BoujeeEnjinia1701/helpful-water/docs/03a-user-requirements.md

---
doc_id: HWP-URS-001
title: Helpful Water shared user requirements
project: Helpful Water
doc_type: User requirements
version: '0.1'
status: Draft
date: '2026-11-11'
author: Amish Chadha
license: CC-BY-4.0
revisions:
- version: '0.1'
  date: '2026-11-11'
  author: Amish Chadha
  change: First draft from the Helpful Water source pack (2026-11-11)
---

# Helpful Water shared user requirements

What the people who use or buy Helpful Water products need, written from their side and shared by all four solutions. Each solution's own user requirements (`solutions/*/docs/03a-user-requirements.md`) repeat the rows that apply to it with the same IDs, so its product requirements and traceability matrix trace to this list. Sources: the personas, persona-driven design questions and use cases in the concept validation questions (2026), the Helpful Water update (2026-02-26) and the Rev A component specification (2026-10-14). Method: STANDARDS section 22.

Table 1. Shared user requirements.

| ID | Category | Title | Need | Priority | Source | Solutions |
| --- | --- | --- | --- | --- | --- | --- |
| UR-001 | Performance | Bacteria | Reduce the bacteria in water from the source classes the solution is designed for | High | All personas; NGO buyers | A B C |
| UR-002 | Performance | Protozoa | Reduce protozoan cysts, including *Cryptosporidium* and *Giardia* | High | All personas; NGO buyers | A B C |
| UR-003 | Performance | Viruses addressed | Have a way to address viruses where viral disease is a risk, without implying the filter alone does it | High | NGO buyers; immunocompromised user | D (with A B C) |
| UR-004 | Usability | Usable flow | Get enough water at the suction, squeeze or effort a child or elderly user can give | High | Child; elderly user | A B C |
| UR-005 | Usability | Ready to use | Use it straight from the pack with no power, assembly or tools | High | Crisis recipient; field worker | A B C D |
| UR-006 | Usability | Simple instructions | Understand use, cleaning, limits and end of life from pictograms in three steps or fewer | High | Crisis recipient; low literacy users | A B C D |
| UR-007 | Maintenance | Low daily upkeep | Keep it working with under 2 minutes of upkeep a day and no tools | High | Crisis recipient; elderly user | A B C |
| UR-008 | Safety | Know when it fails | Know when the device is clogged, spent or damaged, so it never fails silently | High | All; field worker | A B C D |
| UR-009 | Safety | No bypass | Service it (clean, change a cartridge) without letting dirty water reach the clean side | High | Low dexterity user; field worker | A B C |
| UR-010 | Safety | Hygienic storage | Store it wet or dry in a hot climate without it growing germs | High | All | A B C |
| UR-011 | Safety | Safe materials | Nothing in it adds harmful substances to the water | High | All; NGO buyers | A B C D |
| UR-012 | Deployment and assembly | Portable | Carry it in a pocket or kit (under 25 cm long and 3 cm across for personal devices) | Medium | Traveller; field worker | A B |
| UR-013 | Performance | Household volume | Treat enough water for a household's drinking and cooking, including infant feeds | High | Household carer | C |
| UR-014 | Cost | Affordable | Cost per person per year, and per litre over the device life, that NGO buyers can justify against tablets and sealed filters | High | NGO buyers | A B C D |
| UR-015 | Logistics | Resupply | Get any consumable (carbon, chlorine) where the device is used, or have none | Medium | Field worker; NGO buyers | A B C D |
| UR-016 | Environment and durability | Shelf life and transit | Survive warehouse heat, transit and storage before first use | Medium | NGO buyers | A B C D |
| UR-017 | Environment and durability | Drops and freezing | Survive drops, and warn or resist where freezing can occur | Medium | Traveller; highland users | A B C |
| UR-018 | Usability | Taste | Accept the taste and smell, so people keep using it | Medium | Elderly user; tap-water users | A B C D |
| UR-019 | Maintenance | Cleanable prefilter | Rinse the coarse prefilter in the field | Medium | High-turbidity user | A B C |
| UR-020 | Safety | Shared use | Share the device in a household without passing infection mouth to mouth | Medium | Household carer | A B |
| UR-021 | Environment and durability | End of life | Dispose of spent parts without waste infrastructure | Low | NGO buyers; communities | A B C D |
| UR-022 | Deployment and assembly | Regional manufacture | Have parts made or assembled regionally | Low | NGO buyers; Helpful Engineering | A B C D |

Categories: deployment and assembly, performance, usability, safety, environment and durability, logistics, maintenance, cost, regulatory. Priorities: High, Medium, Low.

## Use cases

1. **Disaster or flood (short term).** Mesh reduces grit, the membrane reduces bacteria and protozoa, and backflush keeps it usable; viruses and dissolved chemicals from runoff are not addressed (SC6 excluded as a sole barrier).
2. **Rural household with an unimproved source.** Consistent bacteria and protozoa reduction without power; not the right product where arsenic, fluoride or salt is the main risk.
3. **Camp or displacement setting.** Water from distribution points is recontaminated in storage; point-of-use treatment reduces risk at the time of drinking.
4. **Distrusted or unpalatable treated water.** Carbon improves taste; the membrane adds a layer against recontamination.
5. **Field teams.** A portable backup when supplies are inconsistent.

Licence: this document is licensed under CC-BY-4.0 (Creative Commons Attribution 4.0 International), following the Helpful Engineering licensing guide. Design Molecule Labs with Helpful Engineering.
