BoujeeEnjinia1701/helpful-water/solutions/C-gravity/docs/03a-user-requirements.md

---
doc_id: HWC-URS-001
title: "Helpful Water C: household gravity filter user requirements"
project: "Helpful Water C: household gravity filter"
doc_type: User requirements
version: "0.1"
status: Draft
date: 2026-11-11
author: Amish Chadha
license: CC-BY-4.0
revisions:
  - version: "0.1"
    date: 2026-11-11
    author: Amish Chadha
    change: "First user requirements: the HWP-URS-001 rows that apply to solution C, same IDs, plus solution-specific UR-101 to UR-104"
---

# Helpful Water C: household gravity filter user requirements

What households need from solution C, written from their side. Rows UR-001 to UR-022 repeat the shared requirements of HWP-URS-001 that apply to C, with the same IDs and priorities; UR-012 (pocket size) and UR-020 (shared mouthpiece) do not apply to a household unit and are left out. UR-101 to UR-104 are specific to C and come from the users and stakeholders in HWC-PRB-001. These are a desk draft for review with households through a field partner (method: STANDARDS section 22).

Table 1. User requirements for solution C.

| ID | Category | Title | Need | Priority | Source |
| --- | --- | --- | --- | --- | --- |
| UR-001 | Performance | Bacteria | Reduce the bacteria in water from the source classes C is designed for (SC1, SC2, SC3 with settling, SC5) | High | All personas; NGO buyers (HWP-URS-001) |
| UR-002 | Performance | Protozoa | Reduce protozoan cysts, including *Cryptosporidium* and *Giardia* | High | All personas; NGO buyers (HWP-URS-001) |
| UR-003 | Performance | Viruses addressed | Have a way to address viruses where viral disease is a risk (chlorine from solution D in the raw bucket), without implying the filter alone does it | High | NGO buyers; immunocompromised user (HWP-URS-001) |
| UR-004 | Usability | Usable flow | Get the day's water without effort the child or elderly user cannot give: gravity does the work and drawing a cup is opening a tap | High | Child; elderly user (HWP-URS-001) |
| UR-005 | Usability | Ready to use | Use it with no power, no ripening period and no tools once the stand is set up | High | Crisis recipient; field worker (HWP-URS-001) |
| UR-006 | Usability | Simple instructions | Understand use, cleaning, limits and end of life from pictograms in three steps or fewer per task | High | Crisis recipient; low-literacy users (HWP-URS-001) |
| UR-007 | Maintenance | Low daily upkeep | Keep it working with under 2 minutes of upkeep a day and no tools | High | Crisis recipient; elderly user (HWP-URS-001) |
| UR-008 | Safety | Know when it fails | Know when the filter is clogged, spent or damaged, so it never fails silently | High | All; field worker (HWP-URS-001) |
| UR-009 | Safety | No bypass | Service it (backflush, clean the cloth, wash buckets) without letting dirty water reach the clean side | High | Low-dexterity user; field worker (HWP-URS-001) |
| UR-010 | Safety | Hygienic storage | Store the filter and the treated water in a hot climate without them growing germs | High | All (HWP-URS-001) |
| UR-011 | Safety | Safe materials | Nothing in it adds harmful substances to the water | High | All; NGO buyers (HWP-URS-001) |
| UR-013 | Performance | Household volume | Treat enough water for a household of five's drinking and cooking (45 L a day) in a few hours of filtering | High | Household carer (HWP-URS-001) |
| UR-014 | Cost | Affordable | Cost per person per year, and per litre over the device life, that NGO buyers can justify against tablets and sealed filters | High | NGO buyers (HWP-URS-001) |
| UR-015 | Logistics | Resupply | Get any consumable where the device is used, or have none | Medium | Field worker; NGO buyers (HWP-URS-001) |
| UR-016 | Environment and durability | Shelf life and transit | Survive warehouse heat, transit and storage before first use | Medium | NGO buyers (HWP-URS-001) |
| UR-017 | Environment and durability | Drops and freezing | Survive knocks, and warn or resist where freezing can occur | Medium | Highland users (HWP-URS-001) |
| UR-018 | Usability | Taste | Accept the taste and smell, so people keep using it | Medium | Elderly user; tap-water users (HWP-URS-001) |
| UR-019 | Maintenance | Cleanable prefilter | Rinse the coarse prefilter in the field | Medium | High-turbidity user (HWP-URS-001) |
| UR-021 | Environment and durability | End of life | Dispose of spent parts without waste infrastructure | Low | NGO buyers; communities (HWP-URS-001) |
| UR-022 | Deployment and assembly | Regional manufacture | Have parts made or assembled regionally | Low | NGO buyers; Helpful Engineering (HWP-URS-001) |
| UR-101 | Safety | Safe storage | Keep the treated water in a closed container with a tap, so hands and cups never go into it | High | Household carer; camp settings (HWC-PRB-001; HWP-SRC-001 SC5) |
| UR-102 | Performance | Turbid water | Use muddy river water (10 to 100 NTU) after a settling or prefilter step without the filter clogging in a day | Medium | High-turbidity user (HWC-PRB-001; HWP-SRC-001 SC3) |
| UR-103 | Usability | No lifting full containers | Fill and run the filter without lifting a full 20 L container | Medium | Household carer; elderly user (HWC-PRB-001) |
| UR-104 | Safety | Stable with children around | The filter does not tip over when full and pushed or pulled by a child | High | Household carer; child (HWC-PRB-001) |

Categories: deployment and assembly, performance, usability, safety, environment and durability, logistics, maintenance, cost, regulatory. Priorities: High, Medium, Low.

## Use cases for C

1. **Rural household, unimproved source (SC2, SC3).** Fill through the cloth, settle, filter into the clean bucket; dose with D first where viral disease is a risk.
2. **Camp or displacement (SC5).** Water from a distribution point is chlorinated again with D in the raw bucket, filtered and kept in the closed clean bucket with a residual.
3. **Clinic or school point (secondary).** One unit serves several households in batches; the closed clean bucket replaces a shared open pot.

Licence: this document is licensed under CC-BY-4.0 (Creative Commons Attribution 4.0 International), following the Helpful Engineering licensing guide. Design Molecule Labs with Helpful Engineering.
