BoujeeEnjinia1701/helpful-water/solutions/B-bottle-cartridge/docs/decisions/0001-concept-selection.md

---
doc_id: HWB-DDR-001
title: "Helpful Water B: concept selection"
project: "Helpful Water B: bottle cartridge"
doc_type: Decision record
version: "0.2"
status: Draft
date: 2026-11-11
author: Amish Chadha
license: CC-BY-4.0
revisions:
  - version: "0.1"
    date: 2026-11-11
    author: Amish Chadha
    change: "Concept selection argued; B1 and B2 within 10 %, both to Amish; Proposed, awaiting Amish"
  - version: "0.2"
    date: 2026-11-11
    author: Amish Chadha
    change: "Weak-child flow at the girls' grip boundary (160 mL/min) after the independent STEM review"
---

# Helpful Water B: concept selection

**Status: Decided by Amish on 2026-11-11 (recommendation adopted).** B1 (squeeze cartridge) scored 246 and B2 (gravity drip stand) 222 of 310 in HWB-OPT-001; B2 is 9.8 % below B1, inside the 10 % band of STANDARDS section 21, so both went to Amish. Amish chose B1 on 2026-11-11: it has the higher score and is already carried to the drawings, BOM and build plan; B2's stand is a possible later accessory. B3 (press cup, 209) is not carried.

## Context

The brief for solution B asked for at least two genuinely different working principles: squeeze through a hollow-fibre cartridge, gravity drip from an inverted bottle, and a third principle the STEM check supports. All three passed the STEM check after four detail fixes (HWB-DEC-001 F1 to F4).

## Options

1. **B1 alone.** Cheapest (USD 18.35 of prototype parts), pocketable, one-squeeze air test; squeeze effort for children and elderly users is the weak point (160 mL/min at a weak child's 5.8 kPa, clean; half that fouled).
2. **B2 alone.** No effort, fills cups for a household, longest carbon contact; slower (about 6 minutes a litre), a tall stand to knock over, more parts, not portable.
3. **B1 with B2's stand as an accessory.** The same cartridge serves both: squeezed when carried, hung in a stand at home. The stand adds cost (estimate USD 8 to 10 of parts) and, with the standard module, gives about 10 minutes per litre clean.

## Consequences

The TRL 3 drawings, BOM and build plan describe B1, since B2's cartridge is the same stack turned over. If Amish picks B2, its longer module, vent tube, stand drawings, BOM lines and build steps are the next work; its model already exists at D3.

## Decision

B1, decided by Amish on 2026-11-11 (HWB-DEC-001 D1).

Licence: this document is licensed under CC-BY-4.0 (Creative Commons Attribution 4.0 International), following the Helpful Engineering licensing guide. Design Molecule Labs with Helpful Engineering.
