BoujeeEnjinia1701/helpful-water/docs/11-plan.md

---
doc_id: HWP-PLN-001
title: Helpful Water program plan
project: Helpful Water
doc_type: Project plan
version: '0.1'
status: Draft
date: '2026-11-11'
author: Amish Chadha
license: CC-BY-4.0
revisions:
- version: '0.1'
  date: '2026-11-11'
  author: Amish Chadha
  change: First draft from the Helpful Water source pack (2026-11-11)
---

# Helpful Water program plan

Purpose: deliver clean, reliable and simple access to water for people without safe drinking water (Helpful Water update, 2026-02-26), through four open point-of-use solutions taken to a constructable design on paper (TRL 3, stage P3, the portfolio cap). The next gate, P4 (functional prototypes and accredited laboratory testing), stays closed until Amish opens it with Helpful Engineering. Amish settled the concept choice and every open decision in each solution's register on 2026-11-11.

## Workstreams

Table 1. Workstreams.

| Workstream | Owner (role) | Deliverable | Status |
| --- | --- | --- | --- |
| Program problem, sources, personas, claims | Program lead | HWP-PRB-001, HWP-SRC-001, HWP-URS-001, HWP-CLM-001 | Drafted |
| Regulatory, market, patents | Regulatory specialist; program lead | HWP-REG-001, HWP-MKT-001, HWP-FTO-001 | Drafted; legal opinion to assess |
| Solution A straw | Mechanical and membrane engineers | `solutions/A-straw` to TRL 3 | In progress |
| Solution B bottle cartridge | Mechanical and membrane engineers | `solutions/B-bottle-cartridge` to TRL 3 | In progress |
| Solution C household gravity | Mechanical and WASH engineers | `solutions/C-gravity` to TRL 3 | In progress |
| Solution D virus add-on | Water chemist | `solutions/D-virus-add-on` to TRL 3 | In progress |
| Verification planning | Microbiologist and test lab | HWP-VER-001 | Planned (TRL 4 work on paper only) |
| Partners and co-design | Amish with Helpful Engineering | Field partner, laboratory partner | Not started |

## Kill criteria

From the Helpful Water update (2026-02-26), applied to each solution: stop or pause if consistent bacteria and protozoa reduction cannot be shown under realistic conditions; if flow becomes unusable or is not recoverable by backflush; if seal or membrane integrity cannot be kept in field handling; if total cost or complexity is not viable at humanitarian scale; or if partners decline because of safety, liability or usability concerns.

## Targets and key performance indicators

Table 2. Service-level targets (proposed in the viability shortlist for the copper straw and the bottle cartridge, carried here as program targets; adopted by Amish on 2026-11-11).

| Category | Target | Basis |
| --- | --- | --- |
| Functional prototype | 6 weeks from P4 opening | Viability shortlist |
| Bacteria and protozoa reduction | At least 99.9 % (3 log) as a first gate; the Rev A prototype goal is 6 log bacteria and 3 log cysts | Viability shortlist; Rev A specification section 7 |
| Flow | 300 to 500 mL/min under average suction (shortlist); at least 200 mL/min at 10 kPa or less (Rev A) | Two sources; reconciled per solution in PRS |
| Durability | At least 90 days of daily use | Viability shortlist |
| Unit cost at mass production | USD 1 (straw, shortlist), under USD 8 (bottle cartridge, shortlist) | Value-engineering targets, not limits |
| Mass and packing | Straw 100 g or less | Viability shortlist |
| User testing | 80 % positive among pilot participants; 90 % follow the cleaning sequence unassisted | Shortlist; Rev A |
| Leaching | Copper below 1.3 mg/L where any copper is present (copper is not in the design) | Shortlist |

Table 3. Key performance indicators.

| Category | KPI | Measurement |
| --- | --- | --- |
| Efficacy | Reduction of E. coli and *Giardia* or *Cryptosporidium* surrogates | Log reduction, pre against post |
| Flow | Mean flow against target | mL/min at stated pressure |
| Durability | Volume before 50 % flow loss; backflush recovery | Litres; percent |
| Adoption | Correct use and sustained use at 3, 6, 12 months | Survey and observation percent |
| Taste | Taste complaints | Percent of users |
| Cost | Cost per litre over life; cost per person per year | USD |
| Logistics | Units per cubic metre shipped | Count |
| Sustainability | Recyclable or biodegradable share | Percent of mass |
| Health impact (for funders) | Diarrhoeal incidence attributable to the device, designed into deployment | Partner study |

## Minimum viable team

Table 4. Roles (Rev A component specification and viability shortlist; specialists may be part time).

| Role | Accountability |
| --- | --- |
| Program manager and two project managers | Roadmap, traceability, gate decisions, budget |
| Membrane and water filtration engineer | Membrane selection, flux and pressure model, fouling and backflush |
| Mechanical and design-for-manufacture engineer | CAD, potting and manifold interfaces, seal glands, tolerances, assembly |
| Water microbiologist and accredited test laboratory | Challenge protocol, log reduction, independent report |
| WASH and environmental water specialist | Source classes, risk screens, field fit and exclusions |
| Water chemist | Chlorine dosing and carbon adsorption (D and carbon stages) |
| Materials and regulatory quality specialist | Contact materials, claims, standards and evidence |
| Industrial designer and human-factors lead | Mouthpiece and grip ergonomics, pictograms, maintenance usability |
| NGO liaison and field tester | Field validation and feedback |

## Support needed from Helpful Engineering

- Design: CAD engineers to validate specifications, dimensions and feasibility (now through this repository).
- Testing and research: lab protocols and partners for microbial testing and turbidity and flow benchmarking.
- External partners to explore: university water microbiology laboratories, fabrication partners for potting, housings and sealing, and humanitarian and public health partners for field usability.

## Resources needed

Table 5. Resources (P4 onwards; on hold).

| Resource | Deliverable | Effort | Estimated cost (USD) |
| --- | --- | --- | --- |
| Prototype parts | Functional prototypes of the chosen options | From each solution's BOM | From each BOM |
| Accredited pathogen testing and certification | Third-party challenge reports, NSF scoping | Months | 50,000 to 150,000 (team estimate in the concept validation questions) |
| Freedom-to-operate opinion | Country-specific patent opinion | Weeks | To assess |
| Human-factors trials | Persona trials with known potable water | Weeks | To assess |

## Stage gates

Table 6. Stages (P4 to P6 on hold while the stage cap is P3).

| Stage | Gate criteria | Status |
| --- | --- | --- |
| P0 Idea | Problem, STEM check, concept options, regulatory, feasibility, plan | Program documents done; solutions in progress |
| P1 Concept | User and product requirements, risk, market, patent screen | In progress |
| P2 Design | Calculations, traceability | In progress |
| P3 Detailed design | Constructable model, drawings, build plan, decisions register, design FMEA | Target for every solution |
| P4 Prototype and lab test | Prototypes, accredited testing (HWP-VER-001) | On hold (stage cap) |
| P5 Field trial | Partner pilots with independent evaluation | On hold |
| P6 Release | Released documents and certification | On hold |

## 60 to 90 day plan once P4 opens (Rev A specification section 10)

Table 7. Gated plan.

| Window | Outputs and decision |
| --- | --- |
| Days 0 to 15 | Confirm target sources, requirements and claims; membrane supplier shortlist; freedom-to-operate review |
| Days 16 to 35 | Prototype A and B options with qualified membrane modules; hydraulic mapping and leak tests with non-consumable test water |
| Days 36 to 60 | Optimise mesh, fibre and carbon; backflush and integrity under abuse; begin accredited pathogen testing; human-factors trials with known potable water only |
| Days 61 to 90 | Review laboratory results and costs; updated BOM, maintenance procedure and risk register; go, pivot or stop recommendation to sponsors |

## References

- Helpful Water update, 2026-02-26 (Helpful Engineering, internal slides).
- Portable Freshwater Filter Straw: Component Specifications, Rev A, 2026-10-14 (Helpful Engineering, internal).
- Concept Validation Questions, 2026, with review by Ali Raza (Helpful Engineering, internal).
- Project Viability Shortlist Analysis (Helpful Engineering Infectious Disease Challenge, internal).
- Helpful Water open questions (internal).
- Further sources: HWP-PRB-001, HWP-REG-001, HWP-MKT-001, HWP-CLM-001 and HWP-FTO-001.

Licence: this document is licensed under CC-BY-4.0 (Creative Commons Attribution 4.0 International), following the Helpful Engineering licensing guide. Design Molecule Labs with Helpful Engineering.
