BoujeeEnjinia1701/helpful-water/docs/10-market.md

---
doc_id: HWP-MKT-001
title: Helpful Water market and viability
project: Helpful Water
doc_type: Market and viability
version: '0.1'
status: Draft
date: '2026-11-11'
author: Amish Chadha
license: CC-BY-4.0
revisions:
- version: '0.1'
  date: '2026-11-11'
  author: Amish Chadha
  change: First draft from the Helpful Water source pack (2026-11-11)
---

# Helpful Water market and viability

The first buyers are NGOs and humanitarian logistics networks, with consumer and emergency-kit sales as a possible second channel that funds humanitarian distribution, as LifeStraw did (concept validation questions, 2026). Procurement compares products on cost per litre over the device life and on independent test evidence, so both are designed in from the start. Prices were checked 2026-11-11.

Table 1. Benchmarks.

| Product | Principle | Price (as listed) | Rated life | Viruses | Source |
| --- | --- | --- | --- | --- | --- |
| LifeStraw Personal | 0.2 um hollow-fibre straw | 34.95 (MEC, Canada; currency shown as "$") | 4,000 L | Not removed | [MEC](https://www.mec.ca/en/product/6018-750/Personal-Water-Filter-Straw) |
| Sawyer Mini | 0.1 um hollow fibre, squeeze or inline | USD 29 | 100,000 US gal claimed | Not treated | [OutdoorGearLab](https://www.outdoorgearlab.com/reviews/camping-and-hiking/backpacking-water-filter/sawyer-mini) |
| NaDCC tablets | Chlorine disinfection, 30 min contact | About USD 0.02 a litre (about USD 3 a year per household) | Consumable | Treated | [Akvopedia](https://akvopedia.org/wiki/Chlorine_(NaDCC)) |

Table 2. Segments.

| Segment | Target users and region | Competitive benchmark | Estimated cost per unit | Value proposition |
| --- | --- | --- | --- | --- |
| Emergency response kits | Disaster and displacement response, WASH cluster partners | LifeStraw Personal, Sawyer Mini | From each solution's BOM (A, B) | Backflush and field-cleanable prefilter for turbid water; pictogram instructions; open design for regional manufacture |
| Household point of use | Rural households with unimproved sources | Ceramic pot filters, tablets, household gravity filters | From C's BOM | Serves drinking, cooking and infant water; pairs with D for viruses |
| Schools and clinics | Shared drinking points | Gravity dispensers | From C and B | Shared use without a shared mouthpiece |
| Travellers and outdoor users (funding channel) | Outdoor retail | LifeStraw, Sawyer, Grayl | From A and B | Cross-subsidy for humanitarian units |

## Viability metrics

- Cost per litre over the device life, including every consumable (carbon, chlorine) and its resupply.
- Cost per person per year (the shortlist target for the bottle cartridge was under USD 10 per user per year).
- Correct and sustained use at 3, 6 and 12 months, with an acceptance threshold set with the partner (the Kenya figures of 24 % non-use and 56 % correct use at 12 months are the warning).

## Open route

Open drawings under CERN-OHL-P-2.0 let regional moulders and assemblers make the housings; qualified membrane modules and carbon are bought from suppliers with data sheets and lot traceability. Helpful Engineering's volunteer network and WASH partners carry the designs to pilots once accredited tests are done.

Licence: this document is licensed under CC-BY-4.0 (Creative Commons Attribution 4.0 International), following the Helpful Engineering licensing guide. Design Molecule Labs with Helpful Engineering.
