BoujeeEnjinia1701/helpful-water/solutions/A-straw/docs/03b-traceability.md

---
doc_id: HWA-RTM-001
title: 'Helpful Water A: filter straw traceability matrix'
project: 'Helpful Water A: filter straw'
doc_type: Traceability matrix
version: '0.4'
status: Draft
date: '2026-11-11'
author: Amish Chadha
license: CC-BY-4.0
source_hash: 458b51d6e60a272a
revisions:
- version: '0.1'
  date: '2026-11-11'
  author: Amish Chadha
  change: Generated by .kit/trace.py
- version: '0.2'
  date: '2026-11-11'
  author: Amish Chadha
  change: Generated by .kit/trace.py
- version: '0.3'
  date: '2026-11-11'
  author: Amish Chadha
  change: Generated by .kit/trace.py
- version: '0.4'
  date: '2026-11-11'
  author: Amish Chadha
  change: Generated by .kit/trace.py
---

# Helpful Water A: filter straw traceability matrix

Generated by `python .kit/trace.py` from the user requirements, product requirements, calculations, build plan and BOM. Do not edit by hand. 23 user requirements, 29 product requirements, 0 gaps.

Table 1. User requirement to product requirement to evidence to verification.

| User requirement | Product requirement | Title | Evidence | Verification | Status |
| --- | --- | --- | --- | --- | --- |
| UR-001 | PR-001 | Bacteria reduction | HWA-CAL-001, HWA-STM-001 | Test, HWP-VER-001 TA and TB, TRL 4 | To verify at TRL 4 |
| UR-004 | PR-002 | Flow at 10 kPa | HWA-CAL-001, HWA-BLD-001, HWA-STM-001 | Analysis HWA-CAL-001 section 4, TRL 3; test TC, TRL 4 | Met on paper with the 0.2 um grade (179); not met with the 0.1 um grade (110), which is used only under HWA-DEC-001 D2 |
| UR-004 | PR-003 | Flow for a child | HWA-CAL-001, HWA-BLD-001 | Analysis HWA-CAL-001 section 4; test TC and TH with known potable test water, TRL 4 | Not met on paper (45 to 74) |
| UR-004 | PR-004 | Membrane permeability | HWA-CAL-001, HWA-STM-001 | Inspection of the supplier certificate, TA, TRL 4 | Met by design (specification) |
| UR-004 | PR-005 | Membrane area | HWA-CAL-001 | Analysis HWA-CAL-001 section 2 (0.056) | Met on paper |
| UR-002 | PR-006 | Cyst reduction | HWA-CAL-001, HWA-STM-001 | Test TB, TRL 4 | To verify at TRL 4 |
| UR-001, UR-002, UR-009 | PR-007 | No bypass | HWA-CAL-001, HWA-BLD-001, HWA-STM-001 | Inspection of the model; test TF, TRL 4 | Met by design |
| UR-003 | PR-008 | Virus warning | HWA-CAL-001, HWA-STM-001 | Inspection, TRL 4 | Met by design |
| UR-005 | PR-009 | Ready to use | HWA-CAL-001 | Demonstration TH, TRL 4 | To verify at TRL 4 |
| UR-006 | PR-010 | Pictograms | HWA-CAL-001 | Test TH (comprehension), TRL 4 | To verify at TRL 4 |
| UR-007 | PR-011 | Daily upkeep | HWA-CAL-001 | Analysis HWA-CAL-001 section 7 (about 1 min); test TH | Met on paper |
| UR-008 | PR-012 | Integrity check | HWA-CAL-001, HWA-BLD-001, HWA-STM-001 | Analysis HWA-CAL-001 section 7; test TA and TF, TRL 4 | At risk (supplier reverse-pressure rating to confirm) |
| UR-019 | PR-013 | Rinseable mesh | HWA-CAL-001, HWA-STM-001 | Inspection of the model; test TE | Met by design |
| UR-101, UR-009 | PR-014 | Backflush route | HWA-CAL-001, HWA-BLD-001 | Analysis HWA-STM-001 S18; test TE (no downstream contamination) | Met by design |
| UR-018, UR-015 | PR-015 | Carbon bed | HWA-CAL-001, HWA-STM-001 | Analysis HWA-CAL-001 section 5; test TG | Met on paper |
| UR-017 | PR-016 | Freezing and drops | HWA-CAL-001, HWA-STM-001 | Test TF, TRL 4 | To verify at TRL 4 |
| UR-010 | PR-017 | Drain and dry | HWA-CAL-001 | Inspection of the model; test TG | At risk (regrowth to measure) |
| UR-011 | PR-018 | Wetted materials | HWA-CAL-001 | Inspection of certificates; test TG | To verify at TRL 4 (printed prototype parts are not listed) |
| UR-012 | PR-019 | Kit compatible | HWA-CAL-001, HWA-BLD-001 | Analysis HWA-CAL-001 section 9 (205 x 29.6) | Met on paper |
| UR-014 | PR-020 | Cost per litre | HWA-CAL-001 | Analysis HWA-CAL-001 section 10 (0.011 prototype, about 0.002 at scale) | Met on paper |
| UR-014 | PR-021 | Prototype parts | HWA-CAL-001 | Analysis, BOM | Met on paper (USD 17.46) |
| UR-016 | PR-022 | Shelf life | HWA-CAL-001 | Test TF (ageing), TRL 4 | To verify at TRL 4 |
| UR-020 | PR-023 | Mouthpiece hygiene | HWA-CAL-001 | Inspection | At risk (D6 open) |
| UR-021 | PR-024 | End of life | HWA-CAL-001 | Inspection of the BOM | Met by design |
| UR-022 | PR-025 | Regional manufacture | HWA-CAL-001 | Inspection, HWA-BLD-001 | Met by design |
| UR-101 | PR-026 | Backflush recovery | HWA-CAL-001 | Test TE, TRL 4 | To verify at TRL 4 |
| UR-102 | PR-027 | Mass | HWA-CAL-001, HWA-BLD-001, HWA-STM-001 | Analysis HWA-CAL-001 section 9 (66 g dry) | Met on paper |
| UR-008, UR-009 | PR-028 | Dip line | HWA-CAL-001, HWA-BLD-001, HWA-STM-001 | Inspection of the model | Met by design |
| UR-018 | PR-029 | Chlorine taste | HWA-CAL-001 | Test TG, TRL 4 | To verify at TRL 4 |

## Gaps

None.

Licence: this document is licensed under CC-BY-4.0 (Creative Commons Attribution 4.0 International), following the Helpful Engineering licensing guide. Design Molecule Labs with Helpful Engineering.
