BoujeeEnjinia1701/helpful-water/solutions/A-straw/docs/11-plan.md

---
doc_id: HWA-PLN-001
title: "Helpful Water A: filter straw project plan"
project: "Helpful Water A: filter straw"
doc_type: Project plan
version: "0.3"
status: Draft
date: 2026-11-11
author: Amish Chadha
license: CC-BY-4.0
revisions:
  - version: "0.1"
    date: 2026-11-11
    author: Amish Chadha
    change: Solution plan at P3 citing HWP-PLN-001, with the kill criteria and the parts of the program plan that apply
  - version: "0.2"
    date: 2026-11-11
    author: Amish Chadha
    change: Independent STEM review marked done; D10 to D12 added
  - version: "0.3"
    date: 2026-11-11
    author: Amish Chadha
    change: Decisions recorded as Amish's (all pending decisions settled on their recommendations, 2026-11-11)

---

# Helpful Water A: filter straw project plan

Solution A is at stage P3 and TRL 3 on paper: a constructable design with a build plan. The next gate, P4 (prototype and accredited laboratory testing), stays closed until Amish opens it with Helpful Engineering (HWP-PLN-001). Amish decided the concept (D1), the membrane grade rule (D2), the flow target (D3) and D4 to D12 on 2026-11-11 (HWA-DEC-001); no decision is open. Method: STANDARDS sections 19, 23 and 25.7.

## Purpose

Reduce exposure to waterborne bacteria and protozoa for one person drinking from clear freshwater, stored water or distrusted tap water, without power, at a humanitarian cost per litre (HWP-PLN-001 purpose, applied to a straw).

## Kill criteria

From the Helpful Water update (2026-02-26), carried from HWP-PLN-001 and applied to the straw. Pause or stop solution A if:

1. it cannot show consistent bacteria and protozoa reduction under realistic conditions (PR-001, PR-006);
2. flow becomes unusable or is not recovered by backflush (PR-002, PR-003, PR-026), including if no membrane grade gives both the log reductions and at least the PR-003 child flow;
3. seal or membrane integrity cannot be kept in field handling (PR-007, PR-012, PR-016);
4. total cost or complexity is not viable at humanitarian scale (PR-020);
5. partners decline because of safety, liability or usability concerns.

## Targets and key performance indicators

The program targets of HWP-PLN-001 Table 2 apply. For the straw: flow 200 mL/min at 10 kPa (Rev A, PR-002) with 300 to 500 mL/min under average suction from the shortlist recorded as not reachable (HWA-CAL-001 section 4); 3 log bacteria and protozoa as the first gate and the Rev A goal of 6 log bacteria and 3 log cysts (PR-001, PR-006); at least 90 days of daily use; unit cost USD 1 at mass production from the shortlist against USD 1 to 5 in this design's value engineering; 100 g or less (66 g); 90 % of testers follow the cleaning sequence unassisted. KPIs as HWP-PLN-001 Table 3.

## Workstreams

Table 1. Workstreams.

| Workstream | Owner (role) | Deliverable | Status |
| --- | --- | --- | --- |
| Design to TRL 3 | Mechanical and design-for-manufacture engineer | This folder | Done on paper |
| Module sourcing | Membrane and water filtration engineer | RFQ to straw-core makers for the BOM 5 drawing (C1 to C3) | Not started (P4) |
| Freedom to operate | Program lead with a pro bono attorney | Opinion on US 8,852,439 B2 (C4) | Not started |
| Verification planning | Microbiologist and test laboratory | TA to TI for solution A (HWP-VER-001) | Planned on paper |
| Human factors | Industrial designer and human-factors lead | Pictograms; persona flow trials with known potable test water | Planned (P4) |
| Field fit | WASH specialist and NGO liaison | Source classes and carbon resupply answer (D7) | Not started |

## Minimum viable team

As HWP-PLN-001 Table 4; for the straw the membrane engineer, the mechanical engineer, the microbiologist with an accredited laboratory, the materials and regulatory specialist and the human-factors lead are the core; the water chemist is part time for the carbon stage.

## Resources needed

Table 2. Resources (P4 onwards; on hold).

| Resource | Deliverable | Effort | Estimated cost (USD) |
| --- | --- | --- | --- |
| Prototype parts | Ten straws, five of each membrane grade (D2) | 2 weeks of printing and fitting | About 175 (10 x 17.46) plus syringes and spares |
| Hand vacuum pump with gauge, scale, calipers | First checks (HWA-BLD-001 section 5) | | To assess |
| Accredited pathogen and materials testing | TA, TB, TG reports | Months | Share of the program's 50,000 to 150,000 |
| Freedom-to-operate opinion | C4 | Weeks | To assess |

## Stage gates

Table 3. Stages (P4 to P6 on hold while the stage cap is P3).

| Stage | Gate criteria | Status |
| --- | --- | --- |
| P0 Proposal | PRB, STM, OPT, REG, FEA, PLN | Done |
| P1 Definition | URS, PRS, RSK, MKT | Done |
| P2 Design inputs | CAL, RTM, concept selection DDR | Done; concept chosen by Amish on 2026-11-11 |
| P3 Design outputs | Model at D3, STEP, drawings, priced BOM, BLD, DEC, design FMEA | Done on paper (renders in Blender pending) |
| P4 Verification | Prototypes, TA to TI | On hold (stage cap) |
| P5 Validation | Partner pilots with independent evaluation | On hold |
| P6 Commercialization | Released documents, certification, named partner | On hold |

## 60 to 90 day plan once P4 opens

As HWP-PLN-001 Table 7. For the straw: days 0 to 15, Amish's decisions D1 to D3, RFQ and attorney; days 16 to 35, ten prototypes and the first checks with known potable test water; days 36 to 60, fouling and backflush (TE), integrity after drops and freezing (TF), air-hold check validation, accredited pathogen tests begin (TB); days 61 to 90, results, BOM and go, pivot or stop against the kill criteria.

## Support needed from Helpful Engineering

A membrane engineer to review HWA-CAL-001 and the module drawing; introductions to straw-core makers and to a water microbiology laboratory; a field partner to answer the carbon resupply question.

## Next steps and decisions

1. Decided by Amish on 2026-11-11: D1 A1, D2 both grades prototyped and selected on laboratory results, D3 PR-002 at 150 mL/min (HWA-DEC-001).
2. Blender renders: done (options picture and product renders in `media/`).
3. Independent STEM review by a second agent: done 2026-11-11 (HWA-STM-001); D10 to D12 decided by Amish on 2026-11-11 (HWA-DEC-001).
4. P4 stays closed until Amish opens it.

## References

- Helpful Engineering. Portable Freshwater Filter Straw: Component Specifications, Rev A, 2026-10-14 (internal).
- Helpful Engineering. Concept Validation Questions, 2026, with review by Ali Raza (internal).
- Helpful Engineering. Helpful Water update, 2026-02-26 (internal slides).
- Helpful Engineering Infectious Disease Challenge. Project Viability Shortlist Analysis (internal).
- Program documents: HWP-PRB-001, HWP-SRC-001, HWP-URS-001, HWP-CLM-001, HWP-REG-001, HWP-MKT-001, HWP-PLN-001, HWP-VER-001, HWP-FTO-001.
- Meissner. "SepraPor hollow fiber membranes." https://www.meissner.com/wp-content/uploads/Seprapor_green_doc_2026.pdf (checked 2026-11-11).
- Prepol. "O-ring sizes AS 568." https://www.prepol.com/documents/o-ring-sizes-as-568 (checked 2026-11-11).
- Envirosupply. "12 x 40 coconut shell activated carbon specification sheet." https://cdn.shopify.com/s/files/1/0018/8193/1811/files/12x40CoconutShell_SpecSheet.pdf (checked 2026-11-11).
- Wertsén, M., and M. Stenberg. "Measuring Lip Force by Oral Screens. Part 2." *Clinical and Experimental Dental Research* 3, no. 5 (2017): 191 to 197. https://research.chalmers.se/publication/253532/file/253532_Fulltext.pdf (checked 2026-11-11).
- Akvopedia. "Ceramic pot filter." https://akvopedia.org/wiki/Ceramic_filter (checked 2026-11-11).
- Akvopedia. "Chlorine (NaDCC)." https://akvopedia.org/wiki/Chlorine_(NaDCC) (checked 2026-11-11).
- Sudha, V. B. P., et al. "Storing Drinking-Water in Copper Pots Kills Contaminating Diarrhoeagenic Bacteria." *Journal of Health, Population and Nutrition* 30, no. 1 (2012). https://pubmed.ncbi.nlm.nih.gov/22524115/ (checked 2026-11-11).
- Grass, G., C. Rensing, and M. Solioz. "Metallic Copper as an Antimicrobial Surface." *Applied and Environmental Microbiology* 77, no. 5 (2011). https://pmc.ncbi.nlm.nih.gov/articles/PMC3067274 (checked 2026-11-11).
- Google Patents. "US8852439B2." https://patents.google.com/patent/US8852439B2/en (checked 2026-11-11).
- SimPure. "WS02 water filter straw replacement filter." https://www.simpurelife.com/products/ws02-water-filter-straw-replacement-filter (checked 2026-11-11).
- MEC. "LifeStraw Personal Water Filter Straw." https://www.mec.ca/en/product/6018-750/Personal-Water-Filter-Straw (checked 2026-11-11, via HWP-MKT-001).
- OutdoorGearLab. "Sawyer Mini review." https://www.outdoorgearlab.com/reviews/camping-and-hiking/backpacking-water-filter/sawyer-mini (checked 2026-11-11, via HWP-MKT-001).
- Membrane Solutions S2 straw listing. https://www.desertcart.uy/products/246879908-membrane-solutions-water-filter-straw-s2-nsf-ansi-42-372.md (checked 2026-11-11).

Licence: this document is licensed under CC-BY-4.0 (Creative Commons Attribution 4.0 International), following the Helpful Engineering licensing guide. Design Molecule Labs with Helpful Engineering.
