BoujeeEnjinia1701/helpful-water/solutions/B-bottle-cartridge/docs/03b-traceability.md

---
doc_id: HWB-RTM-001
title: 'Helpful Water B: bottle cartridge traceability matrix'
project: 'Helpful Water B: bottle cartridge'
doc_type: Traceability matrix
version: '0.4'
status: Draft
date: '2026-11-11'
author: Amish Chadha
license: CC-BY-4.0
source_hash: 55baca31b1cae191
revisions:
- version: '0.1'
  date: '2026-11-11'
  author: Amish Chadha
  change: Generated by .kit/trace.py
- version: '0.2'
  date: '2026-11-11'
  author: Amish Chadha
  change: Generated by .kit/trace.py
- version: '0.3'
  date: '2026-11-11'
  author: Amish Chadha
  change: Generated by .kit/trace.py
- version: '0.4'
  date: '2026-11-11'
  author: Amish Chadha
  change: Generated by .kit/trace.py
---

# Helpful Water B: bottle cartridge traceability matrix

Generated by `python .kit/trace.py` from the user requirements, product requirements, calculations, build plan and BOM. Do not edit by hand. 24 user requirements, 29 product requirements, 0 gaps.

Table 1. User requirement to product requirement to evidence to verification.

| User requirement | Product requirement | Title | Evidence | Verification | Status |
| --- | --- | --- | --- | --- | --- |
| UR-001 | PR-001 | Bacteria reduction | HWB-CAL-001, HWB-BLD-001 | Supplier certificate (TA) and accredited challenge at beginning and end of life (TB), TRL 4 | To verify at TRL 4 |
| UR-002 | PR-002 | Protozoa reduction | HWB-CAL-001, HWB-BLD-001 | Accredited challenge (TB), TRL 4 | To verify at TRL 4 |
| UR-003 | PR-003 | No-virus warning | HWB-CAL-001, HWB-BLD-001, HWB-STM-001 | Inspection of the artwork, TRL 3; comprehension trial (TH), TRL 4 | Met by design |
| UR-004 | PR-004 | Adult flow | HWB-CAL-001, HWB-BLD-001, HWB-STM-001 | Analysis (HWB-CAL-001 section 3), TRL 3; pressure-flow map (TC), TRL 4 | Met on paper (465 at 20 C, assumed permeability; 360 at 10 C, D9) |
| UR-004 | PR-005 | Child and elderly flow | HWB-CAL-001, HWB-BLD-001, HWB-STM-001 | Analysis (HWB-CAL-001 section 3), TRL 3; persona trials (TH) and TC, TRL 4 | At risk (160 and 198 clean; 82 and 102 fouled) |
| UR-004 | PR-006 | Flow at 10 kPa | HWB-CAL-001, HWB-BLD-001 | Analysis (HWB-CAL-001), TRL 3; TC, TRL 4 | At risk (274 clean, 141 fouled) |
| UR-005 | PR-007 | Ready to use | HWB-CAL-001, HWB-BLD-001 | Demonstration (TH), TRL 4 | To verify at TRL 4 |
| UR-006 | PR-008 | Pictogram instructions | HWB-CAL-001, HWB-BLD-001 | Inspection, TRL 3; comprehension trial (TH), TRL 4 | To verify at TRL 4 |
| UR-007 | PR-009 | Daily upkeep | HWB-CAL-001, HWB-BLD-001 | Analysis of the procedure (HWB-BLD-001 section 5), TRL 3; TH, TRL 4 | Met on paper |
| UR-008 | PR-010 | Field integrity check | HWB-CAL-001, HWB-BLD-001 | Analysis (HWB-CAL-001 section 5), TRL 3; defect-seeded test (TF, TI), TRL 4 | Met on paper (17 um at 17 kPa); not a proof of performance |
| UR-009 | PR-011 | One dirty-to-clean seal | HWB-CAL-001, HWB-BLD-001 | Inspection of the model (HWB-DWG-002), TRL 3; bypass tests (TF), TRL 4 | Met by design |
| UR-010 | PR-012 | Small clean-side hold-up | HWB-CAL-001, HWB-BLD-001, HWB-STM-001 | Analysis (HWB-CAL-001), TRL 3; storage regrowth (TE, TG), TRL 4 | Met on paper (5.7 mL downstream of the potting; the 15.2 mL in the lumens stays wet, so a 50 mL first flush follows storage, HWB-DEC-001 F6); regrowth and grow-through to verify |
| UR-011 | PR-013 | Wetted materials | HWB-CAL-001, HWB-BLD-001 | Supplier certificates, TRL 4; extractables (TG), TRL 4 | To verify at TRL 4 |
| UR-012 | PR-014 | Size | HWB-CAL-001, HWB-BLD-001 | Inspection of the model, TRL 3 | Met (217 mm long, 46 mm across) |
| UR-014 | PR-015 | Cost | HWB-CAL-001, HWB-BLD-001 | Analysis (HWB-CAL-001 section 7, BOM), TRL 3 | Over target (USD 10.8 at 9 months; prototype USD 18.35, scale USD 7.05) |
| UR-015 | PR-016 | Refillable carbon | HWB-CAL-001, HWB-BLD-001, HWB-STM-001 | Inspection, TRL 3; refill trial (TH), TRL 4 | Met by design |
| UR-016 | PR-017 | Shelf life | HWB-CAL-001, HWB-BLD-001 | Ageing test (TF), TRL 4; module maker's shelf-life data | To verify at TRL 4 |
| UR-017 | PR-018 | Drops and freezing | HWB-CAL-001, HWB-BLD-001 | Drop test and air check (TF), TRL 4; warning by inspection | To verify at TRL 4 |
| UR-018 | PR-019 | Taste contact time | HWB-CAL-001, HWB-BLD-001 | Analysis (HWB-CAL-001 section 4), TRL 3; NSF/ANSI 42 style test (TG), TRL 4 | Met on paper (1.8 s); taste to verify |
| UR-019 | PR-020 | Rinseable mesh | HWB-CAL-001, HWB-BLD-001 | Inspection, TRL 3 | Met by design |
| UR-020 | PR-021 | Cup filling | HWB-BLD-001 | Inspection, TRL 3; TH, TRL 4 | Met by design |
| UR-021 | PR-022 | End of life | HWB-BLD-001 | Inspection of the BOM, TRL 3 | Met by design |
| UR-022 | PR-023 | Regional make | HWB-CAL-001, HWB-BLD-001 | Inspection (HWB-BLD-001), TRL 3 | Met by design |
| UR-101 | PR-024 | Neck fit | HWB-CAL-001, HWB-BLD-001 | Analysis (HWB-CAL-001 section 2), TRL 3; fit test (TF), TRL 4 | Met on paper (1881 and 1810); 38 mm adapter to draw |
| UR-102 | PR-025 | No-squeeze mode | HWB-CAL-001, HWB-BLD-001 | Analysis (HWB-CAL-001 section 3), TRL 3; TH, TRL 4 | Met on paper (198 clean); gravity mode depends on D1 |
| UR-103 | PR-026 | Membrane life | HWB-CAL-001, HWB-BLD-001 | Fouling and backflush (TE), TRL 4 | To verify at TRL 4 |
| UR-004 | PR-027 | Air return | HWB-CAL-001, HWB-BLD-001 | Analysis (HWB-STM-001 S19), TRL 3; TH and TF, TRL 4 | To verify at TRL 4 |
| UR-011 | PR-028 | Housing strength | HWB-CAL-001, HWB-BLD-001, HWB-STM-001 | Analysis (HWB-CAL-001 section 6), TRL 3; burst test (TF), TRL 4 | At risk (hoop factor 6; flat end wall factor 2.1 if the collar end were blocked; the procedure keeps it open, HWB-DEC-001 D8) |
| UR-008 | PR-029 | Backflush pressure | HWB-CAL-001, HWB-BLD-001 | Supplier data (HWB-DEC-001 C2), TRL 4 | At risk (limit not yet known; a gentle push gives 54 kPa) |

## Gaps

None.

Licence: this document is licensed under CC-BY-4.0 (Creative Commons Attribution 4.0 International), following the Helpful Engineering licensing guide. Design Molecule Labs with Helpful Engineering.
