BoujeeEnjinia1701/helpful-water/solutions/B-bottle-cartridge/docs/11-plan.md

---
doc_id: HWB-PLN-001
title: "Helpful Water B: bottle cartridge project plan"
project: "Helpful Water B: bottle cartridge"
doc_type: Project plan
version: "0.2"
status: Draft
date: 2026-11-11
author: Amish Chadha
license: CC-BY-4.0
revisions:
  - version: "0.1"
    date: 2026-11-11
    author: Amish Chadha
    change: "Solution B plan at P3 with the program kill criteria, targets and 60 to 90 day plan of HWP-PLN-001 that apply"
  - version: "0.2"
    date: 2026-11-11
    author: Amish Chadha
    change: "Independent STEM review run (D6 closed); D8 and D9 added to the decisions requested"
---

# Helpful Water B: bottle cartridge project plan

Solution B is at stage P3 and TRL 3 on paper: a constructable B1 design with drawings, a priced BOM and a build plan. The next gate, P4 (prototypes and accredited laboratory testing), stays closed until Amish opens it with Helpful Engineering. Amish chose B1 and settled D2 to D9 on 2026-11-11 (HWB-DEC-001); no decision is open. Method: STANDARDS sections 19, 23 and 25.7.

## Purpose

Deliver a low-cost, open, unpowered bottle cartridge designed to reduce bacteria and protozoa for families, schools and camps, used with chlorine where viruses are a risk (HWP-PLN-001 purpose, applied to B).

## Kill criteria

From HWP-PLN-001, applied to B: stop or pause if the cartridge cannot show consistent bacteria and protozoa reduction under realistic conditions; if flow at the persona efforts is unusable or is not recovered by backflush; if the header seal or membrane integrity cannot be kept through drops, carbon changes and storage; if the cost per user per year cannot approach USD 10 or the complexity is not viable at humanitarian scale; or if partners decline because of safety, liability or usability concerns.

## Targets and key performance indicators

Table 1. Targets that apply to B (HWP-PLN-001 Table 2: set by Amish on 2026-11-11).

| Category | Target | B status on paper |
| --- | --- | --- |
| Bacteria and protozoa | At least 3 log as a first gate; 6 log bacteria and 3 log cysts as the goal | To test (PR-001, PR-002) |
| Flow | At least 200 mL/min at 10 kPa (Rev A); 300 to 500 mL/min at an average squeeze (shortlist) | 274 at 10 kPa and 465 at 17 kPa, clean, estimates |
| Durability | At least 90 days of daily use; B aims at 6 to 12 months | To test (PR-026) |
| Unit cost at scale | Under USD 8 (shortlist) | USD 7.05 (estimate) |
| Cost per user per year | Under USD 10 (shortlist) | USD 10.8 at 9 months; 8.5 at 12 months |
| Mass | About 100 g (shortlist) | About 118 g dry |
| User testing | 80 % positive; 90 % follow the cleaning sequence unassisted | To test (TH) |

KPIs are those of HWP-PLN-001 Table 3 (efficacy, flow, durability, adoption, taste, cost, logistics, sustainability).

## Workstreams

Table 2. Workstreams.

| Workstream | Owner (role) | Deliverable | Status |
| --- | --- | --- | --- |
| Concept choice | Amish | D1 decision | Done: B1 (2026-11-11) |
| Module sourcing | Membrane engineer | Requests for quotation with flux, backwash limit and header drawing (C1 to C3) | Not started (P4) |
| Neck survey | Field partner | Local bottle finishes (C4, C7) | Not started |
| Prototype build | Mechanical engineer | Build to HWB-BLD-001 | On hold (P4) |
| Laboratory testing | Microbiologist and accredited laboratory | HWP-VER-001 TA to TI for B | On hold (P4) |
| Human factors | Human-factors lead | Persona trials with known potable test water only | On hold (P4) |
| Freedom to operate | Legal adviser | Squeeze-filter patent search and opinion (D5) | Not started |

## Minimum viable team

As HWP-PLN-001 Table 4; for B the membrane and water filtration engineer, the mechanical and design-for-manufacture engineer and the human-factors lead carry most of P4.

## Resources needed

Table 3. Resources (P4 onwards; on hold).

| Resource | Deliverable | Effort | Estimated cost (USD) |
| --- | --- | --- | --- |
| Prototype parts | Five B1 prototypes | From the BOM | About 92 (5 x 18.35) |
| Module samples | Two or three suppliers' samples | Weeks | To assess |
| Accredited testing | Share of the program's 50,000 to 150,000 | Months | Share to assess |
| Pressure gauge rig | Flow checks of BLD section 5 | Days | About 50 (estimate) |

## Stage gates

Table 4. Stages (P4 to P6 on hold while the stage cap is P3).

| Stage | Gate criteria | Status |
| --- | --- | --- |
| P0 | Problem, STEM check, options, REG, FEA, PLN | Done on paper |
| P1 | URS, PRS, RSK, MKT | Done on paper |
| P2 | CAL, RTM, concept selection record | Done; B1 chosen by Amish on 2026-11-11 |
| P3 | Model, STEP, drawings, priced BOM, build plan, DEC, design FMEA | Done on paper, 2026-11-11 |
| P4 | Prototypes, accredited tests (HWP-VER-001) | On hold (stage cap) |
| P5 | Field trials with a partner | On hold |
| P6 | Release and certification | On hold |

## 60 to 90 day plan once P4 opens (HWP-PLN-001 Table 7, for B)

| Window | Outputs and decision |
| --- | --- |
| Days 0 to 15 | D1 decided; module quotations; neck survey; freedom-to-operate search |
| Days 16 to 35 | Build five B1 prototypes with qualified modules; flow, leak and air checks with known potable test water |
| Days 36 to 60 | Fouling and backflush cycles; drops; persona trials; begin accredited pathogen testing |
| Days 61 to 90 | Review laboratory results and costs; update BOM, maintenance steps and risk register; go, pivot or stop |

## Support needed from Helpful Engineering

A field partner for the neck survey and persona trials; introductions to membrane module makers; an accredited laboratory for HWP-VER-001; a volunteer patent attorney.

## Next steps and decisions

Amish decided D1 (B1), D2 to D5 and D7 to D9 on 2026-11-11 (the independent STEM review, D6, was run the same day). Next, send the module requests for quotation when P4 opens.

## References

- Helpful Engineering source pack: Helpful Water update, 2026-02-26; Portable Freshwater Filter Straw component specifications, Rev A, 2026-10-14; Concept Validation Questions, 2026; Project Viability Shortlist Analysis, item 9; Helpful Water open questions (all internal).
- Program documents: HWP-PRB-001, HWP-SRC-001, HWP-URS-001, HWP-CLM-001, HWP-REG-001, HWP-MKT-001, HWP-PLN-001, HWP-VER-001, HWP-FTO-001.
- Bericap. "DS 38/15 2T SFB HF 1,5 mm e-wall (3600)." https://bericap.com/product/ds-38-15-2t-sfb-hf-15mm-ewall-3600/ (checked 2026-11-11).
- Centers for Disease Control and Prevention. "A Guide to Drinking Water Treatment Technologies for Household Use" (archived 2012). https://webarchive.library.unt.edu/web/20120927131907/http://www.cdc.gov/healthywater/drinking/travel/household_water_treatment.html (checked 2026-11-11).
- European Union. Regulation (EU) No 10/2011. https://eur-lex.europa.eu/eli/reg/2011/10/oj (checked 2026-11-11).
- FreshWaterSystems. "SilCarbon Activated Carbon Coconut Shell 12 x 40 Mesh, 1 Cubic Foot." https://www.freshwatersystems.com/products/silcarbon-activated-carbon-coconut-shell-12-x-40-mesh-1-cubic-foot (checked 2026-11-11).
- Google Patents. US 8,852,439 B2, "Drinking straw with hollow fibre liquid filter." https://patents.google.com/patent/US8852439 (checked 2026-11-11).
- Google Patents. US 8,708,161 B2, Toyobo PVDF hollow fibre membrane. https://patents.google.com/patent/US8708161B2/en (checked 2026-11-11).
- Jordan, Ryan. "How Effective Are Backflushing and Storage Practices for Backcountry Squeeze Filters Using Hollow-Fiber Membrane Technology?" Backpacking Light, November 17, 2021. https://backpackinglight.com/backflushing-squeeze-water-filter-platypus-sawyer-befree/ (checked 2026-11-11).
- Kapy CAD. "PET Bottle Threads: PCO-1881 and PCO-1810." https://kapycad.com/en/academy/standards/pet-bottle-thread (checked 2026-11-11).
- Membrane Solutions (Simpure). "Personal Water Filter Straw." https://www.simpurelife.com/products/personal-water-filter-straw (checked 2026-11-11).
- Newterra. "5DCAW 1240 Coconut Shell GAC Product Data Sheet." https://www.newterra.com/wp-content/uploads/2025/01/Newterra_5DCAW-1240-2-Coconut-Shell-GAC_Product-Data-Sheet.pdf (checked 2026-11-11).
- Petainer. "Bottle Preform: 38 mm 2-Start." https://www.petainer.com/pet-plastic-preforms/bottle-preforms/bottle-preform-38mm-2-start (checked 2026-11-11).
- Sawyer Products. "Water Filtration." https://sawyer.com/category/water-filtration (checked 2026-11-11).
- Topend Sports. "Handgrip Strength Norms." https://www.topendsports.com/testing/norms/handgrip.htm (checked 2026-11-11).
- World Health Organization. *Guidelines for Drinking-Water Quality*, 4th ed. with addenda. https://iris.who.int/bitstream/handle/10665/375822/9789240088740-eng.pdf (through HWP-REG-001).

Licence: this document is licensed under CC-BY-4.0 (Creative Commons Attribution 4.0 International), following the Helpful Engineering licensing guide. Design Molecule Labs with Helpful Engineering.
