BoujeeEnjinia1701/helpful-water/solutions/C-gravity/docs/01b-stem-check.md

---
doc_id: HWC-STM-001
title: "Helpful Water C: household gravity filter STEM check"
project: "Helpful Water C: household gravity filter"
doc_type: STEM check
version: "0.2"
status: Draft
date: 2026-11-11
author: Amish Chadha
license: CC-BY-4.0
revisions:
  - version: "0.1"
    date: 2026-11-11
    author: Amish Chadha
    change: "First STEM check, run before design (kit 1.9.1-he, STANDARDS sections 20 and 25.6); four detail failures fixed under the standing instruction of 2026-10-23 (HWC-DEC-001 F1 to F4); independent review recorded; rerun on the TRL 3 model"
  - version: "0.2"
    date: 2026-11-11
    author: Amish Chadha
    change: Decisions recorded as Amish's (all pending decisions settled on their recommendations, 2026-11-11)

---

# Helpful Water C: household gravity filter STEM check

Verdict: no claim fails. Of 36 claims, 25 sit within known science and 11 are plausible and stay open until supplier data or TRL 4 tests close them, so `stem_check` is **open**. The check was run before any design and found four details of the briefed options that do not work as described, and the independent review found a fifth in the first design; each fix keeps the working principle and was made under Amish's standing instruction of 2026-10-23 (HWC-DEC-001 F1 to F5, HWC-DDR-003): the stand gets 560 mm feet because the briefed 420 mm frame tips at 14 deg when loaded (S18); the module stands upright with its raw inlet on top and a bleed screw so shell air can escape (S19); a fill line and a 2.5 L refill line keep even a brim-full batch from overflowing the clean bucket (S20); the lid gets a dosing port and the valve a 30 minute hold tag, so chlorine from solution D gets its contact time before filtering (S21); and a luer check valve lets the syringe reach the air-test pressure in several strokes (S22). No option's working principle fails, so C2 and C3 stay in the concept options; C2 misses the "few hours" target by physics (S31) and C3 reduces bacteria less (S35), which the scoring reflects. The largest open item is the membrane's permeability: every C1 flow figure rests on an assumed 1,000 L/(m2 h bar) (HWC-DEC-001 C1). Method: STANDARDS sections 20 and 25.6. Calculations: `docs/04-calcs/stem_check.py`, which reads the results of `docs/04-calcs/sizing.py` (HWC-CAL-001).

> **Release limitation.** No prototype is used to treat water for drinking until its pathogen performance, materials safety, integrity, source suitability and claims are validated by qualified laboratories (HWP-CLM-001). Every number here is a paper estimate.

## Claims checked

Table 1. Claims, governing science and verdicts (generated from `docs/04-calcs/stem_results.csv` by `docs/04-calcs/stm_table.py`).

<!-- STM_TABLE -->
| # | Claim | Field | Branch | Governing law or source | First-order check | Verdict | Closed by |
| --- | --- | --- | --- | --- | --- | --- | --- |
| S1 | A household of five needs about 45 L a day for drinking and cooking | Biology | Human physiology and biomechanics | Sphere Handbook basic survival needs: drinking and food 2.5 to 3 L, basic cooking 3 to 6 L per person per day | 5 x 9 L = 45 L (upper end of 27.5 to 45 L); the 7.5 L per person emergency minimum for consumption gives 37.5 L | Within known science | HWC-CAL-001 |
| S2 | C1 runs on a gravity head of 4.1 to 6.4 kPa (0.42 to 0.66 m), inside the gravity range of STANDARDS 25.6 | Physics | Fluid mechanics | p = rho g h from the raw outlet and fill line (0.95 and 1.19 m) to the clean discharge (0.54 m) | 6.44 kPa <= 10 kPa | Within known science | HWC-CAL-001 |
| S3 | C1 treats the 45 L day in under 3 hours of filtering even when the module is due for a backflush (2.8 h fouled, 1.5 h clean) | Physics | Fluid mechanics | Falling-head drain of 3.2 batches of 14.1 L through 0.663 m2 of outside fibre area; assumed clean-water permeability 1,000 L/(m2 h bar), the value used by solutions A and B; fouled at half permeability | 2.77 h <= 3 h | Plausible, to confirm at TRL 3 | Open |
| S4 | Strainer, valve, hoses, fittings and lumens take under a fifth of the mean head, so the membrane sets the flow (18 % at the lowest head; a fouled strainer adds to it) | Physics | Fluid mechanics | Hagen-Poiseuille for the 9.5 mm hoses and the 0.5 mm lumens (half the leg loss, conservative against a third); K-factor sum 7.7 at the 7 mm barb bore; viscous losses and membrane flux both scale with viscosity, so the share holds in cold water | 0.72 kPa <= 1.05 kPa | Within known science | HWC-CAL-001 |
| S5 | Flow arithmetic: 1,000 L/(m2 h bar) x 0.66 m2 x 0.05 bar is about 33 L/h gross, 30 L/h net of the other stages | Mathematics | Units and dimensional analysis | L/(m2 h bar) x m2 x bar = L/h | claimed 33 L/h, estimate 30.2 L/h (ratio 1.09) | Within known science | HWC-CAL-001 |
| S6 | C1 flow of 30 L/h is of the same order as, and conservative against, a new commercial bucket hollow-fibre kit | Engineering and technology | Standards practice | Sawyer PointONE bucket kit: 46.5 to 54 L/h with a 0.3 m hose under a 19 L bucket (CAWST fact sheet) | claimed 30.2 L/h, estimate 50 L/h (ratio 0.60) | Within known science | HWC-CAL-001 |
| S7 | Flow does not depend on the user: a child or an elderly user gets the same flow, and draws water from the tap in about 9 s per 250 mL cup | Biology | Ergonomics | Gravity drives the filter; tap orifice flow Q = Cd A sqrt(2 g h), Cd 0.6, 8 mm bore, 0.05 to 0.26 m head (1.8 to 4.1 L/min) | The persona efforts are pouring a 5 L jug into a rim at 1.27 m (a carer task, not a child's), opening the tap and a gentle syringe push; tap force and pour height to measure in persona trials (HWP-VER-001 TH) | Plausible, to confirm at TRL 3 | Open |
| S8 | A gentle 30 N push on the 60 mL syringe backflushes the module, inside an elderly user's strength | Biology | Ergonomics | p = F / A on a 26.7 mm bore: 30 N puts at most 54 kPa in the barrel; the luer tip, check valve and barb take much of it, so the stroke is slow and the membrane sees less; 30 N as a light push is assumed | Stroke time and membrane pressure to measure; push strength of older users to take from persona trials (TH); a catheter-tip syringe is the alternative if the luer loss is too high | Plausible, to confirm at TRL 3 | Open |
| S9 | An intact 0.1 um hollow-fibre membrane is a size barrier for bacteria (about 0.3 to 5 um) and protozoan cysts (about 3 to 15 um); no removal is claimed from the pore label | Biology | Microbiology | Size exclusion: Cryptosporidium oocysts 4 to 6 um and Giardia cysts 8 to 12 um are 40 to 120 times the pore; a commercial 0.1 um bucket module tested above 7 log Klebsiella and 5 log Cryptosporidium and Giardia (CAWST fact sheet) | A log reduction exists for this module only once an accredited laboratory measures it (HWP-VER-001 TA, TB) | Within known science | HWC-CAL-001 |
| S10 | The membrane is not a virus barrier, so C carries the no-virus warning and pairs with chlorine in the raw bucket (solution D) where viruses are a risk | Biology | Microbiology | Enteric viruses about 0.02 to 0.1 um pass a 0.1 um pore; the cited 0.1 um bucket module lists viruses as not removed (CAWST) | No virus claim (Amish, 2026-11-11: no virus claim, co-treat); HWP-CLM-001 warning on the raw bucket label | Within known science | HWC-CAL-001 |
| S11 | Paired with D, 30 minutes at a measured free chlorine residual of 0.5 mg/L at the end of contact gives a CT of 15 mg min/L, above the 4 log virus CT even at 0.5 degC (12); mixing and the residual are D's to confirm | Chemistry | Physical chemistry | CT = C x t with C the residual at the end of contact; EPA free chlorine CT for 4 log virus inactivation, pH 6 to 9: 12 at 0.5 degC, 8 at 5 degC, 3 at 20 degC mg min/L | 15 mg min/L >= 12 mg min/L | Within known science | HWC-CAL-001 |
| S12 | Chlorine does not inactivate Cryptosporidium at household doses (136 h at 1.875 mg/L for a CT of 15,300, longer in cold water), nor reach a useful Giardia CT in 30 minutes, so the membrane after chlorination is what removes cysts | Biology | Microbiology | CT for Cryptosporidium with free chlorine about 15,300 mg min/L at about 25 degC (CDC hyperchlorination guidance); HWP-CLM-001: no Cryptosporidium claim from chlorine alone | Chlorinate first, then filter: the order of the C plus D system; each barrier covers the other's gap | Within known science | HWC-CAL-001 |
| S13 | The PVDF fibres tolerate a lifetime of household chlorine in the raw water (98,550 ppm h over 3 years at 3.75 mg/L, continuously wetted) | Chemistry | Materials and polymer chemistry | Lifetime chlorine tolerance of a PVDF UF membrane 3,000,000 ppm h (LG Water Solutions data, another maker's product); hydrophilising additives, potting and gaskets may tolerate less | 3.3 % of limit <= 100 % of limit | Plausible, to confirm at TRL 3 | Open |
| S14 | Free chlorine passes the membrane, so a residual reaches the clean bucket and protects stored water; C has no carbon stage, because carbon downstream of the dose would remove that residual | Chemistry | Physical chemistry | Hypochlorous acid and hypochlorite are small dissolved species that a 0.1 um membrane does not retain; activated carbon reduces free chlorine fast (the basis of NSF/ANSI 42 chlorine claims); CDC SWS target above 0.2 mg/L after 24 h | Residual in the clean bucket to measure at 1 and 24 h with D (HWP-VER-001 TJ); chlorine taste is the trade-off (HWC-DEC-001 D3) | Plausible, to confirm at TRL 3 | Open |
| S15 | Settling for 1 h (1.5 h below 10 degC) drops silt of 10 um and larger below the outlet: 0.74 h needed at 20 degC and 1.13 h at 5 degC for the 241 mm column | Physics | Fluid mechanics | Stokes settling v = g d2 (rho_p - rho) / 18 mu, quartz 2,650 kg/m3, mu 1.0 (20 degC) and 1.52 mPa s (5 degC); clay (2 um, 13 mm/h) and colloids do not settle; pouring and draw-off can resuspend fines | 1.13 h at 5 degC <= 1.5 h at 5 degC | Within known science | HWC-CAL-001 |
| S16 | Cotton cloth folded to eight layers in the fill ring removes coarse particles and plankton-attached organisms before the bucket | Biology | Microbiology | Colwell et al. 2003 (PNAS): worn, laundered sari cloth folded four to eight times has an effective pore of about 20 um; 48 % fewer cholera cases in 65 villages | A prefilter only; no pathogen claim rests on it; the cloth is specified as worn, soft and tightly woven, and its retention is measured at TRL 4 (TD) | Within known science | HWC-CAL-001 |
| S17 | Turbid source water (SC3, 10 to 100 NTU) needs more backflushes, not a different design | Engineering and technology | Standards practice | Commercial 0.1 um bucket kit: backflush about every 3,800 L of clear water and every 40 L or less of very turbid water (CAWST) | Volume between backflushes at 1, 10, 50 and 100 NTU to measure (HWP-VER-001 TE); settle overnight above 50 NTU | Plausible, to confirm at TRL 3 | Open |
| S18 | The loaded stand needs 18.7 deg of tilt and 78 N at 1 m to tip (the briefed 420 mm frame gave 14.2 deg and failed); a child's pull can exceed 78 N, so a wall strap is fitted (HWC-DEC-001 D4) | Physics | Mechanics and statics | Tip angle atan(half base / centre of gravity height), raw bucket full, clean bucket empty; criterion 15 deg (assumed, as solution B) | 18.7 deg >= 15 deg | Within known science | HWC-DEC-001 F1 |
| S19 | The module runs full: shell air would block fibre area, so the module stands upright with its raw inlet on top and a bleed screw at the top of the shell, opened at first fill until water shows | Physics | Fluid mechanics | A wetted membrane holds air below its bubble point (hundreds of kPa for real 0.1 um fibres), so trapped shell air cannot pass the fibres; downflow in the hose (about 0.12 m/s) roughly cancels bubble rise, so venting through the inlet alone is not reliable | Failed as briefed (orientation free; air pockets over the U-bends), fixed by the upright mounting and a bleed screw on the top cap (supplier request); repeat the bleed after a dry spell | Within known science | HWC-DEC-001 F2 |
| S20 | Even a raw bucket filled to the brim (19.4 L above the settling zone) fits in the clean bucket when the user starts below the 2.5 L refill line | Mathematics | Orders of magnitude | Volume balance; as briefed, two 20 L containers overflow when the clean one is not empty, and a 5 L line still overflowed if the user overfilled past the 17 L mark; fixed with a 2.5 L refill line just above the tap | in 19.56 L, out 19.4 L | Within known science | HWC-DEC-001 F3 |
| S21 | Chlorine is added after settling, through the lid port, and the raw valve stays shut for 30 minutes | Chemistry | Physical chemistry | Turbidity shields organisms and adds chlorine demand (WHO, CDC: double dose for turbid water); an open valve during contact sends water to the filter before its 30 minutes | Failed as briefed (no hold point), fixed: a dosing port in the raw lid for D and a valve tag 'shut for 30 minutes after dosing'; mixing and dose belong to D | Within known science | HWC-DEC-001 F4 |
| S22 | An air hold test shows a broken fibre as bubbles in the clear raw hose: the user pumps air strokes through a luer check valve until a firm 56 N push (100 kPa) holds | Physics | Fluid mechanics | Young-Laplace dP = 4 gamma / d: at 100 kPa any opening above about 3 um passes air, while real 0.1 um fibres hold air to hundreds of kPa; the lumens hold 52 mL of water, which the first strokes push out through the walls; Boyle's law then needs several strokes, which the check valve allows; the push force is the user's gauge | Failed as first written (one 60 mL stroke cannot reach 100 kPa against a water-filled clean side), fixed with the check valve and a several-stroke procedure | Within known science | HWC-DEC-001 F5 |
| S23 | The air test finds gross damage, not small defects, so it is a monthly check and never proof of performance | Engineering and technology | Sensing resolution | Openings under about 3 um hold at 100 kPa; bacteria are 0.5 to 5 um; a broken fibre (0.5 mm lumen) passes air at 0.6 kPa | Instructions say 'retire if bubbles stream', never 'safe if no bubbles'; the module maker's production integrity test (HWP-VER-001 TI) is the real proof | Within known science | HWC-CAL-001 |
| S24 | The clean side is above atmospheric pressure (1.7 kPa at the module outlet) while filtering, so a leaking clean fitting drips out and cannot draw dirty water in | Physics | Fluid mechanics | Hydrostatic pressure from the clean discharge (0.54 m) down to the module outlet (0.36 m); every clean-side joint outside the module sits below the discharge except the inlet barb at it | 1.72 kPa >= 0 kPa | Within known science | HWC-CAL-001 |
| S25 | Wet fibres can be damaged by freezing without any change in flow, so C carries a do-not-freeze warning and a retire-after-freezing rule | Physics | Thermodynamics | Water expands about 9 % on freezing; a silent failure mode that hollow-fibre makers warn of (concept validation questions, item 17) | No freeze claim; pictogram; after a suspected freeze the module is retired, not tested and reused; drain and store indoors (HWP-VER-001 TF) | Within known science | HWC-CAL-001 |
| S26 | The module shell, end caps and potting hold the highest raw pressure (8.2 kPa) and a hard backflush (179 kPa) | Physics | Strength of materials | Thin-wall hoop stress p r / t on a 50 x 2 mm shell is 2.1 MPa at 179 kPa, far below 10 MPa (assumed for PP or ABS); the end load (about 300 N) on caps and potting is not checked; a palm push of 200 N doubles the pressure | Supplier's burst and backwash rating to obtain (HWC-DEC-001 C2); the instruction is a gentle push | Plausible, to confirm at TRL 3 | Open |
| S27 | A gentle backflush (54 kPa) stays inside the module maker's backwash limit | Engineering and technology | Standards practice | p = F / syringe bore area; the maximum backwash pressure of the bought module is not yet known | To confirm from the supplier (HWC-DEC-001 C2); the instruction is a gentle push with water drawn from the clean tap | Plausible, to confirm at TRL 3 | Open |
| S28 | Without chlorine, water standing on the clean side (83 mL: 52 mL in the lumens, the rest in the tee and clean hose) and in the clean bucket can regrow bacteria between batches | Biology | Microbiology | Biofilm grows on wetted surfaces downstream of membranes (Rev A specification section 05); stored water is recontaminated in handling (HWP-SRC-001 SC5) | Mitigations: closed bucket with tap and screened vent, no dipping, weekly chlorine rinse of the clean bucket, discard the first cup after a pause of more than a day, D residual where used; regrowth to measure (HWP-VER-001 TE, TG) | Plausible, to confirm at TRL 3 | Open |
| S29 | Every wetted material is from a family available in NSF/ANSI/CAN 61 grades: HDPE buckets, PP valve, tap and fittings, silicone hose, EPDM gaskets, 316 stainless strainer, PVDF fibres, polyurethane or epoxy potting | Chemistry | Materials and polymer chemistry | NSF/ANSI/CAN 61 and 372; buckets must be new food-grade, never reused chemical pails; plasticised PVC hose is avoided because plasticisers can leach | Extractables of the actual grades and the potting (HWP-VER-001 TG); prototypes are used with known potable test water only | Plausible, to confirm at TRL 3 | Open |
| S30 | Full, the C1 system weighs about 50 kg (raw 17 L and clean 20 L of water, buckets, stand, module) | Mathematics | Orders of magnitude | Two buckets of water (17 + 20 kg), buckets 2.4 kg, stand 9 kg (timber 500 kg/m3), module and hoses 1 kg | claimed 50 kg, estimate 49.4 kg (ratio 1.01) | Within known science | HWC-CAL-001 |
| S31 | C2: four ceramic candles under about 0.3 m of water give about 4 L/h full, so the 45 L day takes about 19 h of filtering | Physics | Fluid mechanics | British Berkefeld gravity data: two candles 2 L/h in the 12 L system (about 1 L/h per candle); flow falls as the upper chamber drains (mean 60 %, assumed) | Physics holds; 19 h is a best case for new candles; the option filters most of the day and night and misses the 'few hours' target (scored in HWC-OPT-001) | Within known science | HWC-CAL-001 |
| S32 | C2: silver-impregnated ceramic candles reduce bacteria (4 log listed) and protozoa by size exclusion; any silver claim needs biocide registration and silver leaching data | Chemistry | Toxicology | Engineering for Change listing (4 log bacteria; virus and cyst data unknown); WHO gives no health-based silver value and notes up to 0.1 mg/L is tolerated; HWP-REG-001 W9 | No silver or antimicrobial claim; plain ceramic is an option; silver in water to measure (TG) | Plausible, to confirm at TRL 3 | Open |
| S33 | C2: ceramic is brittle and cracks from a drop or from freezing without any visible change in flow | Physics | Strength of materials | Fired ceramic has low fracture toughness; a hairline crack opens a path far larger than the pores | Inspect candles at each cleaning; retire after a drop; no freeze claim | Within known science | HWC-CAL-001 |
| S34 | C3: a plastic biosand filter treats 18 L batches at up to 0.4 L/min and needs a pause of at least 1 h between batches, so the 45 L day takes 2.5 batches | Physics | Fluid mechanics | CAWST 2009 fact sheet: maximum 0.4 L/min, loading rate below 600 L/(h m2) (199 here), 12 to 18 L per batch, pause 1 to 48 h | Physics holds; the day's water is filtered in three sessions spread through the day | Within known science | HWC-CAL-001 |
| S35 | C3: biosand reduces bacteria less than a membrane (up to 96.5 % in the lab, 87.9 to 98.5 % in the field, about 1 to 1.8 log) and protozoa more than 99.9 % in the lab, after a biolayer ripens for up to 30 days | Biology | Microbiology | CAWST 2009 fact sheet; removal is low and silent while the biolayer ripens and after disturbance | Holds as a principle; below the WHO two-star 2 log bacteria target in all cited data; chlorine must go after the filter, never before it, or it harms the biolayer | Within known science | HWC-CAL-001 |
| S36 | C3: the filter holds about 124 kg of dry sand and gravel (about 170 kg in operation with pore and standing water), so it is filled in place and never moved | Mathematics | Orders of magnitude | Bed volume (392 mm bore, 0.64 m of media) x 1,600 kg/m3 bulk density (assumed) | claimed 124 kg, estimate 124 kg (ratio 1.00) | Within known science | HWC-CAL-001 |
<!-- /STM_TABLE -->

## Water checks of STANDARDS 25.6

Table 2. Where each water check is answered.

| Check | Rows | Result |
| --- | --- | --- |
| Membrane flux against the pressure available | S2, S3, S5, S6 | 4.1 to 6.4 kPa of gravity head; 45 L in 1.6 h clean, 2.8 h fouled (assumed permeability) |
| Pressure drop per stage | S4 | Membrane 4.55 kPa; lumens 0.50; hoses 0.03; fittings 0.18 kPa at the mean head (14 % of the head; 18 % at the lowest head) |
| Flow at the persona efforts | S7, S8 | Gravity sets the flow for every user; the child or elderly user only opens a tap (a cup in about 9 s) or gives a 30 N syringe push |
| Pore against organism size | S9, S10 | 0.1 um against bacteria and cysts; no virus claim |
| Carbon contact time and bed mass | Not applicable | C has no carbon stage: carbon after the chlorine dose would remove the residual that protects stored water (S14) |
| Disinfection dose and CT | S11, S12, S13, S21 | CT 15 mg min/L in 30 min with D against 8 for 4 log viruses at 5 degC; *Cryptosporidium* left to the membrane; PVDF tolerates the chlorine |
| Integrity and silent failure | S22 to S27 | Air hold test at 100 kPa through a check valve; clean side above atmospheric; freezing warning; supplier pressure ratings open |
| Biofilm downstream of the membrane | S28 | 83 mL hold-up (52 mL in the lumens); closed clean bucket; D residual where used; regrowth to measure |
| Materials leaching | S29 | NSF/ANSI/CAN 61 families; no PVC hose, no brass |
| Freezing | S25, S33 | No freeze claim; retire after freezing wet |
| Settling stage for SC3 | S15, S16, S17 | Stokes: 10 um silt settles in 0.7 h at 20 degC and 1.1 h at 5 degC (settle 1 h, 1.5 h below 10 degC); clay does not; cloth prefilter; more backflushes |

Fields not relevant: electromagnetism and circuits, optics and radiation, nuclear and ionising radiation (no power, no light-based treatment, no radioactive material); acoustics and vibration (no moving machinery); ecology and agronomy (no field use of the product beyond the household; the spent sludge is the household's raw water sediment).

## Verdict by option

- **C1 two-bucket hollow-fibre filter:** within known science; five details fixed (F1 to F5); open on the assumed permeability (S3), persona efforts (S7, S8), the module's chlorine tolerance (S13), residual in storage (S14), turbid-water backflush interval (S17), the module's pressure ratings (S26, S27), clean-side regrowth (S28) and materials (S29).
- **C2 ceramic candle filter:** within known science; four candles need about 19 h of filtering for the 45 L day (S31); silver claims need registration (S32); brittle and silent when cracked (S33).
- **C3 plastic biosand filter:** within known science; about 1 to 2 log bacteria reduction in field data and up to 30 days of ripening (S35); 124 kg of media (S36); chlorine only after the filter.

## Independent review

A second agent (Claude, run as a separate process with no access to this document's reasoning) was given only the claims table and the source list on 2026-11-11 and asked to refute every "Within known science" verdict. It reviewed the 28 rows then marked "Within": 14 hold, 12 are weakened and 2 are refuted. Table 3 lists what it found and what changed; of the rows that hold, S1, S9, S10, S16 and S31 were reworded as it suggested and S2, S21, S23, S24, S33 and S34 are unchanged.

Table 3. Independent review findings and changes.

| Row | Finding | Change made |
| --- | --- | --- |
| S22 | Refuted: one 60 mL stroke cannot pressurise a water-filled clean side (52 mL of lumens) to 100 kPa, and the user has no gauge | Fix F5: a luer check valve on the backflush port and a several-stroke procedure; the firm 56 N push is the user's gauge; the row is closed by the fix |
| S30 | Refuted: the listed masses sum to about 49 kg, not 65 kg | Mass formula corrected (49 kg full) |
| S19 | Weakened: hose downflow cancels bubble rise; air over the U-bends may not vent; real bubble points are lower than the nominal Young-Laplace value | Fix F2 extended: bleed screw on the module top cap (supplier request), opened at first fill |
| S20 | Weakened: pouring four 5 L jugs overshoots the 17 L line and overflows a clean bucket at 5 L | Fix F3 revised: refill line at 2.5 L, so even a brim-full raw batch (19.4 L) fits the 19.6 L free |
| S8 | Weakened: the luer tip and barb take much of the barrel pressure; push strength is assumed | Row made Plausible; stroke time and membrane pressure to measure; catheter-tip syringe as the alternative |
| S26 | Weakened: end caps and potting carry about 300 N and are not checked | Row made Plausible; supplier burst and backwash rating requested (HWC-DEC-001 C2) |
| S13 | Weakened: the PVDF tolerance is another maker's; additives and potting may tolerate less | Row made Plausible; supplier's ppm h limit for the actual module requested |
| S15 | Weakened: at 5 degC 10 um silt needs 1.1 h, so one hour fails in cold water | Instruction: settle 1 h, 1.5 h below 10 degC; the row now checks the 5 degC case |
| S4 | Weakened: the margin is 18 % at the lowest head; cold water raises losses | Stated in the row; losses and flux scale together with viscosity, so the share holds |
| S5, S6 | Weakened: spurious precision; 30 L/h is 40 % below the commercial kit | Reworded: 33 L/h gross, 30 L/h net; "same order and conservative" |
| S11, S12 | Holds, with C defined as the residual at the end of contact, the 0.5 degC CT of 12, and the 1.875 mg/L dose | Rows reworded; mixing and the residual belong to D |
| S18 | Weakened: a child's pull can exceed 78 N; criterion assumed | Wall strap fitted (HWC-DEC-001 D4, Amish 2026-11-11); safety section tells users to strap the stand where children play |
| S25 | Weakened: "main cause" rests on one internal source; the air test should not clear a frozen module | Reworded; a frozen module is retired, not tested and reused |
| S35 | Weakened: every cited bacteria figure is below 2 log | Reworded: "below the WHO two-star target in all cited data" |
| S36 | Claim and check disagreed; operating mass is about 170 kg | Made consistent; wet mass stated |
| S28 | The clean-side volume looked too low (lumens alone 52 mL) | Hold-up recomputed: 83 mL |

The reviewer also asked for one source of truth for the batch volume: every document now takes 14.4 L (14.35 L above the outlet at the fill line; 14.1 L drained to 5 mm above the outlet in the flow model) from `sizing_results.json`.

## Sources

- Sphere Project. "Water Supply Standard 1: Access and Water Quantity." *Humanitarian Charter and Minimum Standards in Humanitarian Response* (2011 edition, online prototype). https://sphereprototype.conted.ox.ac.uk/standards/watersupply/accessAndWaterQuantity.html (checked 2026-11-11).
- CAWST. "Sawyer PointONE Biological Filter" fact sheet. https://washplusblog.fhi360.org/drinkingwaterupdates/wp-content/uploads/2014/03/cawst-sawyer.pdf (checked 2026-11-11).
- CAWST. "Biosand Filter" fact sheet, academic version, 2009. https://sswm.info/sites/default/files/reference_attachments/CAWST%202009%20Biosand%20Filter%20Fact%20Sheet%20academic_1.pdf (checked 2026-11-11).
- British Berkefeld. "SS Gravity Data Sheet." https://cdn.shopify.com/s/files/1/2522/0950/files/British_Berkefeld_SS_Gravity_-_Data_Sheet.pdf (checked 2026-11-11); Engineering for Change. "British Berkefeld Household Filter Kit." https://www.engineeringforchange.org/solutions/product/british-berkefeld-household-filter-kit/ (checked 2026-11-11).
- California State Water Resources Control Board. "4-Log Virus Inactivation through Chlorine Disinfection" (EPA CT values). https://www.waterboards.ca.gov/drinking_water/programs/districts/docs/sonoma/120_4_log_virus_inactivation_through_cl2_disinfection.pdf (checked 2026-11-11).
- New Jersey Department of Health. "Hyperchlorination to Kill Crypto When Chlorine Stabilizer Is Not in the Water" (CDC guidance). https://nj.gov/health/ceohs/documents/phss/hyperchlorination-to-kill-crypto-when-chlorine-stabilizer-is-not-in-the-water.pdf (checked 2026-11-11).
- Lantagne, Daniele, et al. "Engineering Inputs to the CDC Safe Water System Program." In *Frontiers of Engineering 2005*. National Academies Press, 2006. https://www.nationalacademies.org/read/11577/chapter/8 (checked 2026-11-11).
- LG Water Solutions. "QuantumFlux Pressurized UF Membrane: Design and Operating Parameters." https://www.lgwatersolutions.com/wp-content/uploads/2024/12/QuantumFlux_Pressurized-UF-Membrane_Design-and-Operating-Parameters_F-1.pdf (checked 2026-11-11).
- Colwell, Rita R., et al. "Reduction of Cholera in Bangladeshi Villages by Simple Filtration." *Proceedings of the National Academy of Sciences* 100, no. 3 (2003): 1051 to 1055. https://pmc.ncbi.nlm.nih.gov/articles/PMC298724 (checked 2026-11-11).
- World Health Organization. *Guidelines for Drinking-Water Quality*, 4th ed. with addenda (pathogen sizes; chlorine). https://iris.who.int/bitstream/handle/10665/375822/9789240088740-eng.pdf (cited through HWP-REG-001).
- Helpful Engineering. *Portable Freshwater Filter Straw: Component Specifications*, Rev A, 2026-10-14; *Concept Validation Questions*, 2026 (internal).
- Program documents: HWP-PRB-001, HWP-SRC-001, HWP-CLM-001, HWP-VER-001.

Licence: this document is licensed under CC-BY-4.0 (Creative Commons Attribution 4.0 International), following the Helpful Engineering licensing guide. Design Molecule Labs with Helpful Engineering.
