BoujeeEnjinia1701/helpful-water/solutions/C-gravity/docs/03b-traceability.md

---
doc_id: HWC-RTM-001
title: 'Helpful Water C: household gravity filter traceability matrix'
project: 'Helpful Water C: household gravity filter'
doc_type: Traceability matrix
version: '0.3'
status: Draft
date: '2026-11-11'
author: Amish Chadha
license: CC-BY-4.0
source_hash: 315e7a0fbbf9c635
revisions:
- version: '0.1'
  date: '2026-11-11'
  author: Amish Chadha
  change: Generated by .kit/trace.py
- version: '0.2'
  date: '2026-11-11'
  author: Amish Chadha
  change: Generated by .kit/trace.py
- version: '0.3'
  date: '2026-11-11'
  author: Amish Chadha
  change: Generated by .kit/trace.py
---

# Helpful Water C: household gravity filter traceability matrix

Generated by `python .kit/trace.py` from the user requirements, product requirements, calculations, build plan and BOM. Do not edit by hand. 24 user requirements, 30 product requirements, 0 gaps.

Table 1. User requirement to product requirement to evidence to verification.

| User requirement | Product requirement | Title | Evidence | Verification | Status |
| --- | --- | --- | --- | --- | --- |
| UR-001 | PR-001 | Bacteria reduction | HWC-BLD-001 | Supplier certificate (TA) and accredited challenge at beginning and end of life (TB), TRL 4 | To verify at TRL 4 |
| UR-002 | PR-002 | Protozoa reduction | HWC-BLD-001 | Accredited challenge (TB), TRL 4 | To verify at TRL 4 |
| UR-003, UR-006 | PR-003 | Chlorine interface and no-virus warning | HWC-BLD-001 | Inspection of the model (HWC-DWG-001), TRL 3; comprehension (TH) and dosing with D (TJ), TRL 4 | Met by design |
| UR-003, UR-101 | PR-004 | Residual reaches storage | HWC-CAL-001, HWC-BLD-001 | Residual at 1 and 24 h with D (TJ), TRL 4 | Met by design; residual to verify |
| UR-013 | PR-005 | Daily volume | HWC-CAL-001, HWC-BLD-001 | Analysis (HWC-CAL-001 section 4), TRL 3; pressure-flow map (TC), TRL 4 | Met on paper (1.6 h clean, 2.8 h fouled; assumed permeability) |
| UR-004 | PR-006 | Tap draw | HWC-CAL-001, HWC-BLD-001 | Analysis (HWC-CAL-001 section 6), TRL 3; persona trials (TH), TRL 4 | Met on paper (8.6 s) |
| UR-004, UR-007 | PR-007 | Backflush effort | HWC-CAL-001, HWC-BLD-001 | Analysis (HWC-CAL-001 section 6), TRL 3; TH, TRL 4 | Met on paper (30 N gives 54 kPa) |
| UR-005 | PR-008 | Ready on day one | HWC-BLD-001 | Inspection of the procedure (HWC-BLD-001), TRL 3; TH, TRL 4 | Met by design |
| UR-006 | PR-009 | Pictogram instructions | HWC-BLD-001 | Inspection of the label artwork, TRL 3; comprehension trial (TH), TRL 4 | To verify at TRL 4 |
| UR-007 | PR-010 | Daily upkeep | HWC-BLD-001 | Analysis of the procedure (HWC-BLD-001 section 5), TRL 3; TH, TRL 4 | Met on paper |
| UR-008 | PR-011 | Air hold test | HWC-CAL-001, HWC-BLD-001 | Analysis (HWC-CAL-001 section 5), TRL 3; defect-seeded test (TF, TI), TRL 4 | Met on paper (2.9 um); not a proof of performance |
| UR-008 | PR-012 | Retirement signal | HWC-BLD-001 | Inspection, TRL 3; fouling and life test (TE), TRL 4 | To verify at TRL 4 |
| UR-009 | PR-013 | One dirty-to-clean boundary | HWC-CAL-001, HWC-BLD-001 | Inspection of the model (HWC-DWG-002), TRL 3; bypass tests (TF), TRL 4 | Met by design (1.7 kPa clean-side pressure) |
| UR-010, UR-101 | PR-014 | Closed clean bucket | HWC-BLD-001 | Inspection, TRL 3; storage recontamination test (TE), TRL 4 | Met by design |
| UR-010 | PR-015 | Clean-side hold-up | HWC-CAL-001, HWC-BLD-001 | Analysis (HWC-CAL-001 section 5), TRL 3; regrowth (TE, TG), TRL 4 | Met on paper (83 mL, 52 mL of it in the lumens); regrowth to verify |
| UR-011 | PR-016 | Wetted materials | HWC-BLD-001 | Supplier certificates and extractables (TG), TRL 4 | To verify at TRL 4 |
| UR-014 | PR-017 | Cost | HWC-CAL-001, HWC-BLD-001 | Analysis (BOM, HWC-CAL-001 section 7), TRL 3 | Over target (USD 86.40; USD 0.003 a litre; USD 9.44 per person per year) |
| UR-015 | PR-018 | No routine consumable | HWC-BLD-001 | Inspection of the BOM, TRL 3; life test (TE), TRL 4 | Met by design (module life assumed) |
| UR-016 | PR-019 | Shelf life | HWC-BLD-001 | Supplier data (TA), shelf-life ageing (TF), TRL 4 | To verify at TRL 4 |
| UR-017 | PR-020 | Freezing and knocks | HWC-BLD-001 | Inspection, TRL 3; freeze and drop tests (TF), TRL 4 | Met by design |
| UR-018 | PR-021 | Taste with chlorine | HWC-CAL-001, HWC-BLD-001 | Taste panel and residual (TG, TJ), TRL 4 | At risk (no carbon stage; HWC-DEC-001 D3) |
| UR-019 | PR-022 | Cleanable prefilter | HWC-BLD-001 | Inspection of the model, TRL 3; TH, TRL 4 | Met by design |
| UR-021 | PR-023 | End of life | HWC-BLD-001 | Inspection of the BOM, TRL 3 | Met by design |
| UR-022 | PR-024 | Regional manufacture | HWC-BLD-001 | Inspection of the BOM, TRL 3 | Met by design (module, tee) |
| UR-101, UR-013 | PR-025 | No overflow | HWC-CAL-001, HWC-BLD-001 | Analysis (HWC-CAL-001 section 3), TRL 3; TH, TRL 4 | Met on paper (19.4 L worst batch, 19.6 L free) |
| UR-102 | PR-026 | Settling and turbid water | HWC-CAL-001, HWC-BLD-001 | Analysis (HWC-CAL-001 section 5), TRL 3; fouling test at 1, 10, 50 and 100 NTU (TE, TD), TRL 4 | To verify at TRL 4 |
| UR-103 | PR-027 | Fill in place | HWC-CAL-001, HWC-BLD-001 | Inspection of the model (HWC-DWG-001), TRL 3; persona trials (TH), TRL 4 | At risk (1.27 m: chest height of a 1.75 m adult; a carer task, not a child's) |
| UR-104 | PR-028 | Stability | HWC-CAL-001, HWC-BLD-001 | Analysis (HWC-CAL-001 section 6), TRL 3; tip test with water (TF), TRL 4 | Met on paper (18.7 deg, 78 N) |
| UR-005, UR-013 | PR-029 | Priming | HWC-BLD-001 | Inspection of the model, TRL 3; first-fill observation (TC), TRL 4 | Met by design |
| UR-013 | PR-030 | Gravity head | HWC-CAL-001, HWC-BLD-001 | Analysis (HWC-CAL-001 section 3), TRL 3 | Met on paper (0.42 to 0.66 m) |

## Gaps

None.

Licence: this document is licensed under CC-BY-4.0 (Creative Commons Attribution 4.0 International), following the Helpful Engineering licensing guide. Design Molecule Labs with Helpful Engineering.
