BoujeeEnjinia1701/helpful-water/solutions/D-virus-add-on/docs/01b-stem-check.md

---
doc_id: HWD-STM-001
title: "Helpful Water D: chlorine co-treatment add-on STEM check"
project: "Helpful Water D: chlorine co-treatment add-on"
doc_type: STEM check
version: "0.3"
status: Draft
date: 2026-11-11
author: Amish Chadha
license: CC-BY-4.0
revisions:
  - version: "0.1"
    date: 2026-11-11
    author: Amish Chadha
    change: First STEM check with the water checks of STANDARDS 25.6; five detail failures fixed under the standing instruction (HWD-DEC-001 F1 to F5); one system finding sent to Amish (S16); option D3 dropped
  - version: "0.2"
    date: 2026-11-11
    author: Amish Chadha
    change: Independent review recorded (20 holds, 18 weak, 5 refuted of 43 rows); fixes F7 to F12 (HWD-DDR-004); CT by the EPA definition; rows S40 to S43 added; S43 sent to Amish (D7)
  - version: "0.3"
    date: 2026-11-11
    author: Amish Chadha
    change: Decisions recorded as Amish's (all pending decisions settled on their recommendations, 2026-11-11)

---

# Helpful Water D: chlorine co-treatment add-on STEM check

Verdict: household chlorination with a matched NaDCC tablet (option D1) and with metered 1.25 % hypochlorite (option D2) sit within known science for viruses and bacteria in clear, near-neutral water. At about 2 mg/L in clear water the free chlorine left after 30 minutes is estimated at 1.7 mg/L, giving a CT (residual at the end of the wait x time, the US EPA definition) of about 51 mg min/L, six times the 8 mg min/L that the US EPA table sets for 4-log virus inactivation at 5 C (pH 6 to 9). No virus credit is taken above 5 NTU. Neither option touches *Cryptosporidium* (its CT is about 15,300 mg min/L), so the filter stays essential, as HWP-CLM-001 says. Five details failed as briefed and were fixed under Amish's standing instruction of 2026-10-23 (F1 to F6). An independent review on 2026-11-11 refuted five rows and weakened eighteen; six more fixes followed under the same instruction (F7 to F12: a pour-and-stir method for the 20 L bucket, a bottle range on the label, a wider D2 dropper orifice, an O-ring groove with stated tolerances, a 45 minute timer that still reads 30 minutes at 40 C, and no polycarbonate in the well). Two findings were settled by Amish on 2026-11-11: C stays carbon-free so its stored water keeps a residual, while A and B claim none (S16, HWD-DEC-001 D3), and each household kit carries free chlorine test strips (S43, D7). The erosion feeder (D3) fails on its working principle and is dropped. `stem_check: open` only because nineteen Plausible rows need laboratory tests, supplier data or measured tablets; no decision is open. Method: STANDARDS sections 20 and 25.6; numbers from HWD-CAL-001 (`docs/04-calcs/sizing.py`), checks in `docs/04-calcs/stem_check.py`.

> **Release limitation.** Nothing here is a validated water treatment product. No prototype is used to treat water for drinking until its pathogen performance, materials safety, integrity, source suitability and claims are validated by qualified laboratories (HWP-CLM-001).

## Claims checked: options D1 and D2

Table 1. Claims, governing science and verdicts (generated from `docs/04-calcs/stem_results.csv` by `stm_table.py`). "Plausible, to confirm at TRL 3" is the kit's label; here each names the HWP-VER-001 family or supplier datum that closes it at TRL 4.

<!-- STM_TABLE -->
| # | Claim | Field | Branch | Governing law or source | First-order check | Verdict | Closed by |
| --- | --- | --- | --- | --- | --- | --- | --- |
| S1 | A 3.5 mg NaDCC tablet carries 2.0 mg of available chlorine (57% of its mass, anhydrous basis) | Chemistry | Inorganic | Stoichiometry: two N-Cl per NaDCC, each counted as one Cl2; IFRC catalogue WASDCHLA01 (2 mg per 3.5 mg tablet) | Theory 55.4% (dihydrate) to 64.5% (anhydrous); catalogue tablets 57% to 61%, so the tablets are anhydrous NaDCC with binder | Within known science | HWD-CAL-001 |
| S2 | D1: one matched tablet gives about 2 mg/L free chlorine (1 L tablet in 1 L, or 20 L tablet in 20 L; 1.6 mg/L in 25 L) | Mathematics | Units and dimensional analysis | Dose = available chlorine / volume; household tablet doses (IFRC tablet-choice note: 67 mg per 20 to 25 L) | 1.6 mg/L >= 1 mg/L | Within known science | HWD-CAL-001 |
| S3 | The double dose for settled turbid water (two tablets, 4.0 mg/L) stays at or below the WHO chlorine guideline value of 5 mg/L in the containers on the label (1 to 1.5 L, 20 L) | Chemistry | Environmental and atmospheric chemistry | WHO guideline value 5 mg/L (WHO chlorine fact sheet 2022); IFRC: double dose if visibly turbid; bottle range from S42 | 4 mg/L <= 5 mg/L | Within known science | HWD-CAL-001 |
| S4 | Free chlorine after 30 minutes stays at or above the WHO 0.5 mg/L for clear water (under 5 NTU) at the single dose (1.7 mg/L) | Chemistry | Physical chemistry | WHO GDWQ: at least 0.5 mg/L after 30 min at pH under 8 (via WEDC Mobile Note 7); residual model with assumed demand 0.3 mg/L | Passes while the 30 minute demand is under 1.5 mg/L; demand is assumed, and Wu and Dorea (2020) measured up to 4 mg/L over 24 h in jerrycans, so real demand is measured (HWP-VER-001 TJ) | Plausible, to confirm at TRL 3 | Open |
| S5 | A residual remains for a day of storage before filtering: 0.75 mg/L (clear) and 0.58 mg/L (turbid, double dose) at 24 h | Chemistry | Physical chemistry | CDC Safe Water System: above 0.2 mg/L at 24 h (Lantagne 2006); first-order decay after the 30 min demand, k assumed 0.035 and 0.07 per hour | 24 h consumption 1.3 and 3.4 mg/L, inside the 0.5 to 4 mg/L measured in 20 L jerrycans (Wu and Dorea 2020); at the top of that range the single dose leaves none; the residual matters only until the water is filtered (S16); real demand to measure (HWP-VER-001 TJ, TD) | Plausible, to confirm at TRL 3 | Open |
| S6 | A single dose in turbid water keeps a residual for 24 h (it falls to 0.19 mg/L) | Chemistry | Physical chemistry | Same model with turbid demand 1.0 mg/L in 30 min; CDC 0.2 mg/L at 24 h; IFRC: under 5 NTU for proper disinfection, above 50 NTU do not chlorinate | Failed as briefed (one tablet for all water). Fixed (F1): settle first and use two tablets for 5 to 50 NTU, do not use above 50 NTU; the double dose leaves 0.58 mg/L at 24 h on an assumed 1.0 mg/L demand; demand at 10, 25 and 50 NTU to measure (TJ) | Plausible, to confirm at TRL 3 | HWD-DEC-001 F1 |
| S7 | Water dosed for 30 minutes stays under the CDC 2.0 mg/L acceptability limit at 1 h when clear (1.67 mg/L), but not at the turbid double dose (2.90 mg/L) | Biology | Human physiology and biomechanics | CDC SWS 2.0 mg/L at 1 h; median taste detection 0.73 and acceptability 1.26 mg/L for NaDCC (Crider et al. 2018) | Most users will taste chlorine before filtering; the carbon stages of A to C are intended to remove it, so water is drunk only after the filter; taste after the filter is measured (TG, TH) | Plausible, to confirm at TRL 3 | Open |
| S8 | In 30 minutes clear water at the single dose reaches the CT for 4-log virus inactivation at 5 C (CT 51 against 8 mg min/L) | Biology | Microbiology | US EPA CT table for 4-log virus inactivation by free chlorine, pH 6 to 9 (Hepatitis A data with a safety factor of 3); CT = residual at the end of contact x time (EPA definition; the integral gives 53) | 51 mg min/L >= 8 mg min/L | Within known science | HWD-CAL-001 |
| S9 | No 4-log virus credit is taken above 5 NTU: the misuse case (turbid water, single dose) reaches CT 30 in 30 minutes, but the EPA table assumes low-turbidity water | Biology | Microbiology | As S8, demand 1.0 mg/L in 30 min; particle-associated viruses are shielded from chlorine, so the CT table is not applied to 5 to 50 NTU water (IFRC: under 5 NTU for proper disinfection) | The misuse case is not credited; settled turbid water at the double dose is credited only after the TB challenge at 10 and 50 NTU (HWP-VER-001 TB) | Within known science | HWD-CAL-001 |
| S10 | No quantified norovirus claim is made; free chlorine at the household dose is expected to act on human norovirus, but the data are not drinking-water infectivity data | Biology | Microbiology | Dunkin et al. 2017: 2-log molecular (RT-qPCR) reduction of norovirus GII at CT 7.5 to 13 in produce wash water; no 4-log infectivity data for human norovirus in drinking water | CT 51 is 3.9 times the 2-log molecular figure, which is a different measure from infectivity; virus reduction for the combined system is measured, never assumed (HWP-VER-001 TB) | Plausible, to confirm at TRL 3 | Open |
| S11 | Cold water gets a longer wait: 30 min above 18 C, 60 min at 10 to 18 C, 120 min below 10 C | Biology | Microbiology | US EPA CT rises from 3 (20 C) to 12 mg min/L (0.5 C); WHO and WEDC TN 11: 30 minutes at 18 C and above; the 60 and 120 minute tiers are practice guidance (Akvopedia NaDCC page, revision of the page) | Already at 30 min the CT is 4.2 times the 0.5 C requirement, so the longer cold waits are a conservative margin, not the basis of the virus check; at 120 min the CT is 194, 16 times | Within known science | HWD-CAL-001 |
| S12 | Disinfection weakens as pH rises (HOCl share 55% at pH 7.5, 28% at 8.0 at 20 C; 15% at pH 8.5 and 5 C); pH above 8 takes 60 minutes and pH above 9 is excluded | Chemistry | Physical chemistry | HOCl pKa by temperature (Morris 1966): 7.54 at 25 C, 7.58 at 20 C, 7.75 at 5 C; EPA CT table applies to pH 6 to 9 and jumps from 8 to 60 at pH 10; Akvopedia: unreliable above pH 9 | The check uses the EPA table directly (CT 51 against 8 at pH 6 to 9); HOCl weighting is not applied on top because the table already covers pH; the 60 minute rule above pH 8 is extra margin; field pH to record (TD), source suitability by class (HWP-SRC-001) | Within known science | HWD-CAL-001 |
| S13 | Chlorine does not inactivate Cryptosporidium at household doses, so the filter (A to C) is still needed | Biology | Microbiology | CDC chlorine timetable: about 15,300 min at 1 mg/L, pH 7.5, 25 C; Akvopedia; HWP-CLM-001 | At 1.7 mg/L the CT would take about 6 days; D makes no claim against Cryptosporidium | Within known science | HWD-CAL-001 |
| S14 | Giardia is not claimed from chlorine at 30 minutes; the filter is the barrier for cysts | Biology | Microbiology | CDC timetable: Giardia about 45 min at 1 mg/L, pH 7.5, 25 C | CT 51 against 45: margin 1.13 at 25 C, and the cold-water Giardia CT is several times higher, so no claim is made | Within known science | HWD-CAL-001 |
| S15 | Chlorination is only for water under 50 NTU, and settled water does best (under 5 NTU) | Chemistry | Environmental and atmospheric chemistry | IFRC tablet-choice note: 0 to 5 NTU low, 5 to 50 NTU high, above 50 NTU do not chlorinate; particles shield microbes and add demand | Pictogram: cloudy water, let it settle and pour off, use two tablets; muddy water, do not use D alone (HWP-SRC-001 SC3, SC6); users cannot measure NTU, so the pictogram's see-through test is checked by persona (TH) | Within known science | HWD-CAL-001 |
| S16 | Where the household stores filtered water (solution C), a chlorine residual remains to protect it, because C has no carbon stage; A and B are drunk at once | Chemistry | Physical chemistry | CDC SWS: residual above 0.2 mg/L at 24 h is for protection in storage; granular carbon removes free chlorine fast (HWP-CLM-001 sequence: chlorinate, wait, filter, carbon removes taste) | Fixed: C is carbon-free (HWC-DEC-001 D3), so the residual reaches C's closed clean bucket; A and B keep their carbon and no residual is claimed for them (on-product wording, HWP-CLM-001). The residual at 24 h in C is confirmed in test TJ at TRL 4 | Within known science | Fix: HWD-DEC-001 D3 and HWC-DEC-001 D3 (Amish, 2026-11-11) |
| S17 | A few mg/L of free chlorine ahead of the filter does not harm the hollow-fibre modules of A to C | Chemistry | Materials and polymer chemistry | PVDF and PES hollow fibres are commonly cleaned with hypochlorite; tolerance is given by makers as a chlorine exposure in mg h/L, commonly 1e5 to 1e6 | Even with the fibres soaked in dosed water all year the exposure is about 14,900 mg h/L; the bought module's limit and flux on chlorinated feed are confirmed with the supplier and over 100 L (HWD-DEC-001 C3) | Plausible, to confirm at TRL 3 | Open |
| S18 | The carbon stages of A to C remove the dosed chlorine taste over their life (B: about 7 g of carbon against about 1.7 mg/L x 150 L = 0.26 g of chlorine) | Chemistry | Physical chemistry | Carbon reduces free chlorine by surface reaction; NSF/ANSI 42 chlorine reduction is the reference test | Total capacity is not the limit: 7 g is about 15 mL of bed, a contact time of a few seconds at B's flow, so breakthrough at the real flow and over the module's life in litres is measured (HWP-VER-001 TG) | Plausible, to confirm at TRL 3 | Open |
| S19 | By-products stay low: cyanuric acid from NaDCC at the double dose is about 4.1 mg/L against the WHO 40 mg/L; THMs from household chlorination have been found below WHO guideline values | Chemistry | Environmental and atmospheric chemistry | WHO NaDCC fact sheet (NaDCC 50 mg/L, cyanuric acid 40 mg/L); Lantagne et al. 2008 as summarised by Akvopedia; WHO GDWQ THM guideline values | Cyanuric acid holds by arithmetic; THMs at the double dose in organic-rich settled water are the case the field data do not cover, so THMs are measured (TG) | Plausible, to confirm at TRL 3 | Open |
| S20 | A 20 L tablet cannot enter the blue 1 L well (13 mm tablet against a 9.5 mm bore); it would give 40 mg/L chlorine and 67 mg/L NaDCC in a bottle | Engineering and technology | Manufacturing tolerances | WHO guideline values 5 mg/L chlorine and 50 mg/L NaDCC; keyed well bores 9.5 mm (1 L) and 14.5 mm (20 L) against assumed tablet sizes 8 and 13 mm | Fixed as briefed (F2, colour-keyed inserts); the key blocks the well only, so a 20 L tablet dropped straight into an open bottle neck is a misuse the cap cannot stop: the 20 L tablets ship only in the household kit, strips are matched to the insert colours where the supplier allows, and the label warns (HWD-RSK-001); tablet sizes are measured before the bores are frozen (C1) | Plausible, to confirm at TRL 3 | HWD-DEC-001 F2, C1 |
| S21 | No more than two tablets fit in the well, so the dose cannot pass the 5 mg/L guideline value (three 1 L tablets would give 6 mg/L) | Engineering and technology | Manufacturing tolerances | Free height under the plug stop 8.0 mm (1 L) and 11.0 mm (20 L) against tablets 3.5 and 5.0 mm thick (assumed) | Two fit (7.0 under 8.0 mm); three are stopped only while each tablet is thicker than 2.67 mm (1 L) or 3.67 mm (20 L); the minimum thickness is measured (C1) and the plug stop set from it; broken tablets are a misuse on the label | Plausible, to confirm at TRL 3 | HWD-DEC-001 F3, C1 |
| S22 | The ball timer works in the Stokes regime: a 2 mm steel ball in about 548,000 cSt silicone falls 13 mm in about 45 min at 25 C | Physics | Fluid mechanics | Stokes drag with the Haberman-Sayre wall factor 0.1704 at d/D = 0.5 (Faxen, 0.1796, is not valid there); fluid 534 Pa s; PMX-200 type grades exist to 600,000 cSt | 1.75835e-08 Reynolds number <= 0.1 Reynolds number | Within known science | HWD-CAL-001 |
| S23 | The timer never reads less than 30 minutes up to 40 C air temperature (nominal 45 min at 25 C; 30.3 min at 40 C and -10 % viscosity) | Engineering and technology | Manufacturing tolerances | Fall time scales with viscosity; viscosity tolerance assumed 10 %; activation energy 15 kJ/mol; the briefed 34 min nominal read 23 min at 40 C | 30.3 min >= 30 min | Within known science | HWD-DEC-001 F11 |
| S24 | In cold water the user runs the timer twice (10 to 18 C) or three times (under 10 C); the timer itself slows about 1.38 times at 10 C | Physics | Thermodynamics | Silicone viscosity-temperature coefficient 0.61 (Dow PMX-200), which back-calculates to the assumed 15 kJ/mol; contact times as S11 | Low-tolerance totals at the warm end of each band: 94 min (two runs at 18 C, need 60) and 167 min (three runs at 10 C, need 120). Failed as briefed (one run for all water); fixed by the run count on the label (F4, revised to one, two, three by F11). The user judges water temperature by feel; that is checked by persona (TH) | Within known science | HWD-DEC-001 F4, F11 |
| S25 | The 1 L tablet dissolves fully in the well when the bottle is turned over and shaken, and the clear plug shows it has gone | Chemistry | Physical chemistry | NaDCC household tablets are effervescent; floor slots let raw water flood the well when inverted; the CO2 vents through the slots | Dissolution time in the well at 5 and 30 C to measure (TJ); the pictogram says shake until the tablet has gone, then start the timer; the 20 L route cannot be inverted and is S41 | Plausible, to confirm at TRL 3 | Open |
| S26 | The well insert O-ring is squeezed within the static-seal range in the 20.4 mm bore over the stated tolerances (15.1 to 28.0 %, nominal 21.9 %) | Engineering and technology | Manufacturing tolerances | Static radial gland: squeeze 15 to 30 %; groove root 17.9 mm; bore +/-0.05 mm, groove +/-0.03 mm, section 1.6 +/-0.08 mm (ISO 3601 class); stretch 4.1 % | Failed as briefed twice: root 17.2 gave 0 %, and root 17.8 at print tolerance (+/-0.1 mm) gave 7.9 % at the low end. Fixed (F5, F10): root 17.9 mm, the bore and groove held to the stated tolerances (moulded at scale; the prototype insert is measured and reprinted to the gauge) | Within known science | HWD-DEC-001 F5, F10 |
| S27 | The cap screws onto the same 28 mm PCO 1881 neck as the B cartridge and onto the 28 mm port in C's raw-bucket lid (HWD-DEC-001 D4) | Engineering and technology | Standards practice | PCO 1881 neck data (Kapy CAD), as used in HWB-CAL-001; C's lid port is a proposal to solution C | The bottle neck interface follows HWB; the C port is not yet agreed, so the row stays open until the interface is agreed (HWD-DEC-001 D4) | Plausible, to confirm at TRL 3 | Open |
| S28 | Every wetted material resists dilute chlorine and the tablet concentrate in the well, and is available in a drinking-water listed grade (PP, silicone, EPDM, PETG) | Chemistry | Materials and polymer chemistry | NSF/ANSI/CAN 61 (HWP-REG-001 W7); polyolefins and EPDM resist dilute hypochlorite; PC is prone to stress cracking in alkaline hypochlorite | While a tablet dissolves the well briefly holds about 0.0 g/L (1 L) to 0.0 g/L (20 L) of chlorine; the clear plug is PETG or clarified PP, not PC (F12); printed prototype grades are not listed, so prototypes see known potable test water only; concentrate soak and leachables to test (TG) | Plausible, to confirm at TRL 3 | Open |
| S29 | Tablets keep 3 to 5 years in their strips; the cap stores no tablets loose | Chemistry | Inorganic | Akvopedia: strips 5 years, tubs 3 years; humidity degrades NaDCC once the foil is open | One tablet is taken from the strip per use; spare strips ride in the kit, not in the cap | Within known science | HWD-CAL-001 |
| S30 | Freezing and heat do not damage the tablets or the timer, and a frozen bottle is thawed before dosing | Physics | Thermodynamics | Water expands about 9 % on freezing; PDMS stays liquid far below 0 C and expands 9.6e-04 per K (Dow PMX-200) | Water left in the well could crack the clear plug if frozen: empty the cap in freezing weather. The sealed timer holds 0.188 mL; from a 25 C fill its fluid changes by -6.3 to +6.3 uL over -10 to 60 C (3.4%), enough to load the end caps or open a bubble; an expansion allowance is to be detailed and a freeze-thaw and 60 C fall-time test run (C5, TI) | Plausible, to confirm at TRL 3 | Open |
| S31 | A child or an older user can open a foil strip, drop a tablet in, turn the plug (3.5 turns) and flip the timer the counted number of times | Biology | Ergonomics | Low-dexterity users struggle with small parts and caps (HWP-PRB-001 personas) | To observe by persona (HWP-VER-001 TH) with pass criteria: dose done in under 2 minutes, no tablet dropped, the right run count chosen; a strip with a tear notch and a 27 mm knurled plug are specified | Plausible, to confirm at TRL 3 | Open |
| S32 | D1 weighs under 60 g without the bottle (45 g, model volumes) | Mathematics | Units and dimensional analysis | Model volumes x densities (cad_parts.MATERIALS), per part in cad/fidelity.json | 44.8 g <= 60 g | Within known science | HWD-CAL-001 |
| S33 | CDC SWS arithmetic: 3 mL of 1.25 % hypochlorite in 20 L is about 1.9 mg/L | Mathematics | Units and dimensional analysis | 1.25 % = 12.5 g/L = 12.5 mg/mL; 3 mL x 12.5 mg/mL / 20 L | claimed 1.875 mg/L, estimate 1.88 mg/L (ratio 1.00) | Within known science | HWD-CAL-001 |
| S34 | D1 prototype parts and test tablets cost under the USD 10 value-engineering target (USD 9.15) | Engineering and technology | Standards practice | BOM sum (bom/bom.csv); estimates, not quotes | 9.15 USD <= 10 USD | Within known science | HWD-CAL-001 |
| S35 | D2: the metering chamber holds 3.01 mL below the standpipe top, within 5 % of the CDC 3.0 mL dose for 20 L | Mathematics | Units and dimensional analysis | Annulus area (18 mm chamber, 5 mm standpipe) x 12.8 mm standpipe height; tilt and wall film are not modelled and the dose is weighed at TRL 4 | 0.006 mL from 3.0 <= 0.15 mL from 3.0 | Within known science | HWD-CAL-001 |
| S36 | D2: 5 drops from a 2.0 mm orifice treat 1 L at 1.7 to 2.1 mg/L | Physics | Fluid mechanics | Tate's law with the Harkins-Brown factor 0.60 to 0.72; LDPE does not wet, so the drop pins at the orifice: 0.0277 to 0.0332 mL per drop | Failed as briefed: three drops from a 1.2 mm orifice give 0.62 to 0.75 mg/L, under 1. Fixed (F9): 2.0 mm orifice and five drops; drops weighed gravimetrically at TRL 4; a squeezed stream is the misuse on the label | Plausible, to confirm at TRL 3 | HWD-DEC-001 F9 |
| S37 | D2: the liquid loses strength over its shelf life (a warm-storage bound gives 56% after 3 months, so one cap gives 1.0 mg/L, and 0.58 mg/L at 6 months) | Chemistry | Physical chemistry | WEDC: half strength in a year when cool and dark; E4C WaterGuard: 13 % to 8 % in 75 days at 27 C (a bound for 1.25 %); Akvopedia: use within 3 months | Under-dosing as the liquid ages is a silent failure the user cannot see; D2 would need a date stamp, a 3 month use-by and a two-cap rule after 2 months (scored in HWD-OPT-001) | Plausible, to confirm at TRL 3 | Open |
| S38 | D2: a gentle squeeze lifts the liquid into the chamber (about 1.8 kPa) well within a weak child's grip | Biology | Human physiology and biomechanics | Hydrostatic lift of 134 mm plus 0.5 kPa entry loss; grip 124 N weak child (Camry norms, as HWB-CAL-001); squeeze force assumed 10 N | 10 N <= 49.6 N | Within known science | HWD-CAL-001 |
| S39 | D2: 1.25 % hypochlorite is an irritant, not a corrosive at that strength, and is kept behind a child-resistant flip cap | Biology | Toxicology | CDC SWS uses 1.25 % for household distribution; under CLP generic limits 1 to 5 % of a Skin Corr. 1B substance classes as Skin Irrit. 2 and Eye Irrit. 2 | Hazard handled in HWD-RSK-001 (eye splash at pH about 12, child access); D1 tablets carry a do-not-swallow warning on the strip (IFRC) | Within known science | HWD-CAL-001 |
| S40 | A 1 L tablet put in the orange 20 L well by mistake is noticed (it would give 0.1 mg/L, two give 0.2 mg/L) | Engineering and technology | Manufacturing tolerances | An 8 mm tablet passes a 14.5 mm bore; the key works one way only; WHO 0.5 mg/L after 30 min | A silent under-dose: mitigated by actual-size tablet circles on the label next to each insert, the clear plug, and 20 L tablets packed only with the household kit; a free chlorine check after the wait would catch it (D7); misuse trial (TH) | Plausible, to confirm at TRL 3 | Open |
| S41 | On C's bucket port the 20 L tablet dissolves and mixes through the 20 L without turning the bucket over | Physics | Fluid mechanics | A 20 kg bucket cannot be inverted and shaken; a dissolved dose entering at the surface mixes slowly without stirring | Failed as briefed (the inversion method was written for bottles). Fixed (F7): on the bucket the plug is taken off and raw water is poured through the well from a cup until the tablet has gone, then the bucket is stirred for 30 s with a clean stick before the timer starts; free chlorine at top and bottom after 1 and 5 minutes within 20 % of the mean (TJ); the simpler drop-in-before-filling method is put to Amish under D4 | Plausible, to confirm at TRL 3 | HWD-DEC-001 F7, D4 |
| S42 | The 1 L tablet is used only in bottles of 1 to 1.5 L, so a clear single dose gives at least 1.33 mg/L and a double dose at most 4.0 mg/L | Mathematics | Units and dimensional analysis | Dose = 2 mg / volume: 0.5 L gives 4.0 and 8.0 mg/L (double over 5); 2 L gives 1.0 mg/L; range printed on the blue insert label (F8) | 4 mg/L <= 5 mg/L | Within known science | HWD-DEC-001 F8 |
| S43 | A wrong, missing, weak or undissolved dose is made visible by a free chlorine check after the wait (test strips in the household kit, a comparator for partners) | Engineering and technology | Sensing resolution | Free chlorine is invisible; the clear plug shows only that the tablet has gone; DPD test strips or a comparator read 0.2 mg/L and above | Fixed: DPD free chlorine strips in each household kit, used after the wait on every new source and every tenth batch (target at least 0.5 mg/L); a comparator for programme staff. The strip cost is to assess | Within known science | Fix: HWD-DEC-001 D7 (Amish, 2026-11-11) |
<!-- /STM_TABLE -->

Verdicts: **Within known science**, **Plausible, to confirm at TRL 3**, **Fails, fix proposed**, **Fails**.

## Water checks of STANDARDS 25.6

Table 2. Where each required water check is answered.

| Check | Rows | Result in one line |
| --- | --- | --- |
| Membrane flux against the pressure available | Not applicable | D has no membrane; it adds no pressure drop to A to C because the tablet is dissolved before the water reaches them |
| Pressure drop per stage | Not applicable | As above; the D2 squeeze needs about 1.8 kPa to lift liquid into the chamber (S38) |
| Flow at the persona efforts | S31, S38, S41 | D has no flow; the persona efforts are opening a foil strip, turning a plug 3.5 turns, flipping the timer up to three times, pouring and stirring on the bucket and squeezing a dropper bottle (10 N against a weak child's 124 N grip) |
| Pore or MWCO against organism size | S13, S14 | Not a size barrier; chlorine addresses viruses and bacteria by CT, while cysts depend on the A to C membranes |
| Carbon contact time and bed mass | S18 | D adds about 0.26 g of chlorine to B's 7 g carbon over an assumed 150 L; the limit is the few seconds of contact at B's flow, so breakthrough is measured (TG) |
| Disinfection dose and CT | S1 to S12, S33, S35 to S37, S41, S42 | 2.0 mg/L (4.0 turbid, settled); 1.7 mg/L at 30 min; CT 51 (EPA definition) against 8 (4-log virus, 5 C); no credit above 5 NTU; bottles 1 to 1.5 L; the bucket stirred; cold and high-pH rules |
| Residual against WHO values and by-products | S3 to S7, S19 | Never above 5 mg/L; 0.75 mg/L at 24 h (clear, assumed decay); cyanuric acid 4.1 against 40 mg/L |
| Integrity and silent failure | S6, S16, S20, S21, S23 to S25, S37, S40, S41, S43 | Wrong tablet either way, too many tablets, undissolved or unmixed tablet, a hot or cold timer, aged liquid, no residual after carbon, and no field check (D7) |
| Biofilm downstream of the membrane | S16, S17 | Chlorine reaches A to C's dirty side only; after carbon the water has no residual and the carbon bed itself has no chlorine to hold back growth (D3) |
| Materials leaching | S28 | PP, silicone, EPDM and PETG in listed grades; the well briefly holds 3.5 to 22 g/L while a tablet dissolves, so no PC (F12); printed prototypes not listed |
| Freezing | S30 | Tablets unaffected; empty the well in freezing weather; the sealed timer fluid changes volume 3.4 % over -10 to 60 C, so its expansion allowance is open (C5) |

## Fields not relevant

- Electromagnetism, optics and nuclear radiation: no power, light source or radiation (UV is excluded from the program, HWP-PRB-001).
- Electrochemistry: no electrodes; on-site electrochlorination is out of scope.
- Ecology and agronomy: no living material is used; disposal of foil strips and spent parts is covered in HWD-RSK-001 and HWD-MKT-001.

## Concept options

- **D1 tablet dose cap:** no Fails row. S6, S20, S21, S24 and S26 failed as briefed and were fixed (F1 to F5), with a timer margin (F6); the independent review led to F7 to F12. Open: Plausible rows S4 to S7, S10, S17 to S21, S25, S27, S28, S30, S31, S40 and S41 (laboratory, supplier, tablet-size and persona checks); S16 and S43 sent to Amish (D3, D7).
- **D2 metered liquid doser:** no Fails row. Its own open rows are S36 (drop size, fixed by a 2.0 mm orifice and five drops, F9) and S37 (liquid strength falls with age and heat, an under-dose the user cannot see), which is why it scores below D1 (HWD-OPT-001).
- **D3 erosion feeder:** **Fails** on its working principle (X1, X2): a release set by contact time gives a dose that grows with standing time, so a feeder sized for 2 mg/L in 30 minutes reaches about 96 mg/L overnight, and one sized not to exceed 5 mg/L overnight gives 0.1 mg/L at 30 minutes. TCCA pool tablets add a nitrogen trichloride hazard (X3). Dropped.

Table 3. Claims of the dropped option D3 (from `docs/04-calcs/stem_results_dropped.csv`).

<!-- STM_DROPPED -->
| # | Claim | Field | Branch | Governing law or source | First-order check | Verdict | Closed by |
| --- | --- | --- | --- | --- | --- | --- | --- |
| X1 | D3: an erosion feeder in the raw bucket holds the dose between 1 and 5 mg/L for standing times of 30 minutes to a day | Chemistry | Physical chemistry | A release set by contact time gives dose proportional to standing time (TAMU tablet chlorination guide: dissolution depends on contact amount and time) | 48 ratio of longest to shortest standing time <= 5 ratio of longest to shortest standing time | Fails (option dropped) | Option dropped |
| X2 | D3: left overnight at a rate that gives 2 mg/L in 30 min the bucket reaches about 96 mg/L | Chemistry | Environmental and atmospheric chemistry | Dose = rate x time / volume; WHO guideline value 5 mg/L | Set instead for 5 mg/L at 24 h, the 30 minute dose is 0.10 mg/L, far below 0.5 | Fails (option dropped) | Option dropped |
| X3 | D3: TCCA pool tablets release chlorine slowly and safely in a wetted feeder | Chemistry | Inorganic | TAMU: TCCA not approved for tablet chlorinators, too slow, and repeated wetting can form explosive nitrogen trichloride; never mix with calcium hypochlorite | Hazard as well as range; calcium hypochlorite erosion feeders work only in flowing water | Fails (option dropped) | Option dropped |
| X4 | D3: the household can see when the feeder is spent or over-dosing | Engineering and technology | Sensing resolution | No dose indication without a chlorine test | Fails: no dose indication without a chlorine test, so under- or over-dose is silent; the option is dropped on X1 | Fails (option dropped) | Option dropped |
<!-- /STM_DROPPED -->

## Independent review

**Method.** On 2026-11-11 a second agent (Claude, run with the `claude -p` command line as a separate process) was given only the claims tables (`stem_results.csv`, `stem_results_dropped.csv`), `stem_check.py`, `sizing.py` with `sizing_results.json`, the PARAMS block of `cad/src/model.py` and the source list, in a folder of its own, with no access to this document's reasoning, the BOM or the CAD. It was asked to try to refute every "Within known science" and "Plausible" verdict, to default to refuted or weak when unsure, to recompute every number and unit, to check the cited sources, and to look for claims the check missed under the water checks of STANDARDS 25.6. It recomputed the numbers in Python and confirmed the EPA CT table and Dunkin et al. against their sources; the Akvopedia page refused it (HTTP 403). Every finding was then recomputed here before anything changed.

**Counts.** Of the 43 rows (S1 to S39, X1 to X4): **20 hold, 18 weak, 5 refuted**. Refuted: S20, S23, S25, S36, X4. Weak: S4, S5, S6, S9, S10, S11, S12, S18, S19, S21, S26, S27, S28, S30, S31, S32, S34, S37. S32 and S34 were weak only because the CAD and BOM were outside the reviewer's folder; both were rechecked here from `cad/fidelity.json` and `bom/bom.csv` and hold (44.8 g, USD 9.15). The reviewer's suggested groove root for S26 (17.6 mm) would lower the squeeze; the fix goes the other way (17.9 mm).

Table 4. Independent review findings and changes.

| Row | Finding | Change made |
| --- | --- | --- |
| S20 | Refuted: the key blocks the well only; a 20 L tablet dropped straight into an open neck still gives 40 mg/L | Claim restated ("cannot enter the 1 L well"); Plausible until tablets are measured (C1); 20 L tablets only in the household kit; label and RSK |
| S23 | Refuted: the timer runs at air temperature; 34 minutes nominal read 23 minutes at 40 C at the low tolerance | Fix F11: 45 minute nominal, 30.3 minutes at 40 C; row now a numeric check |
| S25 | Refuted for 20 L: a bucket cannot be inverted, so the well never floods and the dose does not mix | Fix F7 (pour through the well, stir 30 s); new row S41; the bucket method also put to Amish under D4 |
| S36 | Refuted: Tate's law for a non-wetting 1.2 mm orifice gives 0.017 to 0.020 mL drops, 0.6 to 0.7 mg/L for three drops | Fix F9: 2.0 mm orifice, five drops, 1.7 to 2.1 mg/L |
| X4 | Refuted: the check itself says there is no indication | Verdict Fails (option already dropped) |
| S26 | Weak: 19 % nominal but 8 % at print tolerance | Fix F10: groove root 17.9 mm with stated tolerances, 15.1 to 28.0 % |
| S28 | Weak: the dissolving tablet makes a concentrate in the well; PC cracks in hypochlorite | Fix F12: no PC; concentrate soak in TG |
| S3 | Holds, but a 0.5 L bottle with two tablets reaches 8 mg/L | Fix F8: bottle range on the label; new row S42 |
| S8 | Holds; CT should be C at the end x T (51), not the integral (53) | Method changed in `sizing.py`; all CT figures restated |
| S9 | Weak: the CT table assumes low-turbidity water | Claim restated: no virus credit above 5 NTU |
| S10 | Weak: the norovirus figure is molecular and for wash water | Claim restated: no quantified norovirus claim |
| S11 | Weak: the cold tiers rest on an older Akvopedia revision | Row rests on the EPA CT (4.3 times the 0.5 C value at 30 minutes); tiers kept as a conservative margin |
| S12 | Weak: pKa is the 25 C value; HOCl weighting double counts pH | Morris pKa by temperature; EPA table used directly |
| S4, S6, S19, S21, S27 | Weak: rest on assumed demand, tablet thickness, high-organic THMs or an unagreed interface | Made Plausible with the test or decision that closes each |
| S24 | Holds; four flips below 10 C is a burden | Run count now one, two, three (F11) |
| S5, S17, S18, S30, S31, S35, S37, S39 | Weak or holds with notes: residual matters only before filtering; membranes soak continuously (14,900 mg h/L a year); carbon contact time, not capacity, limits; timer fluid expansion 3.4 %; persona criteria; a lower bound on the chamber; D2 strength at 6 months; CLP class | Reworded with the numbers; C5 added for the timer expansion |

Missed claims raised by the reviewer and added: a 1 L tablet in the 20 L well gives 0.1 mg/L (S40); mixing in 20 L (S41); the bottle range (S42); no field check of the residual, so every dose error is silent (S43, fixed: test strips in the kit, HWD-DEC-001 D7, decided by Amish on 2026-11-11); bacterial growth in the carbon bed with no residual (added to S16 and D3); timer fluid expansion and filling (S30, C5); the water temperature is judged by feel (S24, TH). Flux, pressure drop and pore size belong to A to C; D's only effect on them, flux on chlorinated feed, is added to S17.

## Sources

- Akvopedia. "Chlorine (NaDCC)." https://akvopedia.org/wiki/Chlorine_(NaDCC) (checked 2026-11-11). Contact times by temperature and pH, inlet pH 5.5 to 7.5, unreliable above pH 9, shelf life of strips (5 years), tubs (3 years) and liquid (3 months), cost, Lantagne et al. 2008 on THMs.
- International Federation of Red Cross and Red Crescent Societies. *Chlorine Tablet Choice in Emergencies.* 2025. https://wash.ifrc.org/wp-content/uploads/2025/06/Chlorine-Tablet-Choice-in-Emergencies.pdf (checked 2026-11-11). Tablet sizes by volume, turbidity bands, point-of-use residual 0.2 to 1.0 mg/L.
- IFRC Items Catalogue. "Chlorine, NaDCC, household use (WASDCHLA01)." https://itemscatalogue.redcross.int/wash--5/water--29/water-treatment-products--124/chlorine-nadcc-household-use--WASDCHLA01.aspx (checked 2026-11-11). Chlorine per tablet: 2 mg (3.5 mg NaDCC), 20 mg (33 mg), 40 mg (67 mg), 100 mg (167 mg).
- Lantagne, Daniele. "Engineering Inputs to the CDC Safe Water System Program." In *Frontiers of Engineering: Reports on Leading-Edge Engineering from the 2005 Symposium*. National Academies Press, 2006. https://www.nationalacademies.org/read/11577/chapter/8 (checked 2026-11-11). 1.25 % hypochlorite, 3 mL cap per 20 L, two caps for turbid water, below 2.0 mg/L at 1 h and above 0.2 mg/L at 24 h.
- WEDC. "Chlorination of Drinking Water," Mobile Note 7, quoting WHO GDWQ (2004, p. 194). https://wedc-knowledge.lboro.ac.uk/resources/e/mn/007-Chlorination.pdf (checked 2026-11-11). At least 0.5 mg/L free chlorine after 30 minutes at pH under 8; hypochlorite can lose half its strength in a year.
- WHO and WEDC. "Measuring Chlorine Levels in Water Supplies," Technical Note 11, 2013. https://wedc-knowledge.lboro.ac.uk/resources/who_notes/WHO_TNE_11_Measuring_chlorine_levels_in_water_supplies.pdf (checked 2026-11-11). 0.2 to 0.5 mg/L at the point of delivery; 30 minutes at 18 C and above; pH 6.8 to 7.2; turbidity under 5 NTU.
- World Health Organization. "Chlorine: Chemical Fact Sheet," 2022. https://cdn.who.int/media/docs/default-source/wash-documents/water-safety-and-quality/chemical-fact-sheets-2022/chlorine-fact-sheet-2022.pdf (checked 2026-11-11). Guideline value 5 mg/L.
- World Health Organization. "Sodium Dichloroisocyanurate: Chemical Fact Sheet." https://www.who.int/docs/default-source/wash-documents/wash-chemicals/sodium-dichloroisocyanurate-chemical-fact-sheet.pdf (checked 2026-11-11). NaDCC 50 mg/L, cyanuric acid 40 mg/L.
- California State Water Resources Control Board. "4-Log Virus Inactivation Through Chlorine Disinfection" (US EPA CT table). https://www.waterboards.ca.gov/drinking_water/programs/districts/docs/sonoma/120_4_log_virus_inactivation_through_cl2_disinfection.pdf (checked 2026-11-11). CT 12, 8, 6, 4, 3, 2 mg min/L at 0.5, 5, 10, 15, 20, 25 C, pH 6 to 9; 90 to 15 at pH 10.
- Centers for Disease Control and Prevention. "Chlorine Disinfection Timetable" (archived 2012). https://webarchive.library.unt.edu/web/20121007150718/http://www.cdc.gov/healthywater/swimming/pools/chlorine-disinfection-timetable.html (checked 2026-11-11). At 1 mg/L, pH 7.5, 25 C: E. coli O157:H7 under 1 min, hepatitis A about 16 min, Giardia about 45 min, Cryptosporidium about 15,300 min.
- Dunkin, Nathan, ShihChi Weng, Joseph G. Jacangelo and Kellogg J. Schwab. "Inactivation of Human Norovirus Genogroups I and II and Surrogates by Free Chlorine in Postharvest Leafy Green Wash Water." *Applied and Environmental Microbiology*, 2017. https://read.qxmd.com/read/28887415/inactivation-of-human-norovirus-genogroups-i-and-ii-and-surrogates-by-free-chlorine-in-postharvest-leafy-green-wash-water (checked 2026-11-11).
- Crider, Yoshika, Sonia Sultana, Leanne Unicomb, Jennifer Davis, Stephen P. Luby and Amy J. Pickering. "Can You Taste It? Taste Detection and Acceptability Thresholds for Chlorine Residual in Drinking Water in Dhaka, Bangladesh." *Science of the Total Environment* 613 to 614 (2018): 840 to 846. https://pesquisa.bvsalud.org/sms/resource/pt/mdl-28942317 (checked 2026-11-11).
- Wu, H., and C. C. Dorea. "Towards a Predictive Model for Initial Chlorine Dose in Humanitarian Emergencies." *Water* 12, no. 5 (2020): 1506. https://mdpi.com/2073-4441/12/5/1506 (checked 2026-11-11). 24 h chlorine consumption of 0.5 to 4 mg/L in 20 L jerrycans.
- Open Exam Prep. "Disinfection Chemistry, Chlorination Dynamics and CT Calculations." https://open-exam-prep.com/study-guides/or-water-operator/drinking-water-disinfection/disinfection-chemistry (checked 2026-11-11). HOCl pKa about 7.54; HOCl share by pH; HOCl 80 to 100 times more effective than OCl-.
- Texas A&M AgriLife. "Tablet Chlorination" (L-5344). https://ossf.tamu.edu/files/2023/01/L-5344-9.08-Tablet-chlorination.pdf (checked 2026-11-11). Erosion release depends on contact amount and time; TCCA hazards.
- Engineering for Change. "WaterGuard." https://www.engineeringforchange.org/solutions/product/waterguard/ (checked 2026-11-11). 150 mL of 1.25 %, USD 0.33 suggested retail, decay of a 13 % product at 27 C.
- Dow. "XIAMETER PMX-200 Silicone Fluids" data sheet. https://www.galindberg.se/storage/AC2B4499EE08763D9A209A5DE85530A61D7ECB8C1A3CFACD20215DDEB3938B48/d05ea6456215409586fe061ab5ae3127/pdf/media/ab7fe11104db4410b829991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 (checked 2026-11-11), and Knowde listing of the 600,000 cSt grade, https://www.knowde.com/stores/dow-north-america/products/xiameter-tm-pmx-200-silicone-fluid-600-000-cst (checked 2026-11-11).
- Kapy CAD. "PET Bottle Threads: PCO-1881 and PCO-1810." https://kapycad.com/en/academy/standards/pet-bottle-thread (checked 2026-11-11), as used in HWB-CAL-001.
- Morris, J. Carrell. "The Acid Ionization Constant of HOCl from 5 to 35 C." *Journal of Physical Chemistry* 70, no. 12 (1966): 3798 to 3805. https://doi.org/10.1021/j100884a007 (cited from the standard relation; not opened 2026-11-11).
- Haberman, W. L., and R. M. Sayre. *Motion of Rigid and Fluid Spheres in Stationary and Moving Liquids Inside Cylindrical Tubes.* David Taylor Model Basin Report 1143, 1958 (wall factor; not opened 2026-11-11).
- Harkins, William D., and F. E. Brown. "The Determination of Surface Tension and the Weight of Falling Drops." *Journal of the American Chemical Society* 41, no. 4 (1919): 499 to 524. https://doi.org/10.1021/ja01461a003 (not opened 2026-11-11).
- European Union. Regulation (EC) No 1272/2008 (CLP), generic concentration limits for skin and eye classification, Annex I, section 3.2. https://eur-lex.europa.eu/eli/reg/2008/1272/oj (not opened 2026-11-11).
- Program documents: HWP-PRB-001, HWP-SRC-001, HWP-CLM-001, HWP-VER-001, HWP-REG-001.

Licence: this document is licensed under CC-BY-4.0 (Creative Commons Attribution 4.0 International), following the Helpful Engineering licensing guide. Design Molecule Labs with Helpful Engineering.
