BoujeeEnjinia1701/helpful-water/solutions/D-virus-add-on/docs/03b-traceability.md

---
doc_id: HWD-RTM-001
title: 'Helpful Water D: chlorine co-treatment add-on traceability matrix'
project: 'Helpful Water D: chlorine co-treatment add-on'
doc_type: Traceability matrix
version: '0.6'
status: Draft
date: '2026-11-11'
author: Amish Chadha
license: CC-BY-4.0
source_hash: 9555c5997b44725a
revisions:
- version: '0.1'
  date: '2026-11-11'
  author: Amish Chadha
  change: Generated by .kit/trace.py
- version: '0.2'
  date: '2026-11-11'
  author: Amish Chadha
  change: Generated by .kit/trace.py
- version: '0.3'
  date: '2026-11-11'
  author: Amish Chadha
  change: Generated by .kit/trace.py
- version: '0.4'
  date: '2026-11-11'
  author: Amish Chadha
  change: Generated by .kit/trace.py
- version: '0.5'
  date: '2026-11-11'
  author: Amish Chadha
  change: Generated by .kit/trace.py
- version: '0.6'
  date: '2026-11-11'
  author: Amish Chadha
  change: Generated by .kit/trace.py
---

# Helpful Water D: chlorine co-treatment add-on traceability matrix

Generated by `python .kit/trace.py` from the user requirements, product requirements, calculations, build plan and BOM. Do not edit by hand. 15 user requirements, 24 product requirements, 0 gaps.

Table 1. User requirement to product requirement to evidence to verification.

| User requirement | Product requirement | Title | Evidence | Verification | Status |
| --- | --- | --- | --- | --- | --- |
| UR-003 | PR-001 | Household dose | HWD-CAL-001, HWD-BLD-001 | Analysis (HWD-CAL-001 section 1), TRL 3; dose test (TJ), TRL 4 | Met on paper (2.0; 1.6 in 25 L) |
| UR-003 | PR-002 | Residual at 30 minutes | HWD-CAL-001, HWD-BLD-001 | Analysis (HWD-CAL-001 section 2), TRL 3; DPD residual at 30 and 60 min (TJ), TRL 4 | Met on paper (1.7, assumed demand) |
| UR-003 | PR-003 | CT for viruses | HWD-CAL-001 | Analysis (HWD-CAL-001 section 3), TRL 3; virus protocol for the combined system (TB), TRL 4 | Met on paper (53 in 30 min) |
| UR-003 | PR-004 | Claim wording | HWD-CAL-001 | Inspection of the artwork and documents, TRL 3 | Met by design |
| UR-011 | PR-005 | Maximum dose | HWD-CAL-001, HWD-BLD-001 | Analysis (HWD-CAL-001 section 6), TRL 3; TJ, TRL 4 | Met on paper (4.0 at two tablets) |
| UR-101 | PR-006 | Wrong tablet rejected | HWD-CAL-001, HWD-BLD-001 | Inspection with bought tablets (HWD-DEC-001 C1), TRL 4; human factors (TH), TRL 4 | Met by design (tablet sizes assumed) |
| UR-101 | PR-007 | Two-tablet limit | HWD-CAL-001, HWD-BLD-001 | Inspection of the model (HWD-DWG-002), TRL 3; TH, TRL 4 | Met by design (8.0 and 11.0 mm) |
| UR-102 | PR-008 | Timer run | HWD-CAL-001, HWD-BLD-001 | Analysis (HWD-CAL-001 section 5), TRL 3; fall-time check per fluid batch at 25 and 40 C (TH, TI), TRL 4 | To verify at TRL 4 (30.3 on paper) |
| UR-102 | PR-009 | Cold-water rule | HWD-CAL-001 | Inspection of the artwork, TRL 3; comprehension (TH), TRL 4 | Met by design |
| UR-104 | PR-010 | Turbid-water rule | HWD-CAL-001 | Inspection, TRL 3; comprehension (TH), TRL 4 | Met by design |
| UR-008 | PR-011 | See the tablet dissolve | HWD-CAL-001, HWD-BLD-001 | Inspection of the model, TRL 3; dissolution time in the well (TJ), TRL 4 | Met by design |
| UR-103 | PR-012 | Bottle neck fit | HWD-CAL-001, HWD-BLD-001 | Inspection against HWB-CAL-001 neck data, TRL 3; leak test inverted (TF), TRL 4 | Met by design |
| UR-103 | PR-013 | Order of use and residual | HWD-CAL-001 | Analysis (HWD-STM-001 S16), TRL 3 | At risk (no residual after carbon; HWD-DEC-001 D3) |
| UR-103 | PR-014 | C bucket interface | HWD-CAL-001 | Interface agreement with C (HWD-DEC-001 D4), TRL 3 | At risk (C design in progress) |
| UR-005 | PR-015 | Ready to use | HWD-CAL-001 | Inspection, TRL 3; TH, TRL 4 | Met by design |
| UR-006 | PR-016 | Pictograms | HWD-CAL-001, HWD-BLD-001 | Inspection, TRL 3; comprehension (TH), TRL 4 | To verify at TRL 4 |
| UR-011 | PR-017 | Wetted materials | HWD-CAL-001 | Supplier certificates, TRL 4; extractables (TG), TRL 4 | To verify at TRL 4 |
| UR-011 | PR-018 | By-products | HWD-CAL-001 | Analysis (HWD-CAL-001 section 6), TRL 3; TG, TRL 4 | Met on paper (4.1) |
| UR-014 | PR-019 | Cost | HWD-CAL-001 | Analysis (HWD-CAL-001 section 10, BOM), TRL 3 | Met on paper (USD 9.15) |
| UR-015 | PR-020 | Standard consumable | HWD-CAL-001 | Inspection of the BOM, TRL 3; partner kit check (C1), TRL 4 | Met by design |
| UR-016 | PR-021 | Storage | HWD-CAL-001 | Analysis of materials, TRL 3; ageing (TF), TRL 4 | To verify at TRL 4 |
| UR-018 | PR-022 | Taste after the filter | HWD-CAL-001 | Measurement after each filter (TG, TH), TRL 4 | To verify at TRL 4 |
| UR-021 | PR-023 | End of life | HWD-CAL-001 | Inspection, TRL 3 | Met by design |
| UR-022 | PR-024 | Regional manufacture | HWD-CAL-001 | Inspection of the BOM and build plan, TRL 3 | Met by design |

## Gaps

None.

Licence: this document is licensed under CC-BY-4.0 (Creative Commons Attribution 4.0 International), following the Helpful Engineering licensing guide. Design Molecule Labs with Helpful Engineering.
