BoujeeEnjinia1701/helpful-water/solutions/D-virus-add-on/docs/10-market.md

---
doc_id: HWD-MKT-001
title: "Helpful Water D: chlorine co-treatment add-on market and viability"
project: "Helpful Water D: chlorine co-treatment add-on"
doc_type: Market and viability
version: "0.1"
status: Draft
date: 2026-11-11
author: Amish Chadha
license: CC-BY-4.0
revisions:
  - version: "0.1"
    date: 2026-11-11
    author: Amish Chadha
    change: First market and viability note for D, citing HWP-MKT-001, with the D1 BOM cost and cost per litre over life
---

# Helpful Water D: chlorine co-treatment add-on market and viability

D does not compete with chlorine tablets; it makes the tablets NGOs already buy easier to use correctly with the A to C filters. Its value is in fewer dose and timing errors, not in cheaper chlorine, so it must stay cheap beside the tablets: an estimated USD 1.40 per cap at scale, against USD 0.0006 per litre of chlorine for a household dosing 20 L buckets. The market context, buyers and benchmarks of the program are in HWP-MKT-001 and are not repeated here. Prices checked 2026-11-11.

Table 1. Benchmarks for chlorine co-treatment.

| Product | Principle | Price (as listed) | Dose and wait | Source |
| --- | --- | --- | --- | --- |
| NaDCC household tablets (humanitarian) | Tablet per container | CHF 0.01 per tablet, pre-budget figure | 2 to 5 mg/L by tablet; 30 min | [IFRC catalogue](https://itemscatalogue.redcross.int/wash--5/water--29/water-treatment-products--124/chlorine-nadcc-household-use--WASDCHLA01.aspx) |
| NaDCC tablets, programme cost | Tablet per container | About USD 3 a year per household; USD 15 over 5 years | 30 min or more | [Akvopedia](https://akvopedia.org/wiki/Chlorine_(NaDCC)) |
| Aquatabs 8.5 mg, retail | Tablet per container (retail benchmark) | USD 10.99 for 50 | Up to 2 quarts per tablet; 30 min | [CampSaver](https://www.campsaver.com/aquatabs-water-purification-tablets.html) |
| WaterGuard (CDC SWS type) 1.25 % liquid | Cap per 20 L | USD 0.33 suggested retail per 150 mL | 3 mL per 20 L; 30 min | [Engineering for Change](https://www.engineeringforchange.org/solutions/product/waterguard/) |

Table 2. Segments (from HWP-MKT-001 Table 2, for D).

| Segment | Target users and region | Competitive benchmark | Estimated cost per unit | Value proposition |
| --- | --- | --- | --- | --- |
| Household point of use with C | Rural households, camps (where viral risk is known) | Tablets dropped in a bucket by eye | Prototype USD 5.95 (cap), scale about USD 1.40 | Right tablet for 20 L, a visible wait, then C filters cysts |
| Emergency kits with A or B | Disaster and displacement response | Tablets carried loose with the filter | As above | One cap that fits the bottle B screws onto; no watch needed |
| Programmes already using SWS liquid | Countries with local hypochlorite | Cap-measure of liquid | D2 head (not carried) | Ball timer as a clip (runner-up idea, HWD-OPT-001) |

## Viability (HWD-CAL-001 section 10)

- Value-engineering target: USD 10 of prototype parts. Estimated cost of the constructable design: USD 9.15 (USD 0.85 under the target), including USD 3.20 of test tablets at retail.
- Cost per litre over a two-year life: about USD 0.0006 for a household of five dosing 20 L buckets (456 tablets a year, USD 5.72 a household a year including the cap at its scale cost); about USD 0.012 for one person dosing 1 L bottles (USD 12.74 a year). At retail tablet prices the personal route costs about USD 0.22 a litre and is not viable as the main route (HWD-DEC-001 D5).
- Consumable: standard household NaDCC tablets; no proprietary refill, so resupply follows the existing humanitarian chain (PR-020). Strip shelf life 5 years.
- Adoption: the program's warning on household filter use (HWP-MKT-001) applies; correct and sustained use is the KPI that matters for D.

## Open route

The cap's drawings are open under CERN-OHL-P-2.0, so regional moulders can make it; the tablets are bought registered products. Helpful Engineering's volunteer network and WASH partners carry the design to pilots after accredited testing of the combined systems (HWP-VER-001 TB, TJ).

## Sources

HWP-MKT-001 and the links in Table 1 (all checked 2026-11-11).

Licence: this document is licensed under CC-BY-4.0 (Creative Commons Attribution 4.0 International), following the Helpful Engineering licensing guide. Design Molecule Labs with Helpful Engineering.
