BoujeeEnjinia1701/helpful-water/solutions/D-virus-add-on/docs/11-plan.md

---
doc_id: HWD-PLN-001
title: "Helpful Water D: chlorine co-treatment add-on project plan"
project: "Helpful Water D: chlorine co-treatment add-on"
doc_type: Project plan
version: "0.1"
status: Draft
date: 2026-11-11
author: Amish Chadha
license: CC-BY-4.0
revisions:
  - version: "0.1"
    date: 2026-11-11
    author: Amish Chadha
    change: First plan for D, carrying the kill criteria and the parts of HWP-PLN-001 that apply
---

# Helpful Water D: chlorine co-treatment add-on project plan

D is at TRL 3 on paper (stage P3, the portfolio cap): a constructable dose cap with calculations, drawings, a priced BOM and a build plan. The next gate, P4 (a functional prototype checked with known potable test water and the TJ chlorine-dosing family), stays closed until Amish opens it with Helpful Engineering. Amish decided HWD-DEC-001 D1 to D7 on 2026-11-11, including D3 (C stays carbon-free) and D4 (the 28 mm port in C's lid); no decision is open.

## Purpose

Give households and field users of the A to C filters a simple, tool-free way to dose chlorine at the household rate and wait the full contact time before filtering, so that viruses are addressed where viral disease is a risk (HWP-PLN-001 purpose; Amish, 2026-11-11: "No virus claim, co-treat").

## Kill criteria

From HWP-PLN-001, applied to D, with D's own: stop or pause if the dose cannot be held between the household rate and the 5 mg/L guideline value in realistic use; if users cannot tell when the contact time is complete (TH); if the combined system cannot show virus reduction under realistic conditions (TB); if the consumable cannot be resupplied where the device is used; if total cost or complexity is not viable beside tablets alone; or if partners decline because of chemical safety, registration or liability concerns.

## Targets and key performance indicators

Table 1. Targets for D (Decided by Amish on 2026-11-11).

| Category | Target | Basis |
| --- | --- | --- |
| Dose | 2.0 mg/L (1.5 to 2.5), 4.0 for settled turbid water; never above 5 | WHO GV; IFRC; PR-001, PR-005 |
| Residual | At least 0.5 mg/L at 30 min (clear water) | WHO GDWQ; PR-002 |
| Virus reduction, combined system | Toward the WHO household scheme targets (3 log two-star, 5 log three-star), as targets only | HWP-CLM-001 Table 2 |
| Timer | At least 30 min at 25 C | PR-008 |
| Correct use | 90 % follow dose, wait, filter unaided | HWP-PLN-001 Table 2 (cleaning sequence target, applied to D) |
| Cost | Under USD 10 prototype; about USD 1.40 at scale | PR-019 |

Table 2. Key performance indicators (HWP-PLN-001 Table 3, for D).

| Category | KPI | Measurement |
| --- | --- | --- |
| Efficacy | Free chlorine at 30 and 60 min; virus log reduction of the combined system | mg/L (DPD); log10 (TB) |
| Usability | Share who wait the full time and filter after | Observation percent |
| Taste | Taste complaints after the filter | Percent of users |
| Cost | Cost per litre and per household a year | USD |
| Logistics | Tablet stock-outs at the point of use | Days per year |

## Workstreams

Table 3. Workstreams.

| Workstream | Owner (role) | Deliverable | Status |
| --- | --- | --- | --- |
| Chemistry and dosing | Water chemist | HWD-CAL-001, HWD-STM-001; TJ protocol | Drafted on paper |
| Mechanical design | Mechanical and design-for-manufacture engineer | Model, drawings, build plan | Drafted on paper |
| Interfaces with A, B, C | Program lead with each team | 28 mm neck (B), cup use (A), bucket port and closed outlet (C) | B agreed by geometry; C open (D4) |
| Human factors | Industrial designer and human-factors lead | Pictograms; TH protocol | Planned |
| Regulatory | Regulatory specialist | HWD-REG-001 items to assess | Planned |

## Minimum viable team

From HWP-PLN-001 Table 4: the water chemist (lead for D), a mechanical and design-for-manufacture engineer, the water microbiologist and accredited laboratory (TB virus protocol for the combined system), the materials and regulatory quality specialist, and the industrial designer and human-factors lead.

## Resources needed

Table 4. Resources (P4 onwards; on hold).

| Resource | Deliverable | Effort | Estimated cost (USD) |
| --- | --- | --- | --- |
| Prototype parts and test tablets | Five D1 caps | Days | About 46 (5 x 9.15, BOM) |
| DPD free chlorine kit and pH and turbidity meters | TJ bench checks with known potable test water | Days | To assess |
| Accredited virus testing of combined systems | TB with D and each of A, B, C | Months | Within HWP-PLN-001 Table 5 (50,000 to 150,000 for the program) |
| Regulatory advice | Registration route for the claim (W9) | Weeks | To assess |

## Stage gates

Table 5. Stages (P4 to P6 on hold while the stage cap is P3).

| Stage | Gate criteria | Status |
| --- | --- | --- |
| P0 to P2 | Problem, STEM check, options, requirements, calculations, traceability | Done on paper |
| P3 Detailed design | Constructable model, drawings, BOM, build plan, decisions register, design FMEA | Done on paper (this set) |
| P4 Prototype and lab test | Prototypes; TJ dosing, TF seals, TH use, TB combined-system virus protocol | On hold (stage cap) |
| P5 Field trial | Partner pilots with independent evaluation | On hold |
| P6 Release | Released documents, registration where needed | On hold |

## 60 to 90 day plan once P4 opens (HWP-PLN-001 Table 7, for D)

Table 6. Gated plan.

| Window | Outputs and decision |
| --- | --- |
| Days 0 to 15 | Partner's tablet sizes and strengths (C1); C interface agreed (D4); residual decision (D3) |
| Days 16 to 35 | Print five caps; seal, key and timer checks; fluid grade tuned (C2) |
| Days 36 to 60 | TJ bench dosing with known potable test water at pH 6 to 8.5, 5 to 30 C, spiked turbidity; pictogram comprehension (TH) |
| Days 61 to 90 | Combined-system virus protocol scoped with the laboratory (TB); go, pivot or stop recommendation |

## Support needed from Helpful Engineering

A water chemist to own the dosing tests; introductions to a WASH partner that distributes NaDCC (tablet sizes, resupply, ministry approvals); a laboratory able to run a virus protocol on the combined systems.

## Next steps and decisions

D1 to D7 were decided by Amish on 2026-11-11 (HWD-DEC-001). The design looks ready for a TRL 4 build once the tablets are measured; that is a recommendation, not a start.

## References

- Program documents: HWP-PRB-001, HWP-SRC-001, HWP-URS-001, HWP-CLM-001, HWP-REG-001, HWP-MKT-001, HWP-PLN-001, HWP-VER-001, HWP-FTO-001.
- Helpful Engineering source pack: Helpful Water update (2026-02-26); Component Specifications Rev A (2026-10-14); Concept Validation Questions (2026), section on tablet options for viruses and item 45; Project Viability Shortlist Analysis; Helpful Water open questions (all internal).
- Akvopedia. "Chlorine (NaDCC)." https://akvopedia.org/wiki/Chlorine_(NaDCC) (checked 2026-11-11).
- IFRC. *Chlorine Tablet Choice in Emergencies*, 2025. https://wash.ifrc.org/wp-content/uploads/2025/06/Chlorine-Tablet-Choice-in-Emergencies.pdf (checked 2026-11-11).
- IFRC Items Catalogue, WASDCHLA01. https://itemscatalogue.redcross.int/wash--5/water--29/water-treatment-products--124/chlorine-nadcc-household-use--WASDCHLA01.aspx (checked 2026-11-11).
- Lantagne, Daniele. "Engineering Inputs to the CDC Safe Water System Program." National Academies Press, 2006. https://www.nationalacademies.org/read/11577/chapter/8 (checked 2026-11-11).
- WEDC Mobile Note 7. https://wedc-knowledge.lboro.ac.uk/resources/e/mn/007-Chlorination.pdf; WHO and WEDC Technical Note 11. https://wedc-knowledge.lboro.ac.uk/resources/who_notes/WHO_TNE_11_Measuring_chlorine_levels_in_water_supplies.pdf (both checked 2026-11-11).
- WHO chlorine fact sheet (2022) and NaDCC fact sheet; US EPA 4-log virus CT table (California Water Boards copy); CDC chlorine timetable (archived); Dunkin et al. (2017); Crider et al. (2018); Wu and Dorea (2020); Texas A&M AgriLife L-5344; Engineering for Change, WaterGuard; Dow PMX-200; CampSaver Aquatabs listing; Kapy CAD PCO 1881; BSI listings for NaDCC and sodium hypochlorite. Links in HWD-STM-001 and HWD-REG-001 (all checked 2026-11-11).

Licence: this document is licensed under CC-BY-4.0 (Creative Commons Attribution 4.0 International), following the Helpful Engineering licensing guide. Design Molecule Labs with Helpful Engineering.
