BoujeeEnjinia1701/helpful-water/solutions/A-straw/docs/07-regulatory.md

---
doc_id: HWA-REG-001
title: "Helpful Water A: filter straw regulatory and standards register"
project: "Helpful Water A: filter straw"
doc_type: Regulatory and standards register
version: "0.1"
status: Draft
date: 2026-11-11
author: Amish Chadha
license: CC-BY-4.0
revisions:
  - version: "0.1"
    date: 2026-11-11
    author: Amish Chadha
    change: Solution register citing HWP-REG-001 with the items specific to the straw
---

# Helpful Water A: filter straw regulatory and standards register

The program register HWP-REG-001 (items W1 to W12) applies to the straw as written there and is not repeated; this register states how each applies to solution A and adds what is specific to a straw. Not legal advice; anything marked "to assess" needs a qualified regulatory adviser before any product claim. Checked 2026-11-11. Method: STANDARDS section 23.

Table 1. Regulatory and standards register for solution A.

| # | Standard or regulation | Jurisdiction | What it covers | Applicability to this design | Owner (role) | Status |
| --- | --- | --- | --- | --- | --- | --- |
| A1 | HWP-REG-001 W1, WHO International Scheme to Evaluate Household Water Treatment Technologies | International | Star ratings by log reduction | A straw alone cannot reach any star without a virus stage; cited only with solution D | Program lead | Target only, with D |
| A2 | HWP-REG-001 W2, WHO Guidelines for drinking-water quality | International | E. coli not detectable in 100 mL | Verification point for TB, not proof of safety | Microbiology lead | Applies |
| A3 | HWP-REG-001 W3, EPA Guide Standard and Protocol (as summarised by the CDC Yellow Book) | United States (reference) | 6 log bacteria, 4 log viruses, 3 log cysts for a purifier claim | Not claimed: a membrane-only straw does not meet the virus figure; PR-001 and PR-006 use the bacteria and cyst figures as test targets | Microbiology lead | Not claimed at TRL 3 |
| A4 | HWP-REG-001 W4, NSF Protocol P231 | United States (voluntary) | Microbiological purifier testing | Only for a combined system with D | Regulatory specialist | To assess |
| A5 | HWP-REG-001 W5, NSF/ANSI 42 | United States (voluntary) | Aesthetic effects (chlorine taste) | Carbon stage; PR-029; commercial straws with a few grams of carbon list it | Regulatory specialist | Target |
| A6 | HWP-REG-001 W6, NSF/ANSI 53 and 401 | United States (voluntary) | Health contaminants | No such claim | Regulatory specialist | Does not apply |
| A7 | HWP-REG-001 W7, NSF/ANSI/CAN 61 and 372 | United States and Canada (voluntary) | Health effects and lead content of wetted materials | Every wetted part: PP, EPDM, silicone, 316L, potting, fibres, GAC; PR-018 | Materials specialist | Design rule |
| A8 | HWP-REG-001 W9, biocide or pesticide registration | United States (FIFRA), European Union (BPR), others | Products that claim to kill microbes | No biocide or silver in A1; copper option A3 dropped. Any future antimicrobial fibre or carbon triggers it | Regulatory specialist | Does not apply (A1) |
| A9 | HWP-REG-001 W10, EU Drinking Water Directive (EU) 2020/2184 contact materials | European Union | Hygiene of contact materials | If sold in the EU | Materials specialist | To assess |
| A10 | HWP-REG-001 W11, national registration | Partner countries | Product approval, import, labelling | Before any distribution | Partner organisation | To assess per country |
| A11 | HWP-REG-001 W12, ISO 7010 and ISO 3864 | International | Pictograms and safety colours | On-straw pictograms, virus warning (PR-008, PR-010) | Industrial designer | Applies as guidance |
| A12 | Patent US 8,852,439 B2 and family (HWP-FTO-001) | United States and family countries | Hollow-fibre straw with closed ends toward the outlet | A1 is the reverse arrangement on a desk reading (HWA-OPT-001) | Patent attorney | To assess (HWA-DEC-001 C4) |
| A13 | Food-contact rules for printed prototype polymers | All | Filaments and additives | Printed prototypes are not listed materials; prototypes see known potable test water only and nobody drinks from them | Design lead | Met by design (release limitation) |

## Sources

- HWP-REG-001 and its sources (WHO, CDC Yellow Book, NSF, US EPA), checked 2026-11-11.
- Google Patents. "US8852439B2." https://patents.google.com/patent/US8852439B2/en (checked 2026-11-11).
- Membrane Solutions S2 straw listing (NSF/ANSI 42 and 372). https://www.desertcart.uy/products/246879908-membrane-solutions-water-filter-straw-s2-nsf-ansi-42-372.md (checked 2026-11-11).

Licence: this document is licensed under CC-BY-4.0 (Creative Commons Attribution 4.0 International), following the Helpful Engineering licensing guide. Design Molecule Labs with Helpful Engineering.
