BoujeeEnjinia1701/helpful-water/solutions/A-straw/docs/10-market.md

---
doc_id: HWA-MKT-001
title: "Helpful Water A: filter straw market and viability"
project: "Helpful Water A: filter straw"
doc_type: Market and viability
version: "0.1"
status: Draft
date: 2026-11-11
author: Amish Chadha
license: CC-BY-4.0
revisions:
  - version: "0.1"
    date: 2026-11-11
    author: Amish Chadha
    change: Straw-specific market note citing HWP-MKT-001, with this BOM's cost and cost per litre over life
---

# Helpful Water A: filter straw market and viability

The straw competes with LifeStraw Personal and the Sawyer Mini for emergency kits and individual use, where it offers a rinseable mesh, a backflush that never passes the carbon, a field integrity check and an open design for regional moulding; against chlorine tablets it costs less per litre at scale but protects only the person drinking and does not cover viruses. The program market, buyers and metrics are in HWP-MKT-001. Prices checked 2026-11-11. Method: STANDARDS section 23.

Table 1. Market segments for solution A.

| Segment | Target users and region | Competitive benchmark (cited price) | Estimated cost per unit (USD) | Value proposition |
| --- | --- | --- | --- | --- |
| Emergency response kits | Disaster and displacement response, WASH cluster partners | LifeStraw Personal, 34.95 as listed at MEC with currency shown as "$" ([MEC](https://www.mec.ca/en/product/6018-750/Personal-Water-Filter-Straw)); Sawyer Mini about USD 29 ([OutdoorGearLab](https://www.outdoorgearlab.com/reviews/camping-and-hiking/backpacking-water-filter/sawyer-mini)) | 17.46 prototype parts; target 1 to 5 at mass production (HWP-PLN-001) | Rinseable mesh for turbid water, backflush that avoids the carbon, air-hold check, pictogram instructions |
| Field teams and travellers (funding channel) | Outdoor retail, field staff | Membrane Solutions WS02 replacement set USD 15.99 for two ([SimPure](https://www.simpurelife.com/products/ws02-water-filter-straw-replacement-filter)) | As above | Replaceable carbon; open design; cross-subsidy for humanitarian units |
| Distrusted tap water (SC1) | Urban households, schools | NaDCC tablets about USD 0.02 a litre ([Akvopedia](https://akvopedia.org/wiki/Chlorine_(NaDCC))) | As above | Chlorine taste reduced (after NSF/ANSI 42 testing) and a second barrier against recontamination |

Table 2. Cost per litre over the device life (HWA-CAL-001 section 10; membrane life 2,000 L and carbon 500 L are assumptions).

| Case | Unit cost (USD) | Refills over life (USD) | Cost per litre (USD) |
| --- | --- | --- | --- |
| Prototype parts | 17.46 | 3 x 1.21 | 0.011 |
| Mass production (mid of target) | 3.00 | 3 x 0.15 (assumed) | 0.002 |
| NaDCC tablets (household water, covers viruses, not *Cryptosporidium*) | Consumable | | About 0.02 |
| LifeStraw Personal at its rated 4,000 L | 34.95 as listed | None | About 0.009 |

At about 2 L of drinking water a day one straw lasts about 2.7 years at 2,000 L, so the cost per person per year at scale is about USD 1.3 with the carbon refills (USD 0.0017 a litre x 730 L); that is within the under USD 10 per user per year the shortlist set for the bottle cartridge (HWP-MKT-001).

## Open route

The housing, caps, cartridge and mouthpiece are open drawings under CERN-OHL-P-2.0 that a regional moulder can make in polypropylene from two or three simple tools; makerspaces can print them for pilots. The membrane module is bought from qualified makers with certificates and lot traceability, and the carbon from water-treatment media suppliers. Helpful Engineering's volunteer network and WASH partners carry the design to pilots once accredited tests are done; no pilot uses an untested straw.

## Sources

- HWP-MKT-001 and the listings above, checked 2026-11-11.

Licence: this document is licensed under CC-BY-4.0 (Creative Commons Attribution 4.0 International), following the Helpful Engineering licensing guide. Design Molecule Labs with Helpful Engineering.
