BoujeeEnjinia1701/helpful-water/solutions/B-bottle-cartridge/docs/01b-stem-check.md

---
doc_id: HWB-STM-001
title: "Helpful Water B: bottle cartridge STEM check"
project: "Helpful Water B: bottle cartridge"
doc_type: STEM check
version: "0.2"
status: Draft
date: 2026-11-11
author: Amish Chadha
license: CC-BY-4.0
revisions:
  - version: "0.1"
    date: 2026-11-11
    author: Amish Chadha
    change: "First STEM check, run before design (kit 1.9.1-he, STANDARDS sections 20 and 25.6); four detail failures fixed under the standing instruction of 2026-10-23 (HWB-DEC-001 F1 to F4); rerun on the TRL 3 model"
  - version: "0.2"
    date: 2026-11-11
    author: Amish Chadha
    change: "Independent review recorded (10 hold, 16 weak, 1 refuted of 27; 11 missed checks raised); rows reworded, S28 to S33 added, F5 to F9 fixed under the standing instruction, D8 and D9 proposed; 14 within, 19 plausible, none fails"
---

# Helpful Water B: bottle cartridge STEM check

Verdict: no claim fails. Of 33 claims, 14 sit within known science and 19 are plausible and stay open until supplier data or TRL 4 tests close them, so `stem_check` is **open**. The check was run before any design and found four details of the briefed options that do not work as described; each fix keeps the working principle and was made under Amish's standing instruction of 2026-10-23 (HWB-DEC-001 F1 to F4, HWB-DDR-003): the carbon moves upstream of the membrane (S18), a duckbill valve lets air back into a squeezed bottle (S19), the gravity stand gets a wider base (S20) and the inverted bottle gets a vent tube (S21). An independent review on 2026-11-11 (section below) refuted one row (S22, the clean-side hold-up), weakened 16 and raised 11 missed checks; it led to six new rows (S28 to S33), five more fixes under the same instruction (F5 to F9) and two proposals for Amish (D8 housing end wall, D9 rating temperature). The largest open item is still the membrane's clean-water permeability: every flow figure rests on an assumed 1,000 L/(m2 h bar) in 20 C water, which the module maker must confirm (HWB-DEC-001 C1); in 10 C water every flow is about 23 % lower (S31). Method: STANDARDS sections 20 and 25.6. Calculations: `docs/04-calcs/stem_check.py`, which reads the results of `docs/04-calcs/sizing.py` (HWB-CAL-001).

> **Release limitation.** No prototype is used to treat water for drinking until its pathogen performance, materials safety, integrity, source suitability and claims are validated by qualified laboratories (HWP-CLM-001). Every number here is a paper estimate.

## Claims checked

Table 1. Claims, governing science and verdicts (generated from `docs/04-calcs/stem_results.csv` by `docs/04-calcs/stm_table.py`).

<!-- STM_TABLE -->
| # | Claim | Field | Branch | Governing law or source | First-order check | Verdict | Closed by |
| --- | --- | --- | --- | --- | --- | --- | --- |
| S1 | B1 gives at least 400 mL/min at a comfortable adult squeeze (17 kPa) with a clean module in 20 C water | Physics | Fluid mechanics | Darcy flux J = Lp x TMP over 0.174 m2 of outside fibre area, assumed clean-water permeability 1,000 L/(m2 h bar), a quarter of the 0.1 um PVDF example in US 8,708,161 B2; Ergun bed, Hagen-Poiseuille lumens and outlet in series (CAL section 3); fouled 242, at 10 C 360 mL/min (S31) | 465 mL/min >= 400 mL/min | Plausible, to confirm at TRL 3 | Open |
| S2 | B1 gives at least 150 mL/min at a weak child's squeeze (5.8 kPa, girls' boundary 11.8 kg) and an elderly woman's (7.2 kPa) with a clean module in 20 C water | Physics | Fluid mechanics | As S1 at the persona pressures; assumed clean-water permeability 1,000 L/(m2 h bar), a quarter of the 0.1 um PVDF example in US 8,708,161 B2; fouled 82, at 10 C 123 mL/min (S31) | 160 mL/min >= 150 mL/min | Plausible, to confirm at TRL 3 | Open |
| S3 | A hand squeeze on a 1 L PET bottle gives about 6 to 17 kPa held and about 43 kPa at full grip | Biology | Human physiology and biomechanics | Grip norms (Camry dynamometer, 10 to 11 years and 70 to 99 years) x 40 % held x 0.8 wall loss over an 80 x 80 mm contact; STANDARDS 25.6 range 10 to 30 kPa | Model only: the dynamometer grip is not the grip on an 80 mm cylinder (a diameter factor of about 0.6 would give 10 kPa for the adult) and a child's hand does not wrap 80 mm; two-handed squeezing is the design case; bottle pressure to measure with a gauge (HWP-VER-001 TH) | Plausible, to confirm at TRL 3 | Open |
| S4 | Mesh, carbon bed, lumens and outlet together take under a fifth of the squeeze pressure, so the membrane sets the flow | Physics | Fluid mechanics | Pressure drop per stage at the adult squeeze: Ergun bed (12 x 40 GAC, void 0.40), lumens, nipple, nozzle and valve ports; clean bed only, silt loading is S32 | 1.13 kPa <= 3.43 kPa | Within known science | HWB-CAL-001 |
| S5 | Flux arithmetic: 1,000 L/(m2 h bar) x 0.174 m2 at 10 kPa is about 290 mL/min before the other stages | Mathematics | Units and dimensional analysis | L/(m2 h bar) x m2 x bar = L/h; / 60 x 1000 = mL/min | claimed 289.864 mL/min, estimate 274 mL/min (ratio 1.06) | Within known science | HWB-CAL-001 |
| S6 | B2 gravity drip treats 1 L in under 15 minutes with a clean module in 20 C water (heads 2.5 to 5.2 kPa) | Physics | Fluid mechanics | Falling-head drain of an inverted 1 L bottle through 0.295 m2; assumed clean-water permeability 1,000 L/(m2 h bar), a quarter of the 0.1 um PVDF example in US 8,708,161 B2 | 6.2 min per litre clean, 11.9 min fouled, against 15 min; at 10 C 8.1 and 15.6 min; rests on the assumed permeability (supplier flux data, HWB-DEC-001 C1) | Plausible, to confirm at TRL 3 | Open |
| S7 | B3 press reaches 18 kPa with 80 N of arm or body weight and gives at least 300 mL/min with a clean module | Physics | Mechanics and statics | p = (F - lip seal friction 10 N, assumed; 30 N would give 13 kPa) / cup bore area (70 mm); flow as S1 | 500 mL/min clean, 257 fouled, against 300; rests on the assumed permeability | Plausible, to confirm at TRL 3 | Open |
| S8 | B3 press tube holds the 350 mL fill line of treated water above and around the cartridge | Mathematics | Orders of magnitude | Press tube volume less the cartridge housing volume | 559 mL >= 350 mL | Within known science | HWB-CAL-001 |
| S9 | A 0.1 um hollow-fibre membrane is a size barrier for protozoan cysts (about 3 to 15 um) and is designed to reduce most bacteria; no removal is claimed from the pore label | Biology | Microbiology | Size exclusion: Cryptosporidium oocysts 4 to 6 um, Giardia cysts 8 to 12 um (40 to 120 x the 0.1 um pore); most bacteria are 0.3 um or more across, but thin forms such as Leptospira (about 0.1 um) reach the nominal pore; CDC: microfiltration very high effectiveness for protozoa, moderate for bacteria | Sieving ratio about 1 for the thinnest bacteria and 3 for Brevundimonas diminuta (0.3 um), so the pore label is not a bacteria barrier; the supplier's absolute rating (C1) and an accredited log reduction (HWP-VER-001 TA, TB) decide | Plausible, to confirm at TRL 3 | Open |
| S10 | The membrane is not a virus barrier, so the product carries the no-virus warning and pairs with chlorine (solution D) where viruses are a risk | Biology | Microbiology | Viruses about 0.02 to 0.3 um overlap and pass a 0.1 um pore (sieving ratio 0.2 to 3); CDC: microfiltration not effective for viruses | No virus claim (Amish, 2026-11-11: no virus claim, co-treat); HWP-CLM-001 warning on the product | Within known science | HWB-CAL-001 |
| S11 | The carbon capsule holds about 7 g of 12 x 40 coconut GAC | Chemistry | Physical chemistry | Bed 29.8 mm x 20 mm = 13.9 mL x bulk density 0.48 to 0.50 g/cm3 (Newterra 5DCAW 1240 data sheet) | claimed 7 g, estimate 6.84 g (ratio 1.02) | Within known science | HWB-CAL-001 |
| S12 | Carbon intended to reduce chlorine taste at an empty-bed contact time of 1.8 to 5.2 s (B1) and about 5 s (B2) | Chemistry | Physical chemistry | EBCT = bed volume / flow; the true residence time is about 0.4 x EBCT (void 0.40); seconds of contact are short for granular carbon (concept validation questions, item 19); free chlorine reacts fast at carbon surfaces, organics and odours much more slowly | Chlorine taste reduction is a target only, no odour or organics claim, to measure with an NSF/ANSI 42 style test and a breakthrough curve that sets the capsule life (HWP-VER-001 TG); 150 L capsule life is assumed | Plausible, to confirm at TRL 3 | Open |
| S13 | Squeezing air through the wetted cartridge (empty bottle) shows a broken fibre as a stream of bubbles, while an intact 0.1 um membrane holds air | Physics | Fluid mechanics | Young-Laplace bubble point dP = 4 gamma / d: 0.1 um pore about 2,900 kPa ideal (real membranes lower, still far above 17 kPa); open 0.5 mm lumen 0.6 kPa; adult squeeze 17 kPa with the outlet in a cup of water reveals any opening above about 17 um | 0.58 kPa <= 17.2 kPa | Within known science | HWB-CAL-001 |
| S14 | The air test, done with an adult squeeze, does not find round defects under about 17 um (slits under about 9 um), so it is a check for gross damage, not proof of pathogen performance | Engineering and technology | Sensing resolution | Bubble point at the available squeeze: d = 4 gamma / dP = 17 um at 17 kPa (slit width 2 gamma / dP = 8.5 um); a weak user's 6 kPa finds only openings above about 50 um; cysts are 4 to 15 um, bacteria 0.1 to 5 um | User guidance says 'stop using if bubbles stream'; never 'safe if no bubbles'. Production integrity test by the module maker (TI) | Within known science | HWB-CAL-001 |
| S15 | Wet fibres can be damaged by freezing without any change in flow, so the product carries a do-not-freeze-wet warning and a retire-after-freezing rule | Physics | Thermodynamics | Water expands about 9 % on freezing; competitors report freezing as the main silent-failure cause (concept validation questions, item 17) | No freeze claim; warning and pictogram; air test after suspected freezing; retire if frozen wet (HWP-VER-001 TF) | Within known science | HWB-CAL-001 |
| S16 | The housing stays far below the strength of printed polypropylene at the highest squeeze and a hard backflush | Physics | Strength of materials | Hoop p r / t and the flat 4 mm end wall as a circular plate (1.24 p a2 / t2, simply supported); printed PP taken at 10 MPa (assumed, a third of moulded PP yield; layer strength lower) | Full squeeze: end wall 1.14 MPa, factor 9. Backflush as instructed (collar end open): shell near 0 kPa. If the collar end were blocked at 179 kPa: hoop 1.65 MPa but end wall 4.7 MPa, factor 2.1 against PR-028's 5 (6.2 mm wall needed; HWB-DEC-001 D8); burst test at TRL 4 | Plausible, to confirm at TRL 3 | Open |
| S17 | A 60 mL syringe backflush (54 kPa gentle to 179 kPa hard) stays inside the module's backwash limit | Engineering and technology | Standards practice | p = F / syringe bore area (26.7 mm); the module maker's maximum backwash pressure is not yet known | To confirm from the supplier (HWB-DEC-001 C2), with the potting bond rated for 135 N at 179 kPa; the instruction is a gentle push; backflush runs with the carbon capsule removed so no fines or carbon are flushed into the fibres | Plausible, to confirm at TRL 3 | Open |
| S18 | Wet carbon downstream of the membrane (the briefed B1 layout) would grow bacteria on the clean side in warm storage and need a backflush bypass | Biology | Microbiology | Carbon after the membrane can harbour microorganisms (Rev A specification section 05); wet carbon supports regrowth (concept validation questions, item 21) | Failed as briefed, fixed: carbon moved to a dirty-side capsule upstream of the membrane, so the membrane is the last barrier and backflush never passes carbon | Within known science | HWB-DEC-001 F1 |
| S19 | On release the squeezed bottle refills with air without unscrewing | Physics | Fluid mechanics | A wetted 0.1 um membrane blocks air up to its bubble point (about 2,900 kPa, S13), so air cannot return through the outlet; a dirty-side duckbill valve opens inward at about 0.5 kPa (assumed) and closes under squeeze; tipped, it sits under the bottle's water and needs about 2.9 kPa of vacuum | Failed as briefed (no air path), fixed with a duckbill valve in the collar (F2); the bottle is turned upright on release so the valve is in air and opens at about 0.5 kPa (F5); springback of a thin still-water bottle to confirm by test (TH) | Plausible, to confirm at TRL 3 | HWB-DEC-001 F2, F5 |
| S20 | The B2 stand does not tip over when the full bottle hangs in it | Physics | Mechanics and statics | Tip angle atan(base radius / centre of gravity height) for the continuous base ring (not leg feet) with a full 1 L bottle; criterion 15 deg (assumed); base radius 65 mm gave 9.9 deg (failed), widened to 115 mm; a 4.4 N side push at the centre of gravity still tips it, so the stand goes on a table away from children's reach | 17.2 deg >= 15 deg | Within known science | HWB-DEC-001 F3 |
| S21 | The inverted bottle of B2 drains without collapsing or locking | Physics | Fluid mechanics | Air must replace the water leaving the bottle; the wetted membrane blocks air (S13). The 4 x 0.8 vent tube has a 2.4 mm bore (Bond number 0.77, below 3.37), so water it takes in on filling stays as a plug that the bottle must purge | Failed as briefed, fixed with the vent tube (F4); the first purge needs about 2.9 kPa of bottle vacuum against a 5.2 kPa full head, so it works on paper with a slow first minute; to confirm by test (TH) | Plausible, to confirm at TRL 3 | HWB-DEC-001 F4 |
| S22 | With carbon on the dirty side, the clean side holds about 21 mL: 5.7 mL in the header, nipple and spout, which drains, and 15.2 mL in the lumens, which stays wet; a first flush after storage clears it | Biology | Microbiology | Biofilm grows where water stands on wetted surfaces; capillary rise in a 0.5 mm lumen is about 60 mm, so the lumens never drain; bacteria can grow through 0.1 to 0.2 um membranes over days of wet storage; the outlet can be recontaminated by the mouth or hands | Refuted as first stated ('drains and dries', 5.7 mL), fixed: discard the first 50 mL after any storage (F6); grow-through and regrowth to measure in storage cycles (HWP-VER-001 TE, TG); dust cover, pour into a cup for shared use | Plausible, to confirm at TRL 3 | HWB-DEC-001 F6 |
| S23 | Every wetted material is from a family available in NSF/ANSI/CAN 61 grades: PP, EPDM or silicone, 316L, PVDF or PES fibres, polyurethane or epoxy potting, coconut GAC | Chemistry | Materials and polymer chemistry | NSF/ANSI/CAN 61 and 372 set the contact-material references; printed prototype parts are not certified | Extractables and leachables of the actual grades, potting (residual isocyanate or amine) and carbon fines and ash (TG); the first flush (F6) also clears fines; prototypes are used with known potable test water only | Plausible, to confirm at TRL 3 | Open |
| S24 | One collar fits both 28 mm PCO 1881 and PCO 1810 necks: the skirt clears the support ring of the shorter 1881 neck | Engineering and technology | Manufacturing tolerances | Same thread diameter and pitch (about 27.4 mm, 2.7 mm); neck height about 17 mm (1881) and 21 mm (1810); skirt 15.5 mm below the lip with the compressed 1.5 mm gasket included (Kapy CAD, approximate); thread starts and tolerances from the ISBT drawings (C7) | 1.5 mm >= 1 mm | Within known science | HWB-CAL-001 |
| S25 | A printed adapter fits the collar to 38 mm two-start necks used on wide-mouth juice and dairy bottles | Engineering and technology | Manufacturing tolerances | 38 mm two-start finishes exist in several variants (Bericap 38 mm HF two-start; Petainer 38 mm two-start) | Dimensions of the exact 38 mm finish to obtain from its drawing before the adapter is drawn (HWB-DEC-001 C4) | Plausible, to confirm at TRL 3 | Open |
| S26 | The B1 cartridge weighs about 120 g dry and about 182 g wet | Mathematics | Orders of magnitude | Model volumes x densities (PP 905, EPDM 1,150, 316L 7,950 kg/m3, fibres 30 % solid PVDF, GAC 490 kg/m3) | claimed 120 g, estimate 118 g (ratio 1.02) | Within known science | HWB-CAL-001 |
| S27 | A weak child can fill a 250 mL cup in about 94 s of squeezing with a clean module, in short squeezes | Biology | Ergonomics | Held grip of 40 % of maximum is assumed for 10 to 20 s at a time; the fouled module halves the flow (183 s); a litre takes a weak child 6 min clean; household volumes are B2's job | Persona trials with known potable water only (HWP-VER-001 TH); if children cannot sustain it, B2 gravity is the household mode | Plausible, to confirm at TRL 3 | Open |
| S28 | Chlorine co-treatment works with the cartridge only if the water is dosed and left for solution D's full contact time before it is filtered; the filtered water then carries no residual | Chemistry | Physical chemistry | Granular carbon removes free chlorine within seconds (S12), so the CT stops at the carbon; WHO and solution D set the dose and contact time (about 30 min) in the bottle; nothing downstream protects stored water | Fixed: dose, wait, then filter; drink or use the filtered water the same day and do not store it (F7); the pictogram shows the order (PR-003) | Within known science | HWB-DEC-001 F7 |
| S29 | The only dirty-to-clean routes, the header O-rings and the potting, are free of bypass at 53 % fibre packing | Engineering and technology | Manufacturing tolerances | Packing 53 % of the header bore (800 fibre ends of 0.8 mm in 31 mm); above about 50 % potting may not penetrate fully and leave voids; a gap under 17 um (slit 8.5 um) passes cysts and bacteria and is not seen by the air test (S14) | Supplier to confirm packing, potting penetration and a production integrity test of every module (C1, F9); assembled-cartridge challenge (HWP-VER-001 TA, TB); about 300 U fibres (0.13 m2, flows about 25 % lower) if the maker asks for less | Plausible, to confirm at TRL 3 | Open |
| S30 | The bought fibres pass water at a few kPa | Chemistry | Materials and polymer chemistry | Plain PVDF is hydrophobic: water enters a 0.1 um pore only far above 17 kPa; hydrophilised PVDF or PES passes water but can dewet if it dries out | Fixed in the module request: hydrophilic PVDF or PES, shipped wet or with a wetting agent (F9); first-use priming and a backflush if first flow is low (F8) | Plausible, to confirm at TRL 3 | HWB-DEC-001 F8, F9 |
| S31 | Every flow figure is for 20 C water; cold water gives about a quarter less | Physics | Fluid mechanics | Flux and laminar losses scale with 1 / viscosity: 1.00 mPa s at 20 C, 1.31 at 10 C (0.77 x) | At 10 C: adult 360 mL/min clean (under PR-004's 400), weak child 123 and elderly woman 152 (PR-005's 150); B2 15.6 min per litre fouled. Rating temperature is HWB-DEC-001 D9 | Within known science | HWB-CAL-001 |
| S32 | The upstream carbon bed keeps its flow in turbid water | Physics | Fluid mechanics | The 150 um mesh passes silt, so the carbon bed works as a depth filter and cannot be backflushed (capsule out); Ergun viscous loss rises about 3.4 x as bed voids fall from 0.40 to 0.30 | Settle or cloth-filter turbid water first (HWP-SRC-001); replace the capsule when a backflush does not restore the flow (instructions, PR-016); clog rate to measure (HWP-VER-001 TE) | Plausible, to confirm at TRL 3 | Open |
| S33 | Air left on the dirty side does not blind the fibres | Physics | Fluid mechanics | Air in the shell cannot cross the wetted membrane (S13) and rises against the flow through a wet 12 x 40 bed only above a capillary entry of about 1 to 2 kPa; at B2's 2.5 to 5 kPa head it may stay and cover fibres | Fixed: prime at first use and after drying by a syringe backflush with the capsule out, which fills the shell from the fibres outward and pushes the air out of the open collar end (F8); to confirm by test (TC) | Plausible, to confirm at TRL 3 | HWB-DEC-001 F8 |
<!-- /STM_TABLE -->

Verdicts: **Within known science**, **Plausible, to confirm at TRL 3** (the kit's wording; here each names the supplier datum or the HWP-VER-001 test family that closes it at TRL 4), **Fails, fix proposed**, **Fails**.

## Water checks of STANDARDS 25.6

Table 2. Where each required water check is answered.

| Check | Rows | Result in one line |
| --- | --- | --- |
| Membrane flux against the pressure available | S1, S2, S5, S6, S7, S31 | 465 mL/min at an adult's held squeeze (17 kPa), 160 at a weak child's (5.8 kPa), clean module, 20 C, assumed permeability; half that just before a backflush is due; 360 and 123 at 10 C |
| Pressure drop per stage | S4, S32 | Mesh 0.004, carbon 0.47, lumens 0.25, outlet and valve 0.41 kPa against 16 kPa across the fibre walls at the adult squeeze; silt in the bed raises its loss about 3.4 times |
| Flow at the persona efforts | S2, S3, S27 | Grip norms give 5.8 kPa (weak child, girls' boundary), 7.2 kPa (weak elderly woman), 17 kPa (adult, held), before any allowance for the 80 mm bottle; 250 mL takes a weak child 94 s clean; see HWB-CAL-001 Table 3 |
| Pore or MWCO against organism size | S9, S10 | 0.1 um against cysts (40 to 120 times larger); most bacteria 3 times or more, the thinnest (Leptospira) about 1, so bacteria reduction rests on measurement; viruses overlap, so no virus claim |
| Carbon contact time and bed mass | S11, S12 | 13.9 mL bed, about 6.8 g at 0.49 g/cm3; 1.8 to 5.2 s contact in B1, about 5 s in B2; chlorine taste is a target only |
| Disinfection dose and CT | S28 | Not used in B itself; chlorine co-treatment (solution D, HWD documents) is dosed in the bottle and left for its full contact time before filtering, because the carbon removes the residual within seconds (F7) |
| Integrity and silent failure | S13, S14, S15, S17, S29, S30, S33 | Air test at an adult squeeze shows openings above about 17 um (slits 8.5 um); does not prove pathogen performance; freezing, over-pressure backflush (135 N on the potting) and potting voids at 53 % packing are the silent-failure routes |
| Biofilm downstream of the membrane | S18, S22 | Carbon moved to the dirty side (F1); 5.7 mL downstream of the potting drains, 15.2 mL in the lumens stays wet, so a 50 mL first flush follows storage (F6) |
| Materials leaching | S23 | All wetted materials from NSF/ANSI/CAN 61-listable families; actual grades, potting residues and carbon fines to test (TG); first flush (F6) |
| Freezing | S15 | Water expands about 9 %; do-not-freeze-wet warning and retire-after-freezing rule |

## Fields not relevant

- Electromagnetism, optics and nuclear radiation: the device has no power, light source or radiation.
- Electrochemistry: no electrodes or metals in contact with water beyond the 316L mesh, which is passive (copper was removed from the program design, HWP-PRB-001).
- Ecology and agronomy: no living material is used; disposal is covered in HWB-RSK-001 and HWB-MKT-001.

## Concept options

- **B1 squeeze cartridge:** no Fails row. S18 (carbon downstream) and S19 (no air return) failed as briefed and were fixed (F1, F2). S22 was refuted by the independent review and fixed (F6); S19 was extended (F5). Open: S1, S2 (permeability), S3 (squeeze model), S9 (bacteria rating), S12 (taste), S16 (end wall, D8), S17 (backwash limit), S19 (springback), S22, S23, S25, S27, S29, S30, S32, S33.
- **B2 gravity drip stand:** no Fails row. S20 (tipping) and S21 (vacuum lock) failed as briefed and were fixed (F3, F4). Open: S6 (permeability), S12, S21 (vent purge), S22, S23, S29, S30, S32, S33 (shell air at a gravity head).
- **B3 press cup:** no Fails row. Open: S7 (permeability). Its own risk is the press foot joint as a bypass route (HWB-OPT-001, HWB-RSK-001).

## Independent review

**Method.** On 2026-11-11 a second agent (Claude Opus 5.5 through the `claude` command line, run as a separate process with read, shell and web tools and no access to this document, the decision records or the design reasoning) was given only `docs/04-calcs/stem_results.csv`, `stem_check.py`, `sizing.py` with the model's input values, `sizing_results.json` and the cited sources. It was asked to refute every "Within known science" and "Plausible" verdict, to default to weak or refuted when unsure, to recompute every number and unit and to look for missed STANDARDS 25.6 water checks. Its findings were then checked by hand before anything was changed.

**Counts.** Of the 27 rows then in the table: **10 hold, 16 weak, 1 refuted** (S22). It also raised 11 missed checks (N1 refuted, N2 to N10 weak, N11 holds). Two findings did not survive checking: the B2 stand tips about the edge of a continuous 230 mm ring, not between leg feet, so S20 holds at 17.2 deg; and the 15.5 mm skirt depth already includes the compressed 1.5 mm gasket (the deck sits 1.5 mm above the lip), so S24 holds. The review also showed that the summary of version 0.1 miscounted: the script gave 16 within and 11 plausible, not 18 and 9.

Table 3. Independent review findings and what changed.

| Row | Finding | Change made |
| --- | --- | --- |
| S22 | Refuted: the 5.7 mL "drains and dries" left out 15.2 mL in the lumens, held by about 60 mm of capillary rise; bacteria grow through 0.1 um membranes in wet storage | Fix F6: 50 mL first flush after storage; row restated (21 mL wet clean side), grow-through test; PR-012 status and H5 updated |
| N1 (S28) | Refuted as a gap: the upstream carbon strips free chlorine in seconds, so chlorine dosed just before filtering gets no contact time | Fix F7: dose, wait solution D's full contact time, then filter; no residual, no storage of filtered water; new row S28 and the 25.6 disinfection check now answered |
| S2, S27 | Weak: the weak-child grip should be the girls' 11.8 kg boundary, not the boys' 12.6 kg | Input corrected: 5.8 kPa, 160 mL/min clean, 82 fouled, 94 s per 250 mL; PR-005 restated at 5.8 kPa |
| S1, S2, S6, N6 (S31) | Weak: every flow is at 20 C; at 10 C flux falls to 0.77 times | Claims say 20 C; new row S31 (360 adult, 123 weak child at 10 C, B2 fouled 15.6 min); D9 proposed |
| S3 | Weak: circular check; dynamometer grip is higher than grip on an 80 mm bottle | Row made Plausible; diameter factor and two-handed design case noted; gauge measurement (TH) |
| S9 | Weak: Leptospira (about 0.1 um wide) and B. diminuta (0.3 um) put the sieving ratio near 1 to 3 | Row made Plausible and reworded: barrier for cysts, designed to reduce most bacteria, rating from the supplier and laboratory |
| S12 | Weak: true residence about 0.4 x EBCT; taste and odour unsupported | Reworded to chlorine taste only |
| S14 | Weak point within a hold: slits are found from 8.5 um; a weak user's 6 kPa finds only about 50 um | Test specified at an adult squeeze |
| S16 | Weak: the flat 4 mm end wall governs, not the hoop | End wall added: factor 9 at a full squeeze, 2.1 if the collar end were blocked at 179 kPa; row made Plausible; PR-028 at risk; D8 proposed |
| S17 | Weak: 179 kPa puts 135 N on the potting face | Potting rating added to the module request (F9, C2) |
| S19 | Weak: tipped, the duckbill needs about 2.9 kPa of vacuum | Fix F5: turn the bottle upright on release |
| S21 | Weak: the vent tube's 2.4 mm bore holds a water plug (Bond number 0.77) | Row made Plausible with the purge pressure (2.9 kPa against a 5.2 kPa head); to test (TH); no geometry change |
| S26 | Weak: 118 g against "about 100 g" | Claim now about 120 g dry, about 182 g wet |
| S7 | Weak: 257 mL/min fouled is under 300 | Claim limited to a clean module; friction sensitivity stated |
| S6, S24, S25, S4 | Weak: rest on assumed inputs or approximate sources | Reworded where needed (S24 now names the thread starts and tolerances, C7); verdicts unchanged |
| N3, N4 (S29) | Missed: header O-rings and potting voids at 53 % packing are silent bypasses below the air test's reach | New row S29; supplier packing, penetration and production integrity test (F9, C1) |
| N5 (S30) | Missed: plain PVDF passes no water at a few kPa | Fix F9: hydrophilic fibres shipped wet; new row S30 |
| N8 (S32) | Missed: silt clogs the upstream bed, which a backflush cannot reach | New row S32; settle or cloth-filter, replace the capsule when a backflush fails to restore flow |
| N10 (S33) | Missed: shell air cannot leave through the wet membrane or the wet bed at a gravity head | Fix F8: priming by syringe backflush when first flow is low; new row S33 |
| N2, N7, N9, N11 | Grow-through, household duration, potting and carbon leachables, cost arithmetic (holds) | Folded into S22, S27, S23; cost unchanged |

**What changed in numbers.** Weak-child flow 170 to 160 mL/min (fouled 87 to 82), weak-child contact time 4.9 to 5.2 s, wet clean side 5.7 to 21 mL, claimed dry mass 100 to 120 g. The BOM total (USD 18.35) and every geometry are unchanged; only the module request text in `bom/bom.csv` item 8 changed.

## Sources

- Kapy CAD. "PET Bottle Threads: PCO-1881 and PCO-1810." https://kapycad.com/en/academy/standards/pet-bottle-thread (checked 2026-11-11).
- Bericap. "DS 38/15 2T SFB HF 1,5 mm e-wall (3600)," 38 mm HF two-start closure. https://bericap.com/product/ds-38-15-2t-sfb-hf-15mm-ewall-3600/ (checked 2026-11-11).
- Petainer. "Bottle Preform: 38 mm 2-Start." https://www.petainer.com/pet-plastic-preforms/bottle-preforms/bottle-preform-38mm-2-start (checked 2026-11-11).
- Topend Sports. "Handgrip Strength Norms" (from the Camry electronic hand dynamometer manual). https://www.topendsports.com/testing/norms/handgrip.htm (checked 2026-11-11).
- Jordan, Ryan. "How Effective Are Backflushing and Storage Practices for Backcountry Squeeze Filters Using Hollow-Fiber Membrane Technology?" Backpacking Light, November 17, 2021. https://backpackinglight.com/backflushing-squeeze-water-filter-platypus-sawyer-befree/ (checked 2026-11-11). Sawyer Squeeze 0.58 L/min by gravity and 2.41 L/min at maximum squeeze, new.
- Toyobo Co. "Polyvinylidene Fluoride Hollow Fiber Microporous Membrane and Process for Production of the Same." US Patent 8,708,161 B2. https://patents.google.com/patent/US8708161B2/en (checked 2026-11-11). Example pure-water permeabilities, used only as an upper reference.
- Newterra. "5DCAW 1240 Coconut Shell GAC Product Data Sheet." https://www.newterra.com/wp-content/uploads/2025/01/Newterra_5DCAW-1240-2-Coconut-Shell-GAC_Product-Data-Sheet.pdf (checked 2026-11-11). Apparent density 0.48 to 0.50 g/cm3.
- Centers for Disease Control and Prevention. "A Guide to Drinking Water Treatment Technologies for Household Use" (archived 2012). https://webarchive.library.unt.edu/web/20120927131907/http://www.cdc.gov/healthywater/drinking/travel/household_water_treatment.html (checked 2026-11-11). Microfiltration about 0.1 um; ultrafiltration about 0.01 um; effectiveness by organism class.
- World Health Organization. *Guidelines for Drinking-Water Quality*, 4th ed. with addenda, chapter 11 pathogen fact sheets (oocyst and cyst sizes). https://iris.who.int/bitstream/handle/10665/375822/9789240088740-eng.pdf (cited through HWP-REG-001).
- Helpful Engineering. *Portable Freshwater Filter Straw: Component Specifications*, Rev A, 2026-10-14 (internal); *Concept Validation Questions*, 2026 (internal); *Project Viability Shortlist Analysis*, item 9 (internal).
- ASTM International. ASTM F838, standard test method for bacterial retention of membrane filters (Brevundimonas diminuta challenge, about 0.3 um across), cited for the organism size only.
- Program documents: HWP-PRB-001, HWP-SRC-001, HWP-CLM-001, HWP-VER-001.

Licence: this document is licensed under CC-BY-4.0 (Creative Commons Attribution 4.0 International), following the Helpful Engineering licensing guide. Design Molecule Labs with Helpful Engineering.
