BoujeeEnjinia1701/helpful-water/solutions/B-bottle-cartridge/docs/07-regulatory.md

---
doc_id: HWB-REG-001
title: "Helpful Water B: bottle cartridge regulatory and standards register"
project: "Helpful Water B: bottle cartridge"
doc_type: Regulatory register
version: "0.1"
status: Draft
date: 2026-11-11
author: Amish Chadha
license: CC-BY-4.0
revisions:
  - version: "0.1"
    date: 2026-11-11
    author: Amish Chadha
    change: "Solution B register citing HWP-REG-001 W1 to W12, with items specific to a bottle cartridge"
---

# Helpful Water B: bottle cartridge regulatory and standards register

The program register HWP-REG-001 (W1 to W12) applies to solution B in full and is cited, not copied; this register adds what is specific to a cartridge that screws onto other makers' bottles. Not legal advice; anything marked "to assess" needs a qualified reviewer before any product claim. Sources checked 2026-11-11.

Table 1. Regulatory and standards register.

| # | Standard or regulation | Jurisdiction | What it covers | Applicability to this design | Owner (role) | Status |
| --- | --- | --- | --- | --- | --- | --- |
| B1 | HWP-REG-001 W1 WHO household treatment scheme | International | Star ratings by log reduction | Target only with solution D co-treatment; the cartridge alone cannot meet the virus column | Program lead | Applies as a target (HWP-CLM-001) |
| B2 | HWP-REG-001 W2 WHO drinking-water guidelines | International | E. coli not detectable in 100 mL | Verification point at TRL 4 | Microbiology lead | Applies |
| B3 | HWP-REG-001 W3, W4 EPA guide standard; NSF P231 | United States (reference) | Purifier benchmarks | Not claimed; only for a combined system with D | Microbiology lead | Not claimed at TRL 3 |
| B4 | HWP-REG-001 W5 NSF/ANSI 42 | United States (voluntary) | Taste, odour, chlorine | The carbon capsule (PR-019) | Regulatory specialist | Target |
| B5 | HWP-REG-001 W6 NSF/ANSI 53 and 401 | United States (voluntary) | Health and emerging contaminants | Not claimed | Regulatory specialist | Does not apply |
| B6 | HWP-REG-001 W7 NSF/ANSI/CAN 61 and 372 | United States and Canada (voluntary) | Drinking-water contact materials; lead | Every wetted part: PP, EPDM or silicone, 316L mesh, fibres, potting, carbon, duckbill (PR-013) | Materials specialist | Design rule |
| B7 | HWP-REG-001 W9 biocide registration | United States, European Union | Antimicrobial claims | Applies only if silver carbon is ever added; not in the design (HWB-DDR-003 F1) | Regulatory specialist | Does not apply (no biocide) |
| B8 | HWP-REG-001 W10 EU Drinking Water Directive (EU) 2020/2184 | European Union | Hygiene of contact materials | If sold in the EU | Materials specialist | To assess |
| B9 | Regulation (EU) No 10/2011 on plastic materials in contact with food | European Union | Migration limits for food-contact plastics | The PP parts, if sold in the EU ([EUR-Lex](https://eur-lex.europa.eu/eli/reg/2011/10/oj), checked 2026-11-11) | Materials specialist | To assess |
| B10 | ISBT and bottler neck-finish drawings (PCO 1881, PCO 1810, 38 mm two-start) | Industry practice | Thread and lip dimensions of the bottles the collar must fit | The collar and the 38 mm adapter (PR-024) | Mechanical engineer | Applies; drawings to obtain (HWB-DEC-001 C4, C7) |
| B11 | Reuse of single-use PET bottles | Partner countries | Bottles are made for single use; cleaning, cracking and any migration over months of reuse are not covered by the bottle maker | The cartridge depends on a reused bottle | Materials specialist; partner | To assess (HWB-PRB-001 open question) |
| B12 | HWP-REG-001 W11 national registration | Partner countries | Product approval, import, labelling | Before any distribution | Partner organisation | To assess per country |
| B13 | HWP-REG-001 W12 ISO 7010 and ISO 3864 | International | Pictograms and safety colours | On-product pictograms, including the no-virus warning (PR-003, PR-008) | Industrial designer | Applies as guidance |
| B14 | Patent screen HWP-FTO-001 (US 8,852,439 B2 and others) | Per country | Freedom to operate | Compared in HWB-OPT-001; squeeze-filter patents to search (D5) | Legal adviser | To assess |

Status: to assess, applies, does not apply, met by design, certification needed later.

## Sources

- HWP-REG-001 and the sources it lists (WHO, CDC, NSF, US EPA), checked 2026-11-11.
- European Union. Commission Regulation (EU) No 10/2011 on plastic materials and articles intended to come into contact with food. https://eur-lex.europa.eu/eli/reg/2011/10/oj (checked 2026-11-11).
- Kapy CAD, Bericap and Petainer neck finish pages, as cited in HWB-STM-001.

Licence: this document is licensed under CC-BY-4.0 (Creative Commons Attribution 4.0 International), following the Helpful Engineering licensing guide. Design Molecule Labs with Helpful Engineering.
