BoujeeEnjinia1701/helpful-water/solutions/B-bottle-cartridge/docs/10-market.md

---
doc_id: HWB-MKT-001
title: "Helpful Water B: bottle cartridge market and viability"
project: "Helpful Water B: bottle cartridge"
doc_type: Market and viability
version: "0.1"
status: Draft
date: 2026-11-11
author: Amish Chadha
license: CC-BY-4.0
revisions:
  - version: "0.1"
    date: 2026-11-11
    author: Amish Chadha
    change: "Solution B market note citing HWP-MKT-001, with the B1 BOM cost and cost per litre over life"
---

# Helpful Water B: bottle cartridge market and viability
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
