BoujeeEnjinia1701/helpful-water/solutions/C-gravity/docs/07-regulatory.md

---
doc_id: HWC-REG-001
title: "Helpful Water C: household gravity filter regulatory and standards register"
project: "Helpful Water C: household gravity filter"
doc_type: Regulatory register
version: "0.1"
status: Draft
date: 2026-11-11
author: Amish Chadha
license: CC-BY-4.0
revisions:
  - version: "0.1"
    date: 2026-11-11
    author: Amish Chadha
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
