BoujeeEnjinia1701/helpful-water/solutions/A-straw/cad/drawings/HWA-DWG-001.png

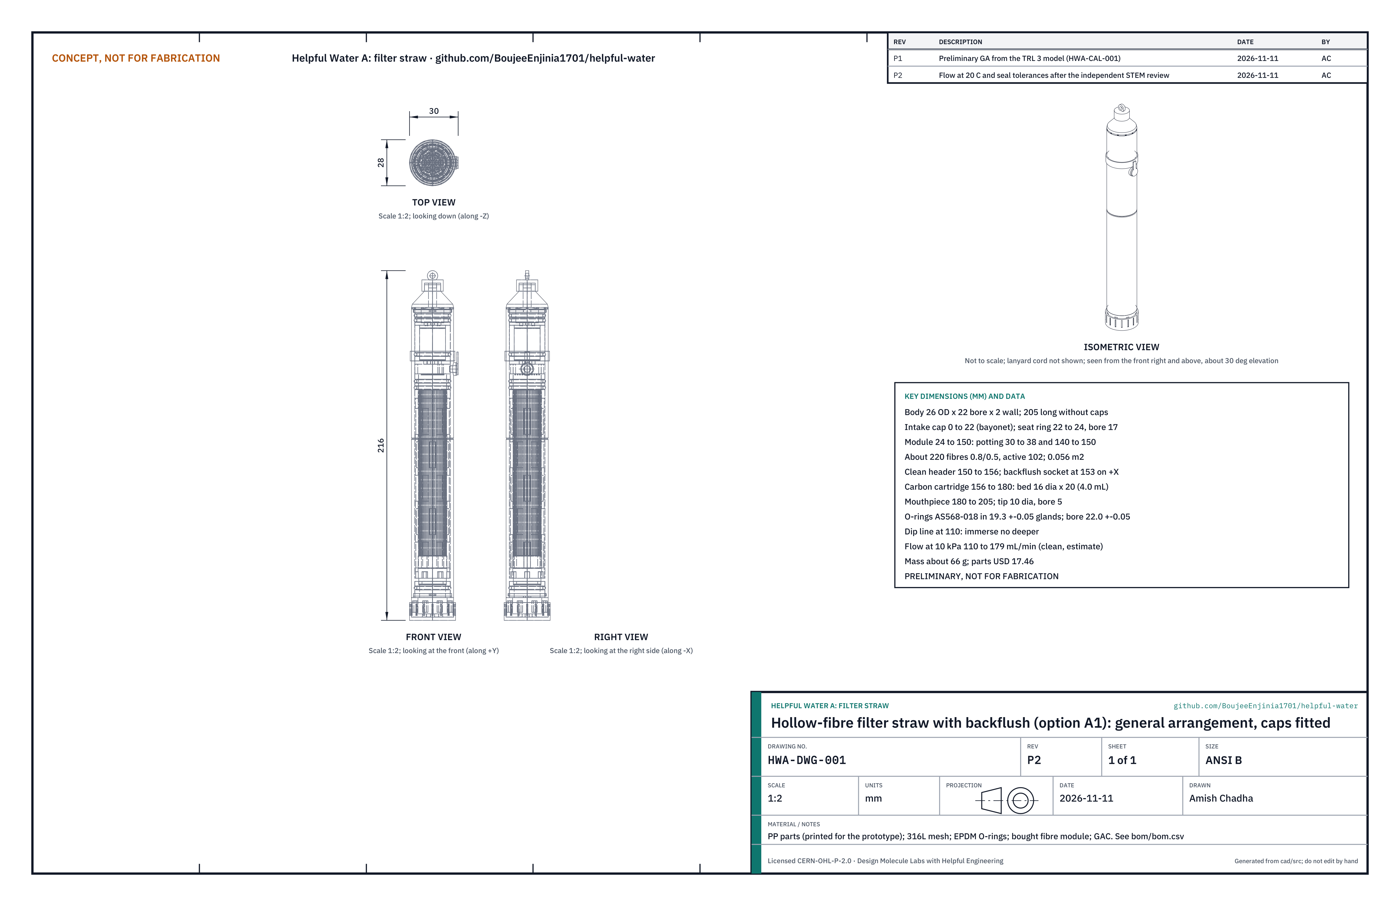
solutions/A-straw/cad/drawings/HWA-DWG-001.png
