BoujeeEnjinia1701/helpful-water/solutions/A-straw/cad/drawings/HWA-DWG-002.png

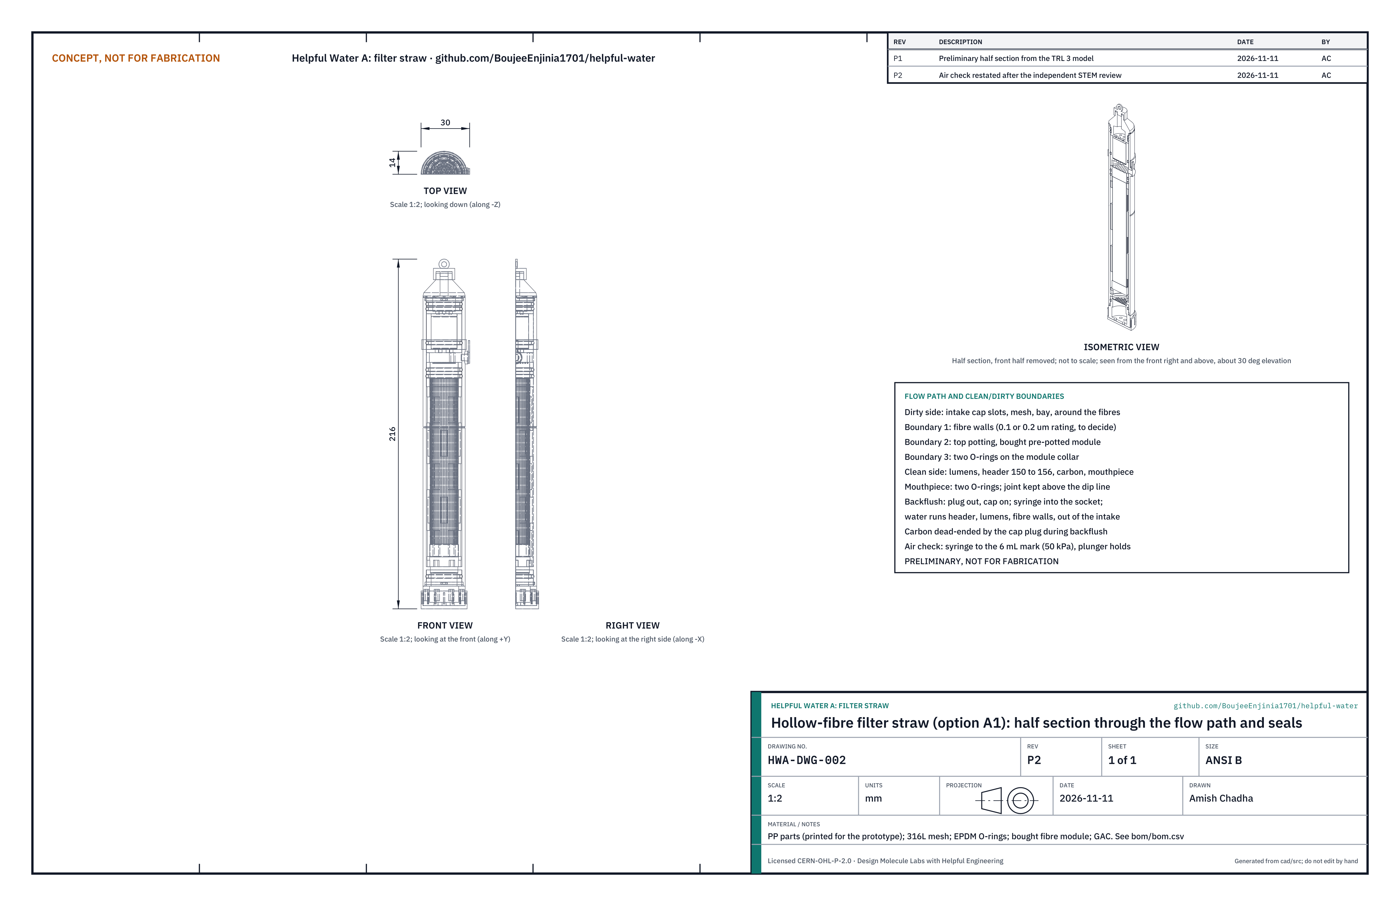
solutions/A-straw/cad/drawings/HWA-DWG-002.png
