BoujeeEnjinia1701/helpful-water/solutions/A-straw/media/card.png

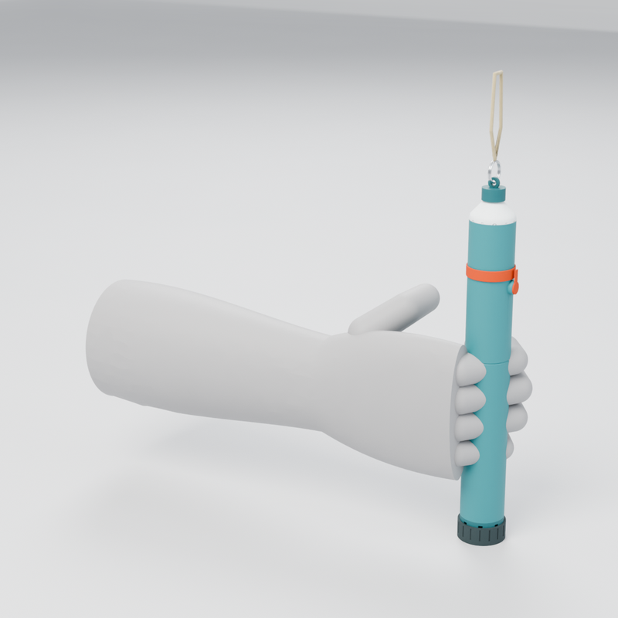
solutions/A-straw/media/card.png
