BoujeeEnjinia1701/helpful-water/solutions/A-straw/media/concept-blueprint.png

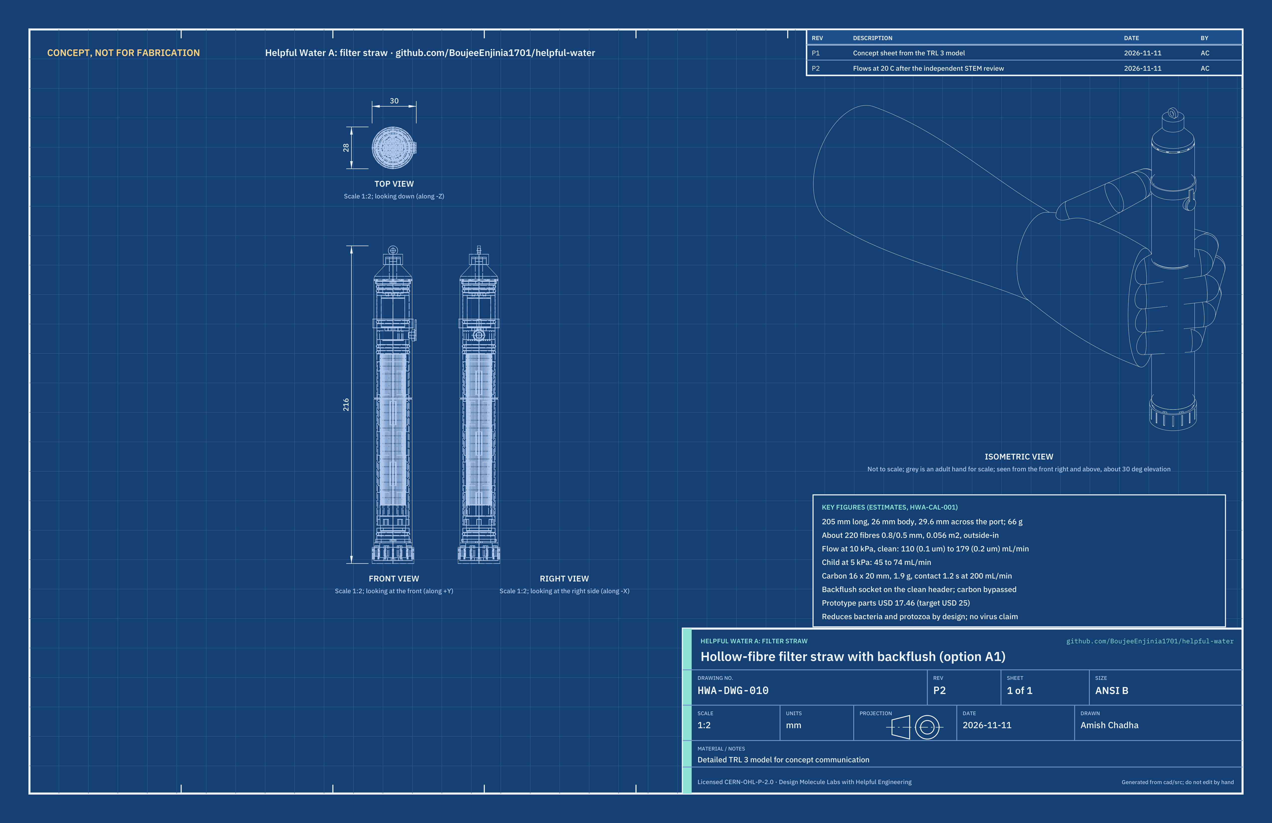
solutions/A-straw/media/concept-blueprint.png
