BoujeeEnjinia1701/helpful-water/solutions/A-straw/media/exploded.png

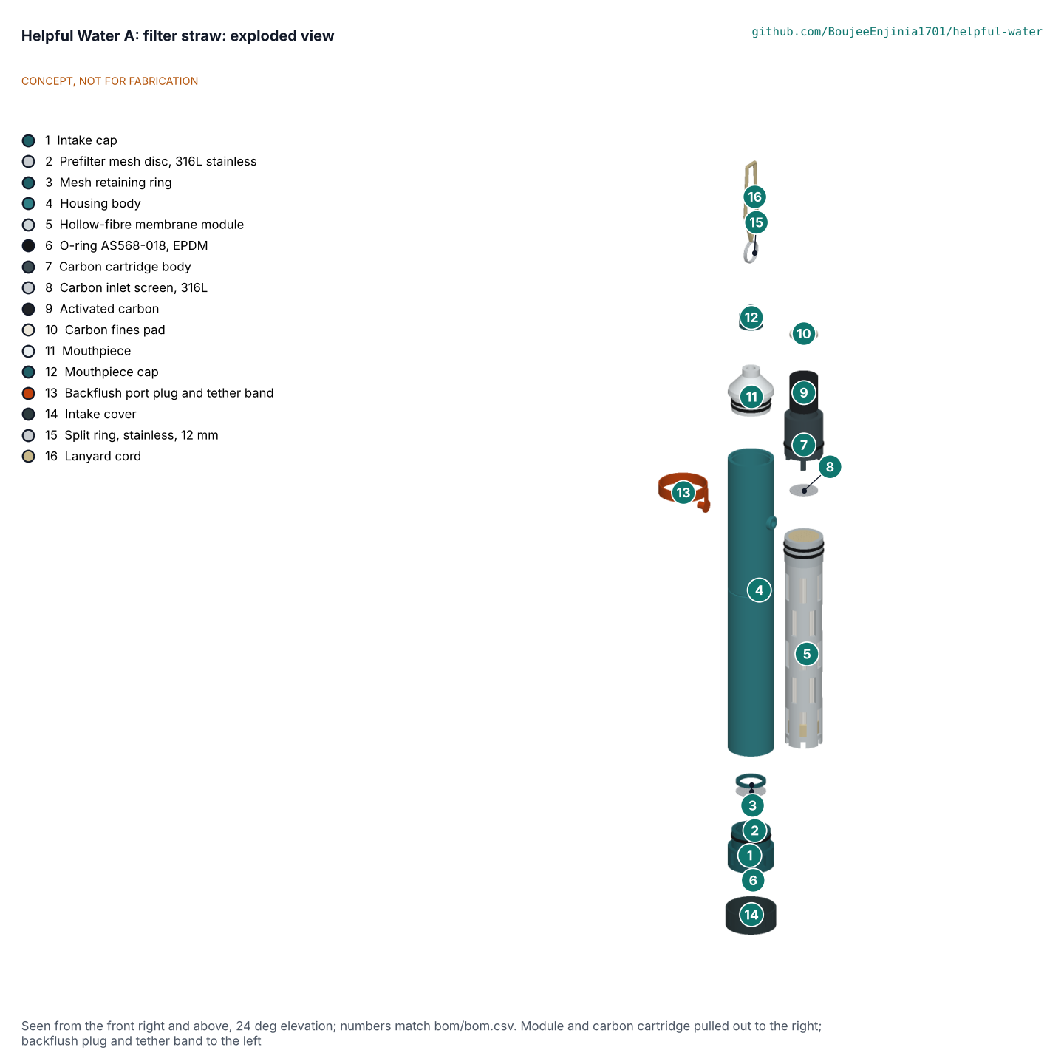
solutions/A-straw/media/exploded.png
