BoujeeEnjinia1701/helpful-water/solutions/A-straw/media/hero.png

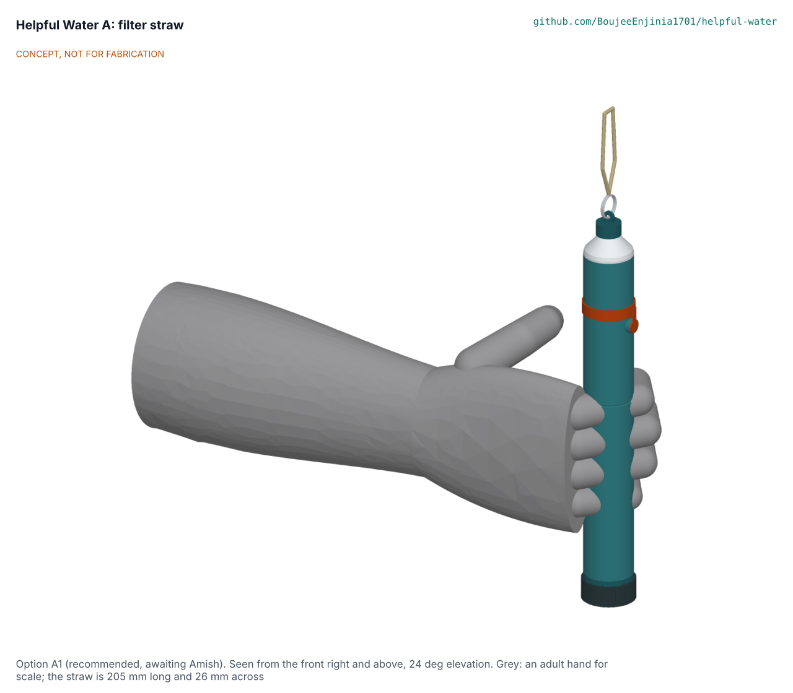
solutions/A-straw/media/hero.png
