BoujeeEnjinia1701/helpful-water/solutions/A-straw/media/render-cutaway.png

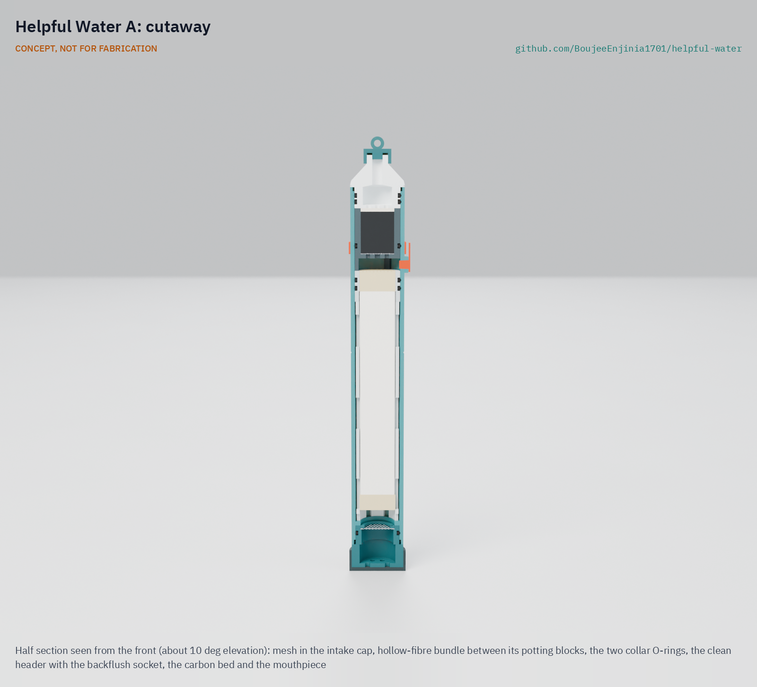
solutions/A-straw/media/render-cutaway.png
