BoujeeEnjinia1701/helpful-water/solutions/A-straw/media/render-exploded.png

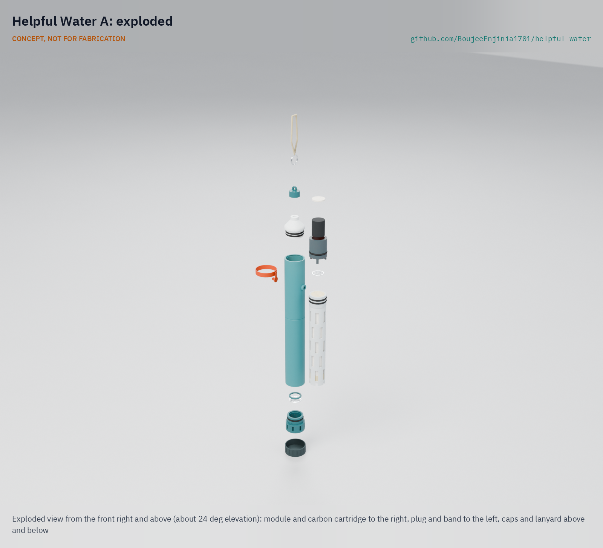
solutions/A-straw/media/render-exploded.png
