BoujeeEnjinia1701/helpful-water/solutions/A-straw/media/render-studio.png

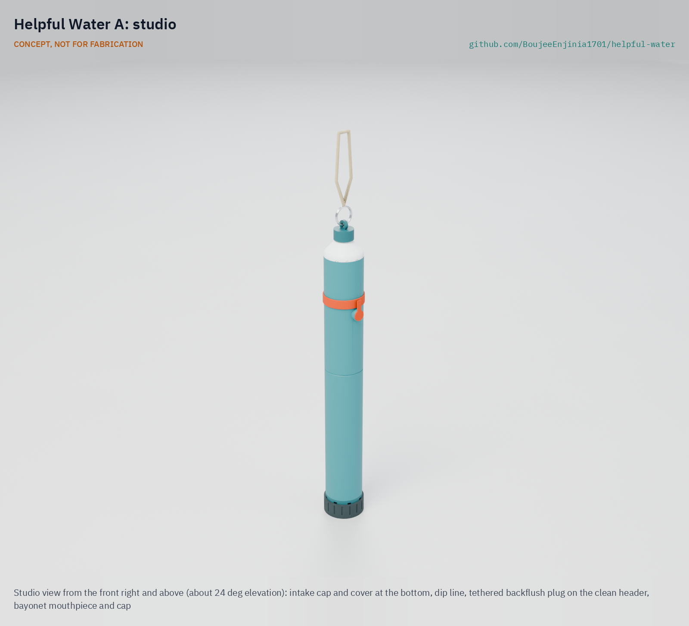
solutions/A-straw/media/render-studio.png
