BoujeeEnjinia1701/helpful-water/solutions/A-straw/media/social-preview.png

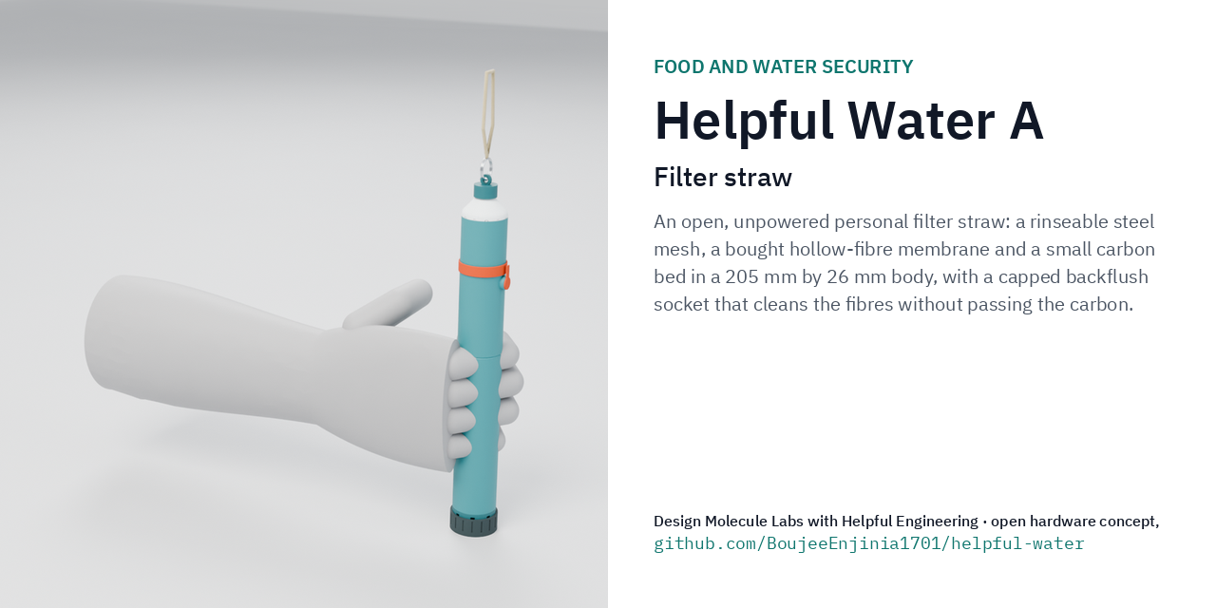
solutions/A-straw/media/social-preview.png
