BoujeeEnjinia1701/helpful-water/solutions/B-bottle-cartridge/media/card.png

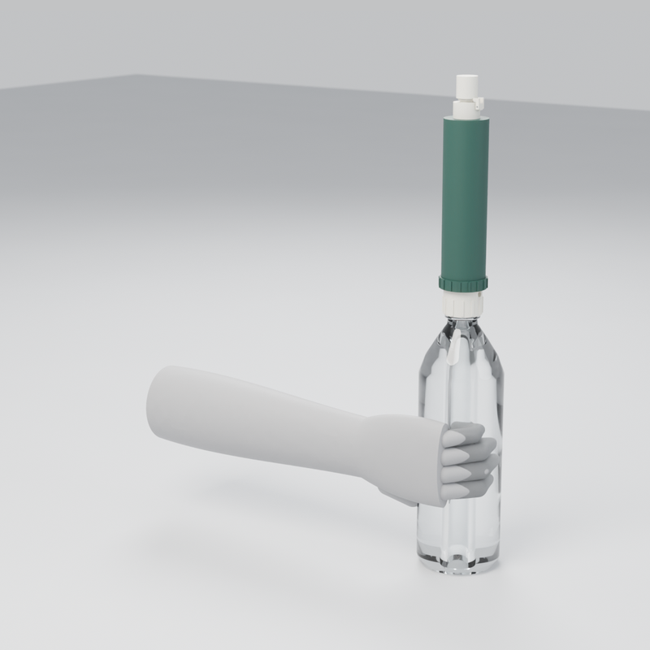
solutions/B-bottle-cartridge/media/card.png
