BoujeeEnjinia1701/helpful-water/solutions/B-bottle-cartridge/media/concept-blueprint.png

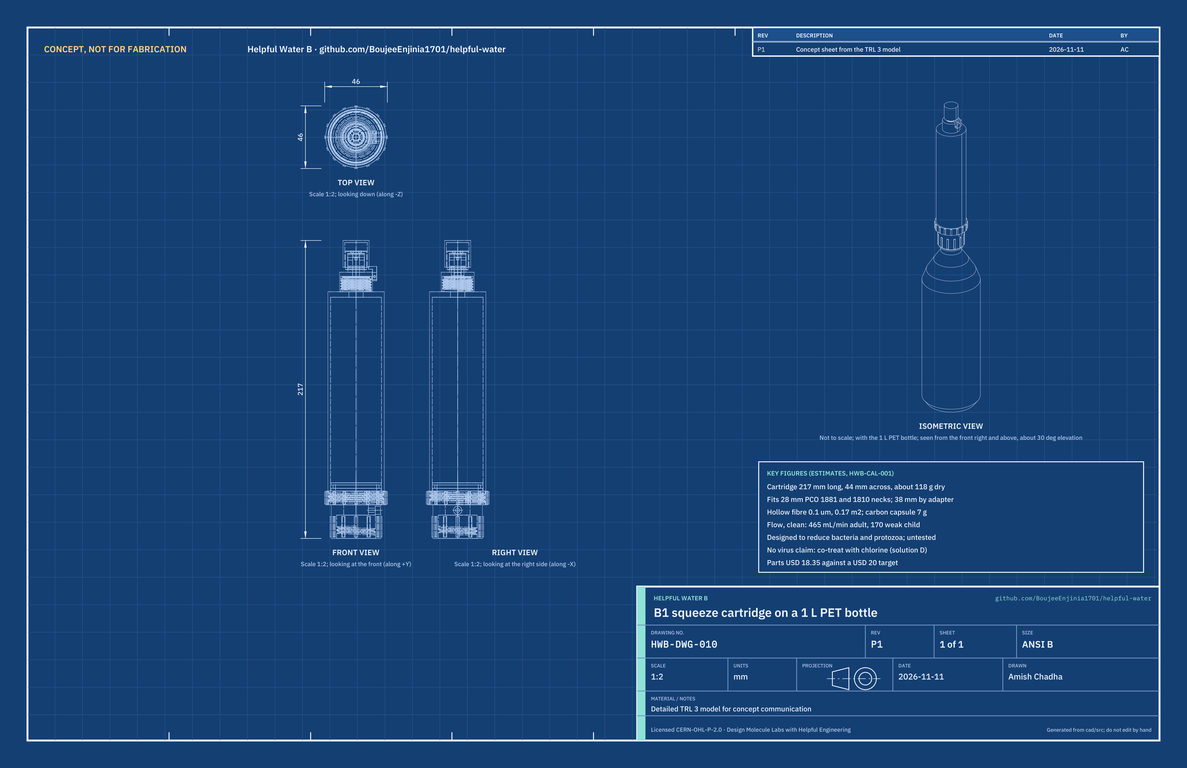
solutions/B-bottle-cartridge/media/concept-blueprint.png
