BoujeeEnjinia1701/helpful-water/solutions/B-bottle-cartridge/media/exploded.png

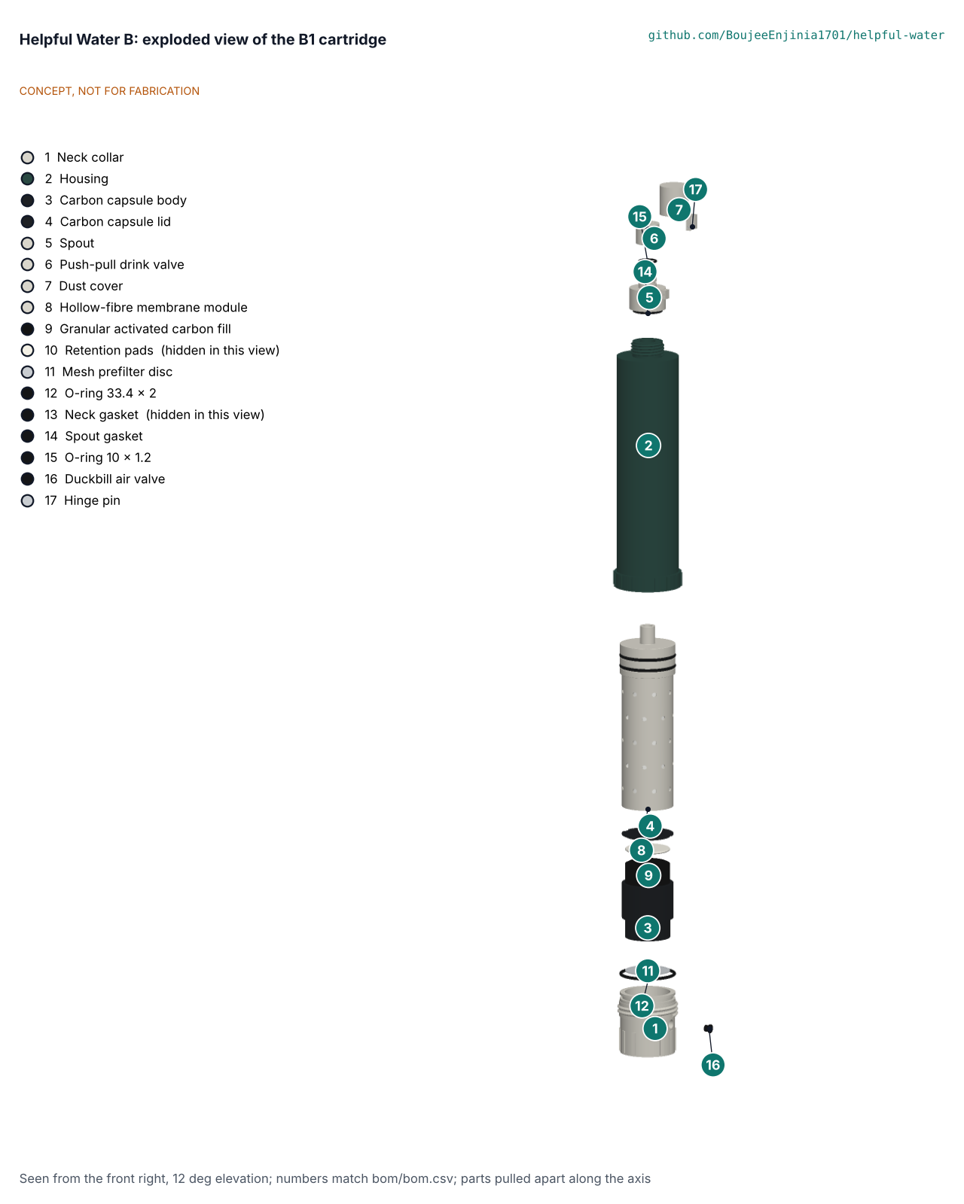
solutions/B-bottle-cartridge/media/exploded.png
