BoujeeEnjinia1701/helpful-water/solutions/B-bottle-cartridge/media/render-exploded.png

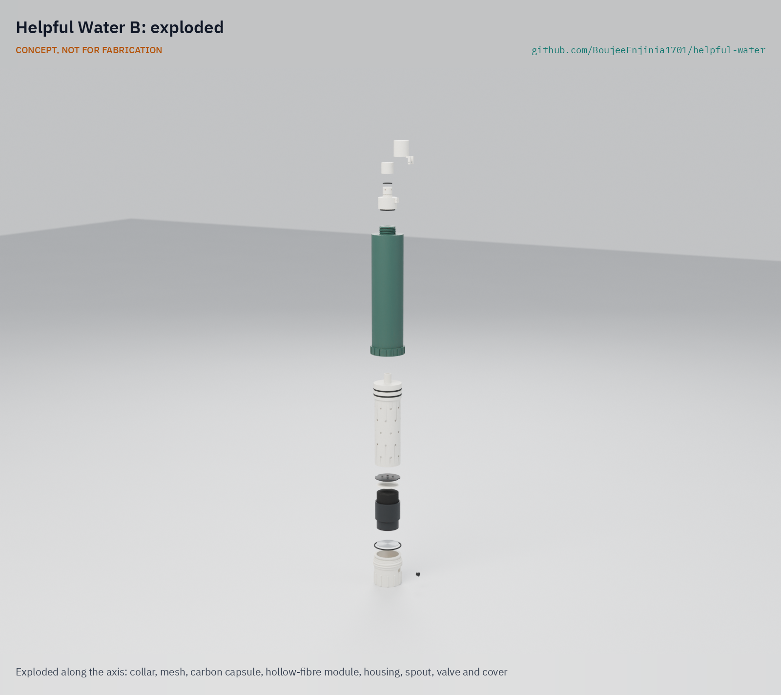
solutions/B-bottle-cartridge/media/render-exploded.png
