BoujeeEnjinia1701/helpful-water/solutions/B-bottle-cartridge/media/render-studio.png

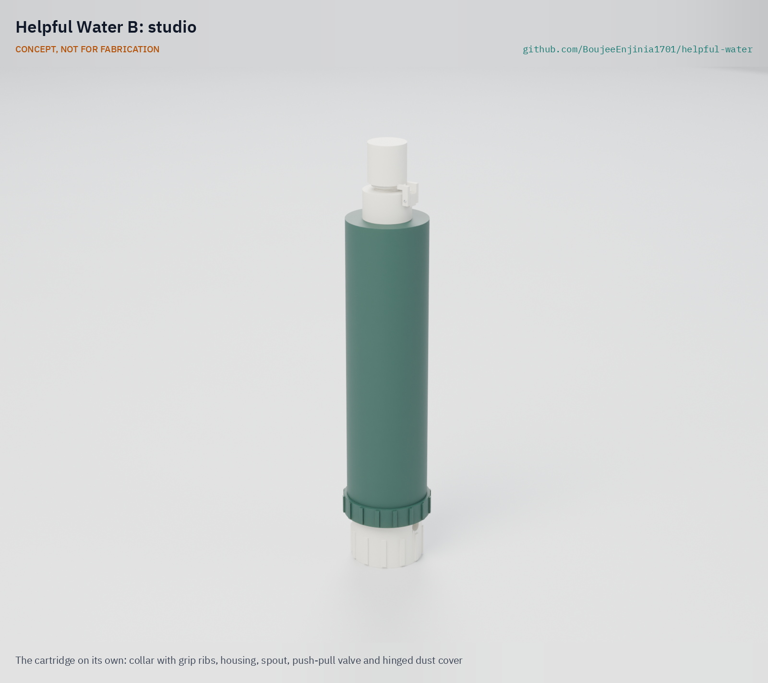
solutions/B-bottle-cartridge/media/render-studio.png
