BoujeeEnjinia1701/helpful-water/solutions/B-bottle-cartridge/media/social-preview.png

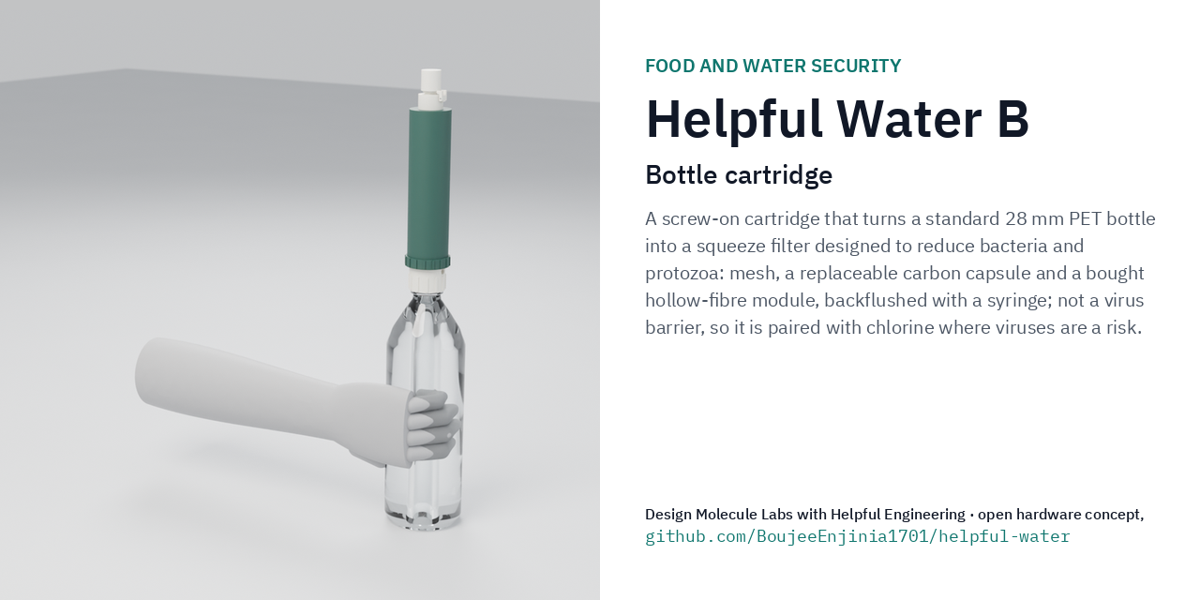
solutions/B-bottle-cartridge/media/social-preview.png
