BoujeeEnjinia1701/helpful-water/solutions/C-gravity/cad/drawings/HWC-DWG-001.png

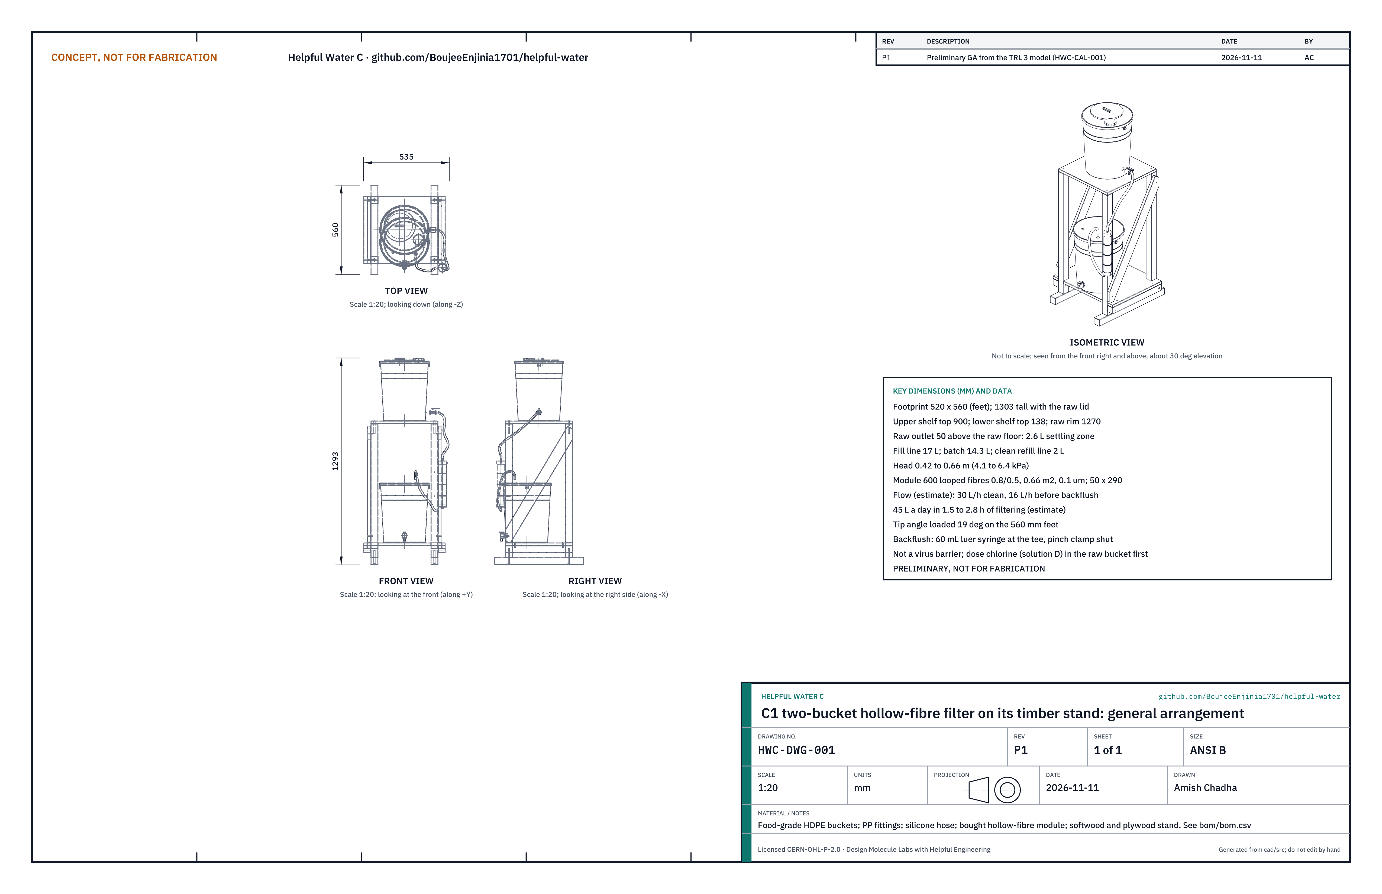
solutions/C-gravity/cad/drawings/HWC-DWG-001.png
