BoujeeEnjinia1701/helpful-water/solutions/C-gravity/media/card.png

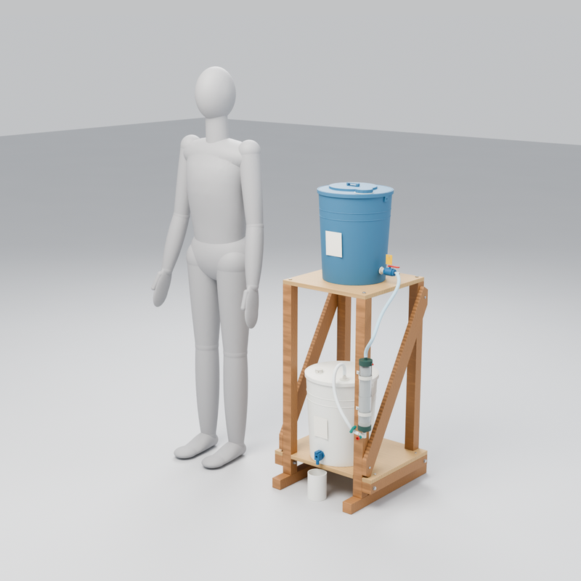
solutions/C-gravity/media/card.png
