BoujeeEnjinia1701/helpful-water/solutions/C-gravity/media/concept-blueprint.png

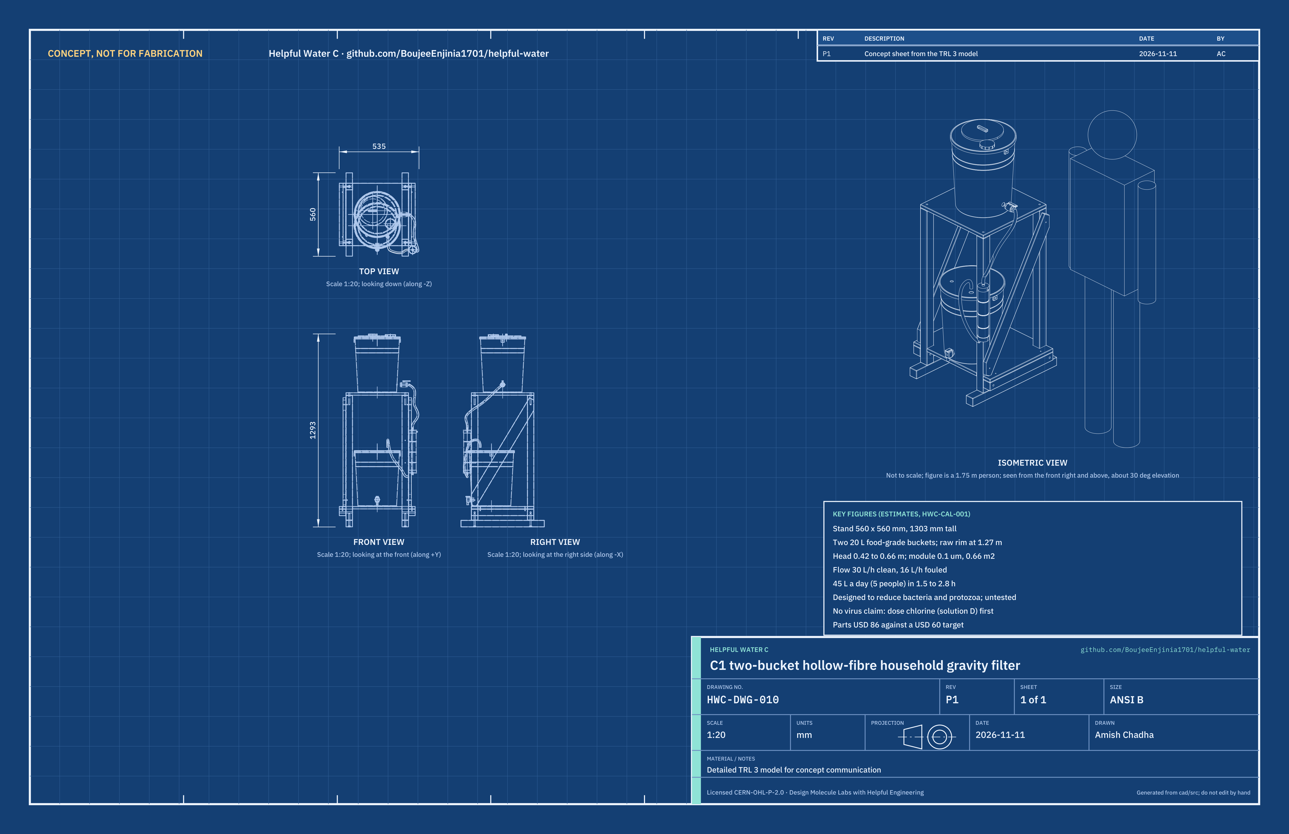
solutions/C-gravity/media/concept-blueprint.png
