BoujeeEnjinia1701/helpful-water/solutions/C-gravity/media/cutaway.png

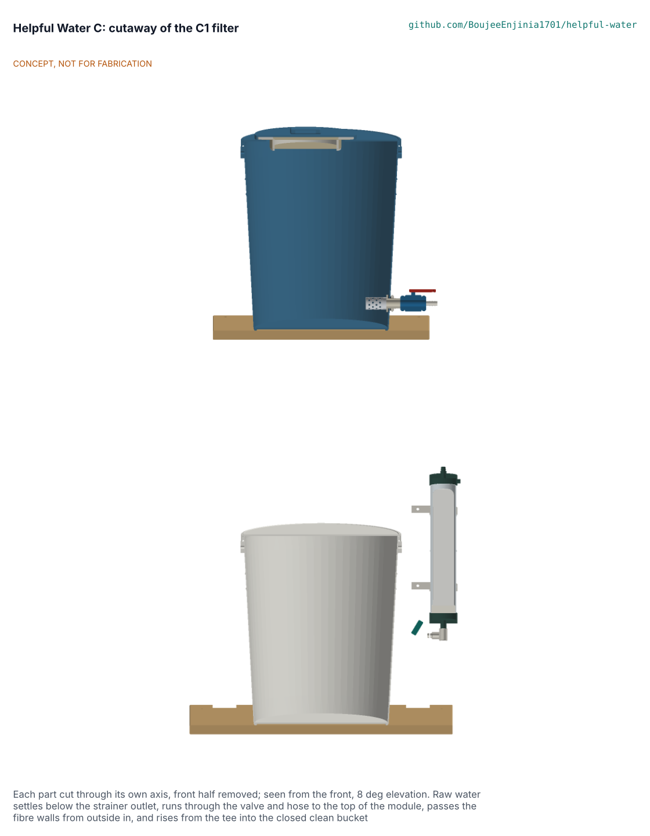
solutions/C-gravity/media/cutaway.png
