BoujeeEnjinia1701/helpful-water/solutions/C-gravity/media/exploded.png

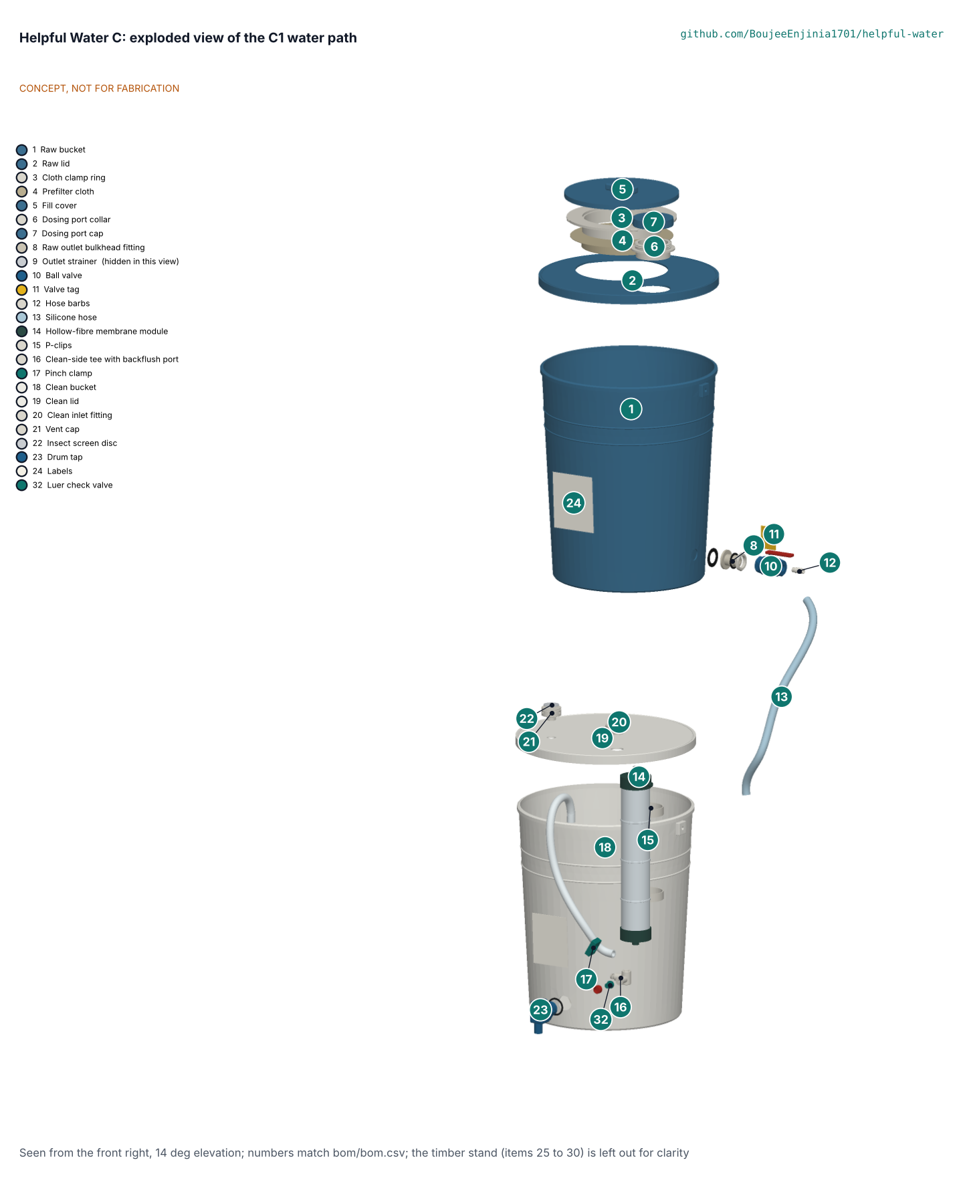
solutions/C-gravity/media/exploded.png
