BoujeeEnjinia1701/helpful-water/solutions/C-gravity/media/flow.png

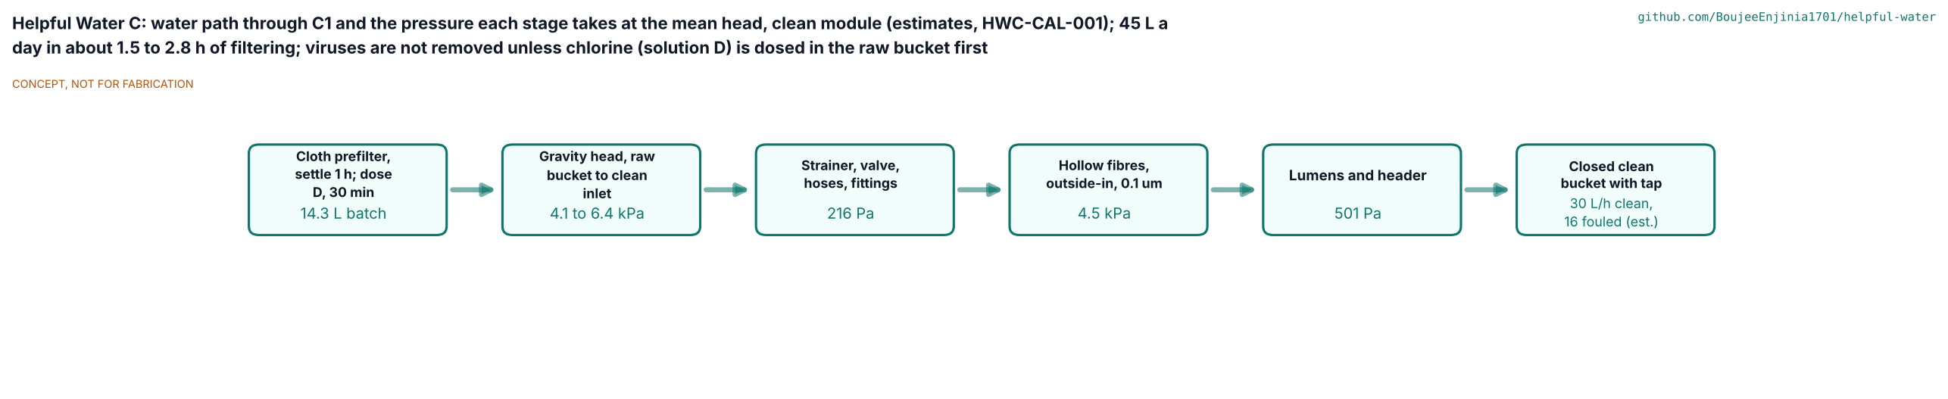
solutions/C-gravity/media/flow.png
