BoujeeEnjinia1701/helpful-water/solutions/C-gravity/media/render-exploded.png

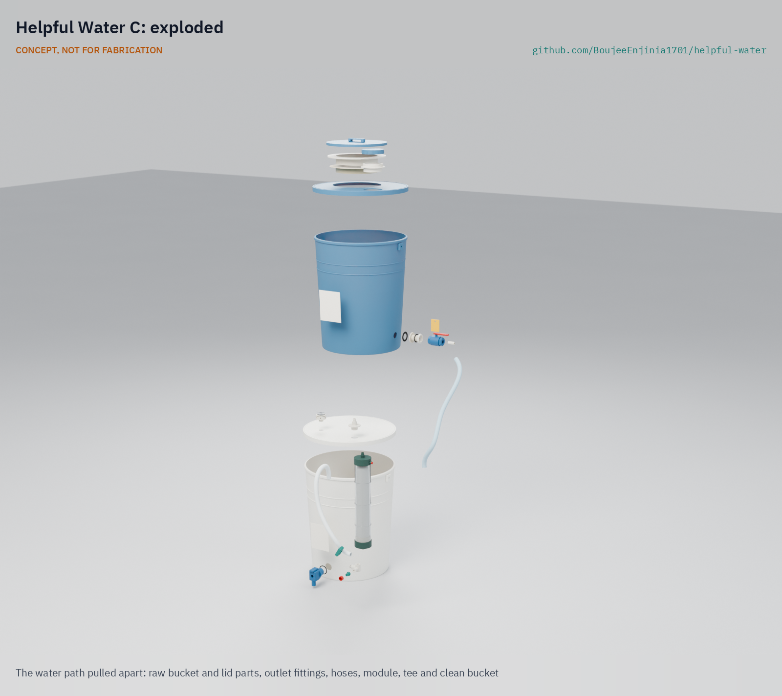
solutions/C-gravity/media/render-exploded.png
