BoujeeEnjinia1701/helpful-water/solutions/C-gravity/media/render-studio.png

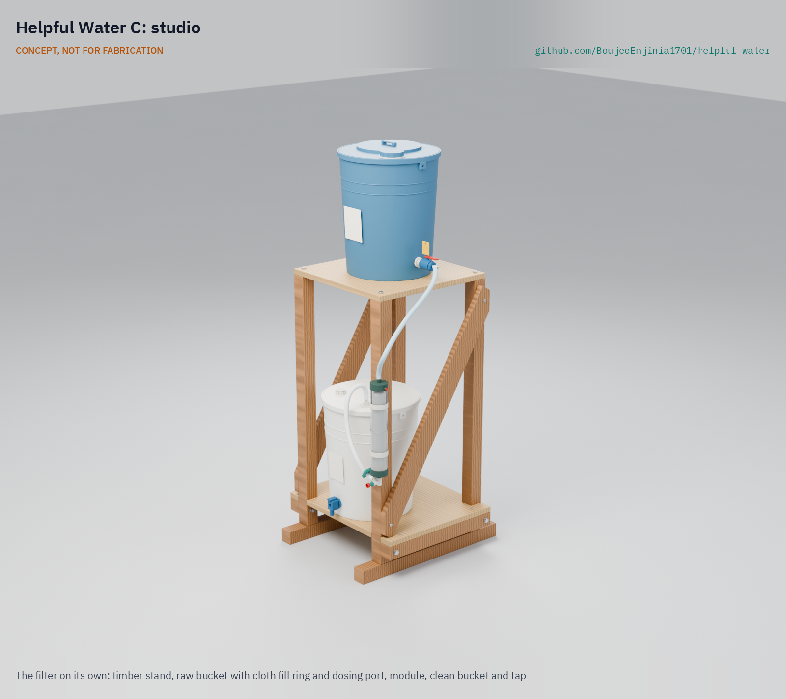
solutions/C-gravity/media/render-studio.png
