BoujeeEnjinia1701/helpful-water/solutions/C-gravity/media/social-preview.png

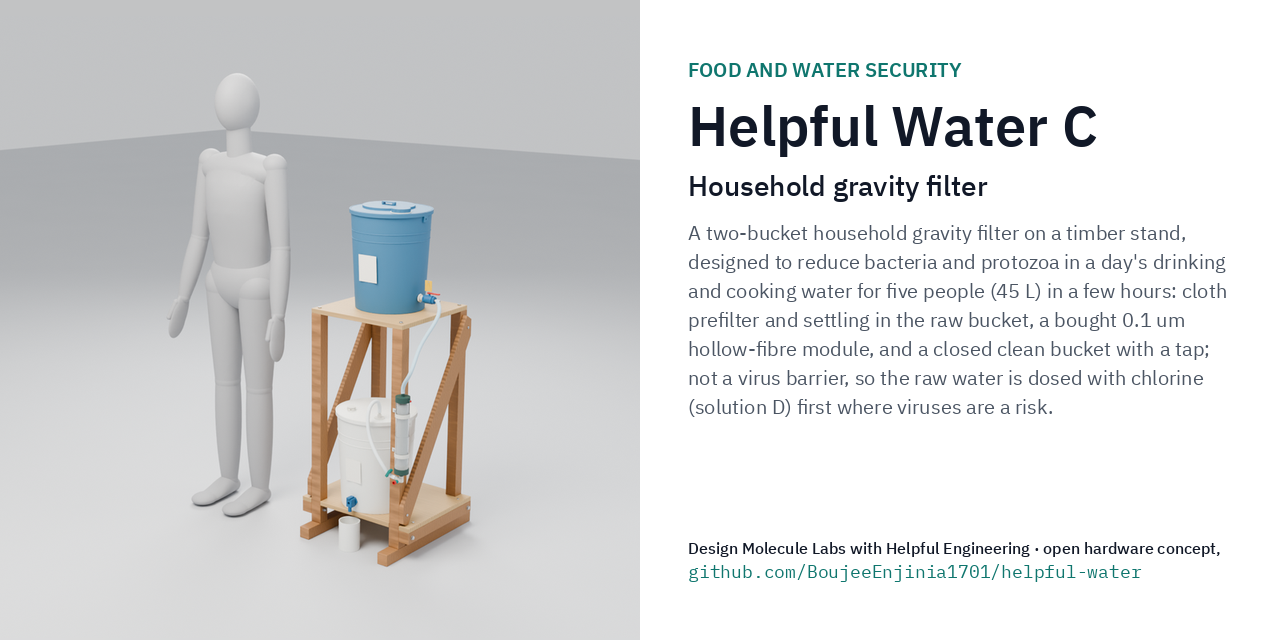
solutions/C-gravity/media/social-preview.png
