BoujeeEnjinia1701/helpful-water/solutions/D-virus-add-on/cad/drawings/HWD-DWG-002.png

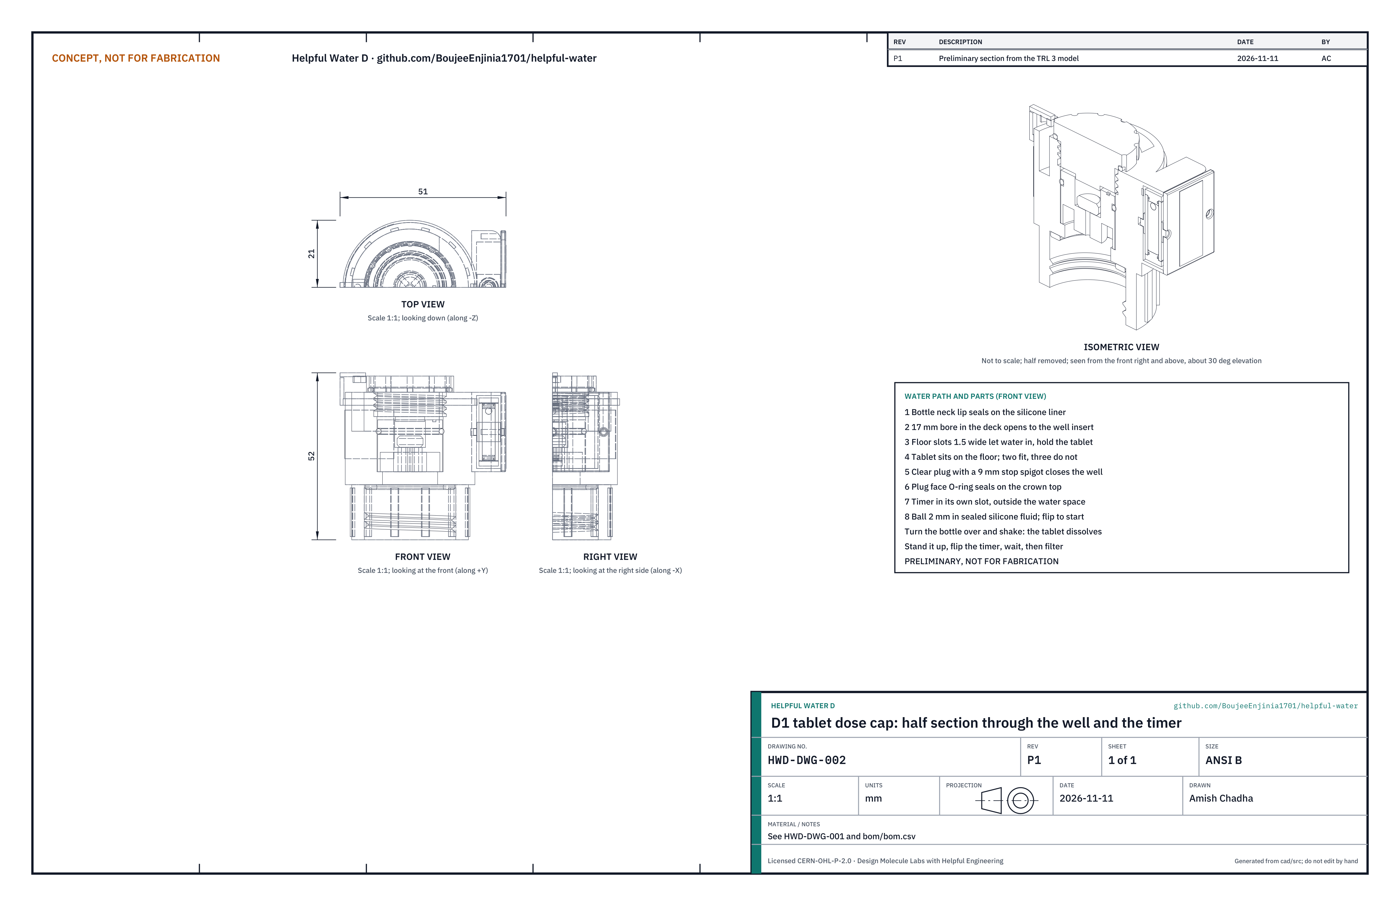
solutions/D-virus-add-on/cad/drawings/HWD-DWG-002.png
