BoujeeEnjinia1701/helpful-water/solutions/D-virus-add-on/media/card.png

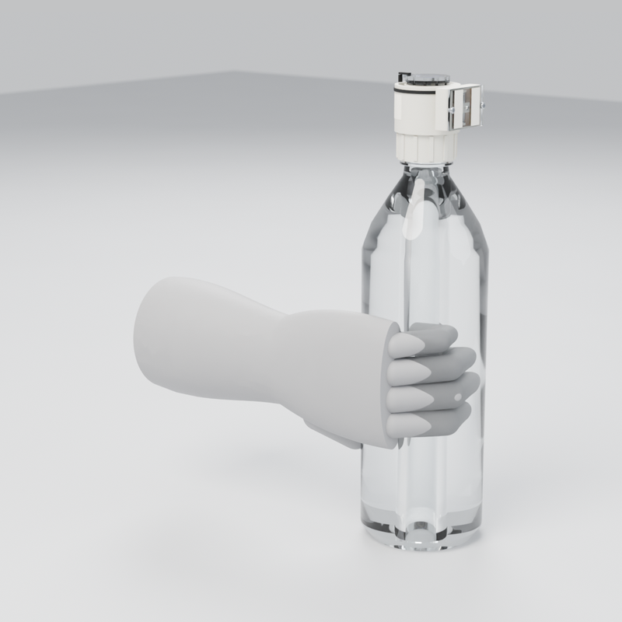
solutions/D-virus-add-on/media/card.png
