BoujeeEnjinia1701/helpful-water/solutions/D-virus-add-on/media/hero.png

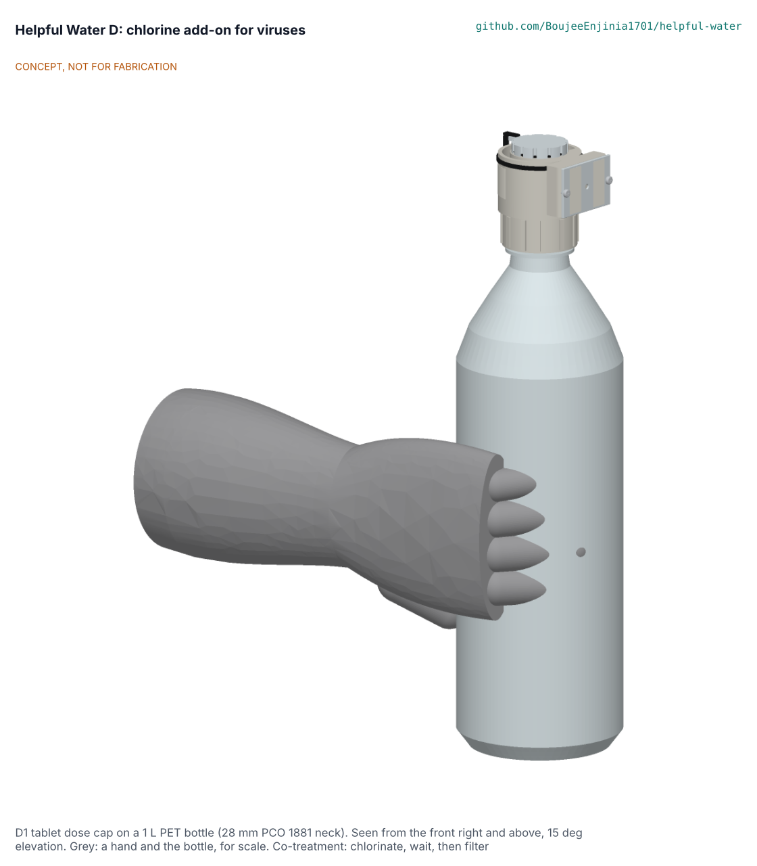
solutions/D-virus-add-on/media/hero.png
