BoujeeEnjinia1701/helpful-water/solutions/D-virus-add-on/media/render-exploded.png

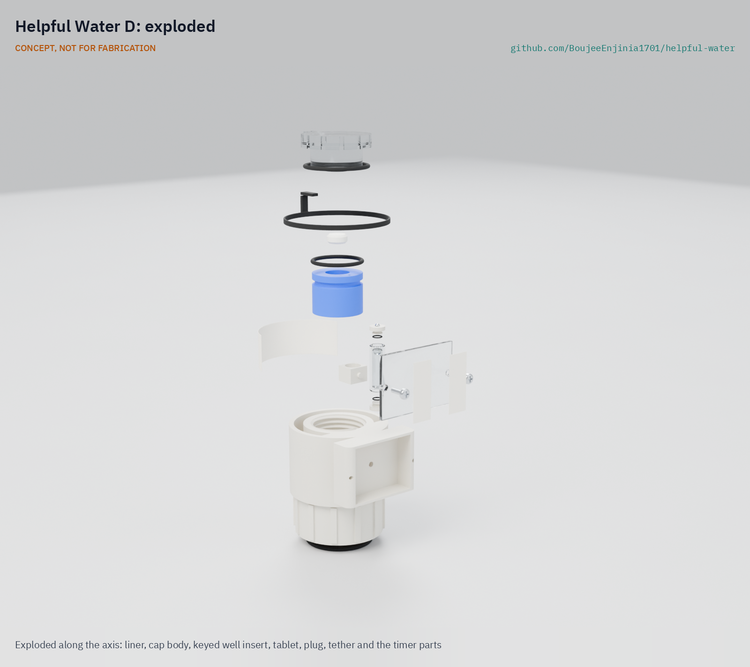
solutions/D-virus-add-on/media/render-exploded.png
