BoujeeEnjinia1701/helpful-water/solutions/D-virus-add-on/media/render-studio.png

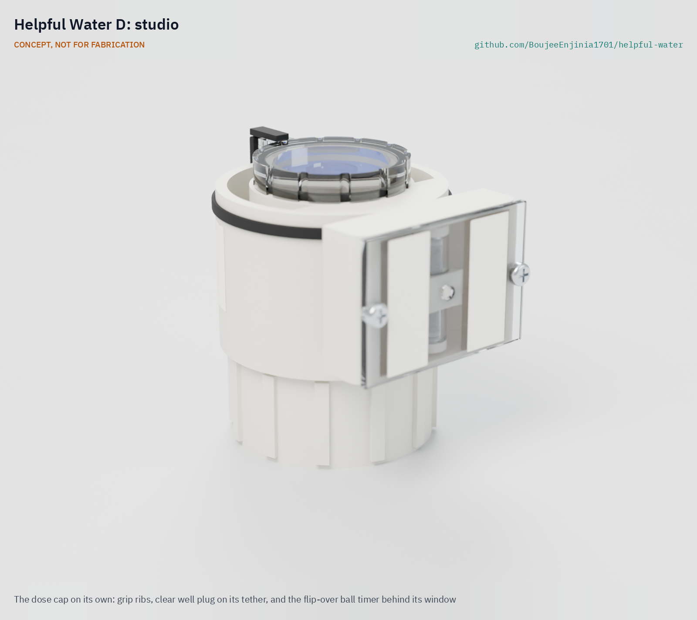
solutions/D-virus-add-on/media/render-studio.png
