BoujeeEnjinia1701/helpful-water/solutions/D-virus-add-on/media/social-preview.png

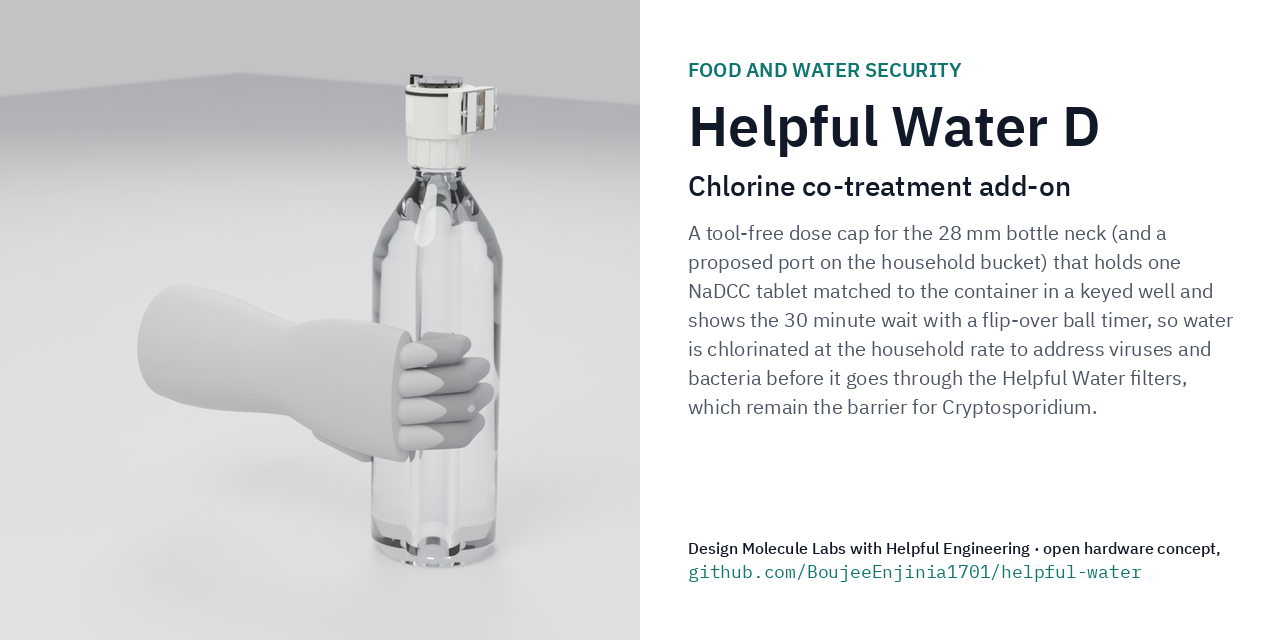
solutions/D-virus-add-on/media/social-preview.png
