BoujeeEnjinia1701/helpful-water/solutions/A-straw/bom/bom.csv

item | qty | spec | supplier | unit_cost_usd | make_buy | notes
1 Intake cap | 1 | Polypropylene; head 26 mm OD x 12 mm with eight 2.5 x 7 mm side slots and six 2.5 mm bottom holes; spigot 21.8 mm OD x 10 mm with two bayonet lugs, one O-ring gland (floor 19.3 +- 0.05 mm turned or sanded, 2.4 mm wide) and a 17 mm counterbore for the mesh disc; about 3 g | 3D printing service or makerspace (PP or PETG filament for the prototype; injection-moulded PP at scale) | 1.00 | make | Estimate: about 3 g of filament at USD 0.03/g plus printer time; not a quote
2 Prefilter mesh disc, 316L stainless | 1 | Woven 316L wire mesh, 250 um aperture (about 60 mesh), cut to a 17 mm disc; 150 and 350 um discs for the Rev A design of experiments | Wire-cloth stockist (pre-cut mesh discs) | 0.40 | buy | Estimate for small packs of pre-cut discs; material certificate required (HWP-REG-001 W7)
3 Mesh retaining ring | 1 | Polypropylene ring 17 mm OD x 13 mm ID x 1.6 mm, press fit over the mesh disc in the intake cap counterbore | 3D printing service or makerspace | 0.10 | make | Estimate
4 Housing body | 1 | Polypropylene tube 26 mm OD x 22 mm bore (22.0 +- 0.05 mm reamed where O-rings run) x 178 mm with internal seat ring (17 mm bore) at 22 to 24 mm, bayonet grooves and entry slots at both ends, dip-line groove at 110 mm, backflush socket boss on the header at 153 mm (luer-slip taper 4.3 to 3.9 mm, 2 mm passage); about 27 g | 3D printing service or makerspace (PP or PETG for dry fit; injection-moulded PP at scale) | 2.50 | make | Estimate: filament and printer time; 3D-printed parts are for fit and known potable test water only (HWA-BLD-001)
5 Hollow-fibre membrane module (pre-potted) | 1 | Outside-in hollow-fibre microfiltration or ultrafiltration module: about 220 hydrophilic fibres 0.8 mm OD x 0.5 mm ID, 102 mm active length (about 0.055 m2 outer area), far ends closed in an 8 mm bottom potting, lumens open in a 10 mm top potting inside a header collar 21.8 mm OD with two O-ring glands; perforated cage 21 mm OD; supplier states absolute or nominal rating, clean-water permeability at 20 C, integrity test method and maximum backflush pressure | Hollow-fibre membrane module maker (straw or inline filter cores) | 8.00 | buy | Estimate: Membrane Solutions WS02 straw replacement set (UF element plus carbon) lists at USD 15.99 for two sets (simpurelife.com, checked 2026-11-11), so about USD 6 to 8 per element; a module to this drawing needs a supplier quote (HWA-DEC-001 C1)
6 O-ring AS568-018, EPDM | 6 | 18.77 mm ID x 1.78 mm cross-section (AS568-018), peroxide-cured EPDM 70 Shore A to a drinking-water material listing; one on the intake cap, two on the module collar, one on the carbon cartridge, two on the mouthpiece | O-ring distributor | 0.25 | buy | Estimate for small quantities; size from the AS568 table (Prepol, checked 2026-11-11); compound certificate required (NSF/ANSI/CAN 61, HWP-REG-001 W7)
7 Carbon cartridge body | 1 | Polypropylene cup 21.8 mm OD x 24 mm with a 16 mm bore, inlet grid (six 2 mm and one 2.5 mm hole), one O-ring gland at 6 mm from the bottom (floor 19.3 +- 0.05 mm) and three 6 mm legs that stand on the module collar | 3D printing service or makerspace | 0.50 | make | Estimate
8 Carbon inlet screen, 316L | 1 | Woven 316L mesh, 150 um aperture, 16 mm disc, under the carbon bed | Wire-cloth stockist (pre-cut mesh discs) | 0.30 | buy | Estimate
9 Activated carbon (granular) | 2 | Coconut-shell granular activated carbon 12 x 40 mesh (0.42 to 1.68 mm), apparent density 0.48 to 0.50 g/mL, drinking-water grade, pre-rinsed; 2.0 g fills the 16 x 20 mm bed (4.0 mL); quantity in grams | Water-treatment media supplier | 0.03 | buy | Estimate USD 30/kg for a small bag of certified media (USD 0.06 a cartridge); density from the 12 x 40 coconut shell specification sheet (Envirosupply, checked 2026-11-11)
10 Carbon fines pad | 1 | Non-woven polypropylene pad, permanently hydrophilic-treated (no leachable surfactant), about 20 um nominal, 16 mm disc x 1.6 mm, on top of the carbon bed | Filter media supplier | 0.10 | buy | Estimate; permeability and wetting to be measured (HWA-CAL-001 assumption A6; HWA-DEC-001 F6, C6)
11 Mouthpiece | 1 | Polypropylene; spigot 21.8 mm OD x 10 mm with outlet grid, two O-ring glands (floors 19.3 +- 0.05 mm) and two bayonet lugs; collar 26 mm with grip ribs; taper to a 10 mm tip with a 5 mm bore; about 5 g | 3D printing service or makerspace (moulded PP or food-grade silicone overmould at scale) | 1.00 | make | Estimate
12 Mouthpiece cap | 1 | Polypropylene snap cap over the 10 mm tip with a 4.9 mm plug that seals the bore (dead-ends the carbon during backflush) and a lanyard eye | 3D printing service or makerspace | 0.40 | make | Estimate
13 Backflush port plug and tether band | 1 | Cast silicone, Shore 50 A: tapered plug for the 4.3 mm socket on a strap, joined to a band 26 mm ID x 6 mm round the housing | Makerspace (cast in a printed mould) or silicone moulder | 0.60 | make | Estimate: about 1.5 g of platinum-cure silicone
14 Intake cover | 1 | Silicone cup 28.4 mm OD over the intake cap for carrying and storage | Makerspace (cast in a printed mould) or silicone moulder | 0.40 | make | Estimate
15 Split ring, stainless, 12 mm | 1 | Stainless steel split key ring, 12 mm, 1 mm wire | Hardware or craft supplier | 0.10 | buy | Estimate
16 Lanyard cord | 1 | Polyester cord 2 mm x 450 mm, knotted loop | Hardware or craft supplier | 0.20 | buy | Estimate
17 Backflush syringe | 1 | 20 mL luer-slip syringe (polypropylene), with a 6 mL mark for the air check (HWA-DEC-001 F7); filled only with treated water for backflush (F11) | Medical or laboratory consumables supplier | 0.30 | buy | Estimate; not modelled; accessory needed for cleaning (HWA-DEC-001 D5)
