BoujeeEnjinia1701/helpful-water/solutions/B-bottle-cartridge/bom/bom.csv

item | qty | spec | supplier | unit_cost_usd | make_buy | notes
1 Neck collar | 1 | Polypropylene (food-contact grade), 36 mm across x 40.5 mm; female 28 mm PCO 1881 thread inside a 17 mm skirt, deck with 18 mm inlet bore and 3 mm radial air bore with a 6 mm counterbore, male 40 mm x 3 mm spigot thread, seal land with O-ring groove; about 16 g | Local 3D print service or makerspace (FDM in PP or PETG for the prototype; injection moulded at scale) | 1.60 | make | Estimate: 16 g x USD 0.035/g filament plus USD 1.00 machine time (not a quote)
2 Housing | 1 | Polypropylene, 41 mm across (44 mm grip band, 46 mm over its ribs) x 165 mm; female 40 mm x 3 mm thread, 37 mm bore, 4 mm end wall with 10.4 mm bore, male 20 mm x 2 mm spout spigot; 16 grip ribs; about 64 g | Local 3D print service | 4.70 | make | Estimate: 64 g x USD 0.035/g plus USD 2.50 machine time; the largest printed part (not a quote)
3 Carbon capsule body | 1 | Polypropylene cup 34 mm across x 37 mm, 29.8 mm plug spigot, floor with seven 3 mm holes; about 7 g | Local 3D print service | 0.75 | make | Estimate: 7 g x USD 0.035/g plus USD 0.50 machine time
4 Carbon capsule lid | 1 | Polypropylene plug lid 34 mm flange, seven holes, two finger notches; about 1.5 g | Local 3D print service | 0.55 | make | Estimate: printed with item 3
5 Spout | 1 | Polypropylene, 24 mm across x 27 mm; female 20 mm x 2 mm thread, 12 mm nozzle with 5 mm bore, O-ring groove and four 2 mm side ports, hinge lug with 1.6 mm pin hole; about 3 g | Local 3D print service | 0.60 | make | Estimate
6 Push-pull drink valve | 1 | Polypropylene sleeve 15.4 mm across x 13.6 mm with 4.9 mm sealing plug and four 2 mm outlet holes; about 1 g | Local 3D print service | 0.50 | make | Estimate; a bought sports-cap valve of the same bore is an alternative
7 Dust cover | 1 | Polypropylene cap 19 mm across x 20 mm with two hinge cheeks; about 1.6 g | Local 3D print service | 0.55 | make | Estimate
8 Hollow-fibre membrane module (bought pre-potted) | 1 | Pre-potted, integrity-tested outside-in module: 400 looped fibres, 0.8 mm outside and 0.5 mm inside diameter, 0.1 um nominal (absolute rating to state), hydrophilic PVDF or PES shipped wet or with a wetting agent; 86.5 mm legs (about 0.17 m2); potted 10 mm deep in a 36.6 mm header with two O-ring grooves and a 10 mm outlet nipple; perforated guard sleeve 34 mm; supplier states clean-water flux at 10 kPa and 20 C, maximum backwash pressure, potting rating for 135 N at 179 kPa, packing limit (design 53 %) and potting penetration, production integrity test, LRV data and NSF/ANSI/CAN 61 status | Membrane module maker supplying point-of-use hollow-fibre modules (request for quotation; no part number chosen) | 6.00 | buy | Estimate for a sample quantity, to confirm by quotation; benchmark: complete retail hollow-fibre straw filters sell at USD 16.99 to 19.99 (Sawyer, Membrane Solutions, checked 2026-11-11)
9 Granular activated carbon fill | 1 | Coconut-shell GAC 12 x 40 US sieve, about 0.49 g/cm3, NSF/ANSI/CAN 61 certified, acid washed; 13.9 mL (about 6.8 g) per capsule | Water treatment media distributor | 0.05 | buy | USD 108.93 per 1 ft3 bag (FreshWaterSystems, SilCarbon 12 x 40 coconut, checked 2026-11-11) at about 13.9 kg per ft3 is USD 7.8/kg; a small pack costs more per gram
10 Retention pads | 2 | Nonwoven polyester (food contact) discs 29.6 mm across x 1.5 mm | Filter media supplier or craft supplier | 0.05 | buy | Estimate: cut from sheet
11 Mesh prefilter disc | 1 | 316L stainless woven mesh, about 150 um aperture, 29.6 mm disc with a pressed rim | Wire cloth supplier | 0.40 | buy | Estimate: cut from a 300 x 300 mm sheet; aperture DOE 100, 150, 250 um
12 O-ring 33.4 x 2 | 3 | EPDM or silicone, drinking-water grade (NSF/ANSI/CAN 61), 33.4 mm inside x 2 mm section; one on the collar, two on the module header | Seal distributor | 0.25 | buy | Estimate from O-ring assortment prices; size to confirm against the module header
13 Neck gasket | 1 | EPDM or silicone sheet 1.5 mm, cut ring 27.6 mm outside x 20.5 mm inside | Seal distributor | 0.10 | buy | Estimate
14 Spout gasket | 1 | EPDM or silicone sheet 1.2 mm, cut ring 19.8 x 11 mm | Seal distributor | 0.10 | buy | Estimate
15 O-ring 10 x 1.2 | 1 | EPDM or silicone, drinking-water grade, 10 mm inside x 1.2 mm section, on the nozzle | Seal distributor | 0.15 | buy | Estimate
16 Duckbill air valve | 1 | Silicone duckbill check valve, 6 mm flange, about 0.5 kPa cracking pressure (to confirm) | Medical or dispensing valve supplier | 0.40 | buy | Estimate; cracking pressure from the supplier data sheet
17 Hinge pin | 1 | Stainless steel pin 1.5 mm x 9 mm (ISO 2338 style) | Fastener supplier | 0.05 | buy | Estimate
18 Backflush syringe | 1 | 60 mL slip-tip syringe, about 26.7 mm bore, tip fits the 5 mm nozzle bore | Pharmacy or medical supplier | 1.00 | buy | Estimate; supplied with the cartridge
