BoujeeEnjinia1701/helpful-water/solutions/C-gravity/bom/bom.csv

item | qty | spec | supplier | unit_cost_usd | make_buy | notes
1 Raw bucket (blue) | 1 | New food-grade HDPE pail, 5 US gal (about 20 L; 300 mm top, 262 mm base, 370 mm tall, assumed typical), FDA food-contact statement; never a reused chemical pail; 32 mm outlet hole drilled 50 mm above the floor; 17 L fill line marked | Packaging distributor or local market | 5.06 | buy | USD 5.06 for a 90 mil food-grade 5 gal HDPE bucket without lid (ePackageSupply, checked 2026-11-11); a blue pail where available, otherwise a blue band painted on
2 Raw lid | 1 | Snap-on HDPE lid for item 1; 160 mm fill hole and 60 mm dosing port hole cut | Packaging distributor | 2.50 | buy | Estimate (lids are sold separately from item 1, not a quote)
3 Cloth clamp ring | 1 | Polypropylene ring 190 mm across, 136 mm bore, 4 mm flange and 22 mm spigot into the fill hole, four grip lugs; about 85 g | Local 3D print service or makerspace (FDM in PP or PETG) | 3.00 | make | Estimate: 85 g x USD 0.025/g filament plus USD 0.90 machine time (not a quote)
4 Prefilter cloth | 2 | Plain-weave cotton cloth (old sari or muslin), 250 x 250 mm, folded to 8 layers; one in use, one drying | Local market | 0.25 | buy | Estimate
5 Fill cover | 1 | Polypropylene cover 198 mm across with a 5 mm skirt and a handle; about 105 g | Local 3D print service | 3.50 | make | Estimate: 105 g x USD 0.025/g plus USD 0.90 (not a quote)
6 Dosing port collar | 1 | Polypropylene collar for the 60 mm lid hole: 76 mm flange, 16 mm spigot, external thread for the cap; the interface for a solution D doser, size to agree with D | Local 3D print service | 1.20 | make | Estimate
7 Dosing port cap | 1 | Polypropylene screw cap 70 mm across with a knurled skirt | Local 3D print service | 1.00 | make | Estimate
8 Raw outlet bulkhead fitting | 1 | 1/2 in polypropylene bulkhead (tank) fitting, 12 mm bore, with nut and two EPDM gaskets, drinking-water grade | Irrigation or aquarium supplier | 3.50 | buy | Estimate from retail polypropylene bulkhead prices (not a quote); EPDM gaskets to NSF/ANSI/CAN 61 where available
9 Outlet strainer | 1 | 316 stainless mesh strainer, about 250 um, push-fit over the inner end of item 8 | Irrigation or brewing supplier | 2.50 | buy | Estimate
10 Ball valve | 1 | 1/2 in polypropylene ball valve with lever, full bore | Irrigation supplier | 4.00 | buy | Estimate; brass is avoided for lead (NSF/ANSI 372)
11 Valve tag | 1 | Polypropylene tag 30 x 40 x 2 mm: SHUT 30 MIN AFTER DOSING pictogram | Local 3D print service | 0.20 | make | Estimate
12 Hose barbs | 2 | 3/8 in hose barb to 1/2 in thread, polypropylene | Irrigation supplier | 0.50 | buy | Estimate
13 Silicone hose | 1.2 | Platinum-cured silicone tube 9.5 mm bore x 14 mm outside (3/8 in), food grade; raw 0.45 m and clean 0.40 m with spare; clear so bubbles show in the air test (unit: metre) | Laboratory or brewing supplier | 2.50 | buy | Estimate per metre (not a quote); plasticised PVC is avoided (leaching)
14 Hollow-fibre membrane module (bought pre-potted) | 1 | Pre-potted, integrity-tested outside-in gravity module: 600 looped fibres, 0.8 mm outside and 0.5 mm inside diameter, 0.1 um nominal (absolute rating to state), PVDF preferred for chlorine tolerance; 220 mm legs (about 0.66 m2); 50 mm shell, 290 mm long; 3/8 in raw inlet barb and a bleed screw on the top cap, clean outlet nipple on the header; supplier states clean-water flux at 5 kPa, maximum backwash pressure, LRV data, chlorine tolerance and NSF/ANSI/CAN 61 status | Membrane module maker supplying point-of-use hollow-fibre modules (request for quotation; no part number chosen) | 15.00 | buy | Estimate for a sample quantity, to confirm by quotation; benchmark: a complete 0.1 um bucket filter kit retails at about USD 60 (Sawyer PointONE, CAWST fact sheet, checked 2026-11-11)
15 P-clips | 2 | Nylon P-clip for a 50 mm tube, 5 mm screw hole | Hardware store | 0.30 | buy | Estimate
16 Clean-side tee with backflush port | 1 | Polypropylene tee: 12 mm run onto the module outlet, 3/8 in barb outlet, female luer-lock branch with cap | Laboratory or medical fittings supplier | 2.50 | buy | Estimate
17 Pinch clamp | 1 | Polypropylene hose pinch clamp for 14 mm tube | Laboratory supplier | 0.80 | buy | Estimate
18 Clean bucket (white) | 1 | New food-grade HDPE pail as item 1, translucent white so the level shows; 25.4 mm tap hole 45 mm above the floor; 2.5 L refill line marked | Packaging distributor or local market | 5.06 | buy | USD 5.06 (ePackageSupply, checked 2026-11-11)
19 Clean lid | 1 | Snap-on HDPE lid for item 18; 22 mm inlet hole and 16 mm vent hole cut | Packaging distributor | 2.50 | buy | Estimate
20 Clean inlet fitting | 1 | Polypropylene: 40 mm flange, 21 mm spigot through the lid, 3/8 in barb on top; about 8 g | Local 3D print service | 0.60 | make | Estimate
21 Vent cap | 1 | Polypropylene vent cap 34 mm across with six side ports and a spigot through the lid; about 7 g | Local 3D print service | 0.60 | make | Estimate
22 Insect screen disc | 1 | Stainless mesh about 0.5 mm aperture, 27.5 mm disc | Hardware store | 0.20 | buy | Estimate
23 Drum tap | 1 | 3/4 in polyethylene drum tap (spigot) with nut and EPDM gasket, push lever | Packaging or hardware supplier | 5.91 | buy | USD 5.91 for a 3/4 in plastic drum spigot (Arco, checked 2026-11-11); food-contact status to confirm with the supplier
24 Labels | 2 | Waterproof printed labels with pictograms: raw (settle, dose with D, wait 30 min, open valve; crossed-out virus with tablet) and clean (treated water, refill line, weekly rinse) | Local print shop | 0.75 | buy | Estimate
25 Timber 45 x 45 | 5.5 | Planed softwood 45 x 45 mm, dry, untreated or treated with a food-safe oil only: two feet 560 mm, four legs 837 mm, two rails 420 mm (unit: metre) | Timber merchant | 1.10 | make | Estimate per metre (not a quote); bamboo or local hardwood of the same section is an alternative
26 Plywood 18 mm | 0.4 | Exterior plywood 18 mm: upper shelf 420 x 420, lower shelf 510 x 420 notched at the legs (unit: square metre) | Timber merchant | 12.00 | make | Estimate per square metre
27 Brace boards 70 x 20 | 1.9 | Planed softwood 70 x 20 mm, two diagonal braces about 0.9 m (unit: metre) | Timber merchant | 0.80 | make | Estimate per metre
28 Coach screws M8 | 8 | Zinc-plated coach screws M8: eight x 80 mm (shelf to legs, feet to legs) | Hardware store | 0.35 | buy | Estimate
29 Bolt sets M8 | 4 | M8 x 105 hex bolt (ISO 4017), two washers (ISO 7089), nut (ISO 4032), zinc plated: rails to legs | Hardware store | 0.60 | buy | Estimate per set
30 Wood screws 5 x 30 | 10 | Zinc-plated pan-head wood screws 5 x 30: lower shelf (4), braces (4), P-clips (2) | Hardware store | 0.08 | buy | Estimate
31 Backflush syringe | 1 | 60 mL luer-lock syringe, about 26.7 mm bore | Pharmacy or medical supplier | 1.00 | buy | Estimate; kept in a clean bag on the stand
32 Luer check valve | 1 | Luer-lock one-way (check) valve, polypropylene with silicone disc, between the backflush port and the syringe; lets the syringe pump several strokes of water or air | Medical or laboratory supplier | 0.80 | buy | Estimate
