BoujeeEnjinia1701/helpful-water/solutions/D-virus-add-on/bom/bom.csv

item | qty | spec | supplier | unit_cost_usd | make_buy | notes
1 Dose cap body | 1 | Polypropylene (food-contact grade), 36 mm across the skirt (39 mm over 12 grip ribs), 40 mm crown, 46 mm deep; female 28 mm PCO 1881 thread inside a 17 mm skirt, 4 mm deck with a 17 mm water bore, 20.4 mm tablet well bore, 22.4 mm plug thread (2 mm pitch) at the top, coring groove, side timer boss with a 7.5 x 28 x 22.5 mm slot, 2.2 mm trunnion bearing and two 1.6 mm pilot holes; about 32 g | Local 3D print service or makerspace (FDM in PP for the prototype; injection moulded at scale) | 2.11 | make | Estimate: 32 g x USD 0.035/g filament plus USD 1.00 machine time (not a quote; same basis as HWB BOM)
2 Neck liner | 1 | Food-grade silicone flat gasket 27.6 mm OD x 20.5 mm ID x 1.5 mm, cut from sheet | Seal or gasket supplier (silicone sheet listed for drinking-water contact) | 0.10 | buy | Estimate; die or knife cut from 1.5 mm sheet
3 Tablet well insert 1 L (blue) | 1 | Polypropylene, blue, 20.0 mm OD x 16 mm, 9.5 mm tablet bore 12 mm deep (rejects a tablet over about 9 mm), floor with four 1.5 mm slots and a 1.6 mm centre hole, O-ring groove, one key notch; about 4 g | Local 3D print service | 0.64 | make | Estimate: 4 g x USD 0.035/g plus USD 0.50 machine time
4 Tablet well insert 20 L (orange) | 1 | As item 3 in orange with a 14.5 mm bore and two key notches, for the 28 mm port proposed for the solution C raw-water bucket lid; not fitted in the 1 L assembly | Local 3D print service | 0.62 | make | Estimate: printed with item 3; supplied in the kit
5 Well insert O-ring | 2 | O-ring 17.2 mm ID x 1.6 mm, EPDM or silicone, drinking-water grade, chlorine resistant | O-ring supplier | 0.10 | buy | Estimate (assortment price); one per insert
6 Well plug | 1 | Clear PETG (clarified PP at scale; not PC), 27 mm knurled head x 5 mm, 20 mm threaded core (2 mm pitch) with a 14 mm sight bore, O-ring groove under the head, tether lug; about 5 g | Local 3D print service (clear PETG for the prototype; clarified PP at scale; not PC, F12) | 0.68 | make | Estimate: 5 g x USD 0.035/g plus USD 0.50 machine time
7 Plug O-ring | 1 | O-ring 22.6 mm ID x 1.6 mm, EPDM or silicone, drinking-water grade | O-ring supplier | 0.10 | buy | Estimate
8 Tether | 1 | TPE band 41.4 x 40 x 2 mm with strap to the plug lug; printed in TPU 95A | Local 3D print service | 0.30 | make | Estimate: under 1 g plus USD 0.25 machine time
9 Timer tube | 1 | Clear polycarbonate tube 6 mm OD x 4 mm ID, cut to 18 mm, ends chamfered | Plastic tube stockist (1 m length) | 0.10 | make | Estimate: cut from about USD 5 per metre stock
10 Timer end cap | 2 | Polypropylene plug 6 mm x 1.5 mm with a 3.95 mm x 1.5 mm spigot and O-ring groove | Local 3D print service or turned | 0.05 | make | Estimate; printed with item 1
11 Timer end O-ring | 2 | O-ring 3.0 mm ID x 0.5 mm, silicone or FKM (silicone fluid compatible: FKM preferred, to confirm) | O-ring supplier | 0.10 | buy | Estimate; ends also sealed with a drop of UV-cure adhesive
12 Timer ball | 1 | Stainless steel ball 2.0 mm (AISI 316 or 440C), grade 100 | Bearing ball supplier (packs of 100) | 0.05 | buy | Estimate: about USD 5 per 100
13 Timer fluid | 1 | Polydimethylsiloxane silicone fluid, about 550,000 cSt at 25 C for a 45 minute fall (HWD-CAL-001 section 5), 0.2 mL per timer | Silicone fluid distributor (for example a PMX-200 type 600,000 cSt grade, blended down to the fall-time check) | 0.10 | buy | Estimate: 0.2 mL from a 100 mL sample; grade tuned by the fall-time check
14 Timer hub | 1 | Polypropylene block 7.2 x 8 x 6 mm with a 6 mm bore and two 2 mm trunnions | Local 3D print service | 0.05 | make | Estimate; printed with item 1
15 Timer window | 1 | Clear polycarbonate plate 1.5 mm, 9 x 35 x 24.5 mm with a 2.2 mm trunnion bearing and two 2.2 mm screw holes | Local laser cutting or printed in clear PETG | 0.20 | make | Estimate
16 Window screw | 2 | Stainless steel pan-head self-tapping screw for plastic, 2.2 mm x 6.5 mm (ISO 7049 style) | Fastener supplier | 0.05 | buy | Estimate
17 Timer scale label | 1 | Printed polyester film 0.1 mm with clear strip, START band and 30 minute mark, cold-water run count (one above 18 C, two at 10 to 18 C, three below 10 C) | Label printer | 0.10 | buy | Estimate
18 Pictogram label | 1 | Printed polyester wrap label on the crown: shake, wait, filter; no virus claim wording per HWP-CLM-001; tablet size key with actual-size tablet circles (blue 1 L for 1 to 1.5 L bottles, orange 20 L); 20 L bucket steps: pour water through the well until the tablet has gone, stir 30 s, then flip the timer | Label printer | 0.20 | buy | Estimate
19 NaDCC tablets for 1 L | 10 | Sodium dichloroisocyanurate effervescent tablet, 3.5 mg NaDCC (2 mg available chlorine) per 1 L, in foil strips; household grade | Humanitarian supply catalogue or pharmacy (for example IFRC item WASDCHLA0002T; retail packs of Aquatabs type) | 0.22 | buy | Retail basis: Aquatabs 50-pack at USD 10.99 (CampSaver, checked 2026-11-11); humanitarian pre-budget CHF 0.01 per tablet (IFRC catalogue, checked 2026-11-11); used only for first checks with known potable test water
20 NaDCC tablets for 20 L | 10 | Sodium dichloroisocyanurate effervescent tablet, 67 mg NaDCC (40 mg available chlorine) per 20 to 25 L, in foil strips; household grade | Humanitarian supply catalogue (for example IFRC item for 67 mg household tablets) | 0.10 | buy | Estimate: between the CHF 0.01 humanitarian pre-budget and retail; not a quote; for the solution C port only
