BoujeeEnjinia1701/helpful-water/solutions/A-straw/cad/step/A3-assembly.step

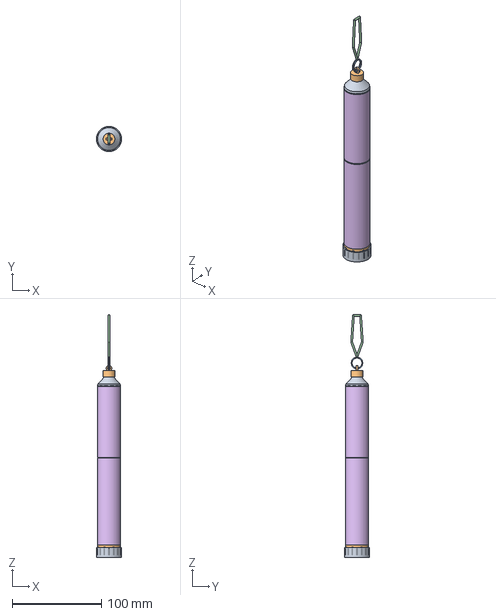
[picture p52: CAD file, 2026-11-12]
solutions/A-straw/cad/step/A3-assembly.step
28.4 x 28.4 x 273.0 mm
