BoujeeEnjinia1701/helpful-water/solutions/B-bottle-cartridge/cad/step/B2-assembly.step

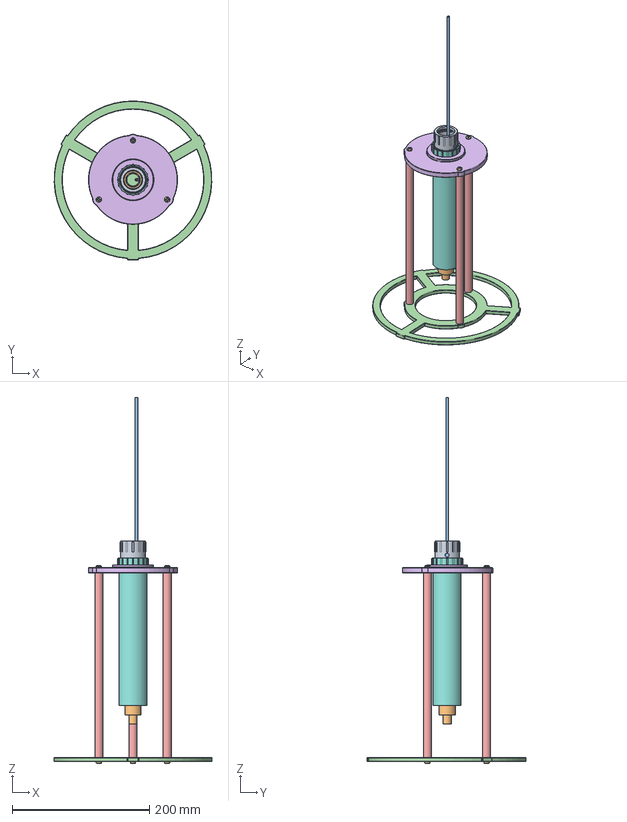
[picture p53: CAD file, 2026-11-12]
solutions/B-bottle-cartridge/cad/step/B2-assembly.step
229.8 x 232.0 x 533.8 mm
