BoujeeEnjinia1701/helpful-water/solutions/C-gravity/cad/step/C3-assembly.step

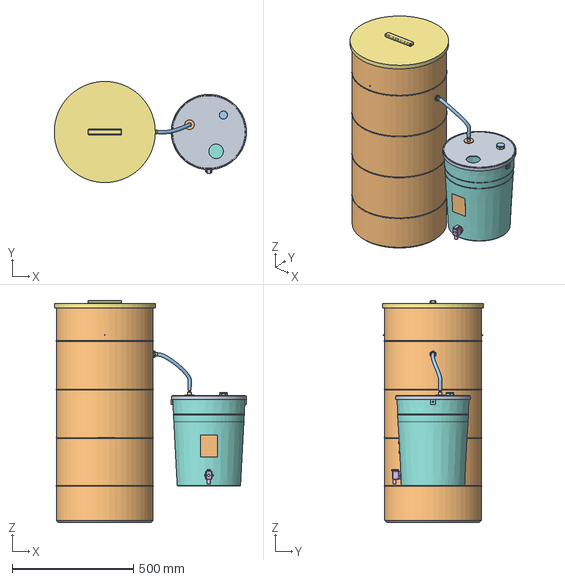
[picture p54: CAD file, 2026-11-12]
solutions/C-gravity/cad/step/C3-assembly.step
795.1 x 417.8 x 917.0 mm
