BoujeeEnjinia1701/helpful-water/solutions/D-virus-add-on/cad/step/D3-assembly.step

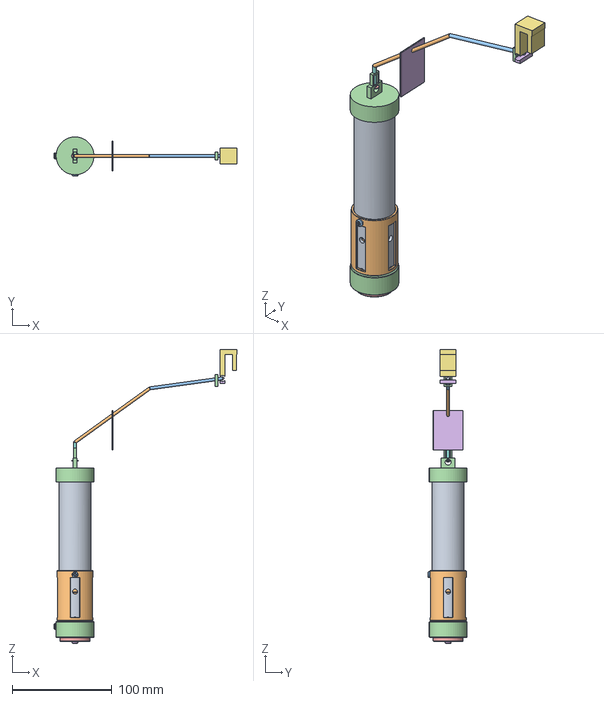
[picture p55: CAD file, 2026-11-12]
solutions/D-virus-add-on/cad/step/D3-assembly.step
183.6 x 39.3 x 295.1 mm
