BoujeeEnjinia1701/helpful-water/solutions/A-straw/cad/step/A2-assembly.step

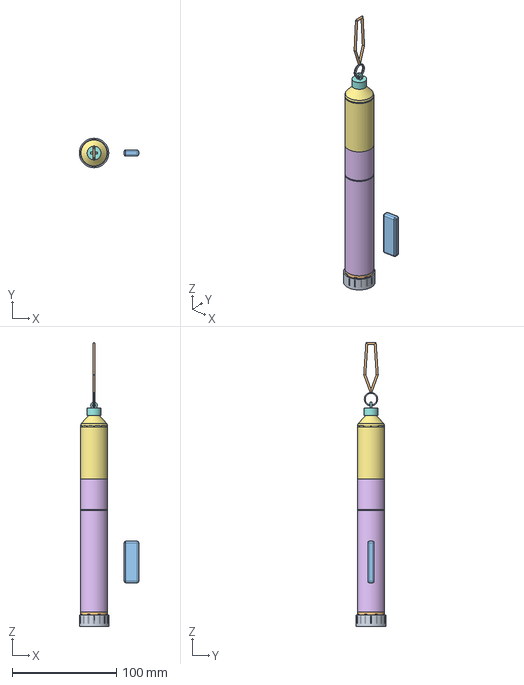
[picture p56: CAD file, 2026-11-12]
solutions/A-straw/cad/step/A2-assembly.step
57.2 x 28.4 x 273.0 mm
