BoujeeEnjinia1701/helpful-water/solutions/B-bottle-cartridge/cad/step/B1-assembly.step

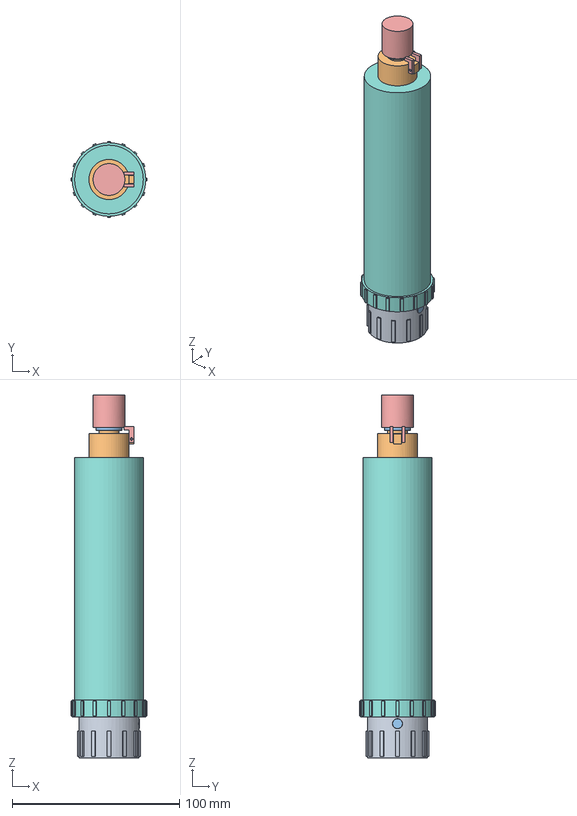
[picture p57: CAD file, 2026-11-12]
solutions/B-bottle-cartridge/cad/step/B1-assembly.step
45.6 x 45.6 x 216.8 mm
