BoujeeEnjinia1701/helpful-water/solutions/C-gravity/cad/step/C1-assembly.step

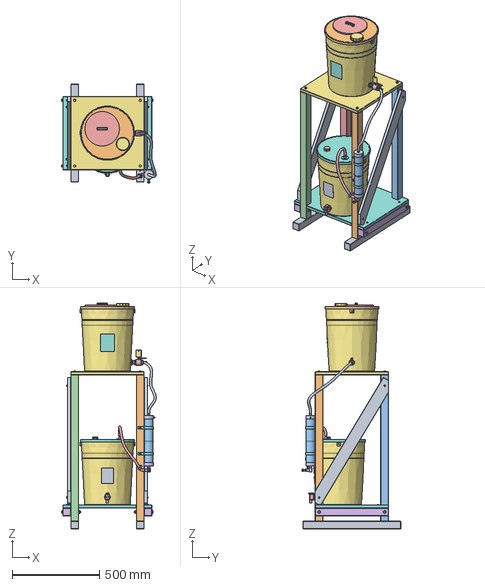
[picture p58: CAD file, 2026-11-12]
solutions/C-gravity/cad/step/C1-assembly.step
541.6 x 564.1 x 1293.4 mm
