BoujeeEnjinia1701/helpful-water/solutions/D-virus-add-on/cad/step/D2-assembly.step

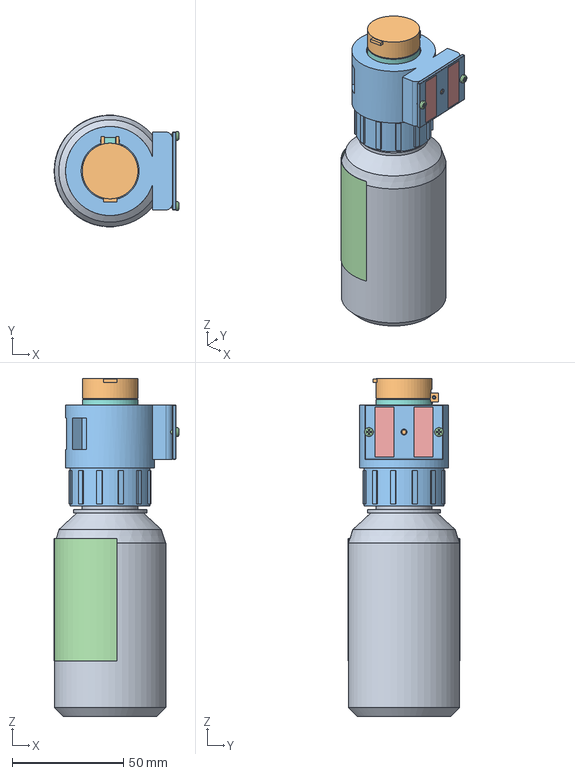
[picture p59: CAD file, 2026-11-12]
solutions/D-virus-add-on/cad/step/D2-assembly.step
56.0 x 50.3 x 151.8 mm
