BoujeeEnjinia1701/helpful-water/solutions/D-virus-add-on/cad/stl/hwd-d1-dose-cap-assembly.stl

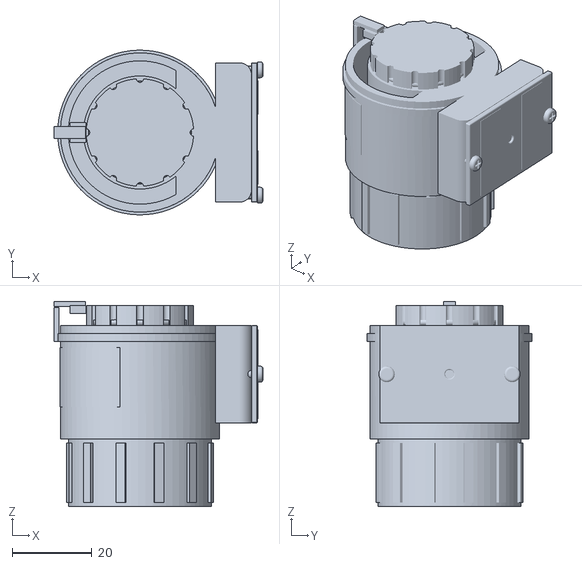
[picture p60: CAD file, 2026-11-12]
solutions/D-virus-add-on/cad/stl/hwd-d1-dose-cap-assembly.stl
52.5 x 41.4 x 51.5
