BoujeeEnjinia1701/helpful-water/solutions/A-straw/cad/step/A1-assembly.step

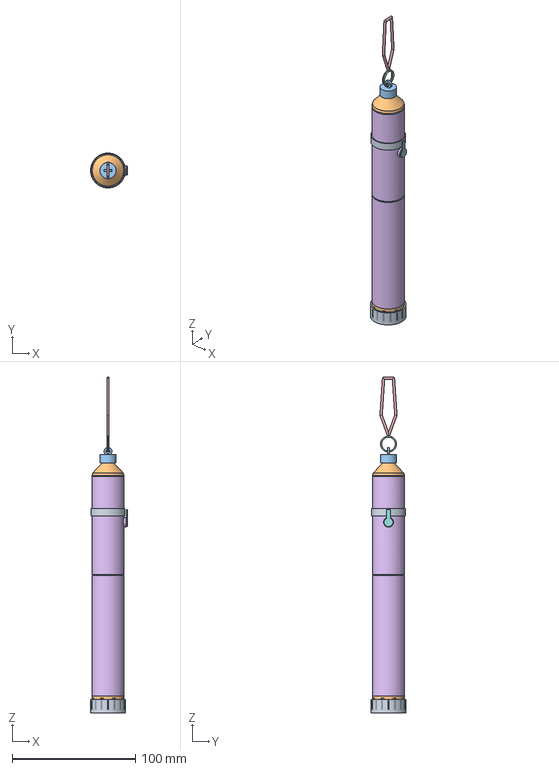
[picture p61: CAD file, 2026-11-12]
solutions/A-straw/cad/step/A1-assembly.step
30.0 x 28.4 x 273.0 mm
