BoujeeEnjinia1701/helpful-water/solutions/B-bottle-cartridge/cad/step/B3-assembly.step

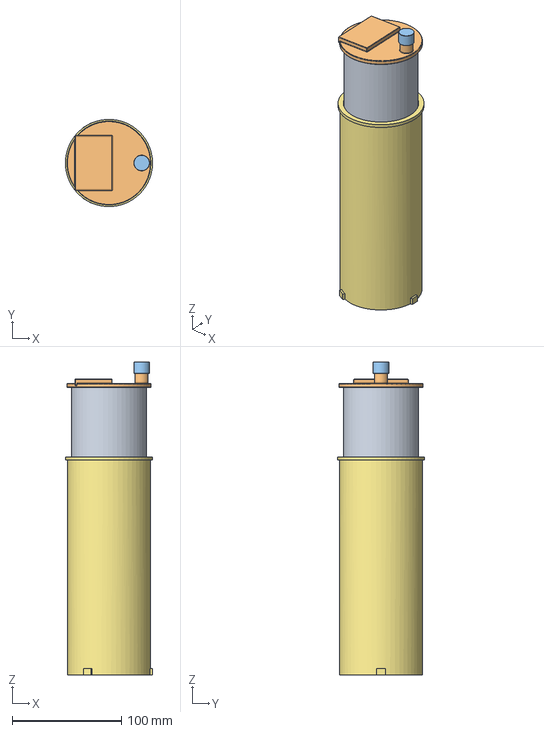
[picture p62: CAD file, 2026-11-12]
solutions/B-bottle-cartridge/cad/step/B3-assembly.step
79.9 x 80.0 x 287.0 mm
