BoujeeEnjinia1701/helpful-water/solutions/C-gravity/cad/step/C2-assembly.step

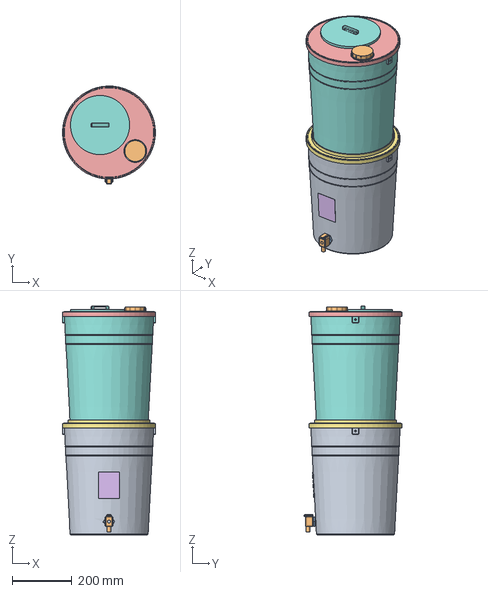
[picture p63: CAD file, 2026-11-12]
solutions/C-gravity/cad/step/C2-assembly.step
313.0 x 327.7 x 766.6 mm
