BoujeeEnjinia1701/helpful-water/solutions/A-straw/cad/stl/hwa-straw-assembly.stl

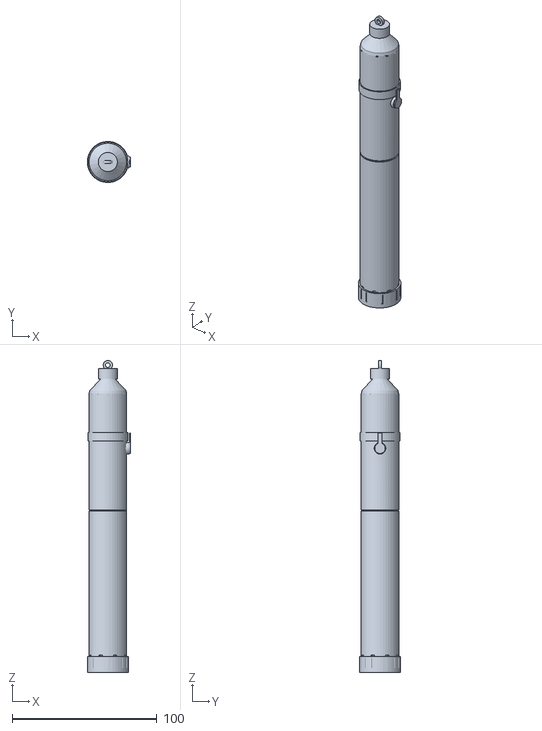
[picture p64: CAD file, 2026-11-12]
solutions/A-straw/cad/stl/hwa-straw-assembly.stl
30.0 x 28.4 x 215.7
