BoujeeEnjinia1701/helpful-water/solutions/A-straw/cad/step/A1/001-intake-cover.step

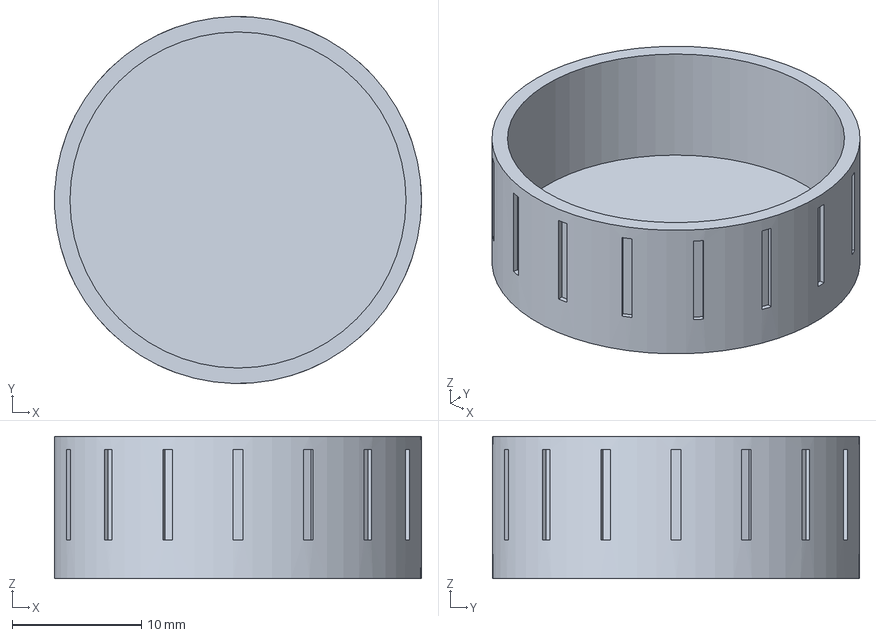
[picture p65: CAD file, 2026-11-12]
solutions/A-straw/cad/step/A1/001-intake-cover.step
28.4 x 28.4 x 11.0 mm
