BoujeeEnjinia1701/helpful-water/solutions/A-straw/cad/stl/hwa-carbon-cartridge-body.stl

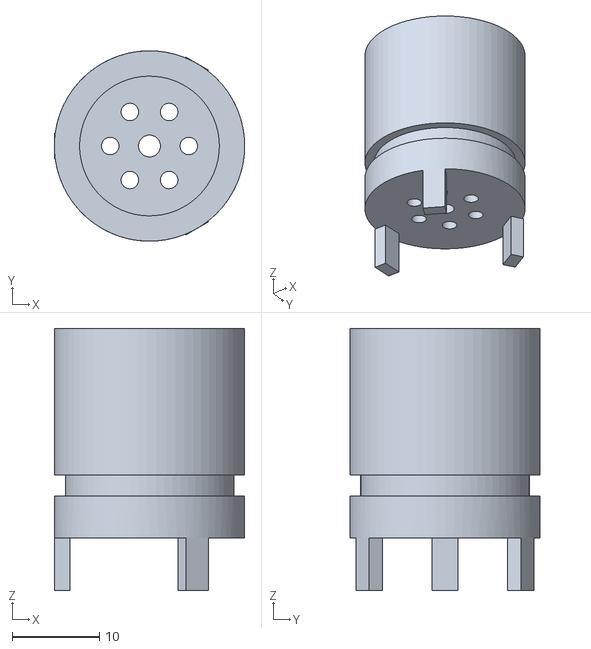
[picture p66: CAD file, 2026-11-12]
solutions/A-straw/cad/stl/hwa-carbon-cartridge-body.stl
21.8 x 21.8 x 30.0
