BoujeeEnjinia1701/helpful-water/solutions/B-bottle-cartridge/cad/step/B1/009-retention-pad-upper.step

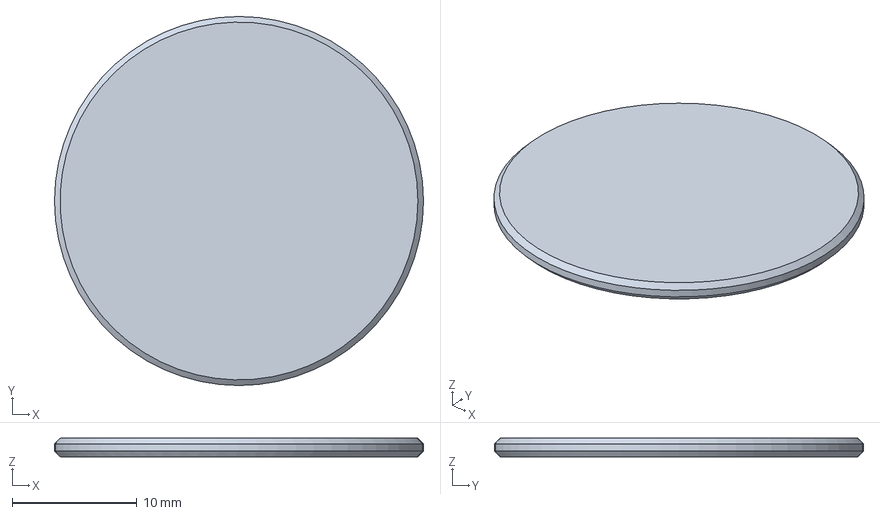
[picture p67: CAD file, 2026-11-12]
solutions/B-bottle-cartridge/cad/step/B1/009-retention-pad-upper.step
29.6 x 29.6 x 1.50 mm
