BoujeeEnjinia1701/helpful-water/solutions/B-bottle-cartridge/cad/stl/hwb-b1-drink-valve.stl

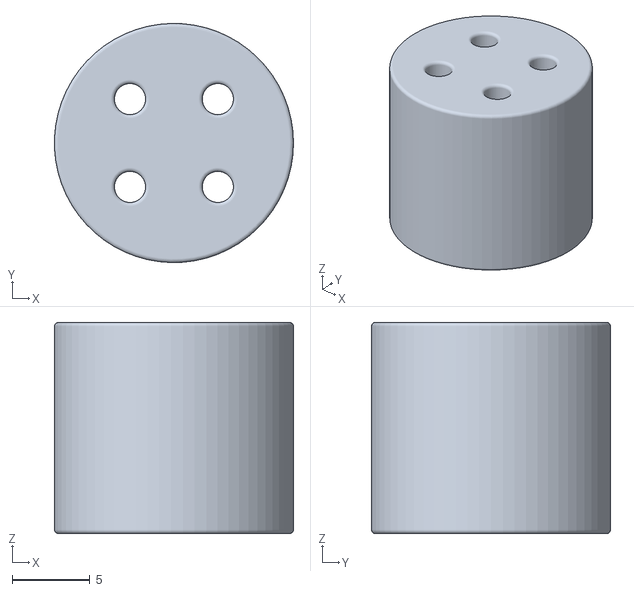
[picture p68: CAD file, 2026-11-12]
solutions/B-bottle-cartridge/cad/stl/hwb-b1-drink-valve.stl
15.4 x 15.4 x 13.6
