BoujeeEnjinia1701/helpful-water/solutions/C-gravity/cad/step/C1/076-clean-hose-silicone-9-5-x-14-about-0-40-m.step

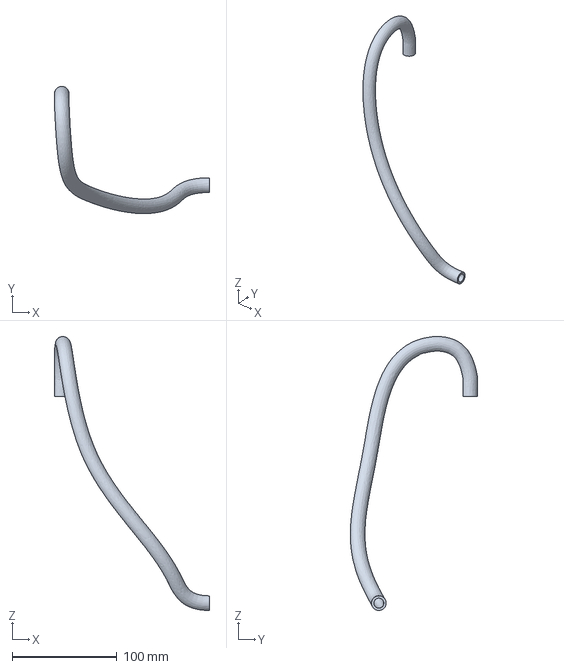
[picture p69: CAD file, 2026-11-12]
solutions/C-gravity/cad/step/C1/076-clean-hose-silicone-9-5-x-14-about-0-40-m.step
148.0 x 121.3 x 261.2 mm
