BoujeeEnjinia1701/helpful-water/solutions/C-gravity/cad/stl/hwc-c1-dosing-port-collar-for-solution-d.stl

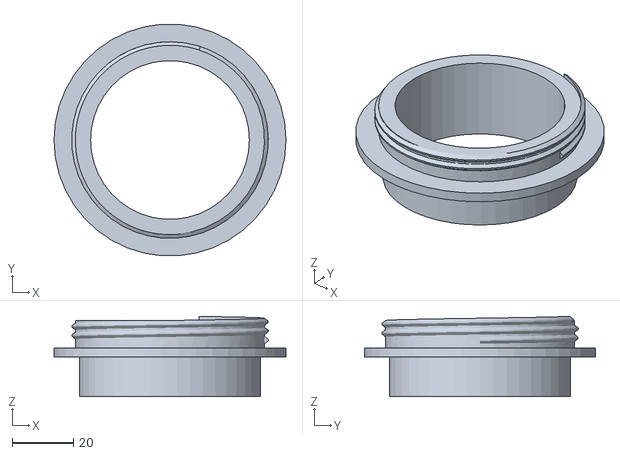
[picture p70: CAD file, 2026-11-12]
solutions/C-gravity/cad/stl/hwc-c1-dosing-port-collar-for-solution-d.stl
76.0 x 75.8 x 26.3
