BoujeeEnjinia1701/helpful-water/solutions/D-virus-add-on/cad/step/D1/016-timer-fluid-silicone-sealed.step

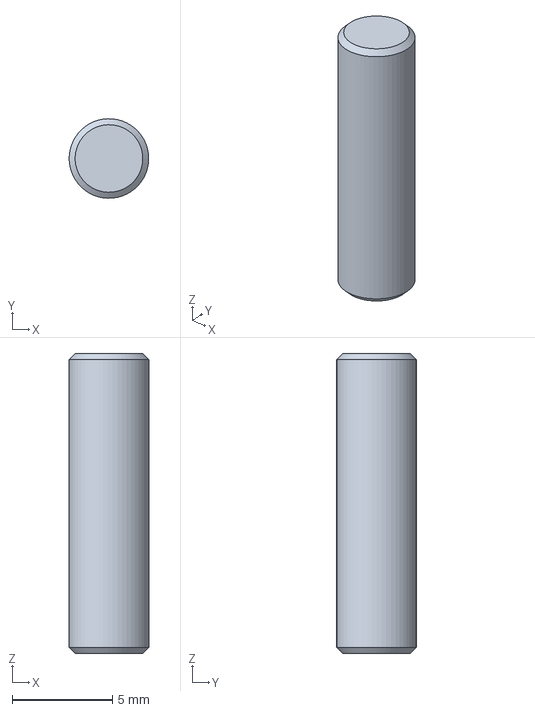
[picture p71: CAD file, 2026-11-12]
solutions/D-virus-add-on/cad/step/D1/016-timer-fluid-silicone-sealed.step
3.98 x 3.98 x 15.0 mm
