BoujeeEnjinia1701/helpful-water/solutions/D-virus-add-on/cad/stl/hwd-d1-timer-end-cap.stl

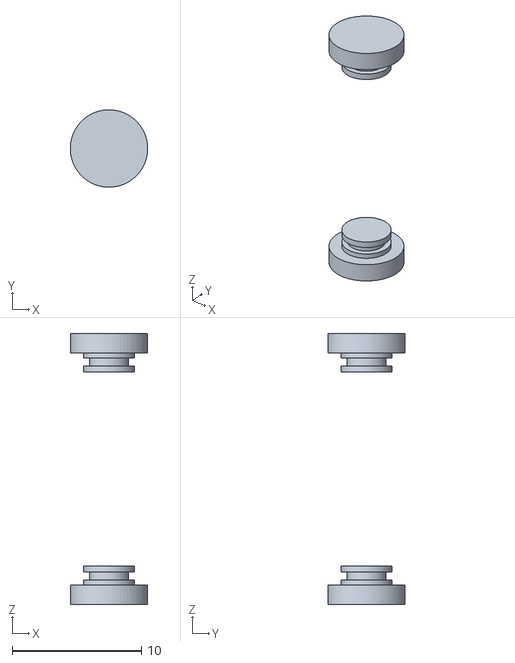
[picture p72: CAD file, 2026-11-12]
solutions/D-virus-add-on/cad/stl/hwd-d1-timer-end-cap.stl
6.00 x 6.00 x 21.0
