BoujeeEnjinia1701/helpful-water/solutions/A-straw/cad/step/A1/009-hollow-fibre-bundle-about-220-fibres.step

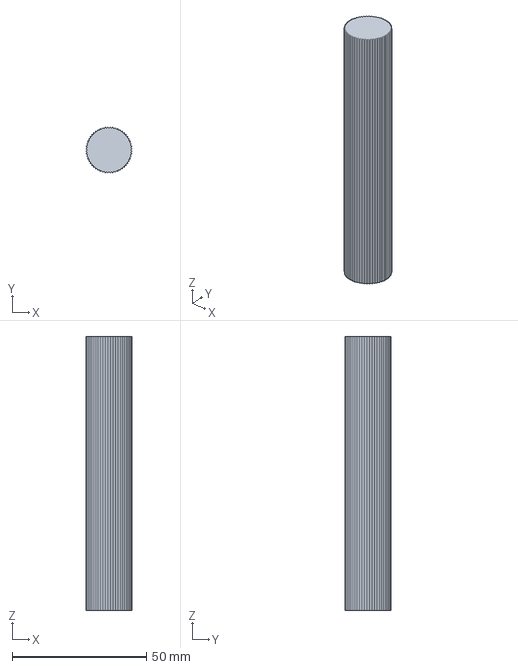
[picture p73: CAD file, 2026-11-12]
solutions/A-straw/cad/step/A1/009-hollow-fibre-bundle-about-220-fibres.step
17.2 x 17.2 x 102.0 mm
