BoujeeEnjinia1701/helpful-water/solutions/A-straw/cad/stl/hwa-intake-cap.stl

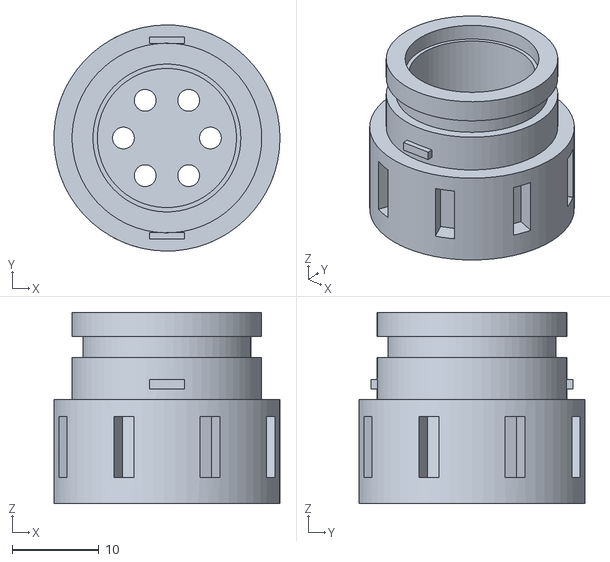
[picture p74: CAD file, 2026-11-12]
solutions/A-straw/cad/stl/hwa-intake-cap.stl
26.0 x 26.0 x 22.0
