BoujeeEnjinia1701/helpful-water/solutions/B-bottle-cartridge/cad/step/B1/013-fibre-bundle-looped-outside-in.step

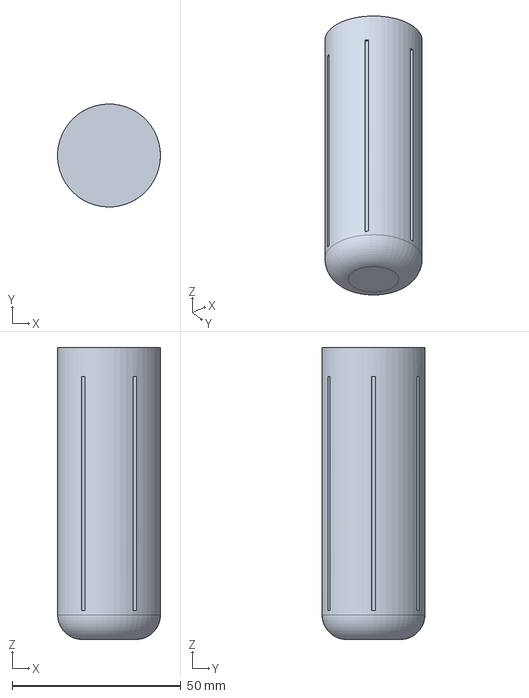
[picture p75: CAD file, 2026-11-12]
solutions/B-bottle-cartridge/cad/step/B1/013-fibre-bundle-looped-outside-in.step
30.5 x 30.5 x 86.5 mm
