BoujeeEnjinia1701/helpful-water/solutions/B-bottle-cartridge/cad/stl/hwb-b1-spout.stl

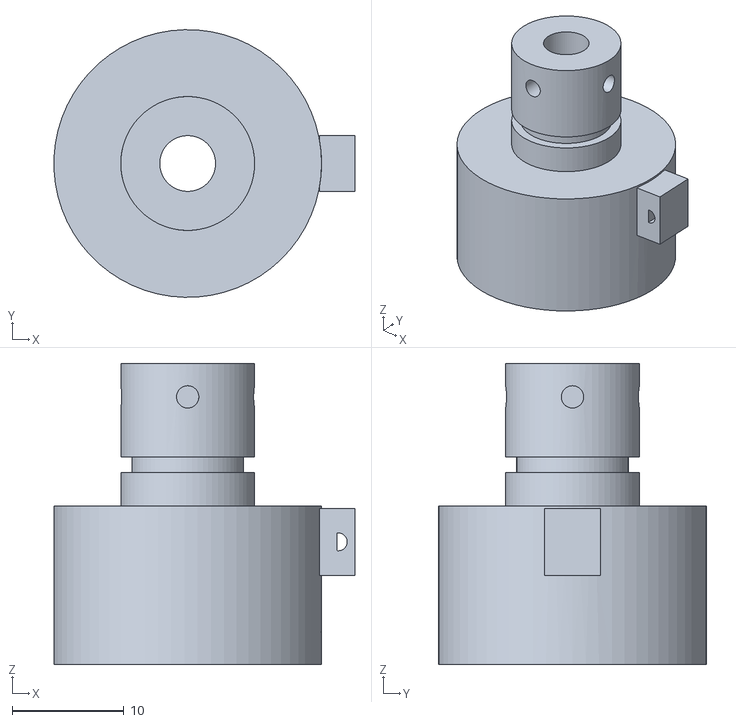
[picture p76: CAD file, 2026-11-12]
solutions/B-bottle-cartridge/cad/stl/hwb-b1-spout.stl
27.0 x 24.0 x 27.0
