BoujeeEnjinia1701/helpful-water/solutions/C-gravity/cad/step/C1/081-vent-cap.step

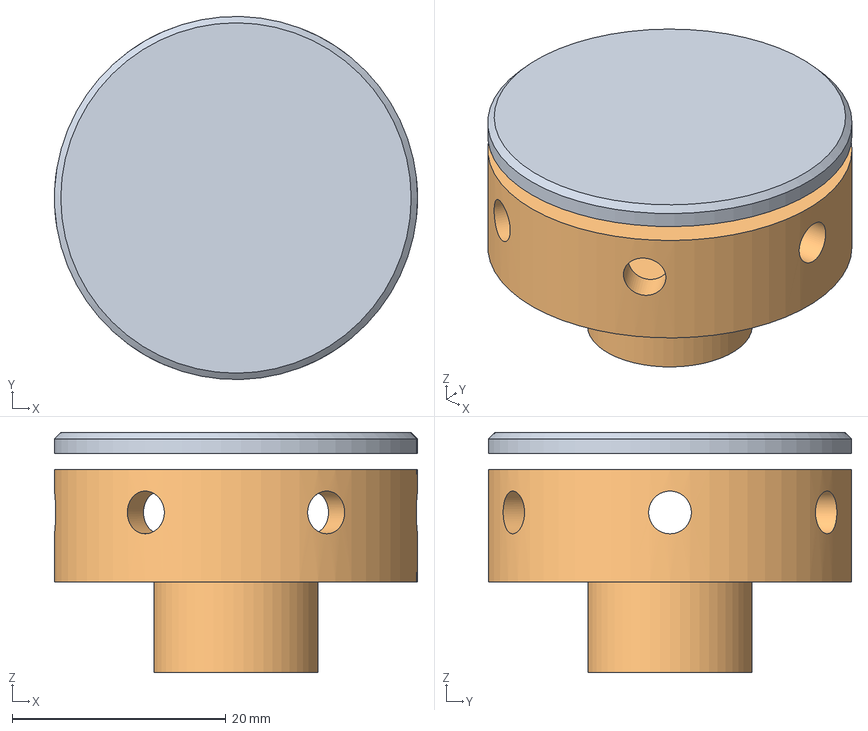
[picture p77: CAD file, 2026-11-12]
solutions/C-gravity/cad/step/C1/081-vent-cap.step
34.0 x 34.0 x 22.5 mm
