BoujeeEnjinia1701/helpful-water/solutions/C-gravity/cad/stl/hwc-c1-vent-cap.stl

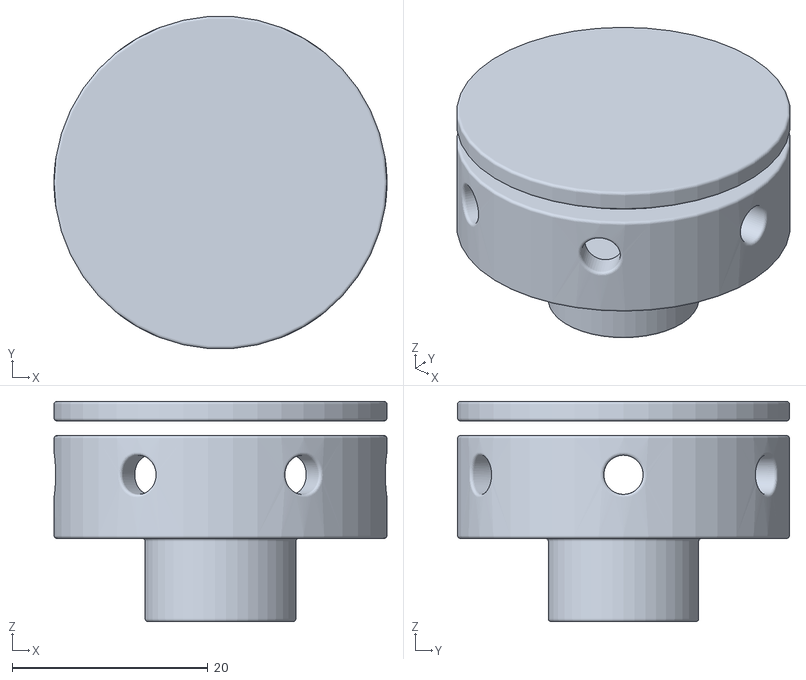
[picture p78: CAD file, 2026-11-12]
solutions/C-gravity/cad/stl/hwc-c1-vent-cap.stl
34.0 x 33.9 x 22.5
