BoujeeEnjinia1701/helpful-water/solutions/D-virus-add-on/cad/step/D1/015-timer-ball-2-mm-stainless.step

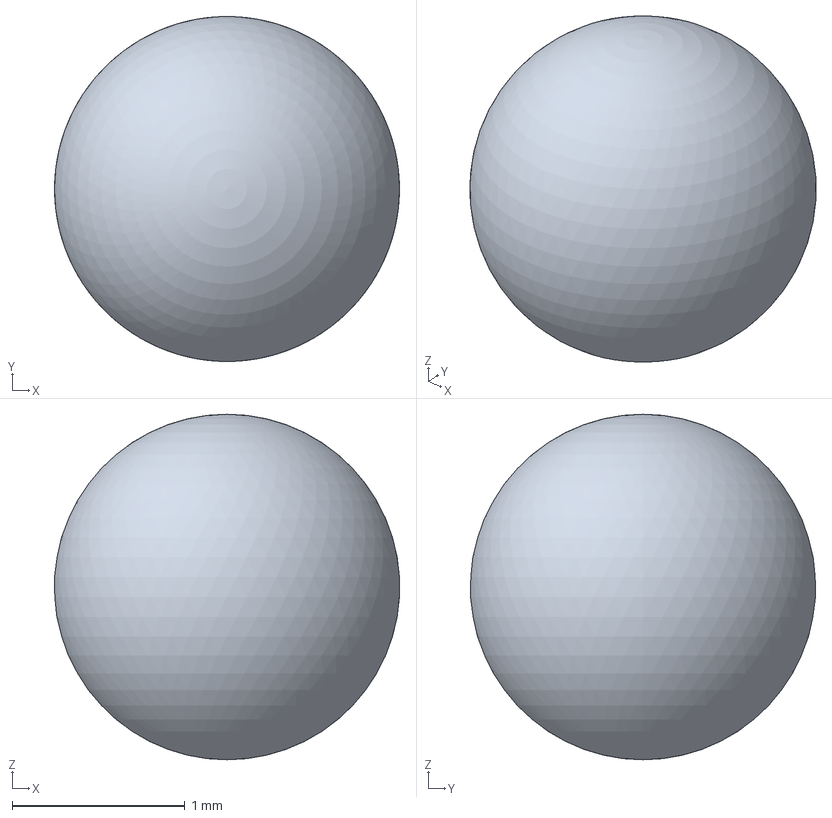
[picture p79: CAD file, 2026-11-12]
solutions/D-virus-add-on/cad/step/D1/015-timer-ball-2-mm-stainless.step
2.00 x 2.00 x 2.00 mm
