BoujeeEnjinia1701/helpful-water/solutions/A-straw/cad/step/A1/007-module-cage-perforated-shell.step

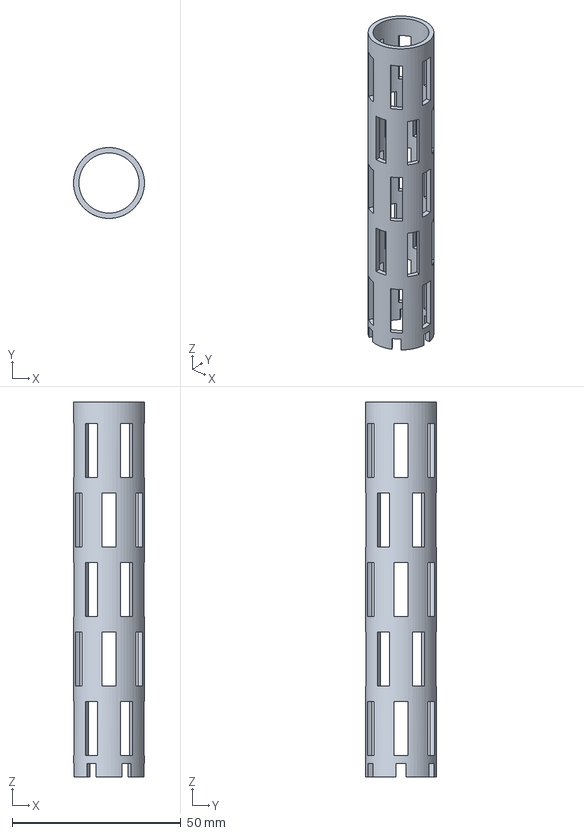
[picture p80: CAD file, 2026-11-12]
solutions/A-straw/cad/step/A1/007-module-cage-perforated-shell.step
21.0 x 21.0 x 111.0 mm
