BoujeeEnjinia1701/helpful-water/solutions/A-straw/cad/stl/hwa-housing-body.stl

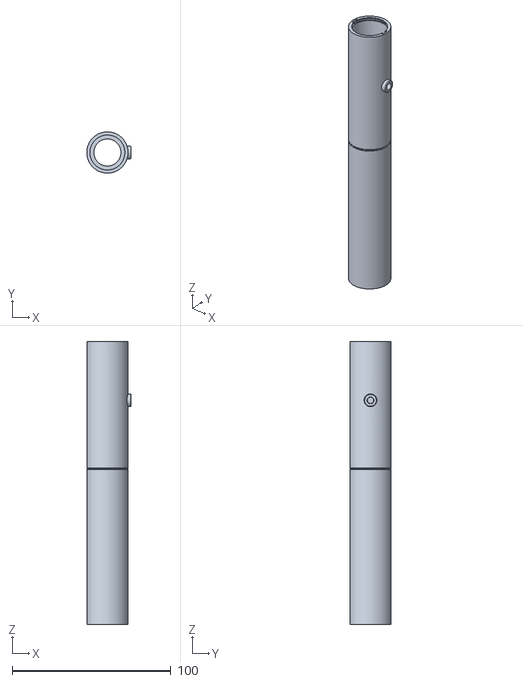
[picture p81: CAD file, 2026-11-12]
solutions/A-straw/cad/stl/hwa-housing-body.stl
28.0 x 26.0 x 178.0
