BoujeeEnjinia1701/helpful-water/solutions/B-bottle-cartridge/cad/step/B1/001-neck-collar-with-pco-1881-thread.step

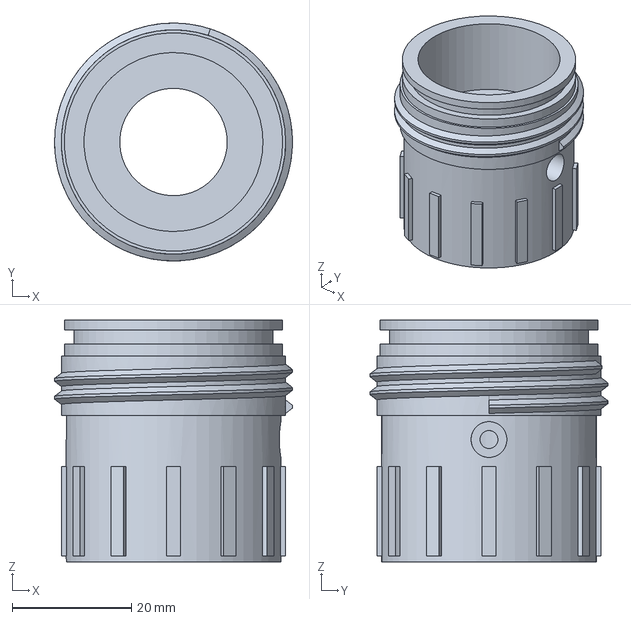
[picture p82: CAD file, 2026-11-12]
solutions/B-bottle-cartridge/cad/step/B1/001-neck-collar-with-pco-1881-thread.step
39.9 x 39.9 x 40.5 mm
