BoujeeEnjinia1701/helpful-water/solutions/C-gravity/cad/step/C1/074-luer-check-valve-on-the-backflush-port.step

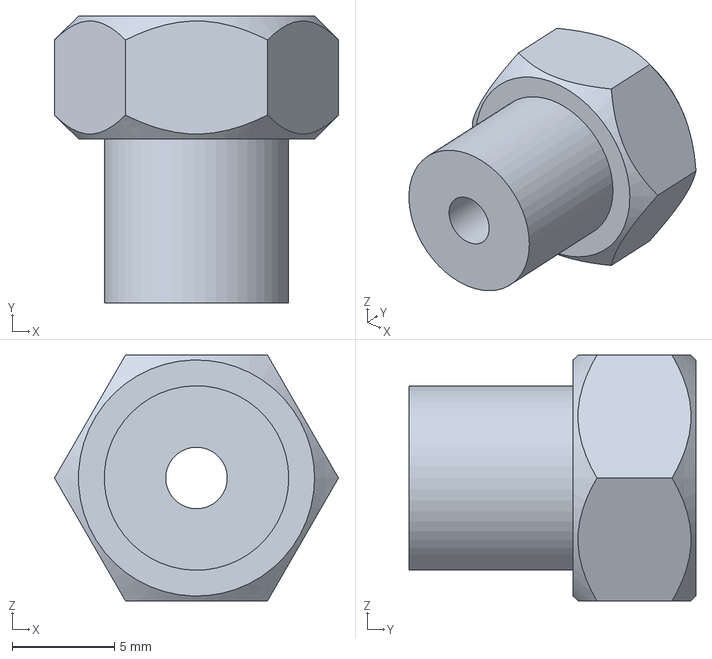
[picture p83: CAD file, 2026-11-12]
solutions/C-gravity/cad/step/C1/074-luer-check-valve-on-the-backflush-port.step
13.9 x 14.0 x 12.0 mm
