BoujeeEnjinia1701/helpful-water/solutions/C-gravity/cad/stl/hwc-c1-valve-tag-shut-30-minutes-after-dosing.stl

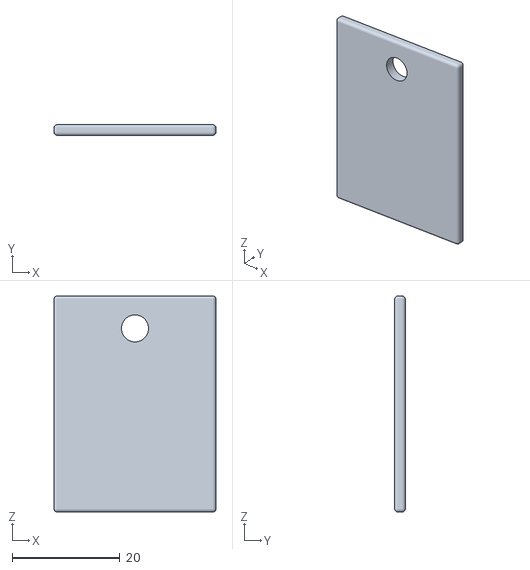
[picture p84: CAD file, 2026-11-12]
solutions/C-gravity/cad/stl/hwc-c1-valve-tag-shut-30-minutes-after-dosing.stl
30.0 x 2.00 x 40.0
