BoujeeEnjinia1701/helpful-water/solutions/D-virus-add-on/cad/step/D1/011-timer-end-cap-bottom.step

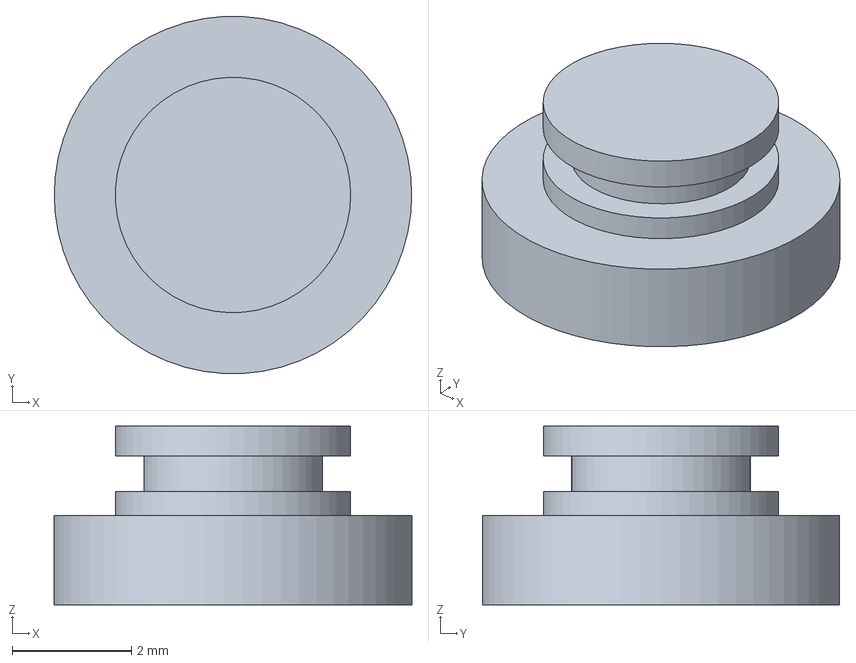
[picture p85: CAD file, 2026-11-12]
solutions/D-virus-add-on/cad/step/D1/011-timer-end-cap-bottom.step
6.00 x 5.99 x 3.00 mm
