BoujeeEnjinia1701/helpful-water/solutions/D-virus-add-on/cad/stl/hwd-d1-well-plug.stl

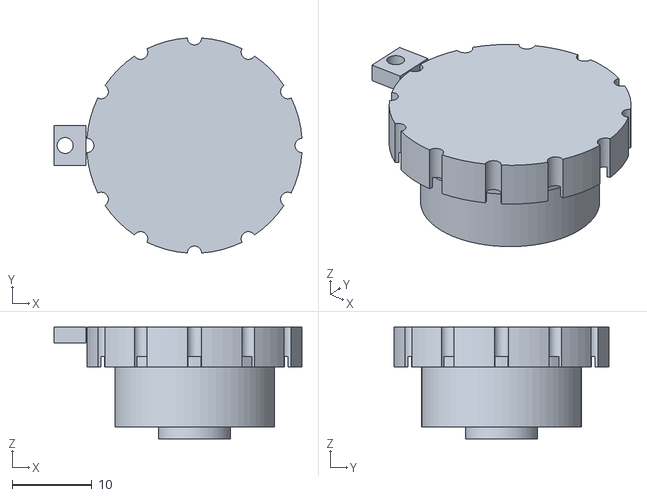
[picture p86: CAD file, 2026-11-12]
solutions/D-virus-add-on/cad/stl/hwd-d1-well-plug.stl
31.1 x 26.9 x 14.0
