BoujeeEnjinia1701/helpful-water/solutions/A-straw/cad/step/A1/017-carbon-fines-pad.step

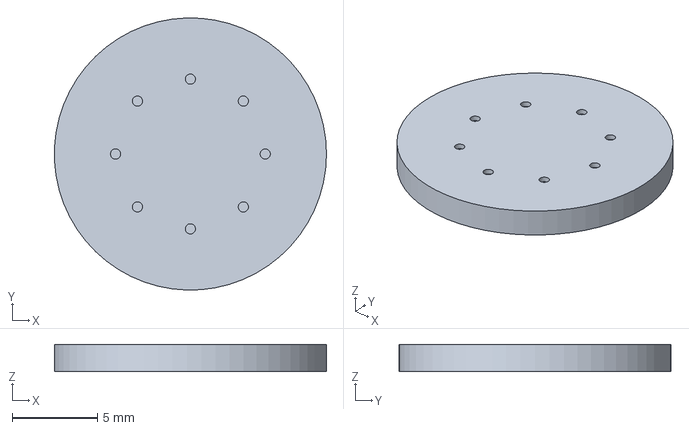
[picture p87: CAD file, 2026-11-12]
solutions/A-straw/cad/step/A1/017-carbon-fines-pad.step
16.0 x 16.0 x 1.60 mm
