BoujeeEnjinia1701/helpful-water/solutions/A-straw/cad/stl/hwa-backflush-port-plug-tethered.stl

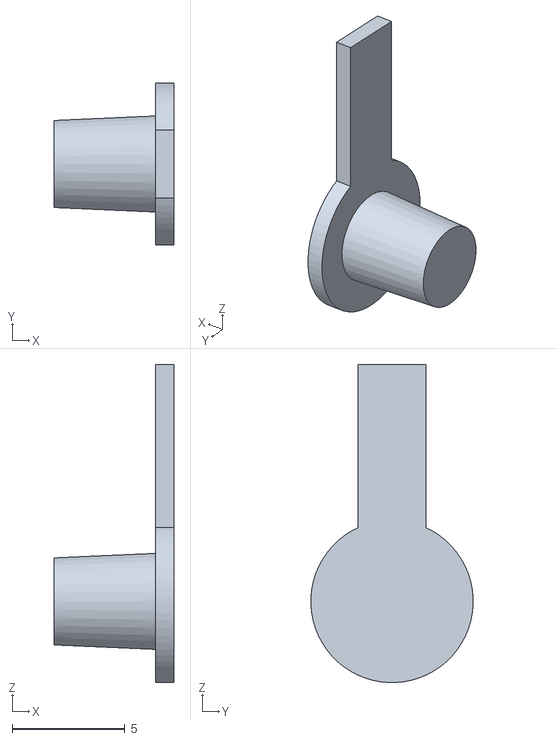
[picture p88: CAD file, 2026-11-12]
solutions/A-straw/cad/stl/hwa-backflush-port-plug-tethered.stl
5.30 x 7.19 x 14.1
