BoujeeEnjinia1701/helpful-water/solutions/B-bottle-cartridge/cad/step/B1/022-valve-o-ring-10-x-1-2.step

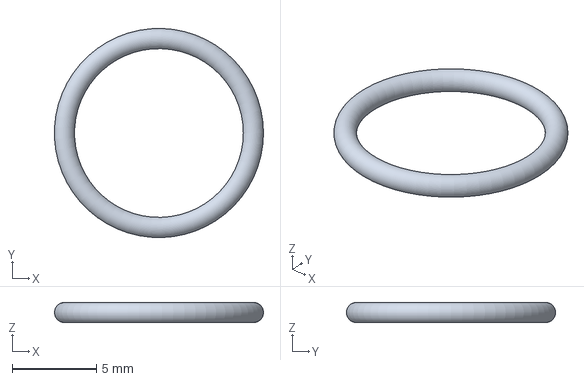
[picture p89: CAD file, 2026-11-12]
solutions/B-bottle-cartridge/cad/step/B1/022-valve-o-ring-10-x-1-2.step
12.4 x 12.4 x 1.20 mm
