BoujeeEnjinia1701/helpful-water/solutions/B-bottle-cartridge/cad/stl/hwb-b1-carbon-capsule-lid.stl

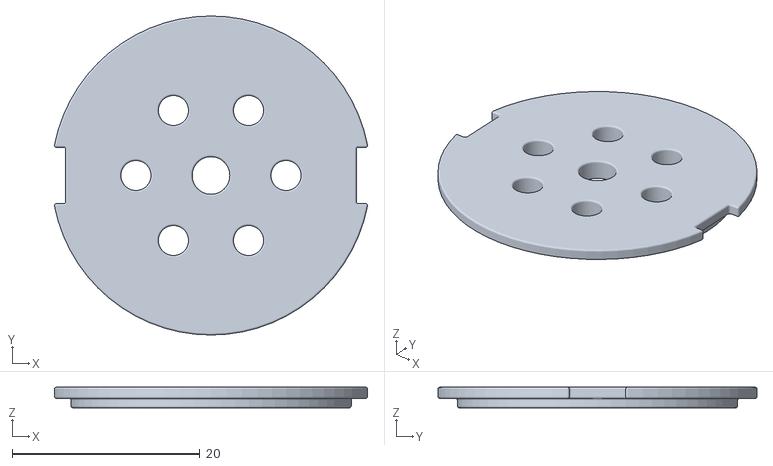
[picture p90: CAD file, 2026-11-12]
solutions/B-bottle-cartridge/cad/stl/hwb-b1-carbon-capsule-lid.stl
33.4 x 34.0 x 2.20
