BoujeeEnjinia1701/helpful-water/solutions/C-gravity/cad/step/C1/008-lower-rail-left-45-x-45-x-420.step

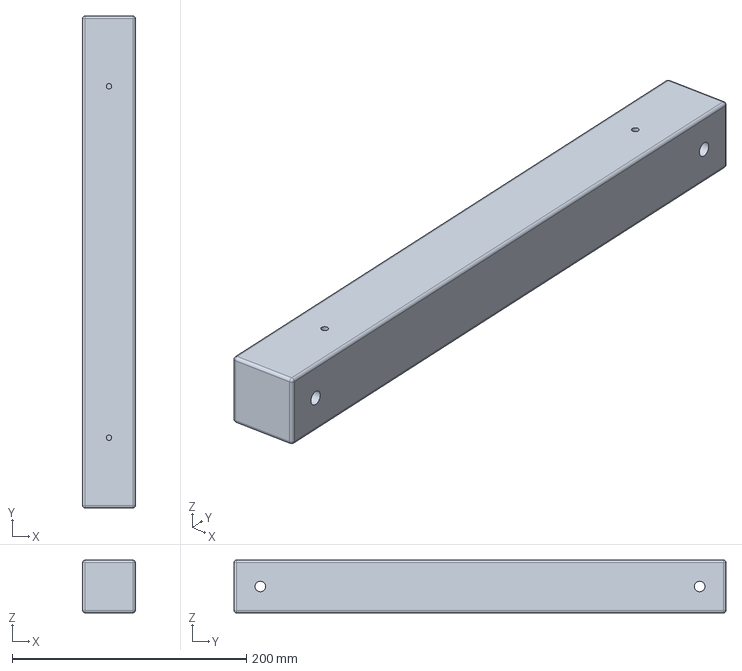
[picture p91: CAD file, 2026-11-12]
solutions/C-gravity/cad/step/C1/008-lower-rail-left-45-x-45-x-420.step
45.0 x 420.0 x 45.0 mm
