BoujeeEnjinia1701/helpful-water/solutions/C-gravity/cad/stl/hwc-c1-fill-cover-with-handle.stl

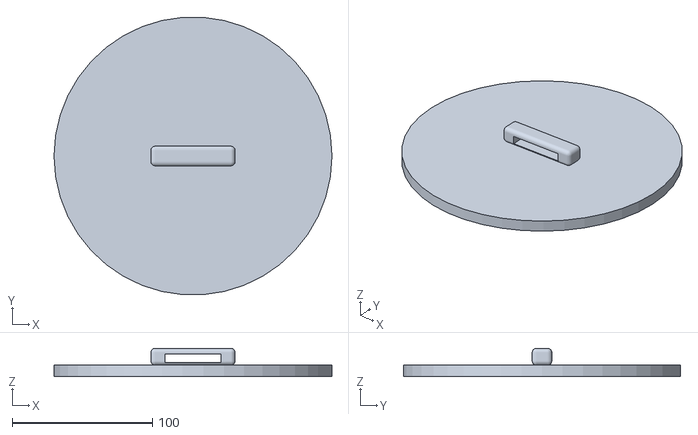
[picture p92: CAD file, 2026-11-12]
solutions/C-gravity/cad/stl/hwc-c1-fill-cover-with-handle.stl
198.0 x 197.4 x 20.2
