BoujeeEnjinia1701/helpful-water/solutions/D-virus-add-on/cad/step/D1/002-neck-liner-flat-silicone.step

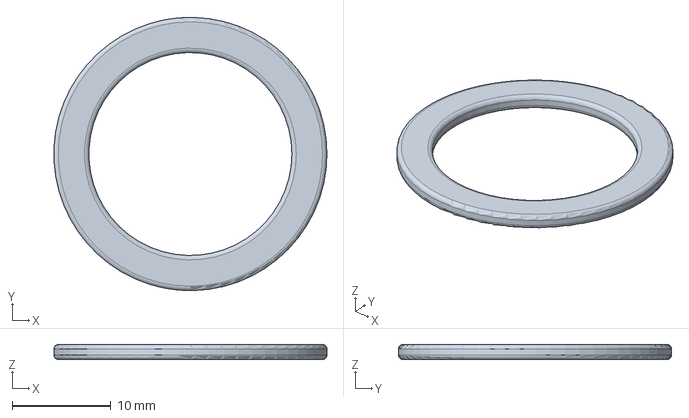
[picture p93: CAD file, 2026-11-12]
solutions/D-virus-add-on/cad/step/D1/002-neck-liner-flat-silicone.step
27.6 x 27.6 x 1.50 mm
