BoujeeEnjinia1701/helpful-water/solutions/D-virus-add-on/cad/stl/hwd-d1-dose-cap-body.stl

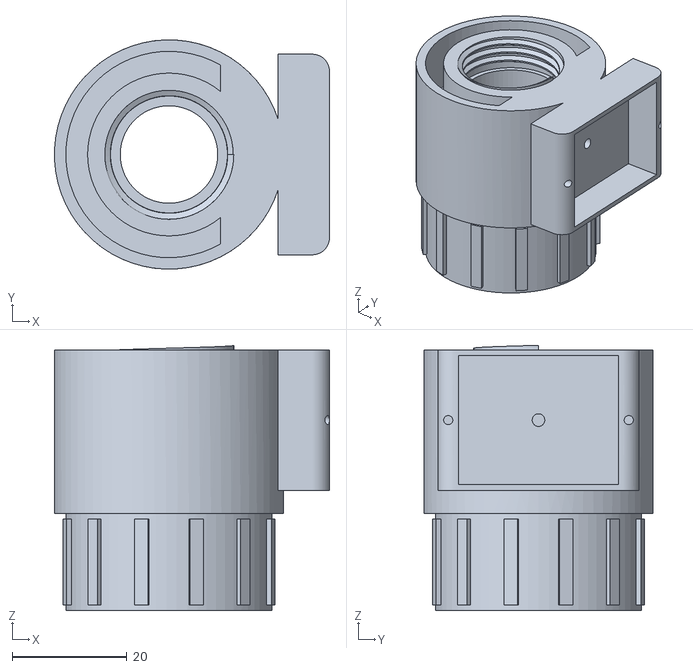
[picture p94: CAD file, 2026-11-12]
solutions/D-virus-add-on/cad/stl/hwd-d1-dose-cap-body.stl
48.0 x 40.0 x 46.3
