BoujeeEnjinia1701/helpful-water/solutions/A-straw/cad/stl/hwa-tether-band.stl

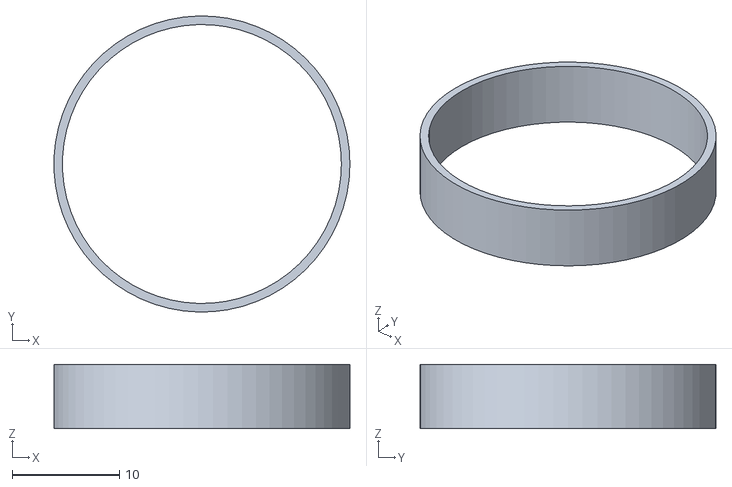
[picture p95: CAD file, 2026-11-12]
solutions/A-straw/cad/stl/hwa-tether-band.stl
27.6 x 27.6 x 6.00
