BoujeeEnjinia1701/helpful-water/solutions/B-bottle-cartridge/cad/step/B1/012-module-guard-sleeve-perforated.step

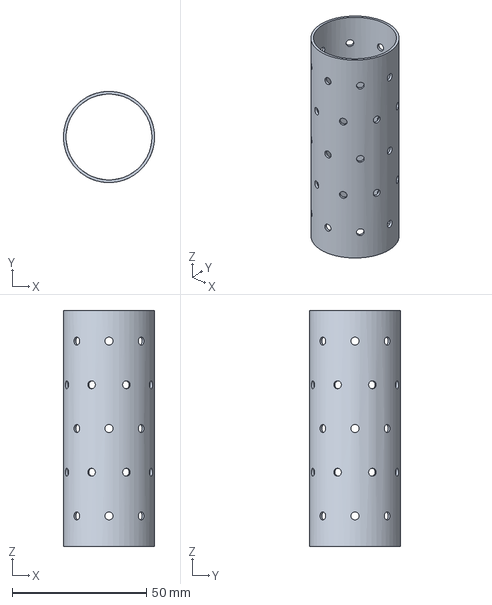
[picture p96: CAD file, 2026-11-12]
solutions/B-bottle-cartridge/cad/step/B1/012-module-guard-sleeve-perforated.step
34.0 x 34.0 x 88.0 mm
