BoujeeEnjinia1701/helpful-water/solutions/B-bottle-cartridge/cad/stl/hwb-b1-housing.stl

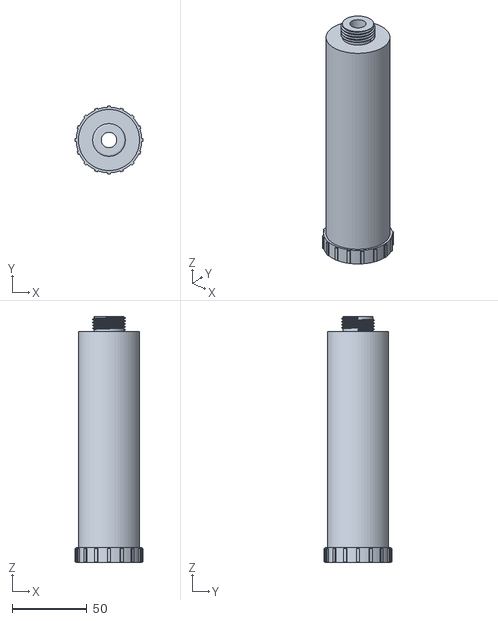
[picture p97: CAD file, 2026-11-12]
solutions/B-bottle-cartridge/cad/stl/hwb-b1-housing.stl
45.6 x 45.6 x 165.0
