BoujeeEnjinia1701/helpful-water/solutions/C-gravity/cad/step/C1/010-lower-shelf-plywood-18-mm-notched.step

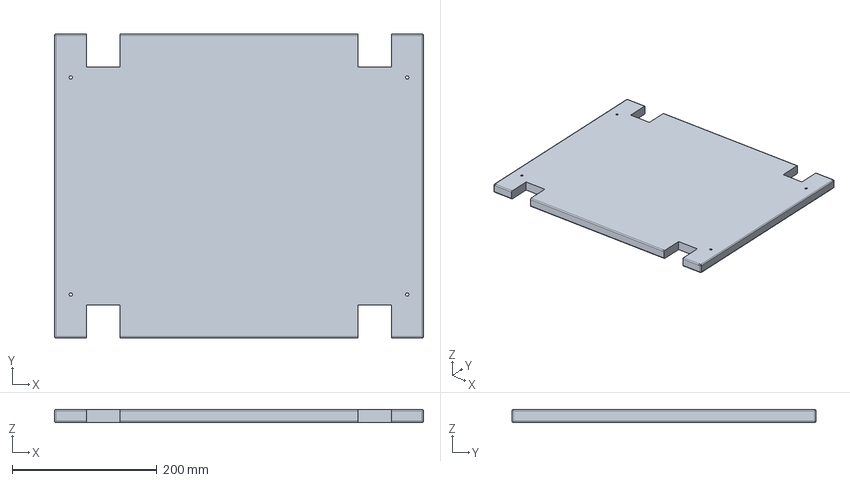
[picture p98: CAD file, 2026-11-12]
solutions/C-gravity/cad/step/C1/010-lower-shelf-plywood-18-mm-notched.step
510.0 x 420.0 x 18.0 mm
