BoujeeEnjinia1701/helpful-water/solutions/C-gravity/cad/stl/hwc-c1-dosing-port-cap.stl

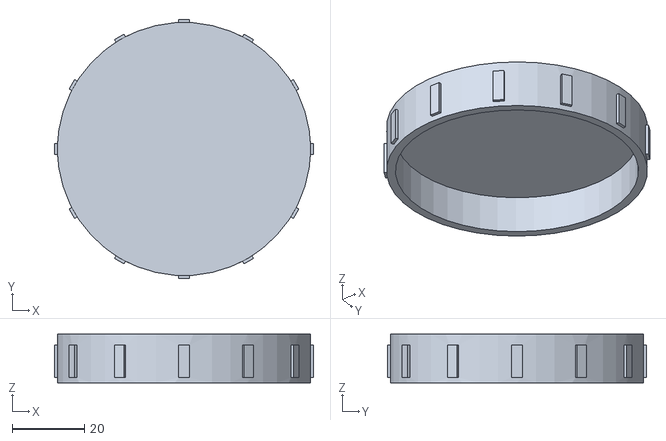
[picture p99: CAD file, 2026-11-12]
solutions/C-gravity/cad/stl/hwc-c1-dosing-port-cap.stl
71.6 x 71.6 x 13.5
