BoujeeEnjinia1701/helpful-water/solutions/D-virus-add-on/cad/step/D1/018-timer-window-clear.step

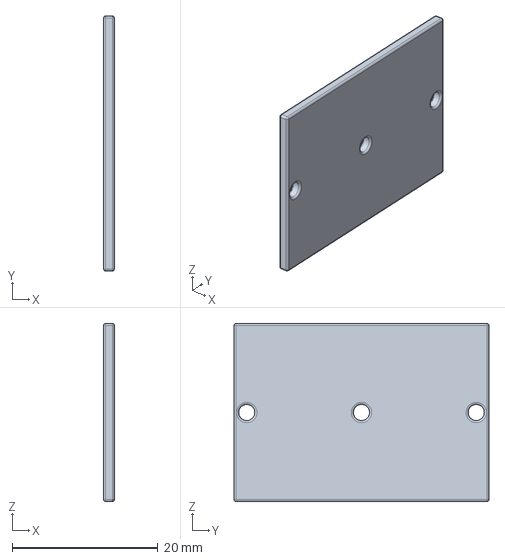
[picture p100: CAD file, 2026-11-12]
solutions/D-virus-add-on/cad/step/D1/018-timer-window-clear.step
1.50 x 35.0 x 24.5 mm
