BoujeeEnjinia1701/helpful-water/solutions/A-straw/cad/step/A1/010-top-potting-block-open-lumens.step

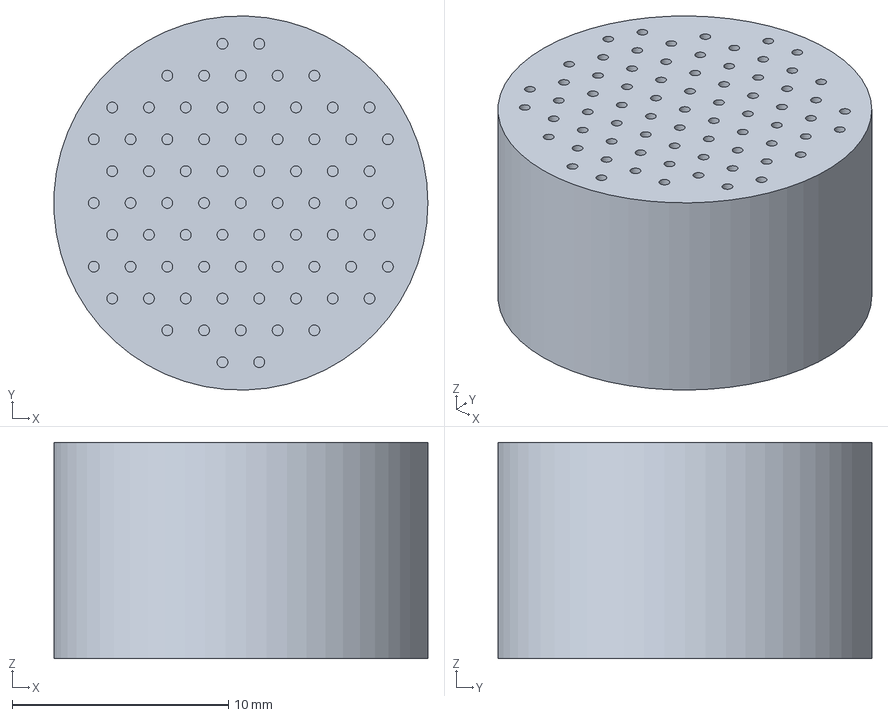
[picture p102: CAD file, 2026-11-12]
solutions/A-straw/cad/step/A1/010-top-potting-block-open-lumens.step
17.3 x 17.3 x 10.0 mm
