BoujeeEnjinia1701/helpful-water/solutions/A-straw/cad/stl/hwa-mouthpiece.stl

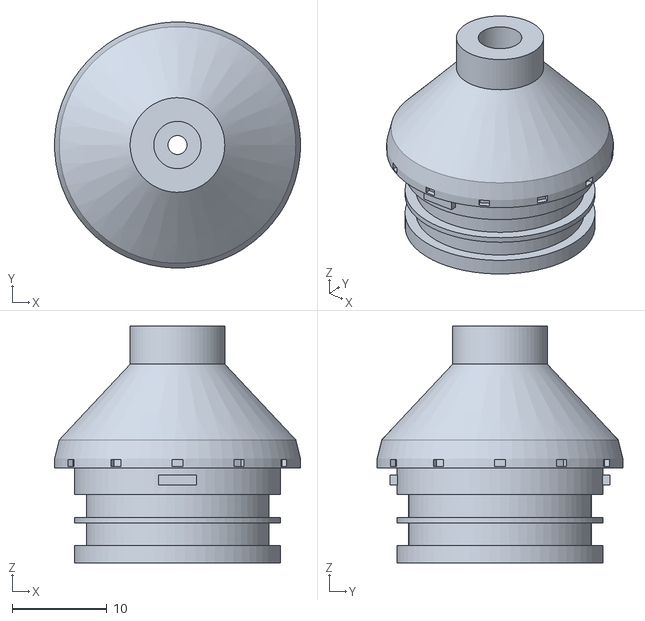
[picture p103: CAD file, 2026-11-12]
solutions/A-straw/cad/stl/hwa-mouthpiece.stl
26.0 x 26.0 x 25.0
