BoujeeEnjinia1701/helpful-water/solutions/B-bottle-cartridge/cad/step/B1/004-mesh-prefilter-disc-150-um-316l.step

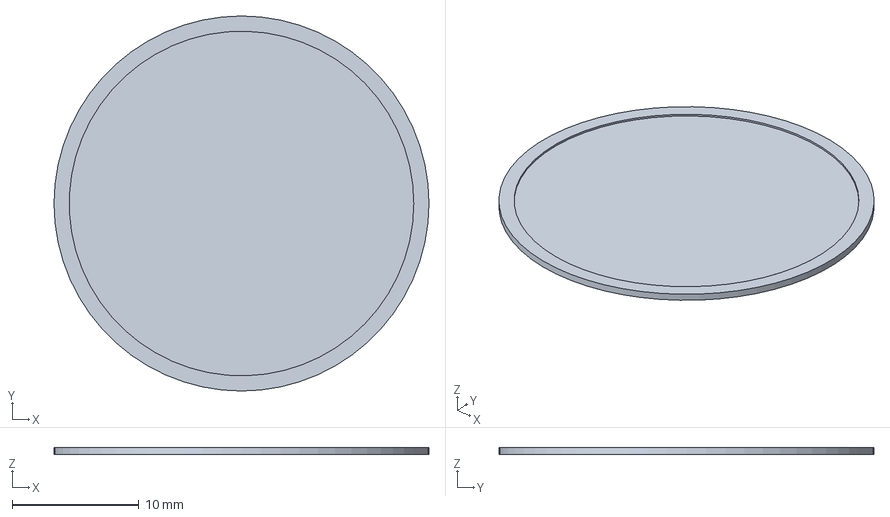
[picture p104: CAD file, 2026-11-12]
solutions/B-bottle-cartridge/cad/step/B1/004-mesh-prefilter-disc-150-um-316l.step
29.6 x 29.6 x 0.55 mm
