BoujeeEnjinia1701/helpful-water/solutions/C-gravity/cad/step/C1/011-diagonal-brace-right-70-x-20.step

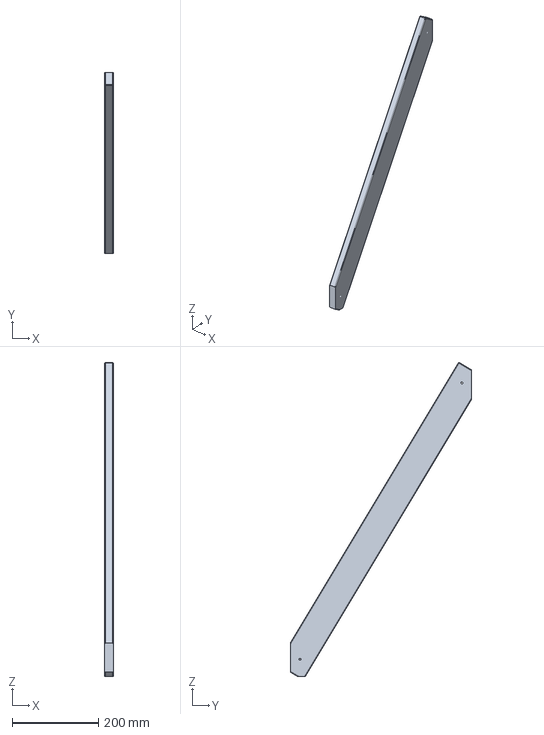
[picture p105: CAD file, 2026-11-12]
solutions/C-gravity/cad/step/C1/011-diagonal-brace-right-70-x-20.step
20.0 x 420.0 x 727.3 mm
