BoujeeEnjinia1701/helpful-water/solutions/C-gravity/cad/stl/hwc-c1-cloth-clamp-ring.stl

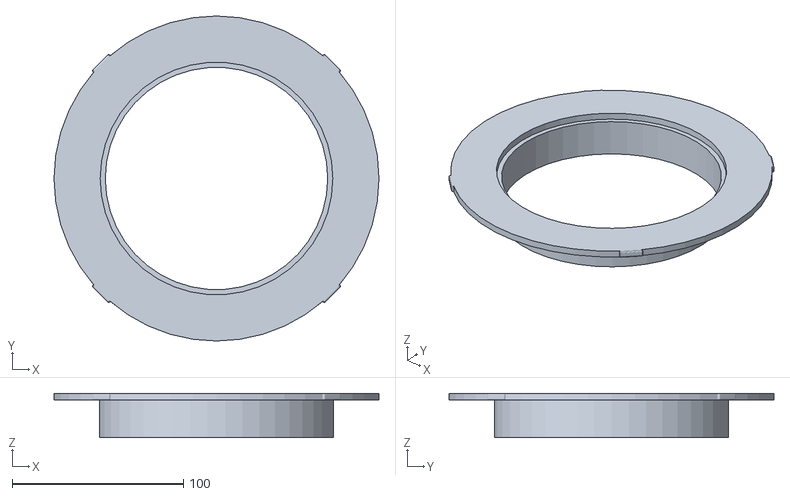
[picture p106: CAD file, 2026-11-12]
solutions/C-gravity/cad/stl/hwc-c1-cloth-clamp-ring.stl
190.0 x 190.0 x 26.0
