BoujeeEnjinia1701/helpful-water/solutions/D-virus-add-on/cad/step/D1/005-tablet-nadcc-3-5-mg-1-l.step

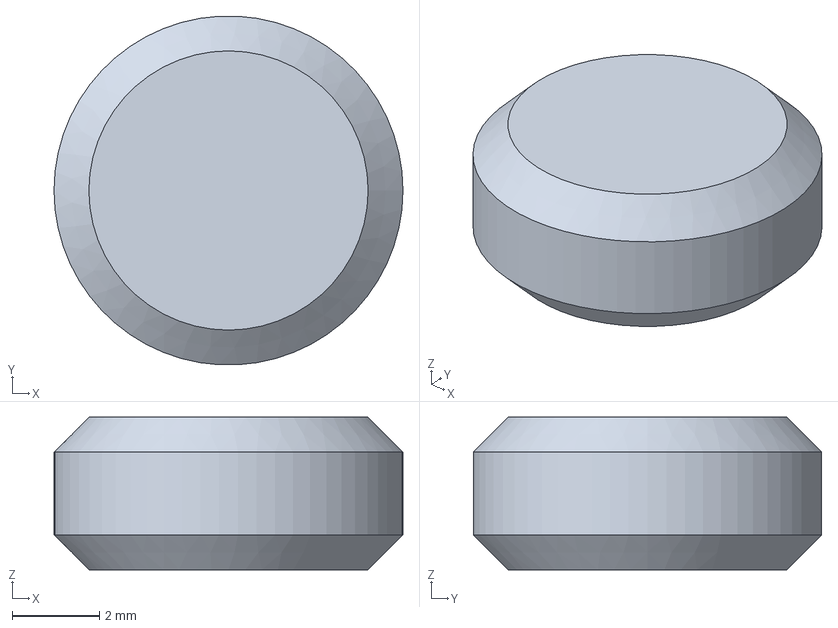
[picture p107: CAD file, 2026-11-12]
solutions/D-virus-add-on/cad/step/D1/005-tablet-nadcc-3-5-mg-1-l.step
8.00 x 7.99 x 3.50 mm
