BoujeeEnjinia1701/helpful-water/solutions/A-straw/cad/step/A1/004-prefilter-mesh-disc-316l-250-um.step

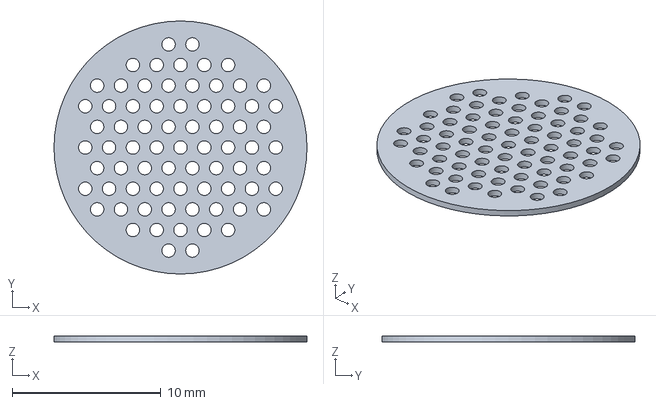
[picture p108: CAD file, 2026-11-12]
solutions/A-straw/cad/step/A1/004-prefilter-mesh-disc-316l-250-um.step
17.0 x 17.0 x 0.4 mm
