BoujeeEnjinia1701/helpful-water/solutions/A-straw/cad/stl/hwa-mesh-retaining-ring.stl

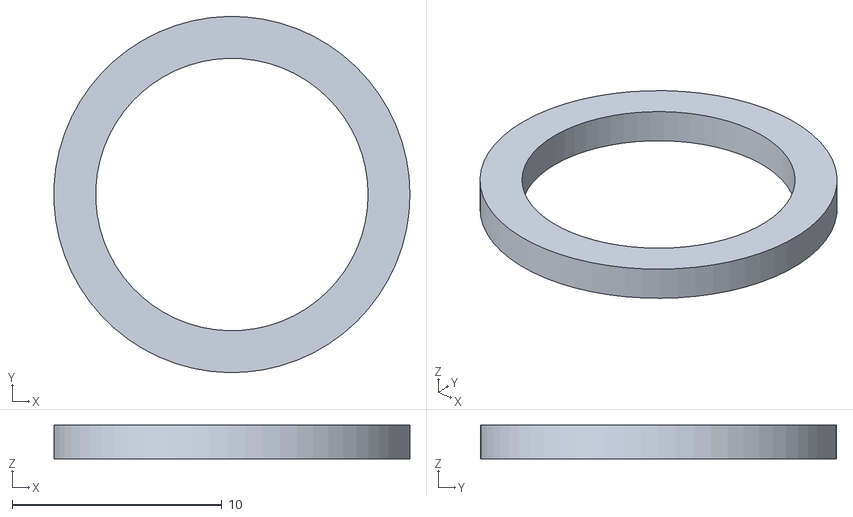
[picture p109: CAD file, 2026-11-12]
solutions/A-straw/cad/stl/hwa-mesh-retaining-ring.stl
17.0 x 17.0 x 1.60
