BoujeeEnjinia1701/helpful-water/solutions/B-bottle-cartridge/cad/step/B1/016-header-o-ring-1-33-4-x-2.step

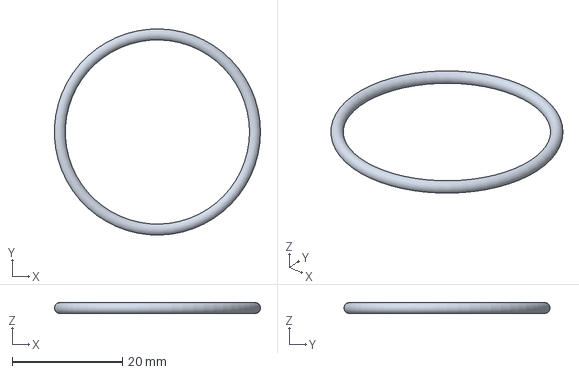
[picture p110: CAD file, 2026-11-12]
solutions/B-bottle-cartridge/cad/step/B1/016-header-o-ring-1-33-4-x-2.step
37.4 x 37.4 x 2.00 mm
