BoujeeEnjinia1701/helpful-water/solutions/B-bottle-cartridge/cad/stl/hwb-b1-carbon-capsule-body.stl

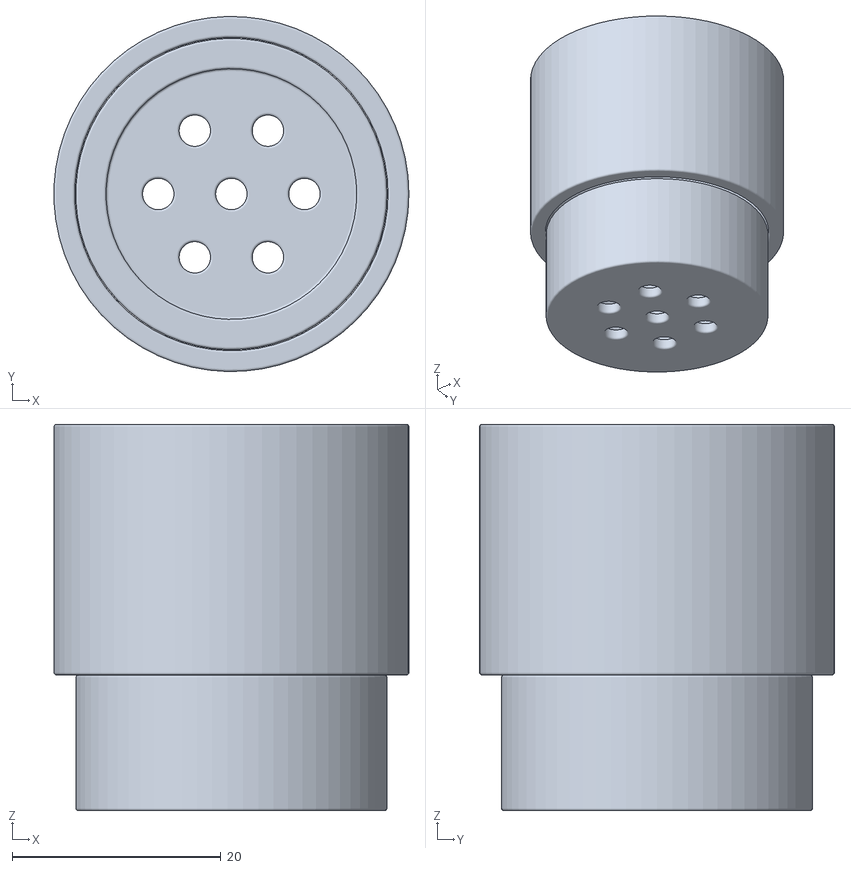
[picture p111: CAD file, 2026-11-12]
solutions/B-bottle-cartridge/cad/stl/hwb-b1-carbon-capsule-body.stl
34.0 x 34.0 x 37.0
