BoujeeEnjinia1701/helpful-water/solutions/C-gravity/cad/stl/hwc-c1-clean-inlet-fitting.stl

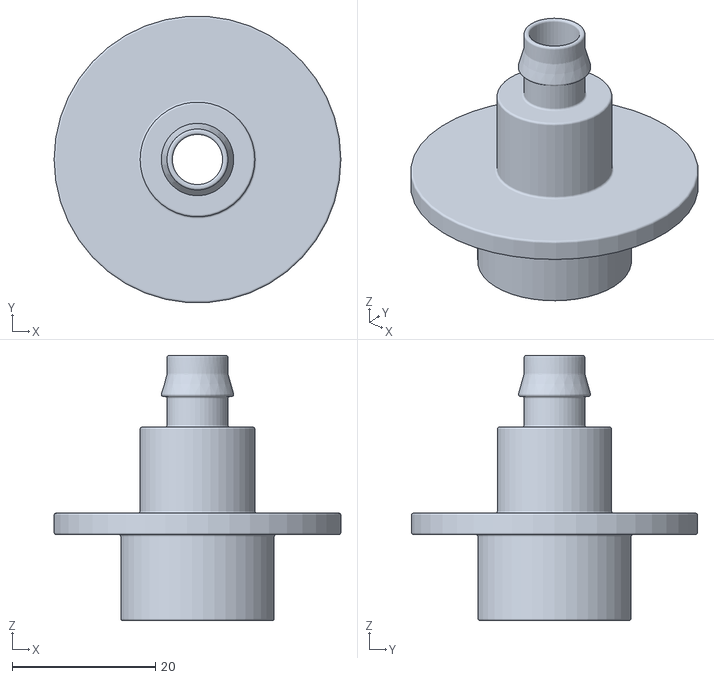
[picture p112: CAD file, 2026-11-12]
solutions/C-gravity/cad/stl/hwc-c1-clean-inlet-fitting.stl
40.0 x 39.9 x 37.0
