BoujeeEnjinia1701/helpful-water/solutions/D-virus-add-on/cad/stl/hwd-d1-well-insert-20l.stl

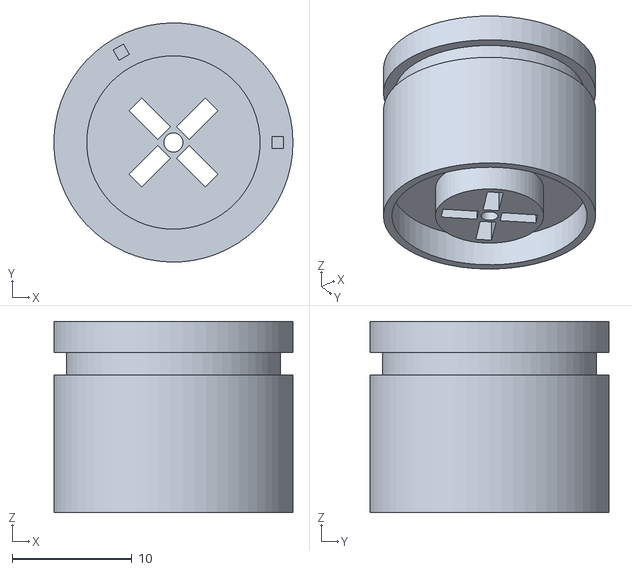
[picture p113: CAD file, 2026-11-12]
solutions/D-virus-add-on/cad/stl/hwd-d1-well-insert-20l.stl
20.0 x 20.0 x 16.0
