BoujeeEnjinia1701/helpful-water/solutions/A-straw/cad/step/A1/008-bottom-potting-block-closes-fibre-ends.step

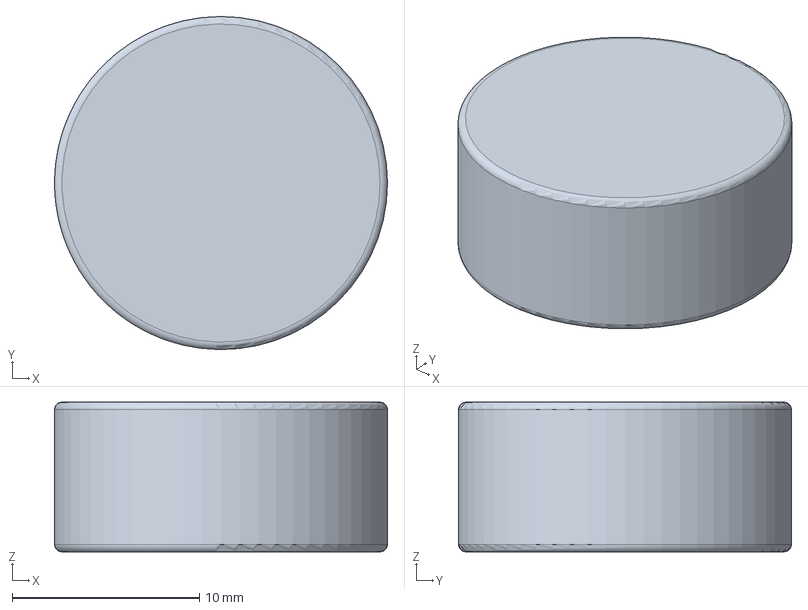
[picture p114: CAD file, 2026-11-12]
solutions/A-straw/cad/step/A1/008-bottom-potting-block-closes-fibre-ends.step
17.8 x 17.8 x 8.00 mm
