BoujeeEnjinia1701/helpful-water/solutions/A-straw/cad/stl/hwa-mouthpiece-cap.stl

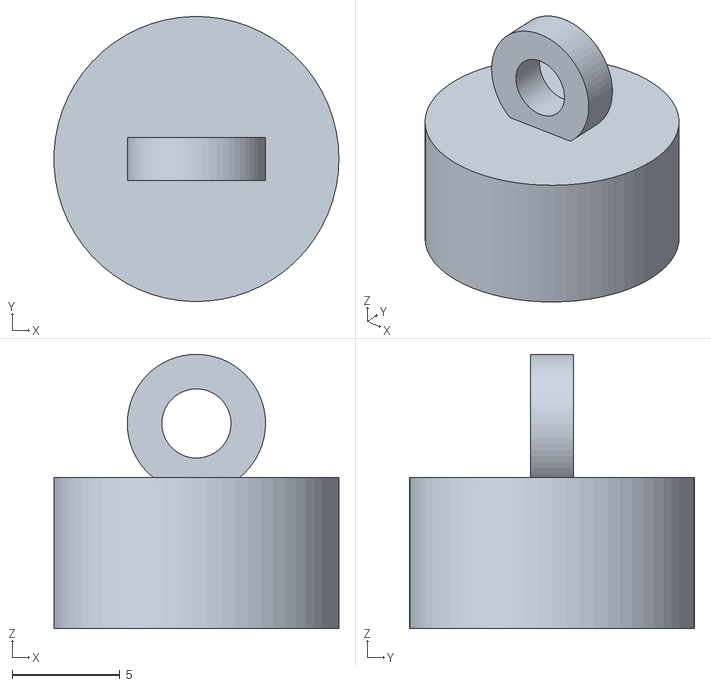
[picture p115: CAD file, 2026-11-12]
solutions/A-straw/cad/stl/hwa-mouthpiece-cap.stl
13.2 x 13.2 x 12.7
