BoujeeEnjinia1701/helpful-water/solutions/B-bottle-cartridge/cad/stl/hwb-b1-dust-cover.stl

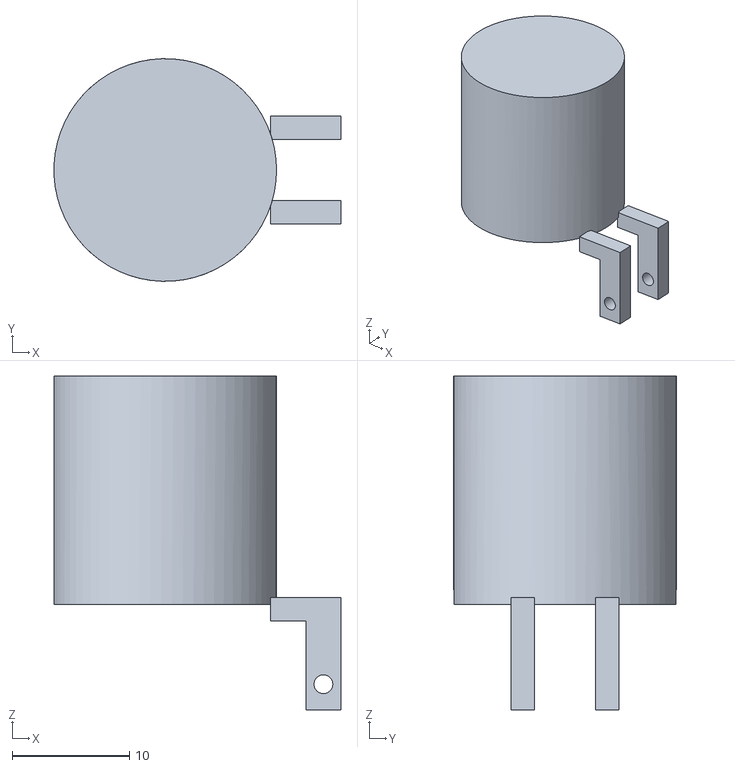
[picture p116: CAD file, 2026-11-12]
solutions/B-bottle-cartridge/cad/stl/hwb-b1-dust-cover.stl
24.5 x 19.0 x 28.5
