BoujeeEnjinia1701/helpful-water/solutions/C-gravity/cad/step/C1/067-module-header-with-clean-outlet.step

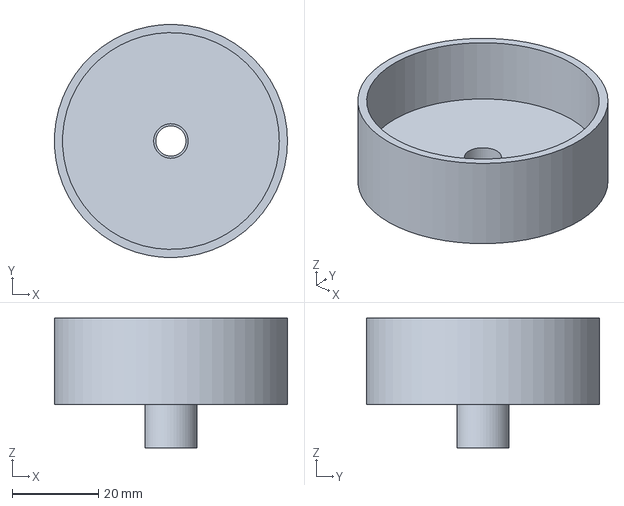
[picture p117: CAD file, 2026-11-12]
solutions/C-gravity/cad/step/C1/067-module-header-with-clean-outlet.step
54.0 x 54.0 x 30.0 mm
