BoujeeEnjinia1701/helpful-water/solutions/D-virus-add-on/cad/step/D1/021-timer-scale-label-start-30-min.step

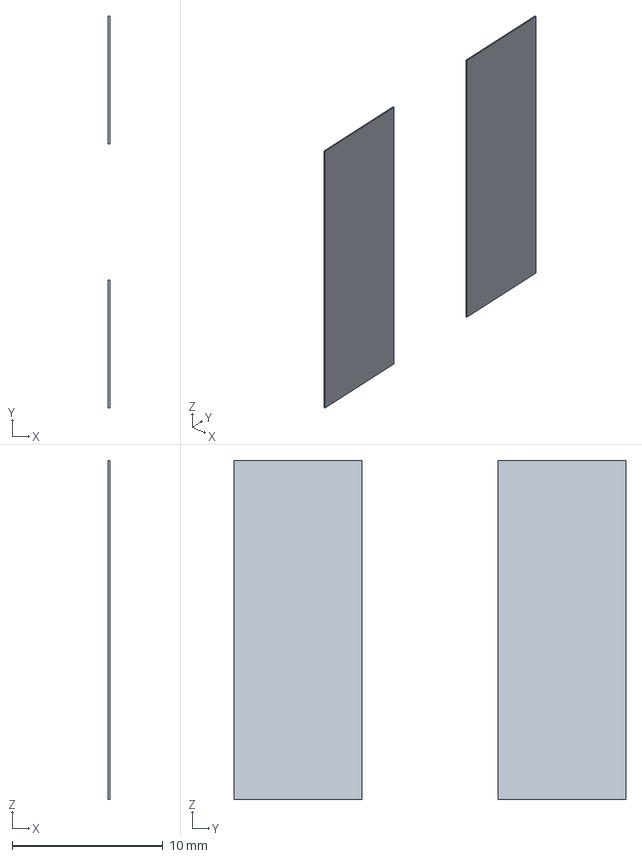
[picture p118: CAD file, 2026-11-12]
solutions/D-virus-add-on/cad/step/D1/021-timer-scale-label-start-30-min.step
0.1 x 26.0 x 22.5 mm
