BoujeeEnjinia1701/helpful-water/solutions/D-virus-add-on/cad/stl/hwd-d1-tether.stl

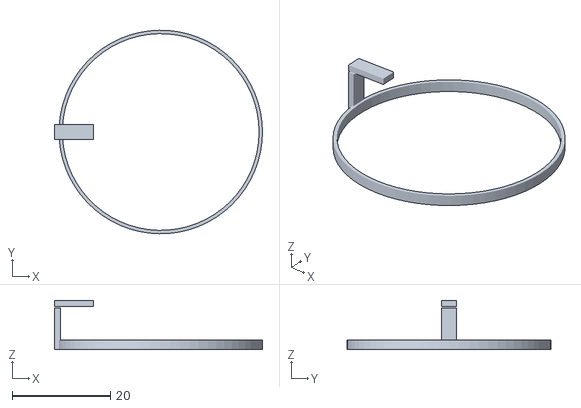
[picture p119: CAD file, 2026-11-12]
solutions/D-virus-add-on/cad/stl/hwd-d1-tether.stl
42.3 x 41.4 x 10.0
