BoujeeEnjinia1701/helpful-water/solutions/A-straw/cad/step/A1/018-o-ring-carbon-cartridge.step

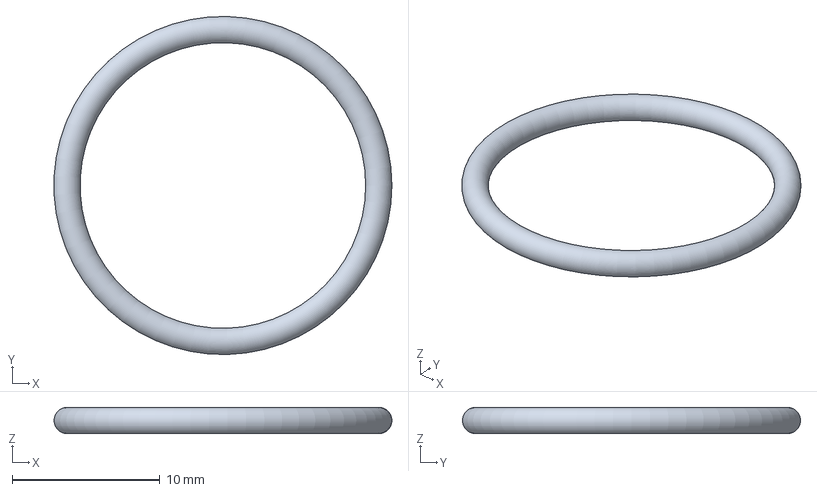
[picture p120: CAD file, 2026-11-12]
solutions/A-straw/cad/step/A1/018-o-ring-carbon-cartridge.step
22.8 x 22.9 x 1.78 mm
