BoujeeEnjinia1701/helpful-water/solutions/C-gravity/cad/step/C1/055-raw-hose-silicone-9-5-x-14-about-0-43-m.step

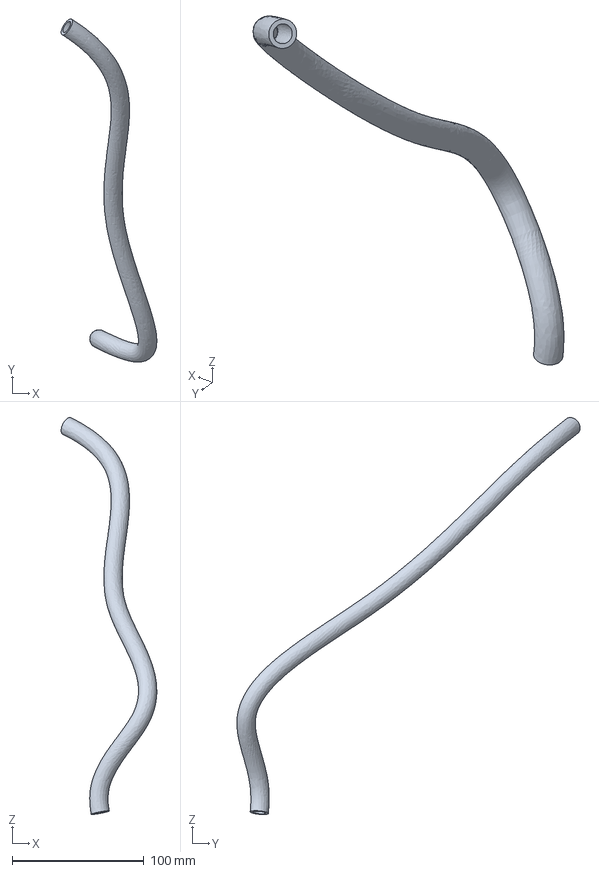
[picture p121: CAD file, 2026-11-12]
solutions/C-gravity/cad/step/C1/055-raw-hose-silicone-9-5-x-14-about-0-43-m.step
72.6 x 260.2 x 300.9 mm
