BoujeeEnjinia1701/helpful-water/solutions/D-virus-add-on/cad/step/D1/004-well-insert-o-ring-17-2-x-1-6.step

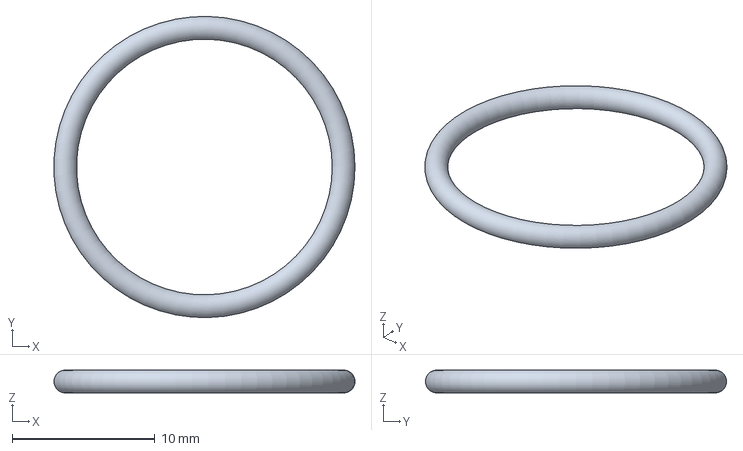
[picture p122: CAD file, 2026-11-12]
solutions/D-virus-add-on/cad/step/D1/004-well-insert-o-ring-17-2-x-1-6.step
21.1 x 21.1 x 1.60 mm
