BoujeeEnjinia1701/helpful-water/solutions/D-virus-add-on/cad/stl/hwd-d1-timer-hub.stl

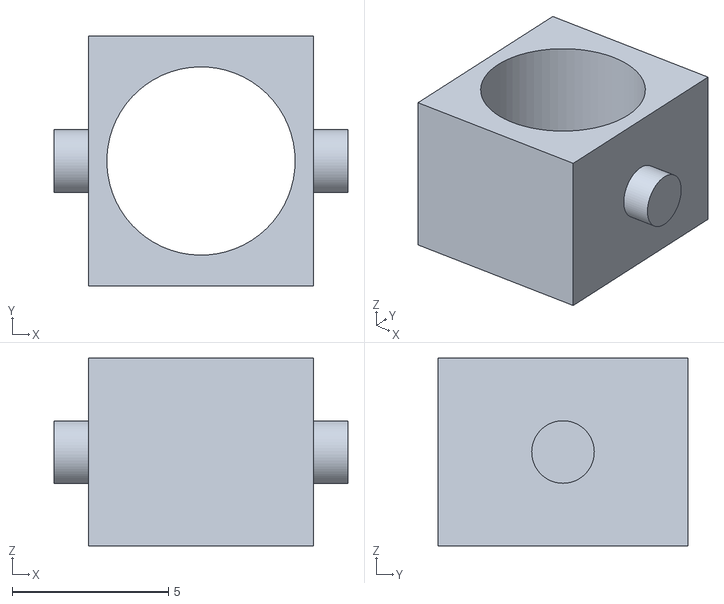
[picture p123: CAD file, 2026-11-12]
solutions/D-virus-add-on/cad/stl/hwd-d1-timer-hub.stl
9.40 x 8.00 x 6.00
