BoujeeEnjinia1701/helpful-water/solutions/B-bottle-cartridge/cad/step/B1/018-housing.step

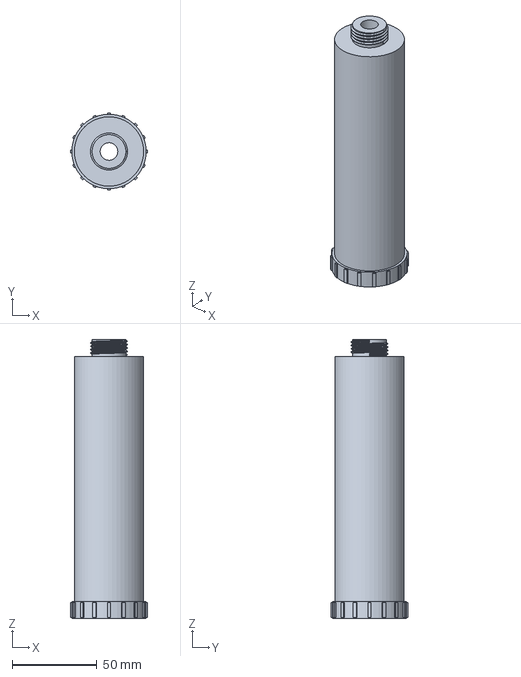
[picture p124: CAD file, 2026-11-12]
solutions/B-bottle-cartridge/cad/step/B1/018-housing.step
45.6 x 45.6 x 165.0 mm
