BoujeeEnjinia1701/helpful-water/solutions/A-straw/cad/step/A1/026-lanyard-cord.step

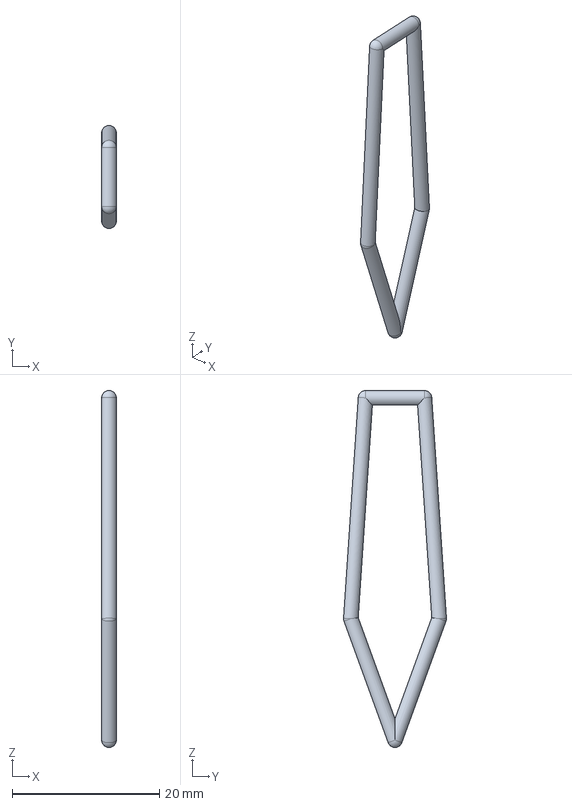
[picture p125: CAD file, 2026-11-12]
solutions/A-straw/cad/step/A1/026-lanyard-cord.step
2.00 x 14.0 x 48.5 mm
