BoujeeEnjinia1701/helpful-water/solutions/D-virus-add-on/cad/step/D1/010-timer-tube-clear.step

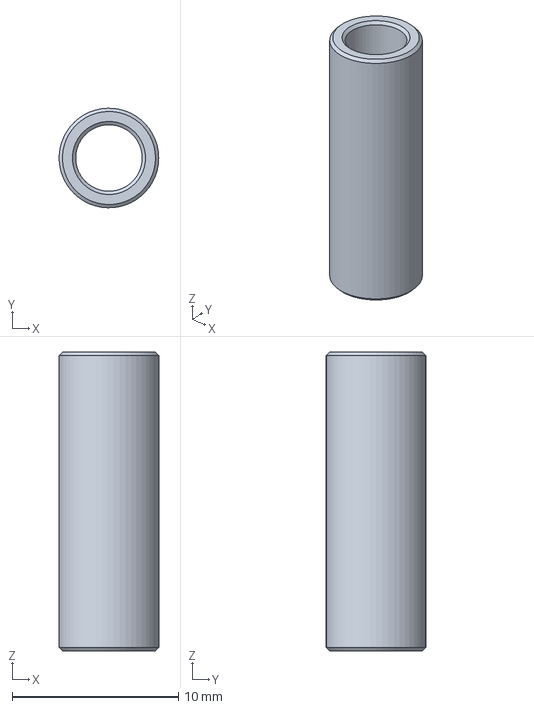
[picture p126: CAD file, 2026-11-12]
solutions/D-virus-add-on/cad/step/D1/010-timer-tube-clear.step
5.99 x 6.00 x 18.0 mm
