BoujeeEnjinia1701/helpful-water/solutions/B-bottle-cartridge/cad/step/B1/008-carbon-bed-12-x-40-coconut-gac.step

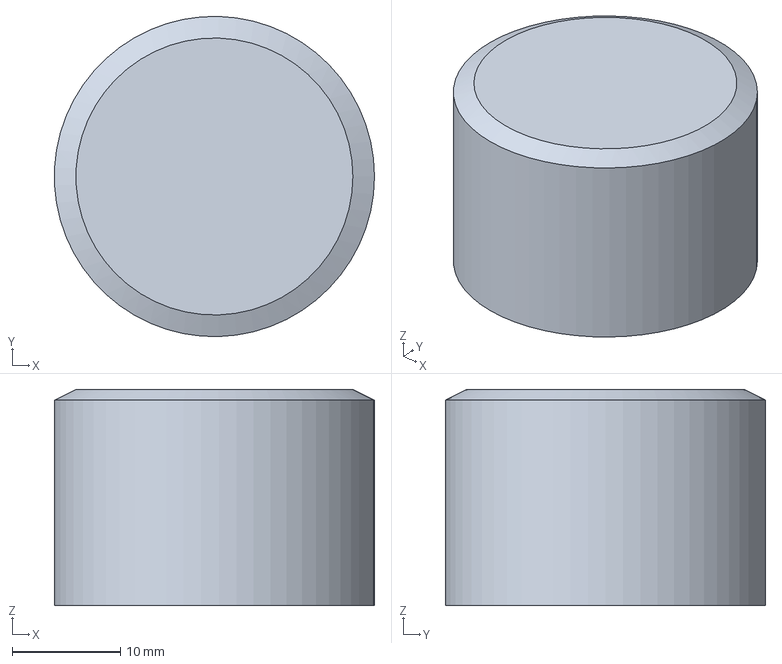
[picture p127: CAD file, 2026-11-12]
solutions/B-bottle-cartridge/cad/step/B1/008-carbon-bed-12-x-40-coconut-gac.step
29.6 x 29.6 x 20.0 mm
