BoujeeEnjinia1701/helpful-water/solutions/C-gravity/cad/step/C1/078-clean-bucket-tap-hole-cut.step

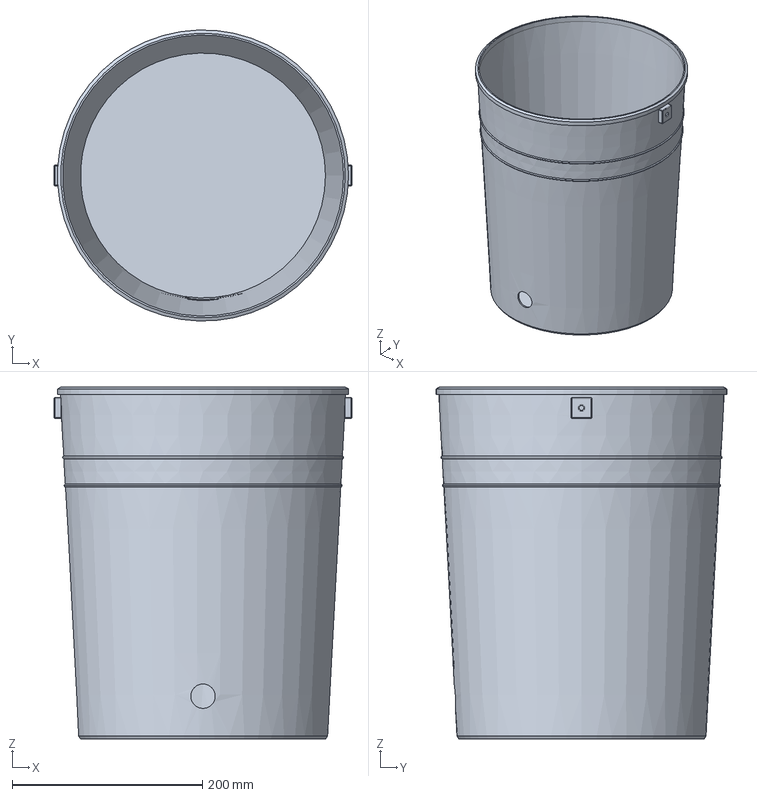
[picture p128: CAD file, 2026-11-12]
solutions/C-gravity/cad/step/C1/078-clean-bucket-tap-hole-cut.step
313.0 x 305.9 x 370.0 mm
