BoujeeEnjinia1701/helpful-water/solutions/D-virus-add-on/cad/step/D1/009-pictogram-label-on-the-crown.step

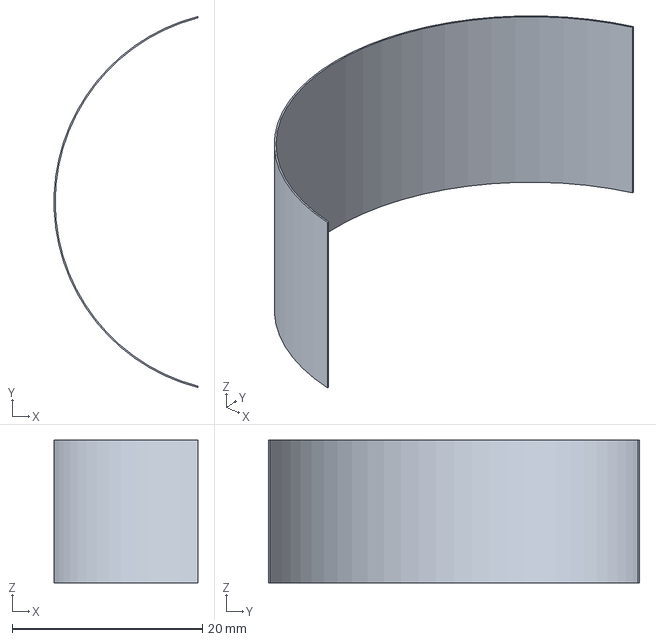
[picture p129: CAD file, 2026-11-12]
solutions/D-virus-add-on/cad/step/D1/009-pictogram-label-on-the-crown.step
15.1 x 39.0 x 15.0 mm
