BoujeeEnjinia1701/helpful-water/solutions/B-bottle-cartridge/cad/step/B1/014-potting-block-module.step

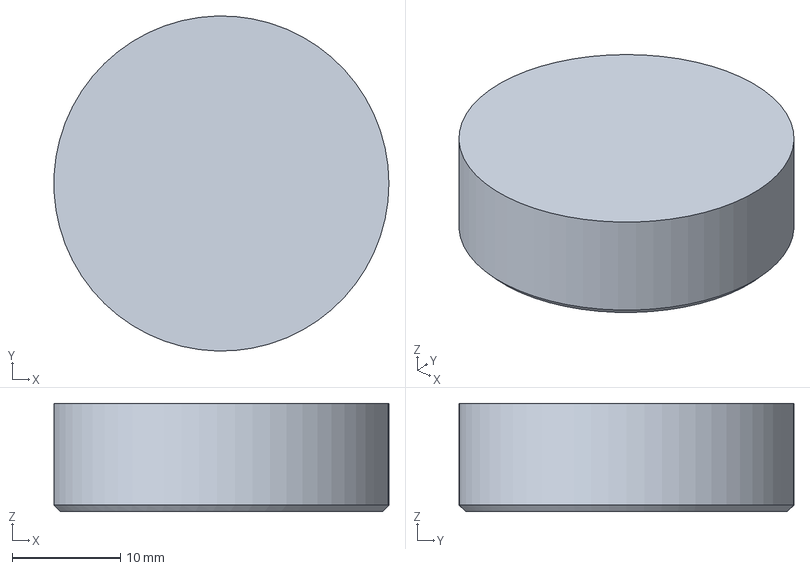
[picture p130: CAD file, 2026-11-12]
solutions/B-bottle-cartridge/cad/step/B1/014-potting-block-module.step
31.0 x 31.0 x 10.0 mm
