BoujeeEnjinia1701/helpful-water/solutions/C-gravity/cad/step/C1/056-raw-lid-fill-and-dosing-holes-cut.step

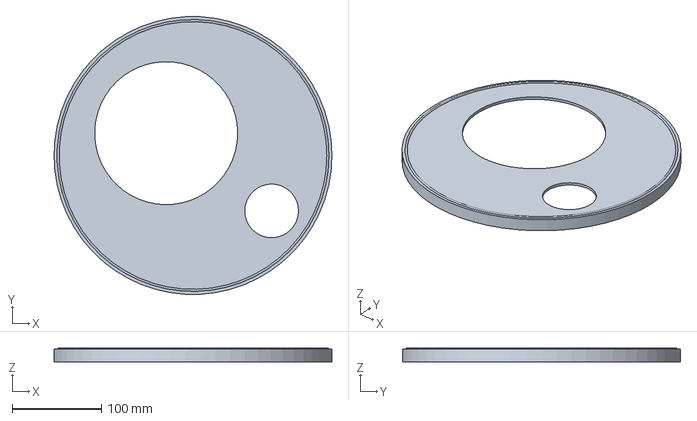
[picture p131: CAD file, 2026-11-12]
solutions/C-gravity/cad/step/C1/056-raw-lid-fill-and-dosing-holes-cut.step
311.2 x 310.7 x 15.4 mm
