BoujeeEnjinia1701/helpful-water/solutions/A-straw/cad/step/A1/016-activated-carbon-bed-coconut-gac.step

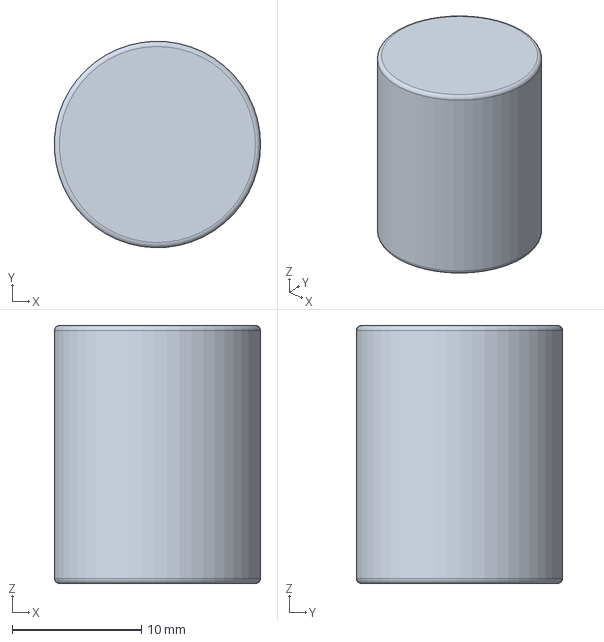
[picture p132: CAD file, 2026-11-12]
solutions/A-straw/cad/step/A1/016-activated-carbon-bed-coconut-gac.step
16.0 x 16.0 x 20.0 mm
