BoujeeEnjinia1701/helpful-water/solutions/C-gravity/cad/step/C1/002-foot-left-45-x-45-x-560.step

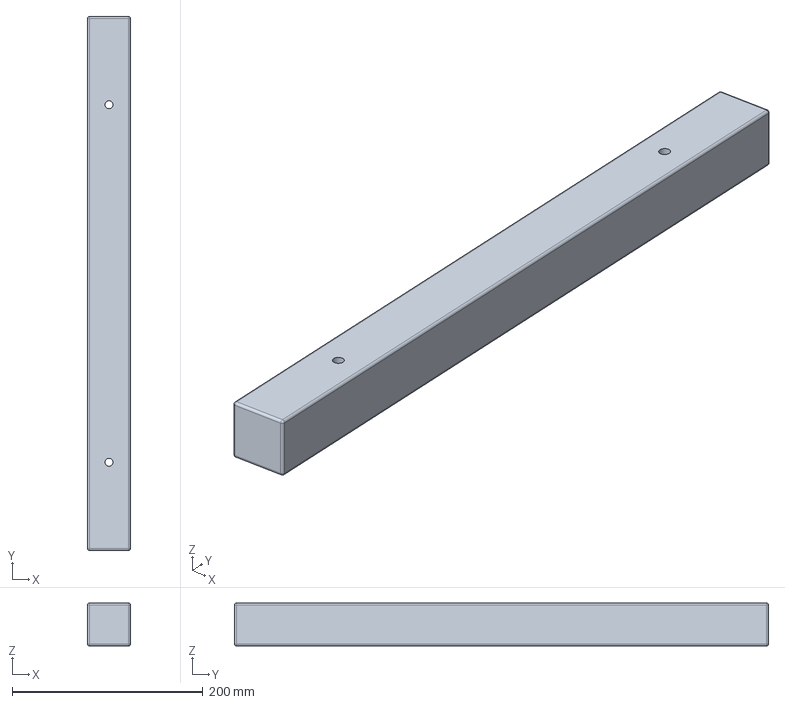
[picture p133: CAD file, 2026-11-12]
solutions/C-gravity/cad/step/C1/002-foot-left-45-x-45-x-560.step
45.0 x 560.0 x 45.0 mm
