BoujeeEnjinia1701/helpful-water/solutions/C-gravity/cad/step/C1/052-ball-valve-lever.step

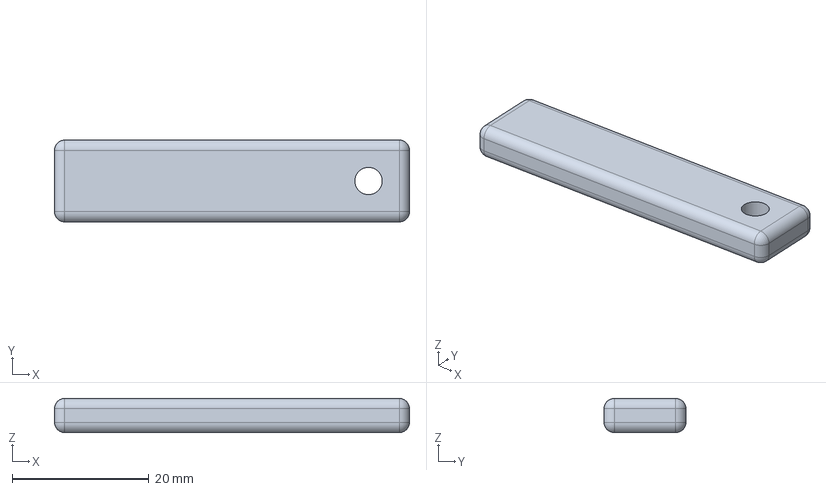
[picture p134: CAD file, 2026-11-12]
solutions/C-gravity/cad/step/C1/052-ball-valve-lever.step
52.0 x 12.0 x 5.00 mm
