BoujeeEnjinia1701/helpful-water/solutions/D-virus-add-on/cad/step/D1/007-plug-o-ring-22-6-x-1-6.step

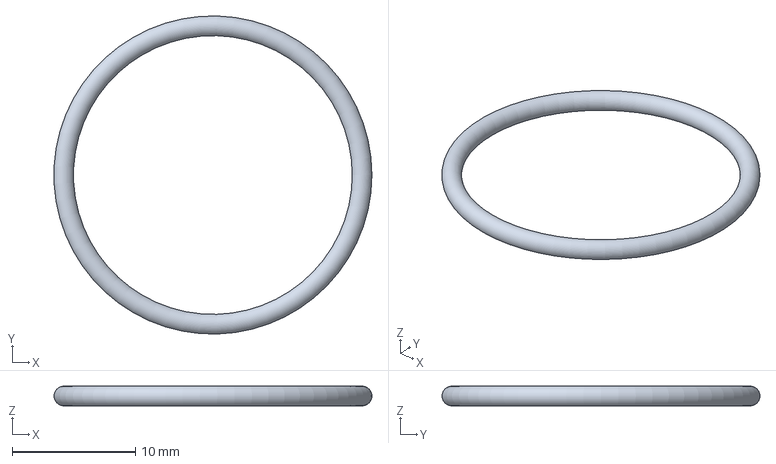
[picture p135: CAD file, 2026-11-12]
solutions/D-virus-add-on/cad/step/D1/007-plug-o-ring-22-6-x-1-6.step
25.8 x 25.8 x 1.60 mm
