BoujeeEnjinia1701/helpful-water/solutions/B-bottle-cartridge/cad/step/B1/015-module-header-with-clean-nipple.step

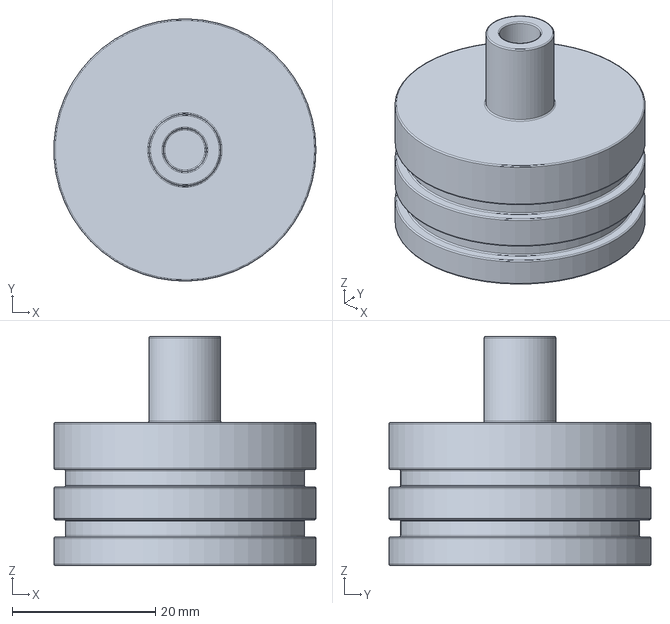
[picture p136: CAD file, 2026-11-12]
solutions/B-bottle-cartridge/cad/step/B1/015-module-header-with-clean-nipple.step
36.6 x 36.6 x 32.0 mm
