BoujeeEnjinia1701/helpful-water/solutions/C-gravity/cad/step/C1/073-clean-side-tee-with-luer-backflush-port.step

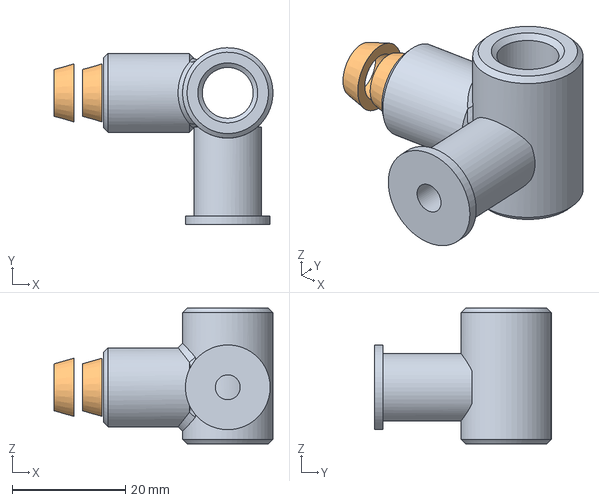
[picture p137: CAD file, 2026-11-12]
solutions/C-gravity/cad/step/C1/073-clean-side-tee-with-luer-backflush-port.step
38.8 x 31.2 x 24.0 mm
