BoujeeEnjinia1701/helpful-water/solutions/D-virus-add-on/cad/step/D1/012-timer-end-o-ring-bottom-3-0-x-0-5.step

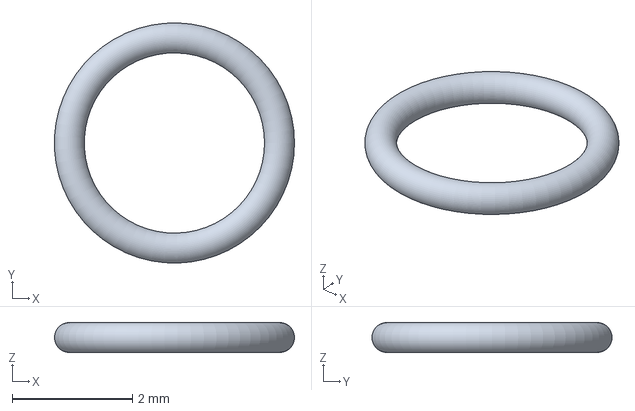
[picture p138: CAD file, 2026-11-12]
solutions/D-virus-add-on/cad/step/D1/012-timer-end-o-ring-bottom-3-0-x-0-5.step
4.00 x 4.00 x 0.5 mm
