BoujeeEnjinia1701/helpful-water/solutions/B-bottle-cartridge/cad/step/B1/011-module-end-cap.step

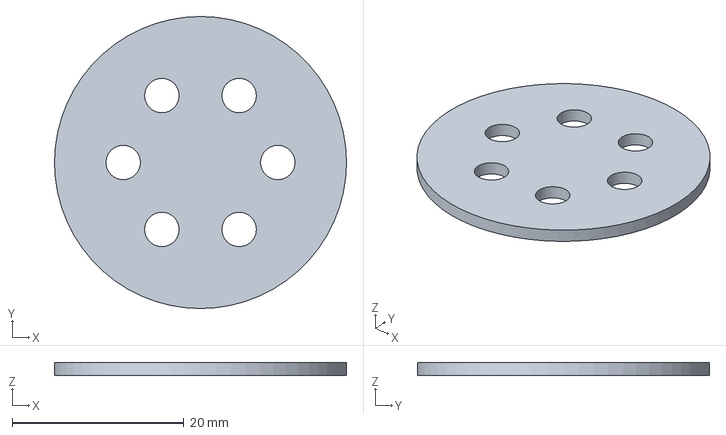
[picture p139: CAD file, 2026-11-12]
solutions/B-bottle-cartridge/cad/step/B1/011-module-end-cap.step
34.0 x 34.0 x 1.50 mm
