BoujeeEnjinia1701/helpful-water/solutions/C-gravity/cad/step/C1/049-outer-gasket-bulkhead-fitting.step

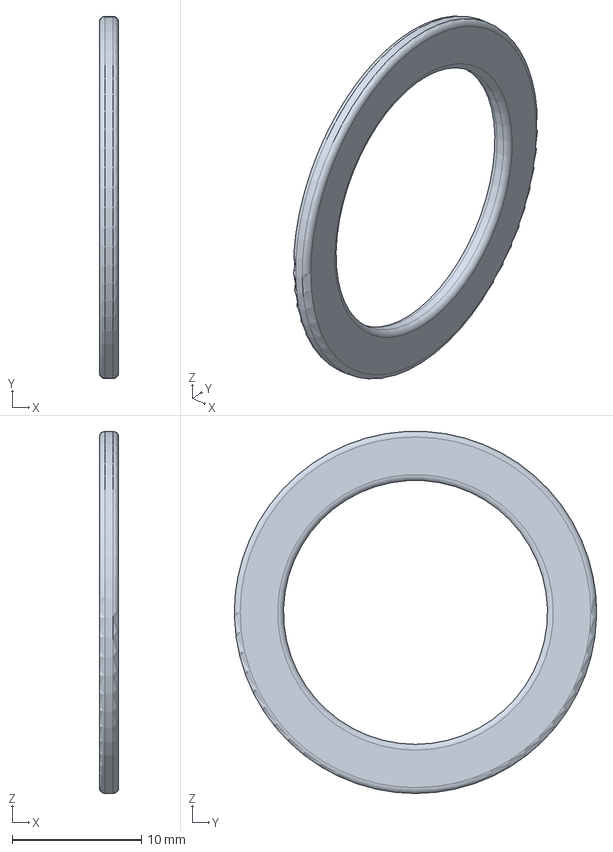
[picture p140: CAD file, 2026-11-12]
solutions/C-gravity/cad/step/C1/049-outer-gasket-bulkhead-fitting.step
1.50 x 28.0 x 28.0 mm
