BoujeeEnjinia1701/helpful-water/solutions/C-gravity/cad/step/C1/083-drum-tap-3-4-in.step

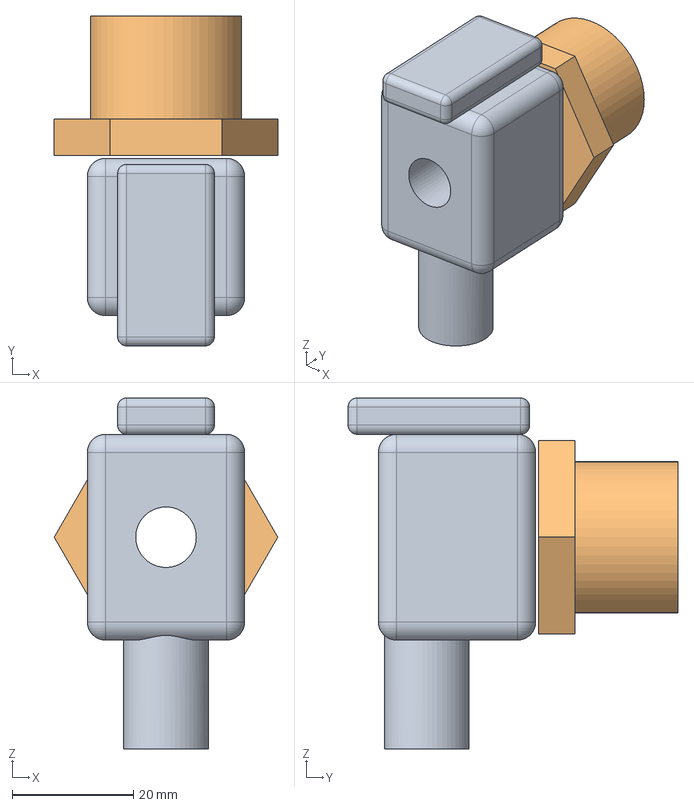
[picture p141: CAD file, 2026-11-12]
solutions/C-gravity/cad/step/C1/083-drum-tap-3-4-in.step
37.0 x 54.5 x 58.0 mm
