BoujeeEnjinia1701/helpful-water/solutions/B-bottle-cartridge/cad/step/B1/003-duckbill-air-valve-silicone.step

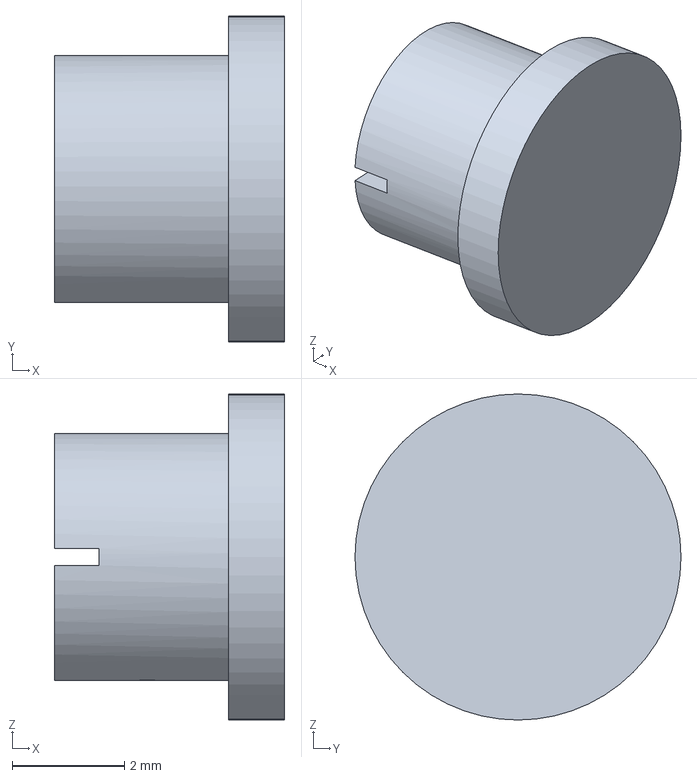
[picture p142: CAD file, 2026-11-12]
solutions/B-bottle-cartridge/cad/step/B1/003-duckbill-air-valve-silicone.step
4.10 x 5.80 x 5.80 mm
