BoujeeEnjinia1701/helpful-water/solutions/C-gravity/cad/step/C1/077-pinch-clamp-on-the-clean-hose.step

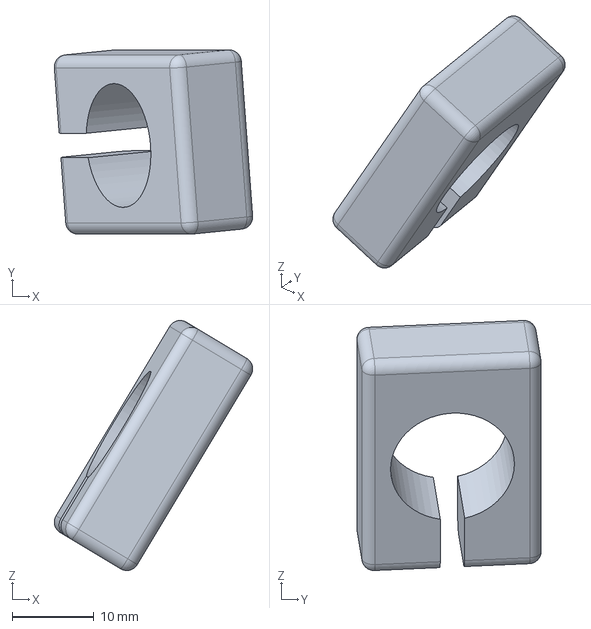
[picture p143: CAD file, 2026-11-12]
solutions/C-gravity/cad/step/C1/077-pinch-clamp-on-the-clean-hose.step
24.3 x 22.5 x 30.6 mm
