BoujeeEnjinia1701/helpful-water/solutions/B-bottle-cartridge/cad/step/B1/019-spout-gasket-flat-epdm.step

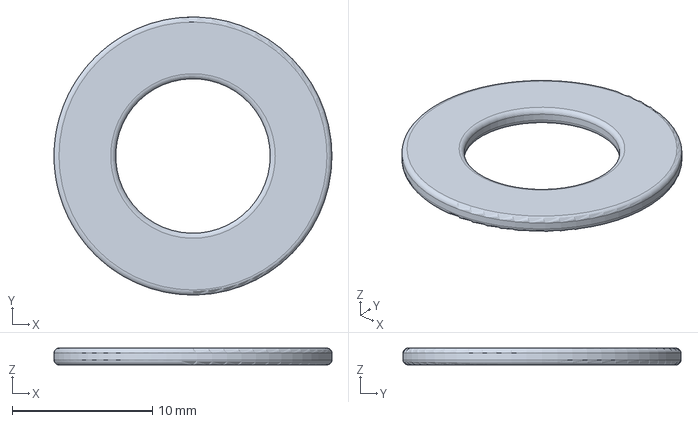
[picture p144: CAD file, 2026-11-12]
solutions/B-bottle-cartridge/cad/step/B1/019-spout-gasket-flat-epdm.step
19.8 x 19.8 x 1.20 mm
