BoujeeEnjinia1701/helpful-water/solutions/C-gravity/cad/step/C1/004-leg-back-right-45-x-45-x-837.step

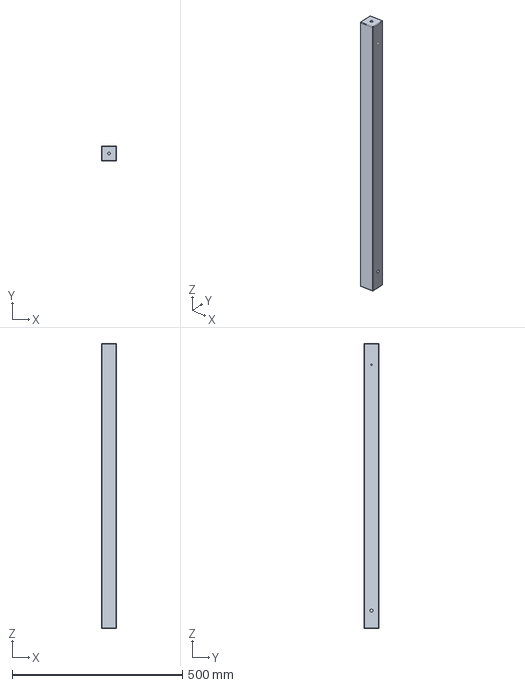
[picture p145: CAD file, 2026-11-12]
solutions/C-gravity/cad/step/C1/004-leg-back-right-45-x-45-x-837.step
45.0 x 45.0 x 837.0 mm
