BoujeeEnjinia1701/helpful-water/solutions/A-straw/cad/step/A1/015-carbon-inlet-screen-316l.step

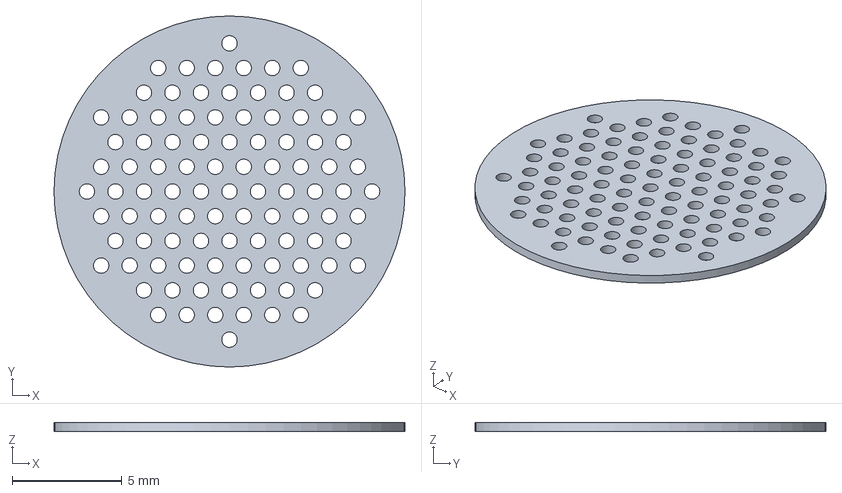
[picture p146: CAD file, 2026-11-12]
solutions/A-straw/cad/step/A1/015-carbon-inlet-screen-316l.step
16.0 x 16.0 x 0.4 mm
