BoujeeEnjinia1701/helpful-water/solutions/A-straw/cad/step/A1/011-module-header-collar.step

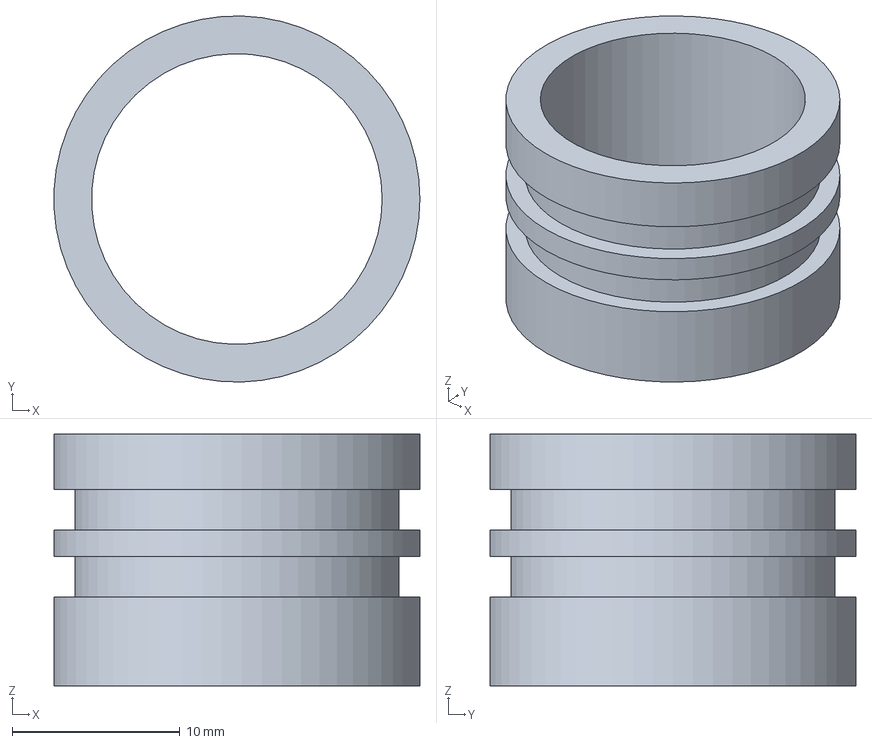
[picture p147: CAD file, 2026-11-12]
solutions/A-straw/cad/step/A1/011-module-header-collar.step
21.8 x 21.8 x 15.0 mm
