BoujeeEnjinia1701/helpful-water/solutions/C-gravity/cad/step/C1/082-insect-screen-disc-stainless.step

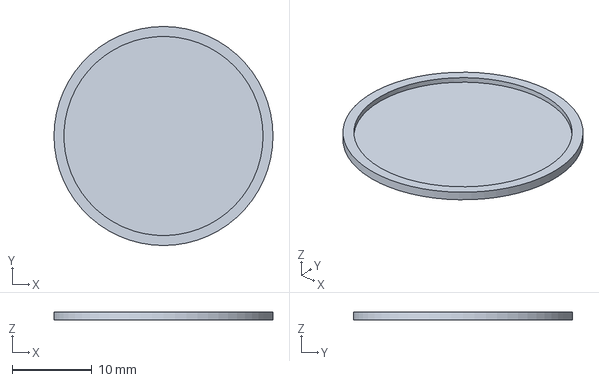
[picture p148: CAD file, 2026-11-12]
solutions/C-gravity/cad/step/C1/082-insect-screen-disc-stainless.step
27.5 x 27.5 x 1.00 mm
