BoujeeEnjinia1701/helpful-water/solutions/C-gravity/cad/step/C1/054-hose-barb-3-8-in-raw.step

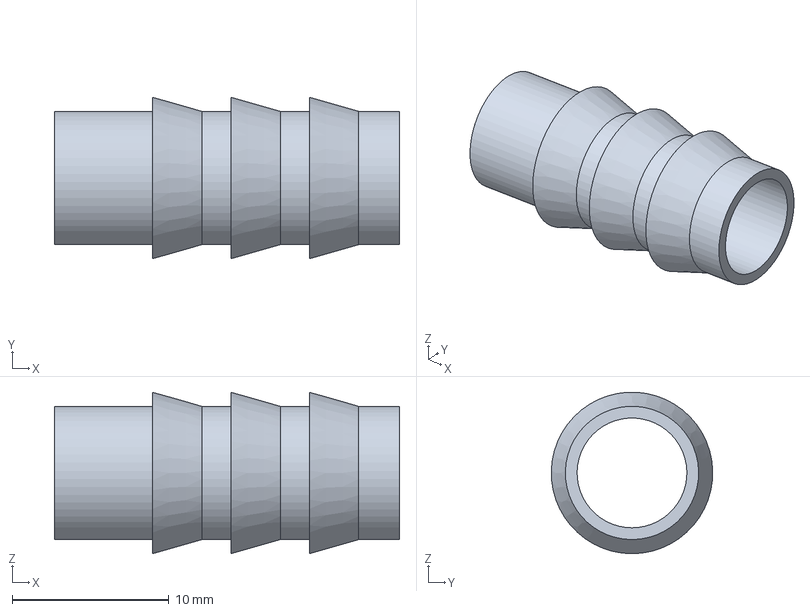
[picture p149: CAD file, 2026-11-12]
solutions/C-gravity/cad/step/C1/054-hose-barb-3-8-in-raw.step
22.0 x 10.3 x 10.3 mm
