BoujeeEnjinia1701/helpful-water/solutions/C-gravity/cad/step/C1/057-prefilter-cloth-cotton-folded-to-8-layers.step

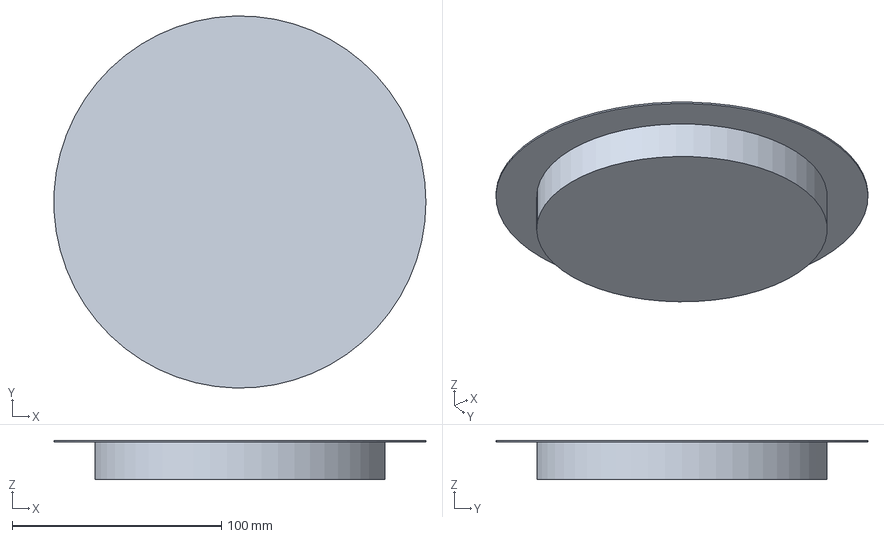
[picture p150: CAD file, 2026-11-12]
solutions/C-gravity/cad/step/C1/057-prefilter-cloth-cotton-folded-to-8-layers.step
177.9 x 177.9 x 18.8 mm
