BoujeeEnjinia1701/helpful-water/solutions/C-gravity/cad/step/C1/086-label-treated-water-refill-line-weekly-chlorine-.step

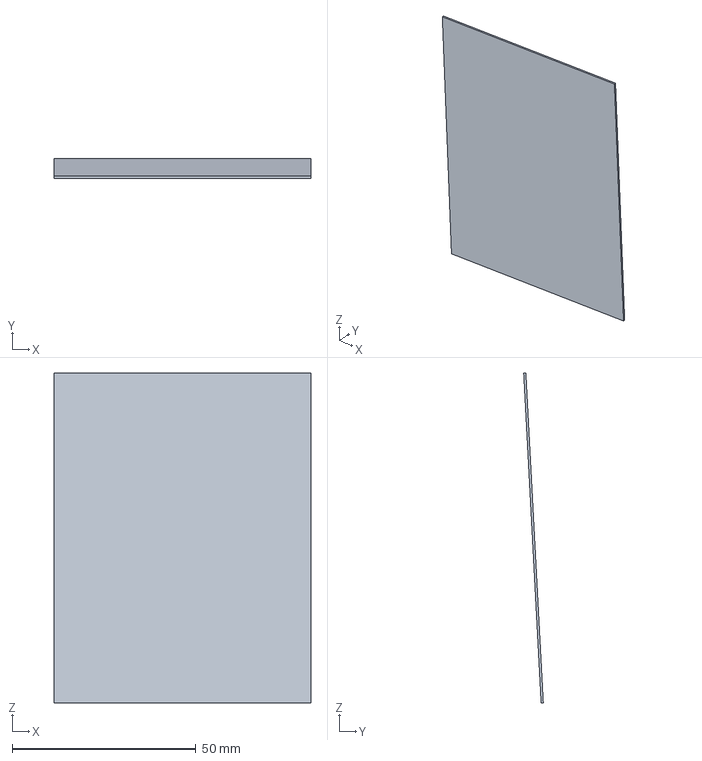
[picture p151: CAD file, 2026-11-12]
solutions/C-gravity/cad/step/C1/086-label-treated-water-refill-line-weekly-chlorine-.step
70.0 x 5.36 x 89.9 mm
