BoujeeEnjinia1701/helpful-water/solutions/C-gravity/cad/step/C1/065-fibre-bundle-looped-outside-in-0-1-um.step

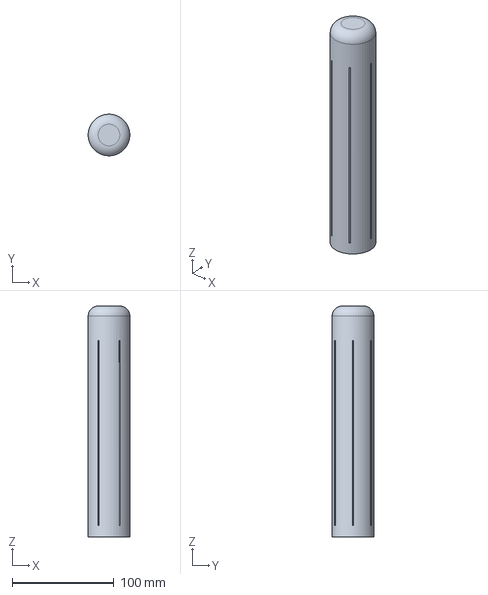
[picture p152: CAD file, 2026-11-12]
solutions/C-gravity/cad/step/C1/065-fibre-bundle-looped-outside-in-0-1-um.step
41.0 x 41.0 x 227.0 mm
