BoujeeEnjinia1701/helpful-water/solutions/C-gravity/cad/step/C1/009-upper-shelf-plywood-18-mm.step

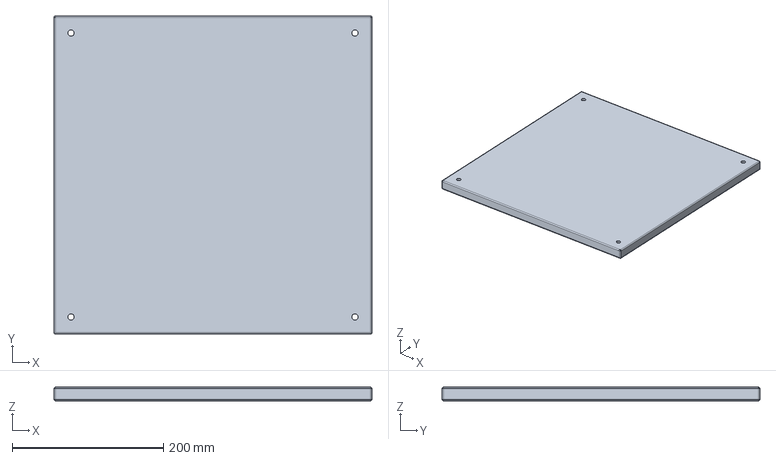
[picture p153: CAD file, 2026-11-12]
solutions/C-gravity/cad/step/C1/009-upper-shelf-plywood-18-mm.step
420.0 x 420.0 x 18.0 mm
