BoujeeEnjinia1701/helpful-water/solutions/C-gravity/cad/step/C1/064-module-shell.step

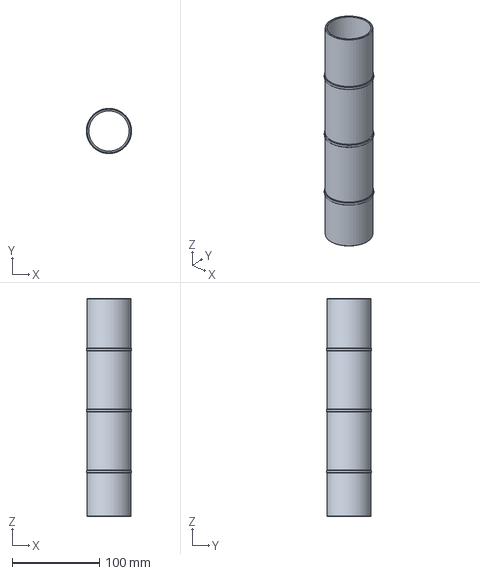
[picture p154: CAD file, 2026-11-12]
solutions/C-gravity/cad/step/C1/064-module-shell.step
52.0 x 52.0 x 250.0 mm
