BoujeeEnjinia1701/helpful-water/solutions/C-gravity/cad/step/C1/046-raw-outlet-bulkhead-fitting.step

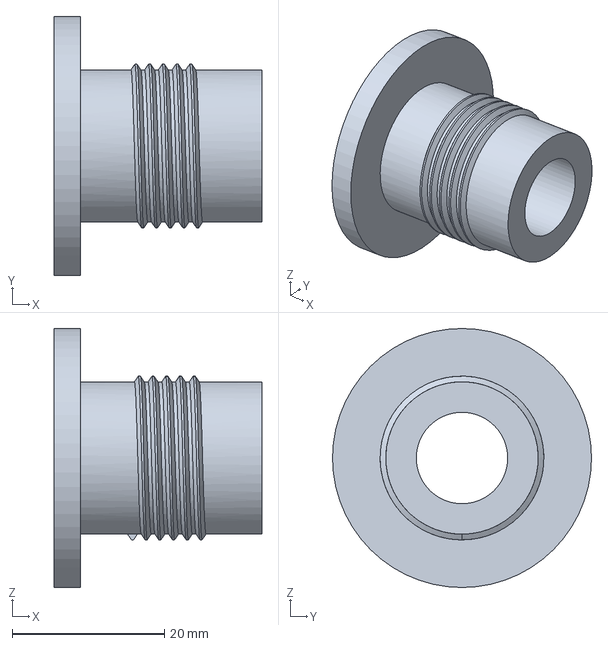
[picture p155: CAD file, 2026-11-12]
solutions/C-gravity/cad/step/C1/046-raw-outlet-bulkhead-fitting.step
27.3 x 34.0 x 34.0 mm
