BoujeeEnjinia1701/helpful-water/solutions/C-gravity/cad/step/C1/063-module-top-cap-with-raw-inlet.step

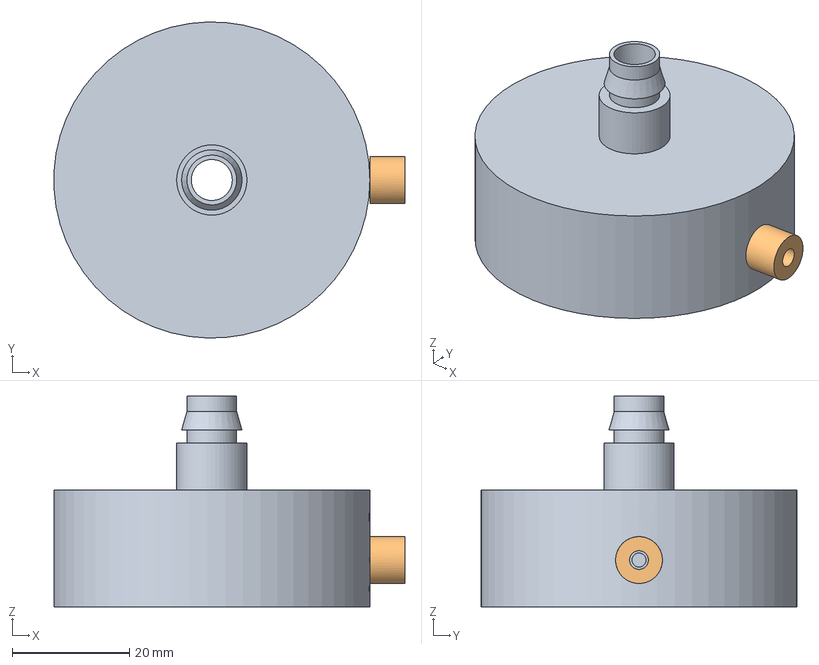
[picture p156: CAD file, 2026-11-12]
solutions/C-gravity/cad/step/C1/063-module-top-cap-with-raw-inlet.step
60.0 x 54.0 x 36.0 mm
