BoujeeEnjinia1701/helpful-water/solutions/C-gravity/cad/step/C1/051-ball-valve-1-2-in-polypropylene.step

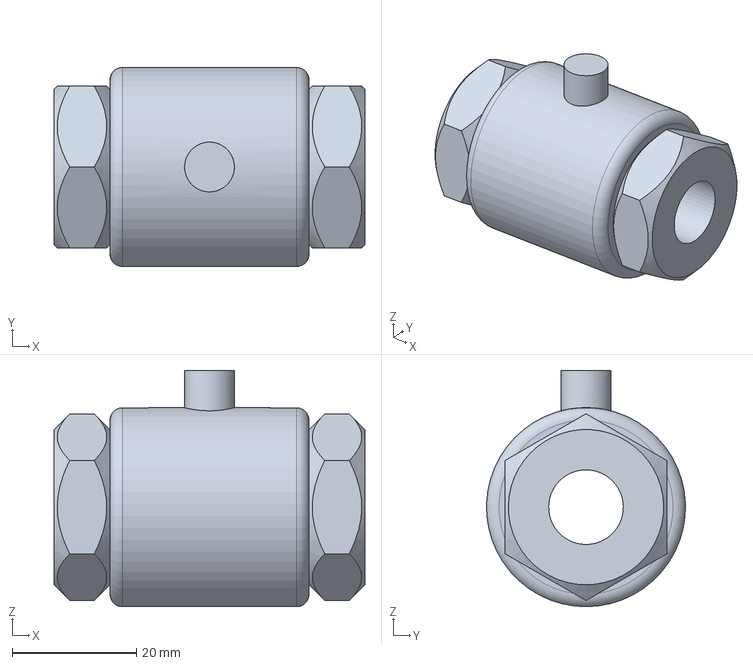
[picture p157: CAD file, 2026-11-12]
solutions/C-gravity/cad/step/C1/051-ball-valve-1-2-in-polypropylene.step
50.0 x 32.0 x 38.0 mm
