BoujeeEnjinia1701/helpful-water/(list of files, cad)

Other CAD files:
solutions/B-bottle-cartridge/cad/stl/hwb-b1-cartridge-assembly.stl
solutions/D-virus-add-on/cad/step/D1-assembly.step
solutions/A-straw/cad/step/A1/002-intake-cap.step
solutions/B-bottle-cartridge/cad/stl/hwb-b1-neck-collar.stl
solutions/D-virus-add-on/cad/stl/hwd-d1-timer-window.stl
solutions/C-gravity/cad/step/C1/058-cloth-clamp-ring.step
solutions/D-virus-add-on/cad/step/D1/013-timer-end-cap-top.step
solutions/B-bottle-cartridge/cad/step/B1/020-spout-with-nozzle-and-hinge-lug.step
solutions/A-straw/cad/stl/hwa-intake-cover.stl
solutions/B-bottle-cartridge/cad/step/B1/005-collar-o-ring-33-4-x-2.step
solutions/A-straw/cad/step/A1/012-o-ring-module-lower-clean-dirty-seal.step
solutions/C-gravity/cad/step/C1/061-dosing-port-cap.step
solutions/D-virus-add-on/cad/step/D1/001-dose-cap-body-with-pco-1881-thread-and-timer-bos.step
solutions/B-bottle-cartridge/cad/step/B1/010-carbon-capsule-lid.step
solutions/C-gravity/cad/step/C1/012-diagonal-brace-left-70-x-20.step
solutions/A-straw/cad/step/A1/022-o-ring-mouthpiece-inner.step
solutions/A-straw/cad/step/A1/006-housing-body.step
solutions/D-virus-add-on/cad/step/D1/017-timer-hub-with-trunnions.step
solutions/B-bottle-cartridge/cad/step/B1/017-header-o-ring-2-33-4-x-2.step
solutions/D-virus-add-on/cad/step/D1/008-tether-band-and-strap.step
solutions/A-straw/cad/step/A1/013-o-ring-module-upper-clean-dirty-seal.step
solutions/B-bottle-cartridge/cad/step/B1/006-carbon-capsule-body.step
solutions/A-straw/cad/step/A1/003-o-ring-intake-cap-grit-seal.step
solutions/C-gravity/cad/step/C1/080-clean-inlet-fitting.step
solutions/D-virus-add-on/cad/step/D1/003-tablet-well-insert-1-l-blue-9-5-mm-bore.step
solutions/A-straw/cad/step/A1/005-mesh-retaining-ring.step
solutions/B-bottle-cartridge/cad/step/B1/021-push-pull-drink-valve.step
solutions/D-virus-add-on/cad/step/D1/006-well-plug-clear-with-tether-lug.step
solutions/A-straw/cad/step/A1/023-o-ring-mouthpiece-outer.step
solutions/B-bottle-cartridge/cad/step/B1/007-retention-pad-lower.step
solutions/C-gravity/cad/step/C1/001-foot-right-45-x-45-x-560.step
solutions/A-straw/cad/step/A1/014-carbon-cartridge-body.step
solutions/D-virus-add-on/cad/step/D1/014-timer-end-o-ring-top-3-0-x-0-5.step
solutions/A-straw/cad/step/A1/021-mouthpiece.step
solutions/B-bottle-cartridge/cad/step/B1/002-neck-gasket-flat-epdm.step
solutions/A-straw/cad/step/A1/024-mouthpiece-cap.step
solutions/B-bottle-cartridge/cad/step/B1/023-dust-cover.step
solutions/C-gravity/cad/step/C1/059-fill-cover-with-handle.step
solutions/A-straw/cad/step/A1/019-backflush-port-plug-tethered.step
solutions/A-straw/cad/step/A1/020-tether-band.step
solutions/C-gravity/cad/step/C1/053-valve-tag-shut-30-minutes-after-dosing.step
solutions/C-gravity/cad/step/C1/005-leg-front-left-45-x-45-x-837.step
solutions/C-gravity/cad/step/C1/006-leg-back-left-45-x-45-x-837.step
solutions/C-gravity/cad/step/C1/003-leg-front-right-45-x-45-x-837.step
solutions/C-gravity/cad/step/C1/007-lower-rail-right-45-x-45-x-420.step
solutions/C-gravity/cad/step/C1/045-raw-bucket-outlet-hole-cut-fill-line-marked.step
solutions/C-gravity/cad/step/C1/047-raw-outlet-nut-bulkhead-fitting.step
solutions/C-gravity/cad/step/C1/048-inner-gasket-bulkhead-fitting.step
solutions/C-gravity/cad/step/C1/050-strainer-250-um-on-the-raw-outlet.step
solutions/C-gravity/cad/step/C1/060-dosing-port-collar-for-solution-d.step
solutions/C-gravity/cad/step/C1/062-label-settle-dose-d-wait-30-min-open-valve-no-vi.step
solutions/C-gravity/cad/step/C1/066-potting-block-module.step
solutions/C-gravity/cad/step/C1/069-p-clip-1-nylon-50-mm.step
solutions/C-gravity/cad/step/C1/071-p-clip-2-nylon-50-mm.step
solutions/C-gravity/cad/step/C1/075-backflush-port-cap.step
solutions/C-gravity/cad/step/C1/079-clean-lid-inlet-and-vent-holes-cut.step
solutions/C-gravity/cad/step/C1/084-tap-nut.step
solutions/C-gravity/cad/step/C1/085-tap-gasket.step
