BoujeeEnjinia1701/helpful-water/.kit/templates/issue-openratio/build-report.md

---
name: Build report
about: Tell us what happened when you built, printed or tested part of this design
title: "Build report: "
labels: build-report
---

This is a research and educational prototype, not a medical device. It is a TRL 3 concept and is not released for fabrication. If you build any part of it, you do so at your own risk. Reports help everyone.

**What you built** (part, sub-assembly or test)

**Materials, tools and settings**

**What worked**

**What did not work, with photos or measurements if you have them**
