BoujeeEnjinia1701/helpful-water/.kit/templates/verification-plan.md

---
doc_id: PRJ-VER-001
title: Project verification plan
project: Project name
doc_type: Verification plan
version: "0.1"
status: Draft
date: YYYY-MM-DD
author: Amish Chadha
license: CC-BY-4.0
revisions:
  - version: "0.1"
    date: YYYY-MM-DD
    author: Amish Chadha
    change: Initial draft
---

# Project verification plan

Planned TRL 4 verification on paper. Nothing here is run at TRL 3. Method: STANDARDS section 25.7.

Table 1. Test families.

| Family | Method and observations | Evidence needed for the gate | Solutions | Requirements |
| --- | --- | --- | --- | --- |

Licence: this document is licensed under CC-BY-4.0.
