BoujeeEnjinia1701/helpful-water/solutions/B-bottle-cartridge/media/concept-blueprint.pdf

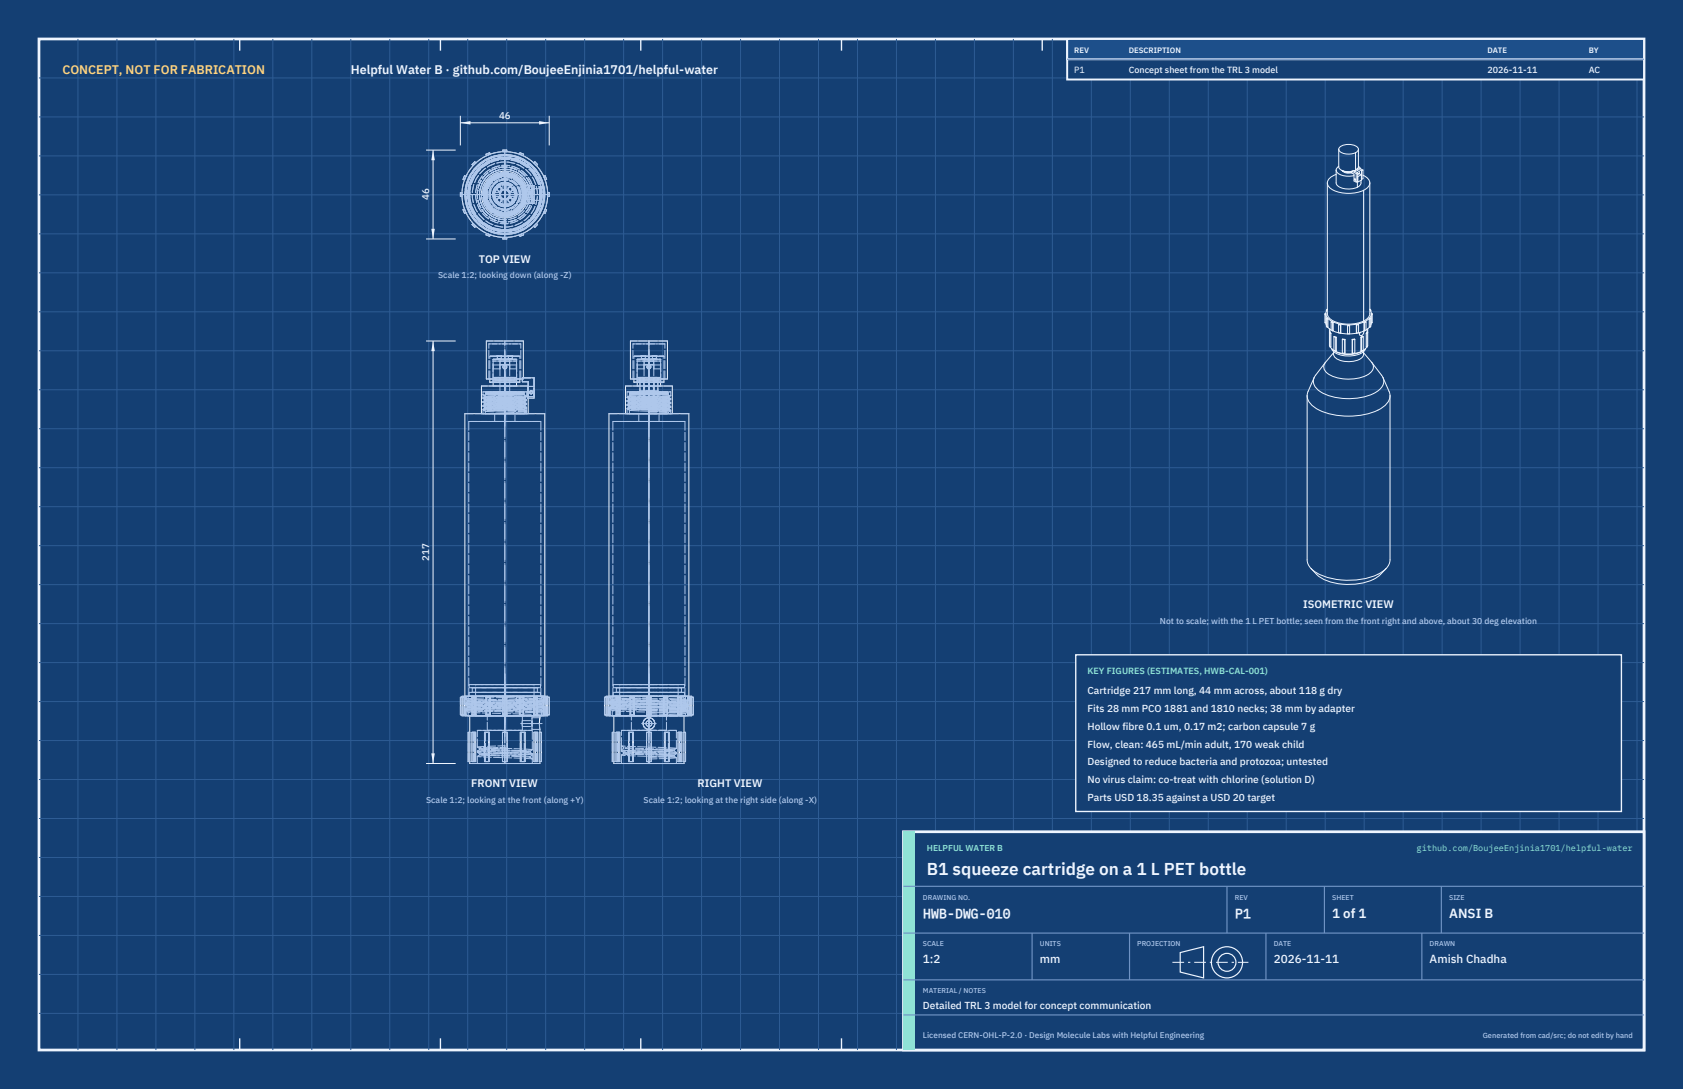
[picture p249: page 1]
CONCEPT, NOT FOR FABRICATION; Helpful Water B · github.com/BoujeeEnjinia1701/helpful-water; FRONT VIEW; TOP VIEW; RIGHT VIEW; ISOMETRIC VIEW; REV; DESCRIPTION; DATE; Concept sheet from the TRL 3 model; HELPFUL WATER B; github.com/BoujeeEnjinia1701/helpful-water; DRAWING NO. HWB-DWG-010; REV P1; SHEET 1 of 1; SIZE ANSI B; SCALE 1:2; UNITS mm; PROJECTION; DRAWN Amish Chadha; Licensed CERN-OHL-P-2.0 · Design Molecule Labs with Helpful Engineering; Generated from cad/src; do not edit by hand

Scale 1:2; looking down (along -Z)

Not to scale; with the 1 L PET bottle; seen from the front right and above, about 30 deg elevation

KEY FIGURES (ESTIMATES, HWB-CAL-001)
Cartridge 217 mm long, 44 mm across, about 118 g dry
Fits 28 mm PCO 1881 and 1810 necks; 38 mm by adapter
Hollow fibre 0.1 um, 0.17 m2; carbon capsule 7 g
Flow, clean: 465 mL/min adult, 170 weak child
Designed to reduce bacteria and protozoa; untested
No virus claim: co-treat with chlorine (solution D)
Parts USD 18.35 against a USD 20 target

Scale 1:2; looking at the front (along +Y)

Scale 1:2; looking at the right side (along -X)

B1 squeeze cartridge on a 1 L PET bottle

MATERIAL / NOTES
Detailed TRL 3 model for concept communication
