BoujeeEnjinia1701/helpful-water/solutions/C-gravity/media/concept-blueprint.pdf

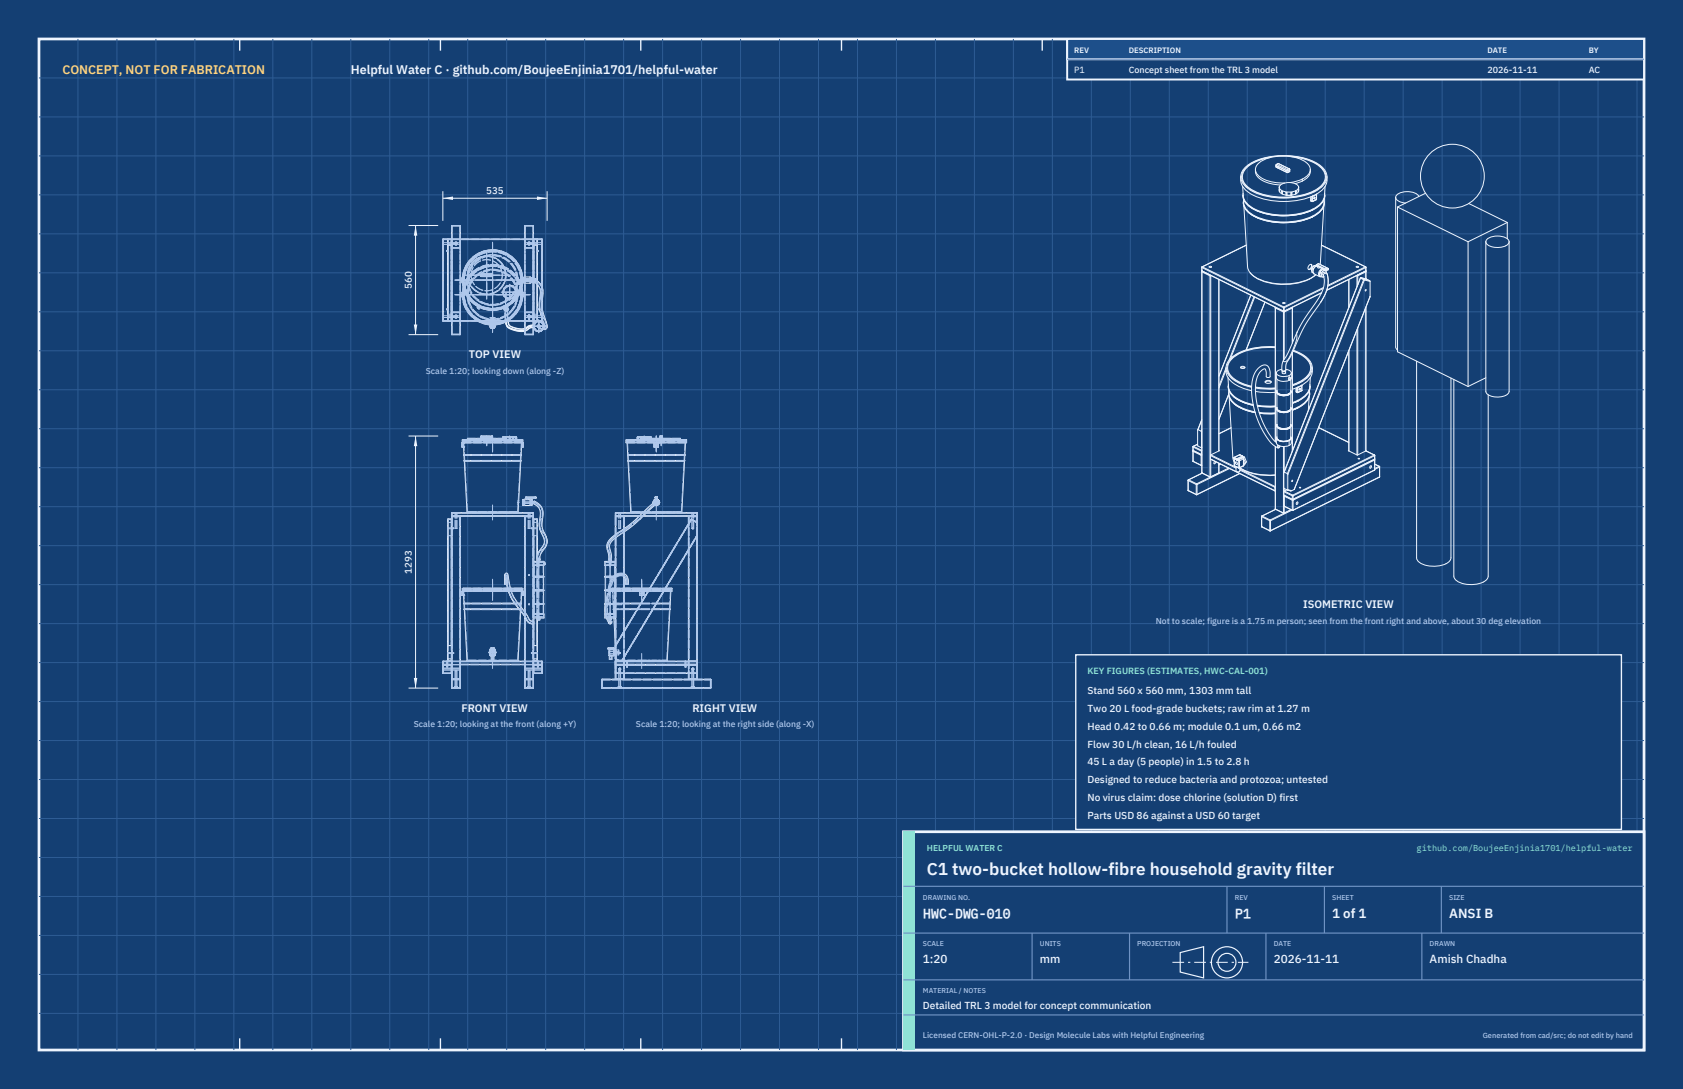
[picture p250: page 1]
CONCEPT, NOT FOR FABRICATION; Helpful Water C · github.com/BoujeeEnjinia1701/helpful-water; FRONT VIEW; TOP VIEW; RIGHT VIEW; ISOMETRIC VIEW; REV; DESCRIPTION; DATE; Concept sheet from the TRL 3 model; HELPFUL WATER C; github.com/BoujeeEnjinia1701/helpful-water; DRAWING NO. HWC-DWG-010; REV P1; SHEET 1 of 1; SIZE ANSI B; SCALE 1:20; UNITS mm; PROJECTION; DRAWN Amish Chadha; Licensed CERN-OHL-P-2.0 · Design Molecule Labs with Helpful Engineering; Generated from cad/src; do not edit by hand

Scale 1:20; looking down (along -Z)

Not to scale; figure is a 1.75 m person; seen from the front right and above, about 30 deg elevation

KEY FIGURES (ESTIMATES, HWC-CAL-001)
Stand 560 x 560 mm, 1303 mm tall
Two 20 L food-grade buckets; raw rim at 1.27 m
Head 0.42 to 0.66 m; module 0.1 um, 0.66 m2
Flow 30 L/h clean, 16 L/h fouled
45 L a day (5 people) in 1.5 to 2.8 h
Designed to reduce bacteria and protozoa; untested
No virus claim: dose chlorine (solution D) first
Parts USD 86 against a USD 60 target

Scale 1:20; looking at the front (along +Y)

Scale 1:20; looking at the right side (along -X)

C1 two-bucket hollow-fibre household gravity filter

MATERIAL / NOTES
Detailed TRL 3 model for concept communication
