BoujeeEnjinia1701/helpful-water/solutions/D-virus-add-on/media/concept-blueprint.pdf

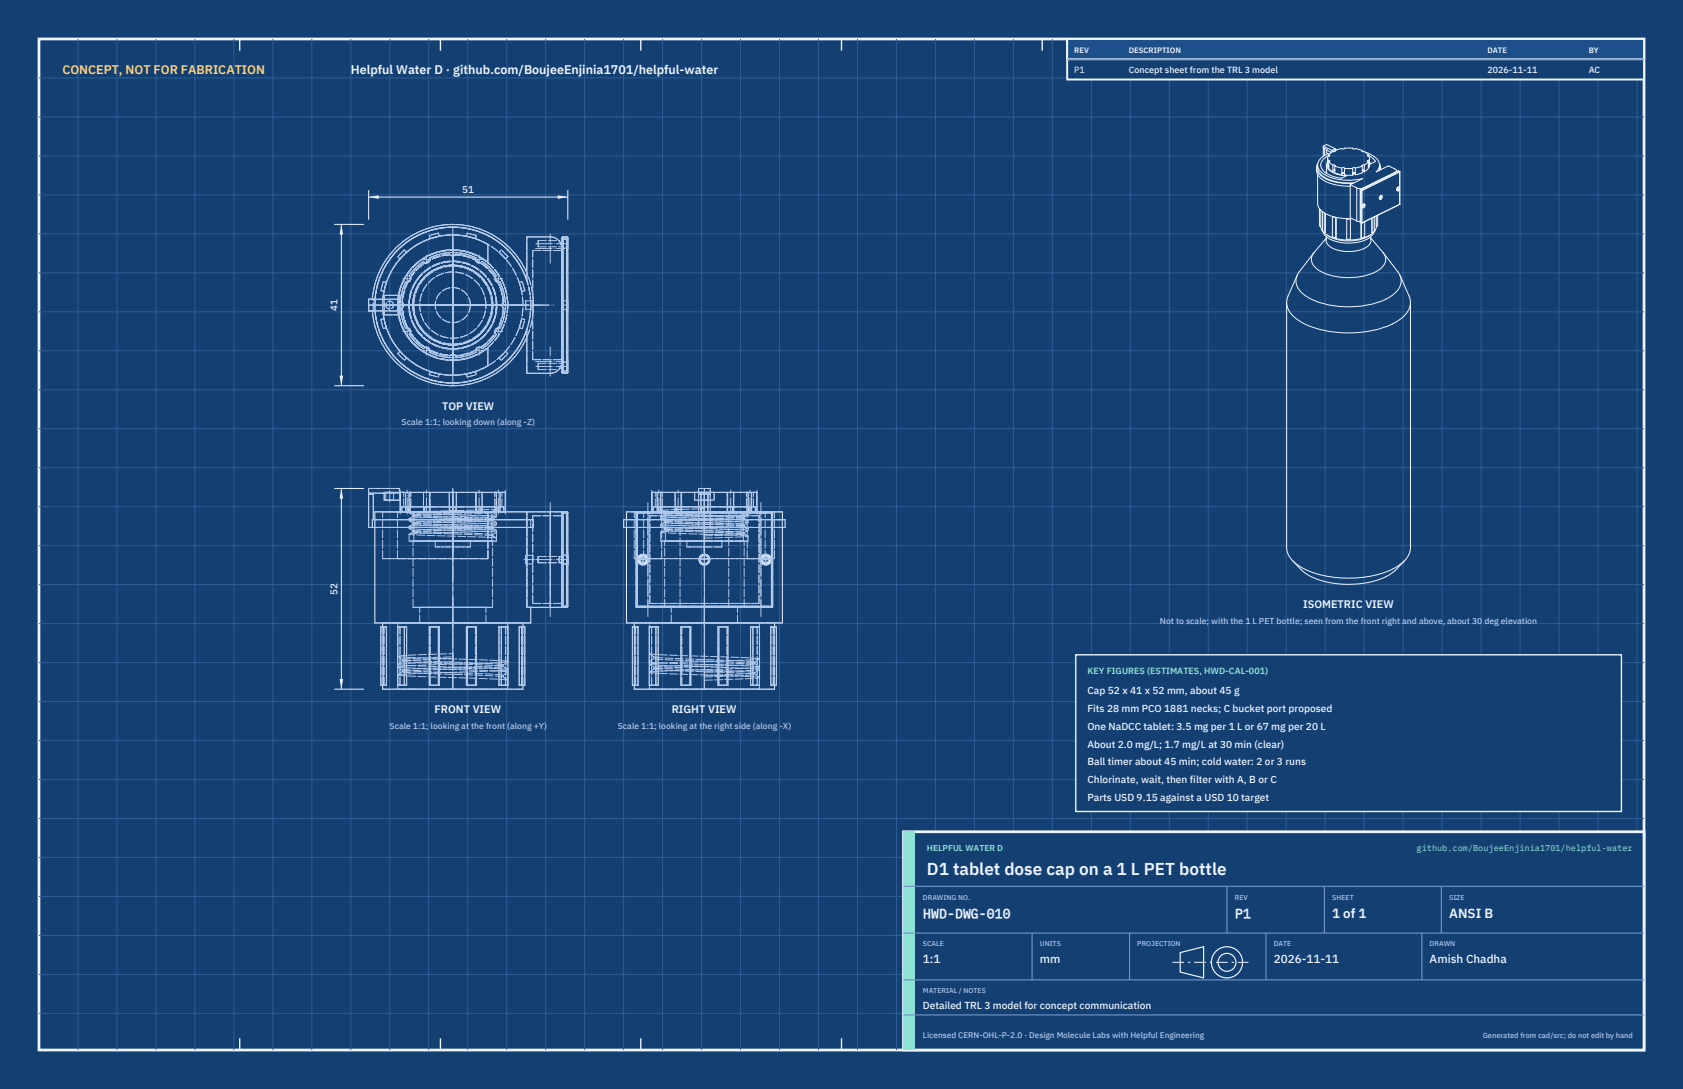
[picture p251: page 1]
CONCEPT, NOT FOR FABRICATION; Helpful Water D · github.com/BoujeeEnjinia1701/helpful-water; FRONT VIEW; TOP VIEW; RIGHT VIEW; ISOMETRIC VIEW; REV; DESCRIPTION; DATE; Concept sheet from the TRL 3 model; HELPFUL WATER D; github.com/BoujeeEnjinia1701/helpful-water; DRAWING NO. HWD-DWG-010; REV P1; SHEET 1 of 1; SIZE ANSI B; SCALE 1:1; UNITS mm; PROJECTION; DRAWN Amish Chadha; Licensed CERN-OHL-P-2.0 · Design Molecule Labs with Helpful Engineering; Generated from cad/src; do not edit by hand

Scale 1:1; looking down (along -Z)

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

KEY FIGURES (ESTIMATES, HWD-CAL-001)
Cap 52 x 41 x 52 mm, about 45 g
Fits 28 mm PCO 1881 necks; C bucket port proposed
One NaDCC tablet: 3.5 mg per 1 L or 67 mg per 20 L
About 2.0 mg/L; 1.7 mg/L at 30 min (clear)
Ball timer about 45 min; cold water: 2 or 3 runs
Chlorinate, wait, then filter with A, B or C
Parts USD 9.15 against a USD 10 target

Scale 1:1; looking at the front (along +Y)

Scale 1:1; looking at the right side (along -X)

D1 tablet dose cap on a 1 L PET bottle

MATERIAL / NOTES
Detailed TRL 3 model for concept communication
