BoujeeEnjinia1701/helpful-water/solutions/A-straw/cad/drawings/HWA-DWG-103.pdf

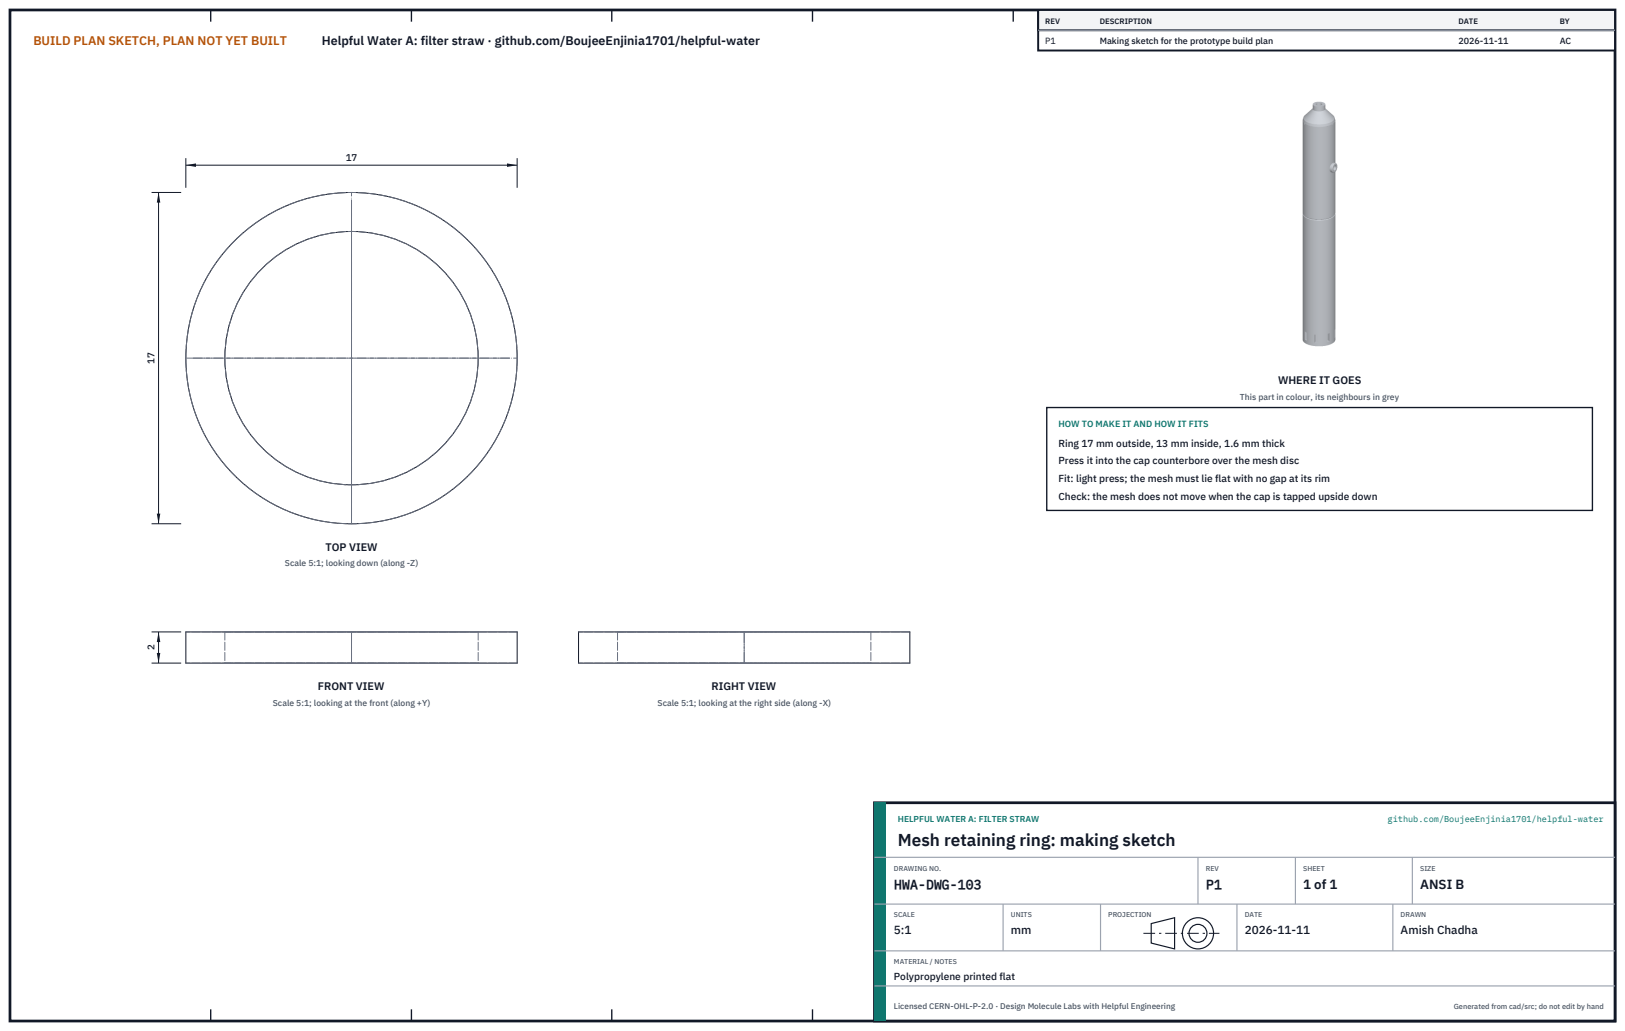
[picture p252: page 1]
BUILD PLAN SKETCH, PLAN NOT YET BUILT; Helpful Water A: filter straw · github.com/BoujeeEnjinia1701/helpful-water; FRONT VIEW; TOP VIEW; RIGHT VIEW; REV; DESCRIPTION; DATE; Making sketch for the prototype build plan; HELPFUL WATER A: FILTER STRAW; github.com/BoujeeEnjinia1701/helpful-water; DRAWING NO. HWA-DWG-103; REV P1; SHEET 1 of 1; SIZE ANSI B; SCALE 5:1; UNITS mm; PROJECTION; DRAWN Amish Chadha; Licensed CERN-OHL-P-2.0 · Design Molecule Labs with Helpful Engineering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

WHERE IT GOES

This part in colour, its neighbours in grey

HOW TO MAKE IT AND HOW IT FITS
Ring 17 mm outside, 13 mm inside, 1.6 mm thick
Press it into the cap counterbore over the mesh disc
Fit: light press; the mesh must lie flat with no gap at its rim
Check: the mesh does not move when the cap is tapped upside down

Scale 5:1; looking down (along -Z)

Scale 5:1; looking at the front (along +Y)

Scale 5:1; looking at the right side (along -X)

Mesh retaining ring: making sketch

MATERIAL / NOTES
Polypropylene printed flat
