BoujeeEnjinia1701/helpful-water/solutions/A-straw/cad/drawings/HWA-DWG-104.pdf

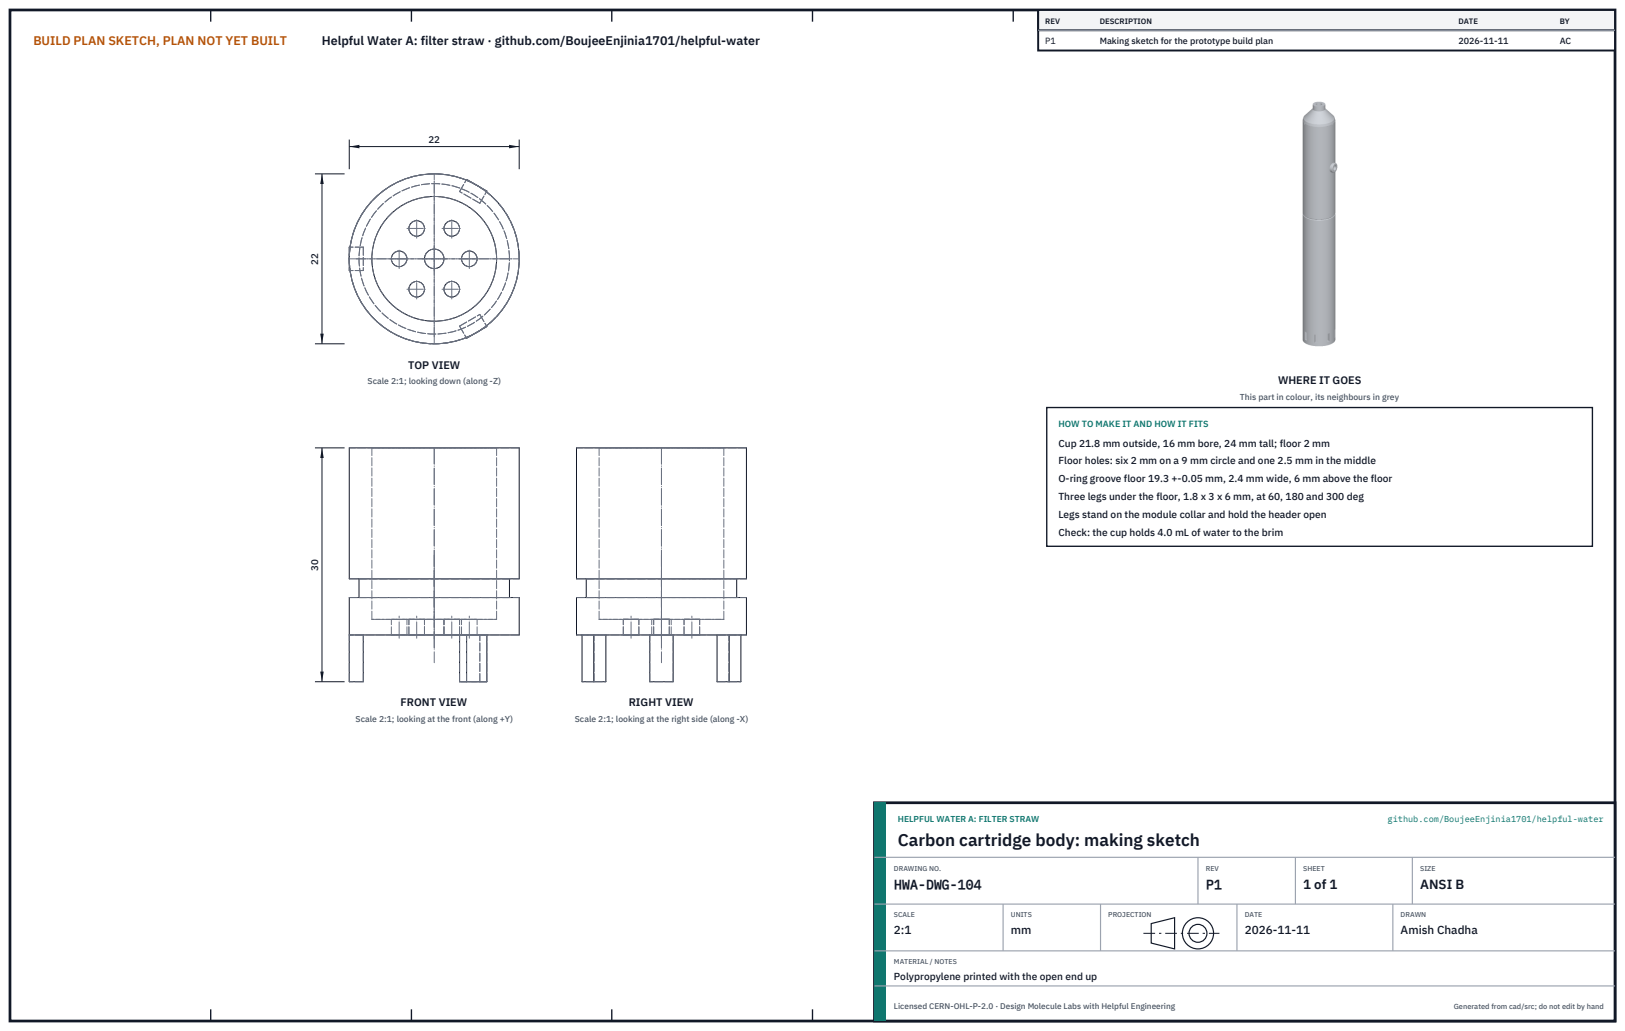
[picture p253: page 1]
BUILD PLAN SKETCH, PLAN NOT YET BUILT; Helpful Water A: filter straw · github.com/BoujeeEnjinia1701/helpful-water; FRONT VIEW; TOP VIEW; RIGHT VIEW; REV; DESCRIPTION; DATE; Making sketch for the prototype build plan; HELPFUL WATER A: FILTER STRAW; github.com/BoujeeEnjinia1701/helpful-water; DRAWING NO. HWA-DWG-104; REV P1; SHEET 1 of 1; SIZE ANSI B; SCALE 2:1; UNITS mm; PROJECTION; DRAWN Amish Chadha; Licensed CERN-OHL-P-2.0 · Design Molecule Labs with Helpful Engineering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

Scale 2:1; looking down (along -Z)

WHERE IT GOES

This part in colour, its neighbours in grey

HOW TO MAKE IT AND HOW IT FITS
Cup 21.8 mm outside, 16 mm bore, 24 mm tall; floor 2 mm
Floor holes: six 2 mm on a 9 mm circle and one 2.5 mm in the middle
O-ring groove floor 19.3 +-0.05 mm, 2.4 mm wide, 6 mm above the floor
Three legs under the floor, 1.8 x 3 x 6 mm, at 60, 180 and 300 deg
Legs stand on the module collar and hold the header open
Check: the cup holds 4.0 mL of water to the brim

Scale 2:1; looking at the front (along +Y)

Scale 2:1; looking at the right side (along -X)

Carbon cartridge body: making sketch

MATERIAL / NOTES
Polypropylene printed with the open end up
