BoujeeEnjinia1701/helpful-water/solutions/A-straw/cad/drawings/HWA-DWG-106.pdf

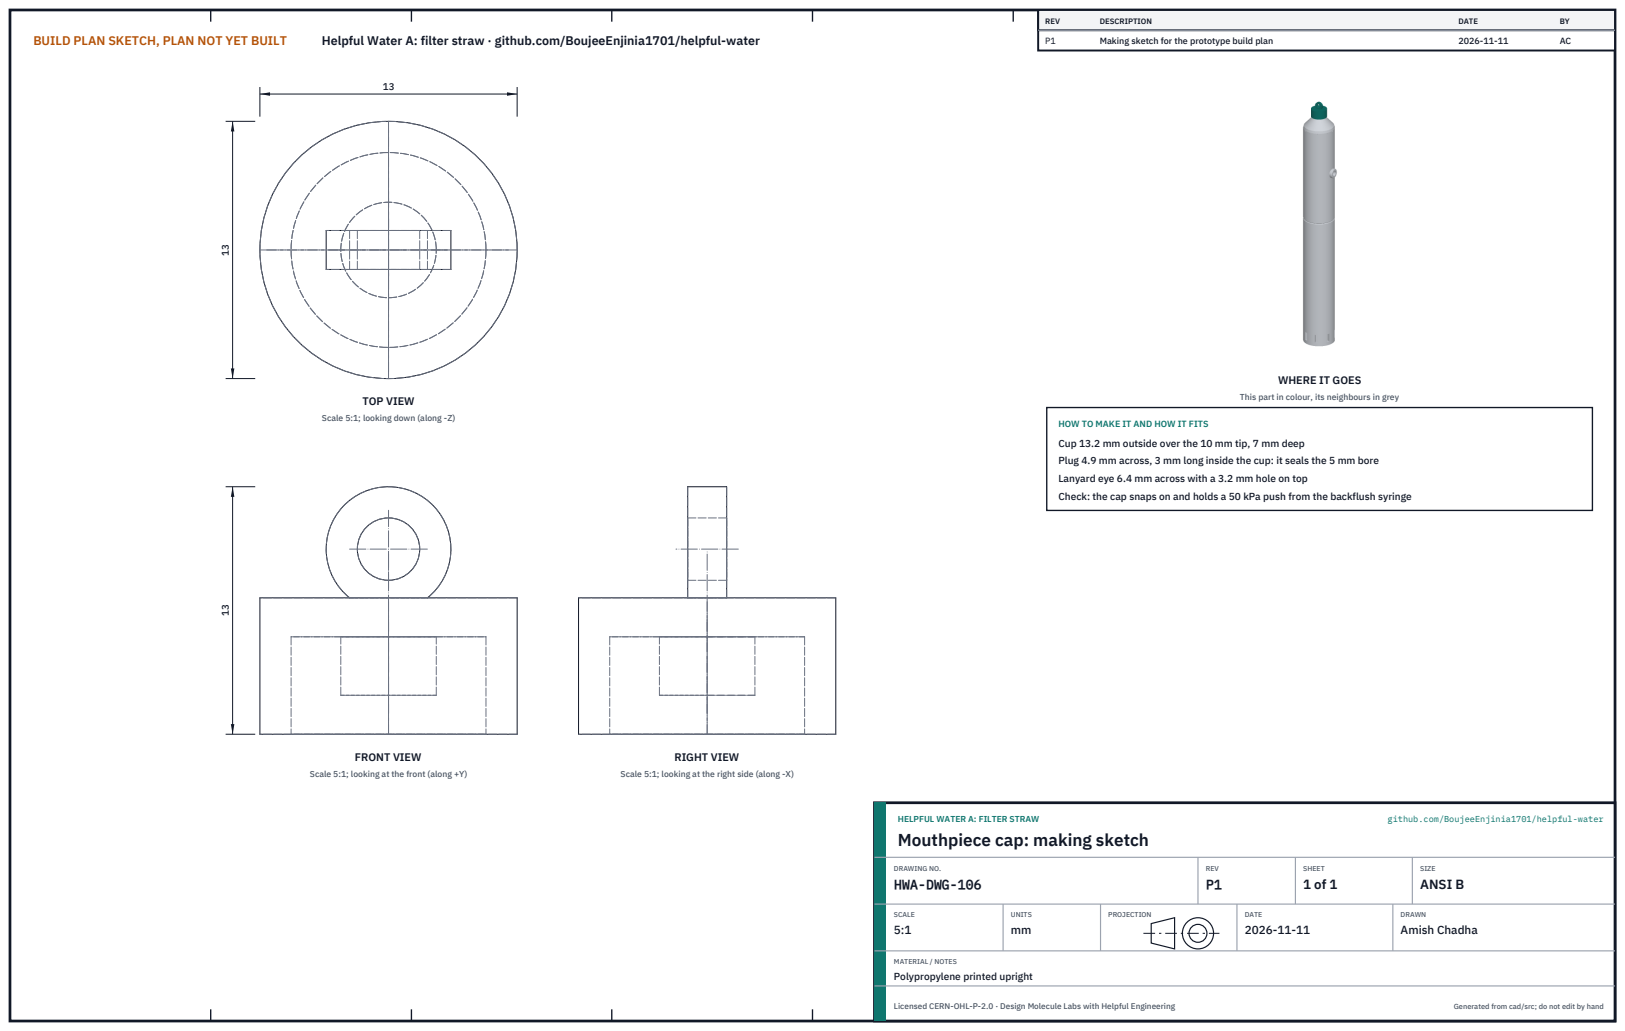
[picture p254: page 1]
BUILD PLAN SKETCH, PLAN NOT YET BUILT; Helpful Water A: filter straw · github.com/BoujeeEnjinia1701/helpful-water; FRONT VIEW; TOP VIEW; RIGHT VIEW; REV; DESCRIPTION; DATE; Making sketch for the prototype build plan; HELPFUL WATER A: FILTER STRAW; github.com/BoujeeEnjinia1701/helpful-water; DRAWING NO. HWA-DWG-106; REV P1; SHEET 1 of 1; SIZE ANSI B; SCALE 5:1; UNITS mm; PROJECTION; DRAWN Amish Chadha; Licensed CERN-OHL-P-2.0 · Design Molecule Labs with Helpful Engineering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

WHERE IT GOES

This part in colour, its neighbours in grey

Scale 5:1; looking down (along -Z)

HOW TO MAKE IT AND HOW IT FITS
Cup 13.2 mm outside over the 10 mm tip, 7 mm deep
Plug 4.9 mm across, 3 mm long inside the cup: it seals the 5 mm bore
Lanyard eye 6.4 mm across with a 3.2 mm hole on top
Check: the cap snaps on and holds a 50 kPa push from the backflush syringe

Scale 5:1; looking at the front (along +Y)

Scale 5:1; looking at the right side (along -X)

Mouthpiece cap: making sketch

MATERIAL / NOTES
Polypropylene printed upright
