BoujeeEnjinia1701/helpful-water/solutions/A-straw/cad/drawings/HWA-DWG-107.pdf

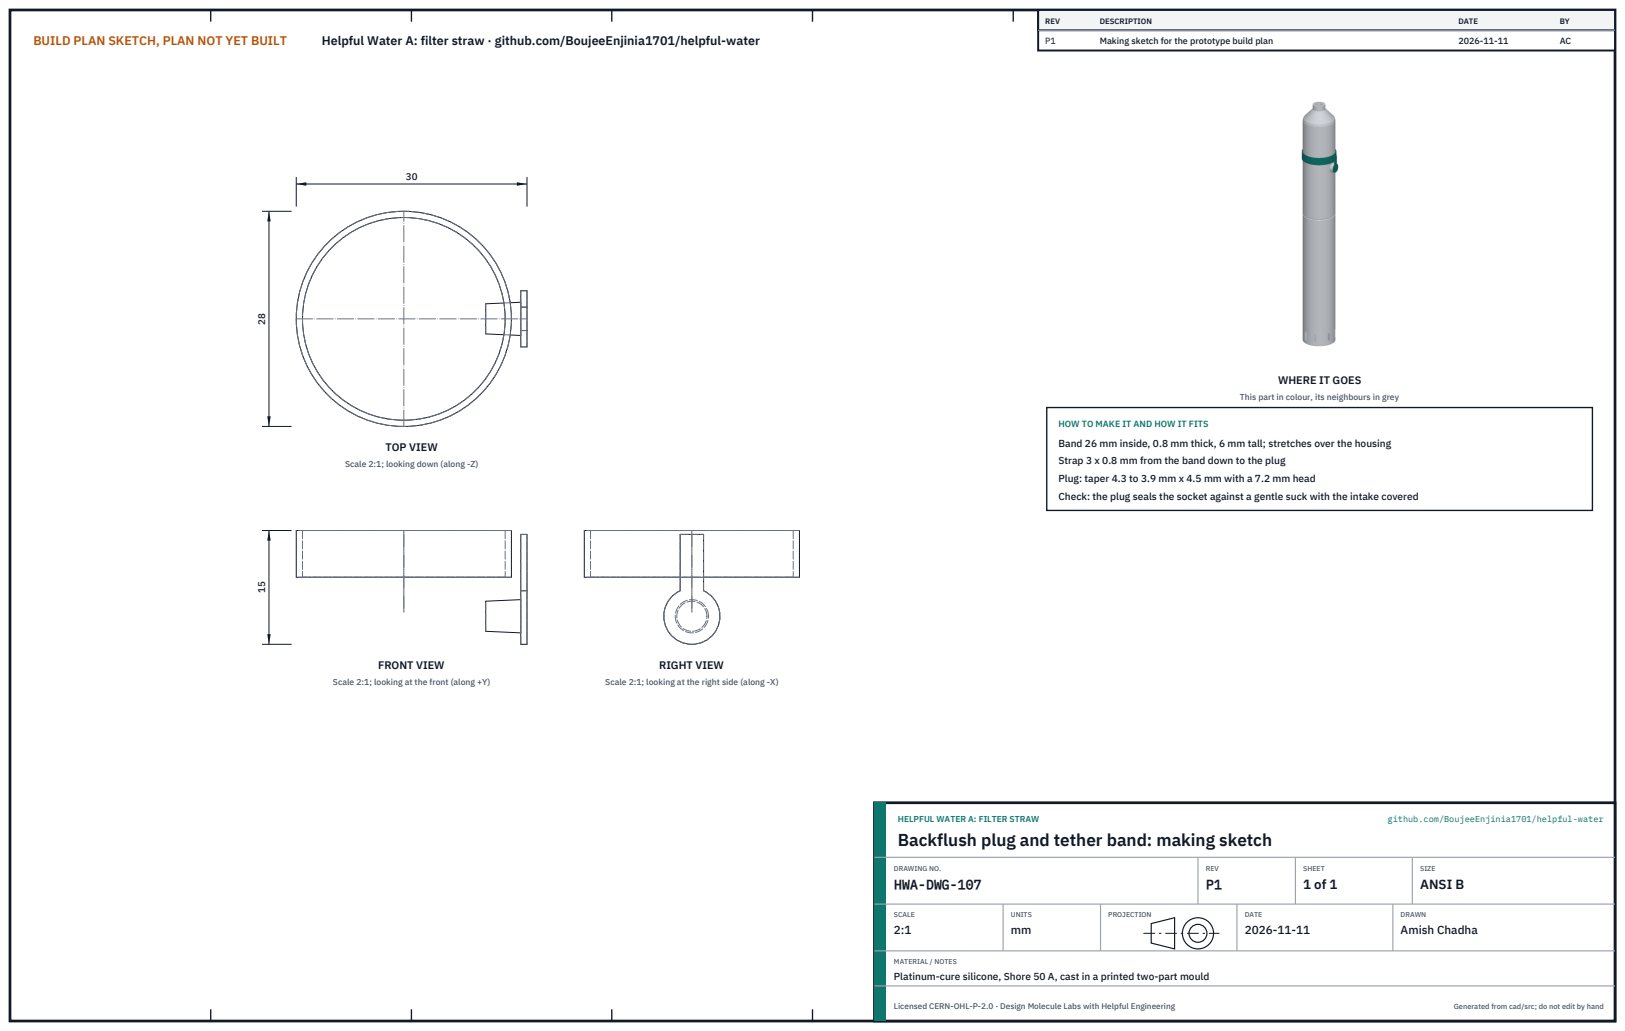
[picture p255: page 1]
BUILD PLAN SKETCH, PLAN NOT YET BUILT; Helpful Water A: filter straw · github.com/BoujeeEnjinia1701/helpful-water; FRONT VIEW; TOP VIEW; RIGHT VIEW; REV; DESCRIPTION; DATE; Making sketch for the prototype build plan; HELPFUL WATER A: FILTER STRAW; github.com/BoujeeEnjinia1701/helpful-water; DRAWING NO. HWA-DWG-107; REV P1; SHEET 1 of 1; SIZE ANSI B; SCALE 2:1; UNITS mm; PROJECTION; DRAWN Amish Chadha; Licensed CERN-OHL-P-2.0 · Design Molecule Labs with Helpful Engineering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

WHERE IT GOES

This part in colour, its neighbours in grey

HOW TO MAKE IT AND HOW IT FITS
Band 26 mm inside, 0.8 mm thick, 6 mm tall; stretches over the housing
Strap 3 x 0.8 mm from the band down to the plug
Plug: taper 4.3 to 3.9 mm x 4.5 mm with a 7.2 mm head
Check: the plug seals the socket against a gentle suck with the intake covered

Scale 2:1; looking down (along -Z)

Scale 2:1; looking at the front (along +Y)

Scale 2:1; looking at the right side (along -X)

Backflush plug and tether band: making sketch

MATERIAL / NOTES
Platinum-cure silicone, Shore 50 A, cast in a printed two-part mould
