BoujeeEnjinia1701/helpful-water/solutions/A-straw/cad/drawings/HWA-DWG-108.pdf

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

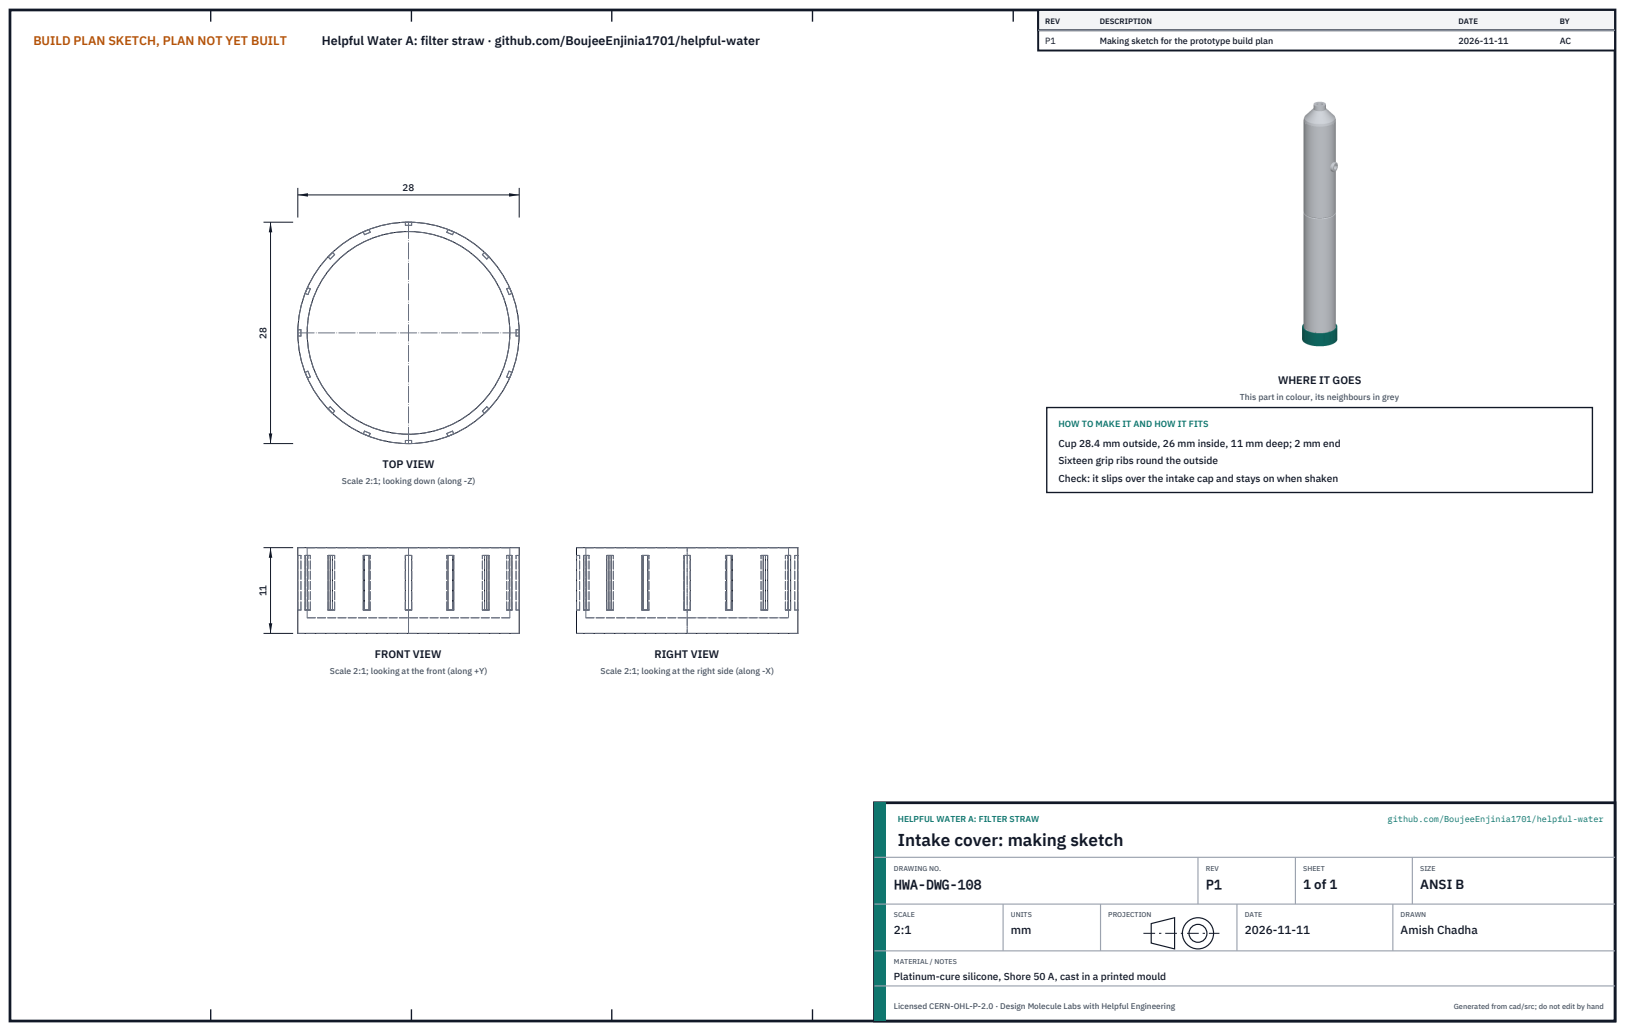
[picture p256: page 1]
FRONT VIEW; TOP VIEW; RIGHT VIEW; REV; DESCRIPTION; DATE; Making sketch for the prototype build plan; HELPFUL WATER A: FILTER STRAW; github.com/BoujeeEnjinia1701/helpful-water; DRAWING NO. HWA-DWG-108; REV P1; SHEET 1 of 1; SIZE ANSI B; SCALE 2:1; UNITS mm; PROJECTION; DRAWN Amish Chadha; Licensed CERN-OHL-P-2.0 · Design Molecule Labs with Helpful Engineering; Generated from cad/src; do not edit by hand

WHERE IT GOES

This part in colour, its neighbours in grey

HOW TO MAKE IT AND HOW IT FITS
Cup 28.4 mm outside, 26 mm inside, 11 mm deep; 2 mm end
Sixteen grip ribs round the outside
Check: it slips over the intake cap and stays on when shaken

Scale 2:1; looking down (along -Z)

Scale 2:1; looking at the front (along +Y)

Scale 2:1; looking at the right side (along -X)

Intake cover: making sketch

MATERIAL / NOTES
Platinum-cure silicone, Shore 50 A, cast in a printed mould
