BoujeeEnjinia1701/helpful-water/solutions/B-bottle-cartridge/cad/drawings/HWB-DWG-102.pdf

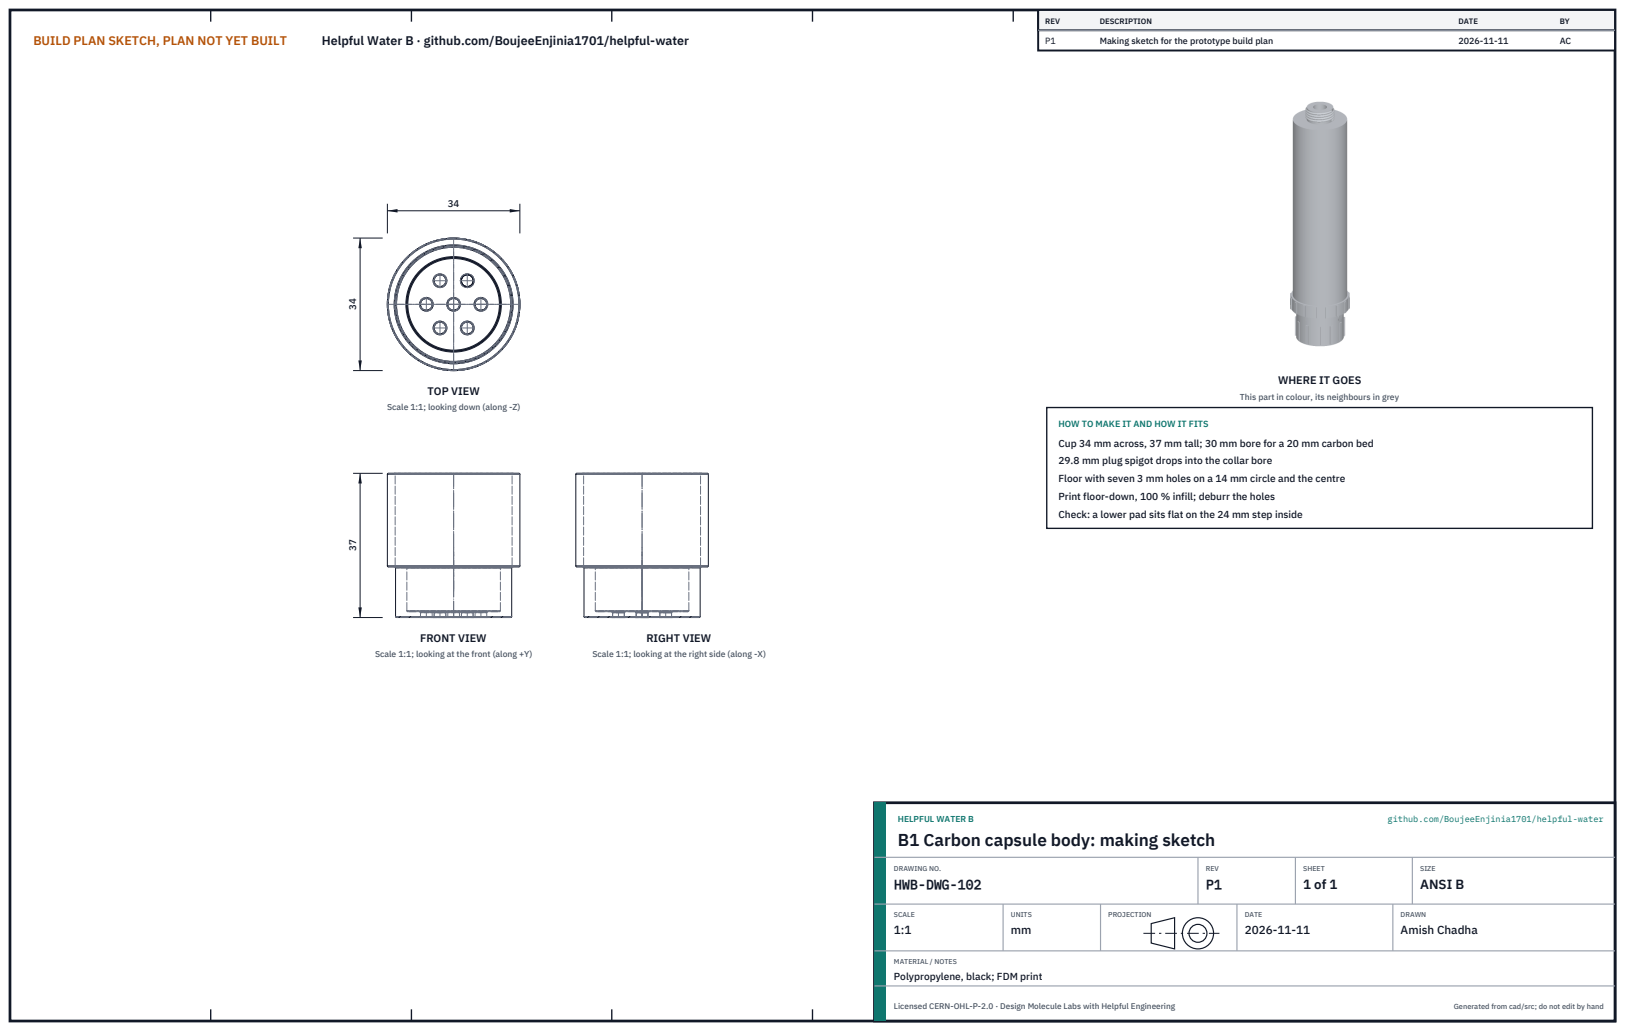
[picture p257: page 1]
BUILD PLAN SKETCH, PLAN NOT YET BUILT; Helpful Water B · github.com/BoujeeEnjinia1701/helpful-water; FRONT VIEW; TOP VIEW; RIGHT VIEW; REV; DESCRIPTION; DATE; Making sketch for the prototype build plan; HELPFUL WATER B; github.com/BoujeeEnjinia1701/helpful-water; DRAWING NO. HWB-DWG-102; REV P1; SHEET 1 of 1; SIZE ANSI B; SCALE 1:1; UNITS mm; PROJECTION; DRAWN Amish Chadha; Licensed CERN-OHL-P-2.0 · Design Molecule Labs with Helpful Engineering; Generated from cad/src; do not edit by hand

WHERE IT GOES

This part in colour, its neighbours in grey

Scale 1:1; looking down (along -Z)

HOW TO MAKE IT AND HOW IT FITS
Cup 34 mm across, 37 mm tall; 30 mm bore for a 20 mm carbon bed
29.8 mm plug spigot drops into the collar bore
Floor with seven 3 mm holes on a 14 mm circle and the centre
Print floor-down, 100 % infill; deburr the holes
Check: a lower pad sits flat on the 24 mm step inside

Scale 1:1; looking at the front (along +Y)

Scale 1:1; looking at the right side (along -X)

B1 Carbon capsule body: making sketch

MATERIAL / NOTES
Polypropylene, black; FDM print
