BoujeeEnjinia1701/helpful-water/solutions/B-bottle-cartridge/cad/drawings/HWB-DWG-103.pdf

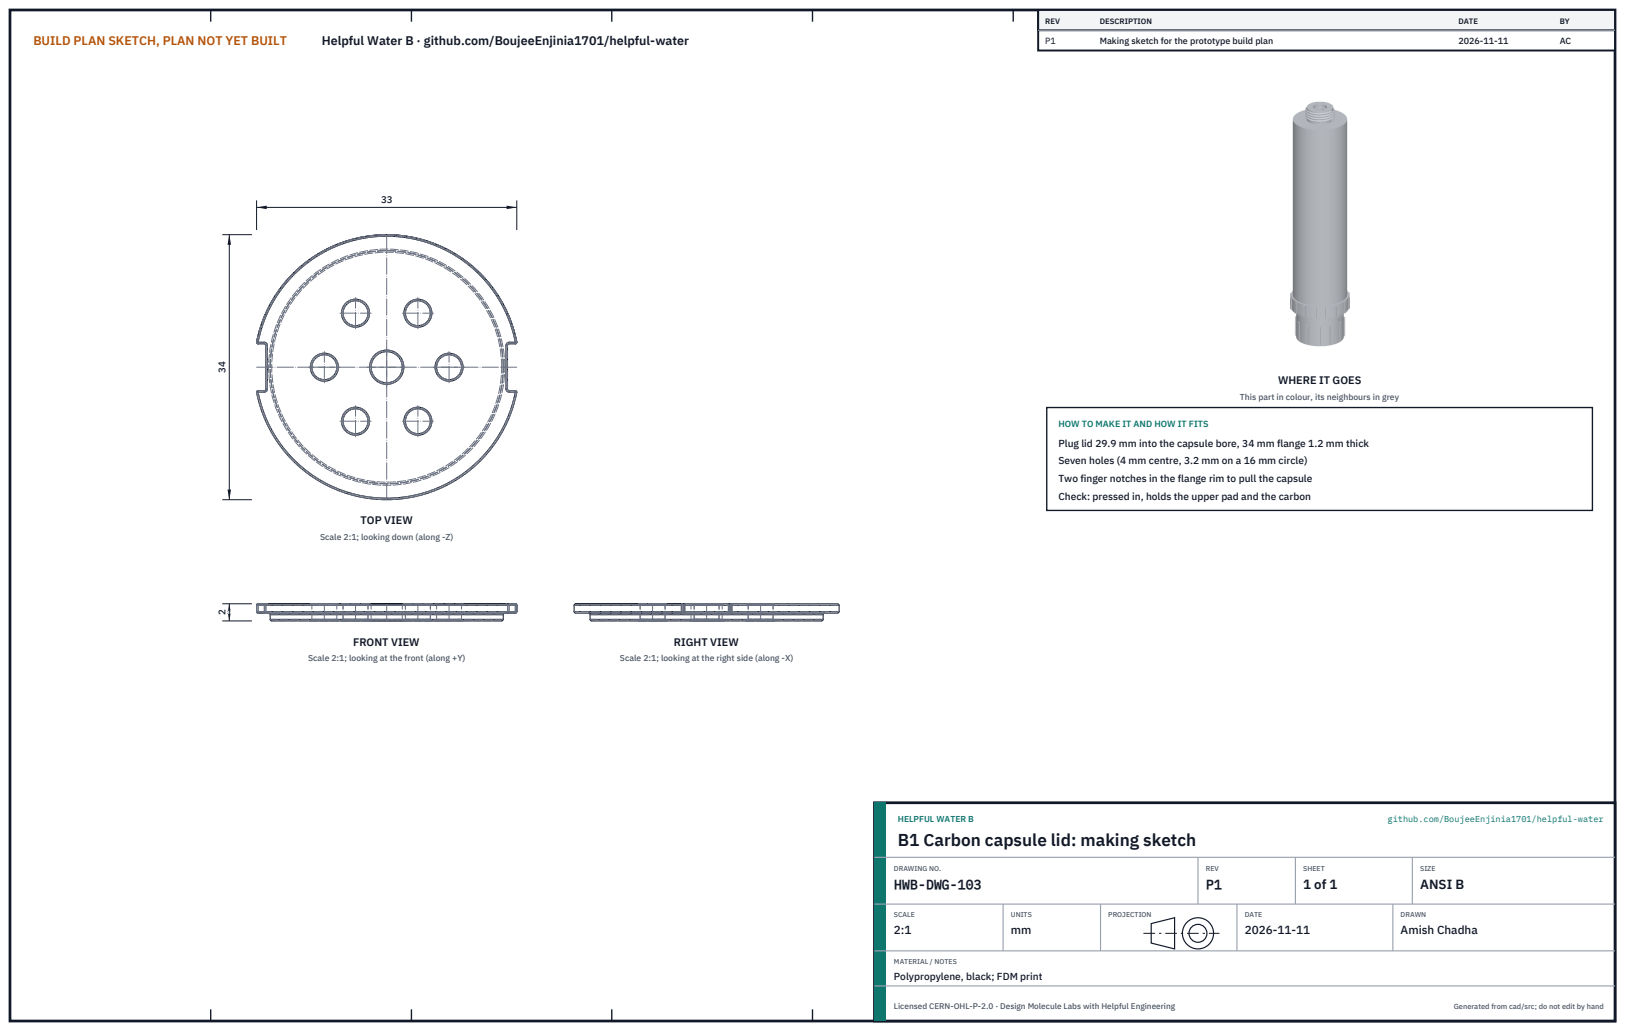
[picture p258: page 1]
BUILD PLAN SKETCH, PLAN NOT YET BUILT; Helpful Water B · github.com/BoujeeEnjinia1701/helpful-water; FRONT VIEW; TOP VIEW; RIGHT VIEW; REV; DESCRIPTION; DATE; Making sketch for the prototype build plan; HELPFUL WATER B; github.com/BoujeeEnjinia1701/helpful-water; DRAWING NO. HWB-DWG-103; REV P1; SHEET 1 of 1; SIZE ANSI B; SCALE 2:1; UNITS mm; PROJECTION; DRAWN Amish Chadha; Licensed CERN-OHL-P-2.0 · Design Molecule Labs with Helpful Engineering; Generated from cad/src; do not edit by hand

WHERE IT GOES

This part in colour, its neighbours in grey

HOW TO MAKE IT AND HOW IT FITS
Plug lid 29.9 mm into the capsule bore, 34 mm flange 1.2 mm thick
Seven holes (4 mm centre, 3.2 mm on a 16 mm circle)
Two finger notches in the flange rim to pull the capsule
Check: pressed in, holds the upper pad and the carbon

Scale 2:1; looking down (along -Z)

Scale 2:1; looking at the front (along +Y)

Scale 2:1; looking at the right side (along -X)

B1 Carbon capsule lid: making sketch

MATERIAL / NOTES
Polypropylene, black; FDM print
