BoujeeEnjinia1701/helpful-water/solutions/B-bottle-cartridge/cad/drawings/HWB-DWG-105.pdf

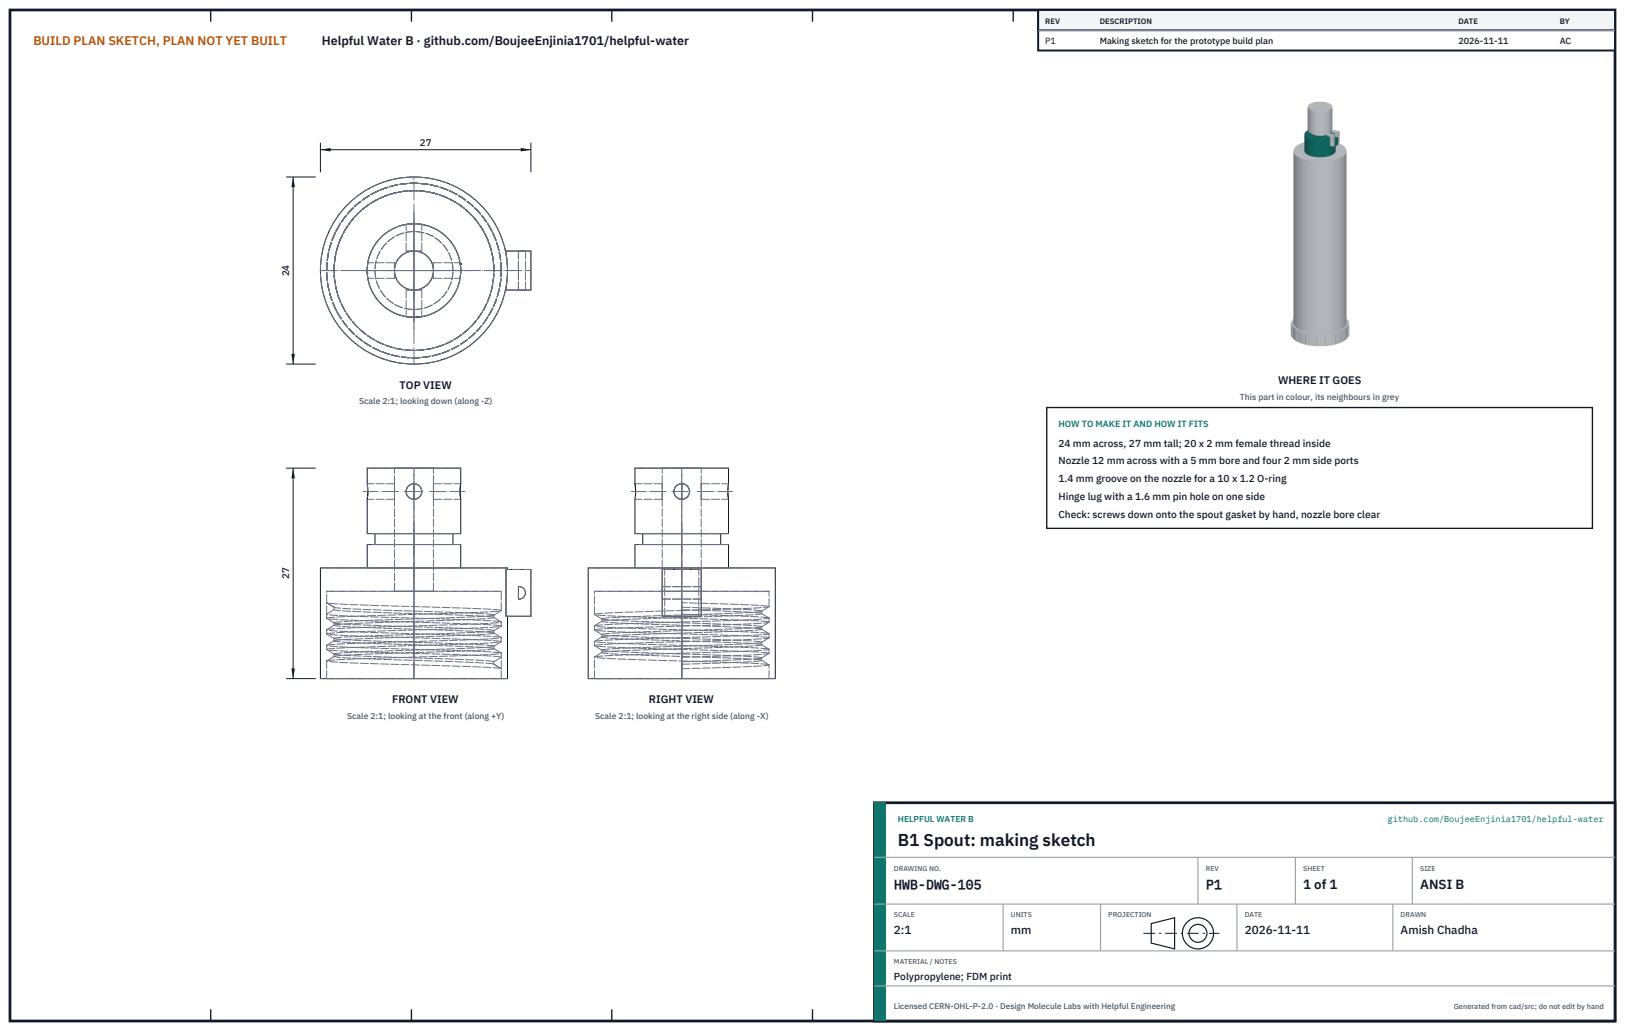
[picture p259: page 1]
BUILD PLAN SKETCH, PLAN NOT YET BUILT; Helpful Water B · github.com/BoujeeEnjinia1701/helpful-water; FRONT VIEW; TOP VIEW; RIGHT VIEW; REV; DESCRIPTION; DATE; Making sketch for the prototype build plan; HELPFUL WATER B; github.com/BoujeeEnjinia1701/helpful-water; DRAWING NO. HWB-DWG-105; REV P1; SHEET 1 of 1; SIZE ANSI B; SCALE 2:1; UNITS mm; PROJECTION; DRAWN Amish Chadha; Licensed CERN-OHL-P-2.0 · Design Molecule Labs with Helpful Engineering; Generated from cad/src; do not edit by hand

WHERE IT GOES

This part in colour, its neighbours in grey

Scale 2:1; looking down (along -Z)

HOW TO MAKE IT AND HOW IT FITS
24 mm across, 27 mm tall; 20 x 2 mm female thread inside
Nozzle 12 mm across with a 5 mm bore and four 2 mm side ports
1.4 mm groove on the nozzle for a 10 x 1.2 O-ring
Hinge lug with a 1.6 mm pin hole on one side
Check: screws down onto the spout gasket by hand, nozzle bore clear

Scale 2:1; looking at the front (along +Y)

Scale 2:1; looking at the right side (along -X)

B1 Spout: making sketch

MATERIAL / NOTES
Polypropylene; FDM print
