BoujeeEnjinia1701/helpful-water/solutions/B-bottle-cartridge/cad/drawings/HWB-DWG-106.pdf

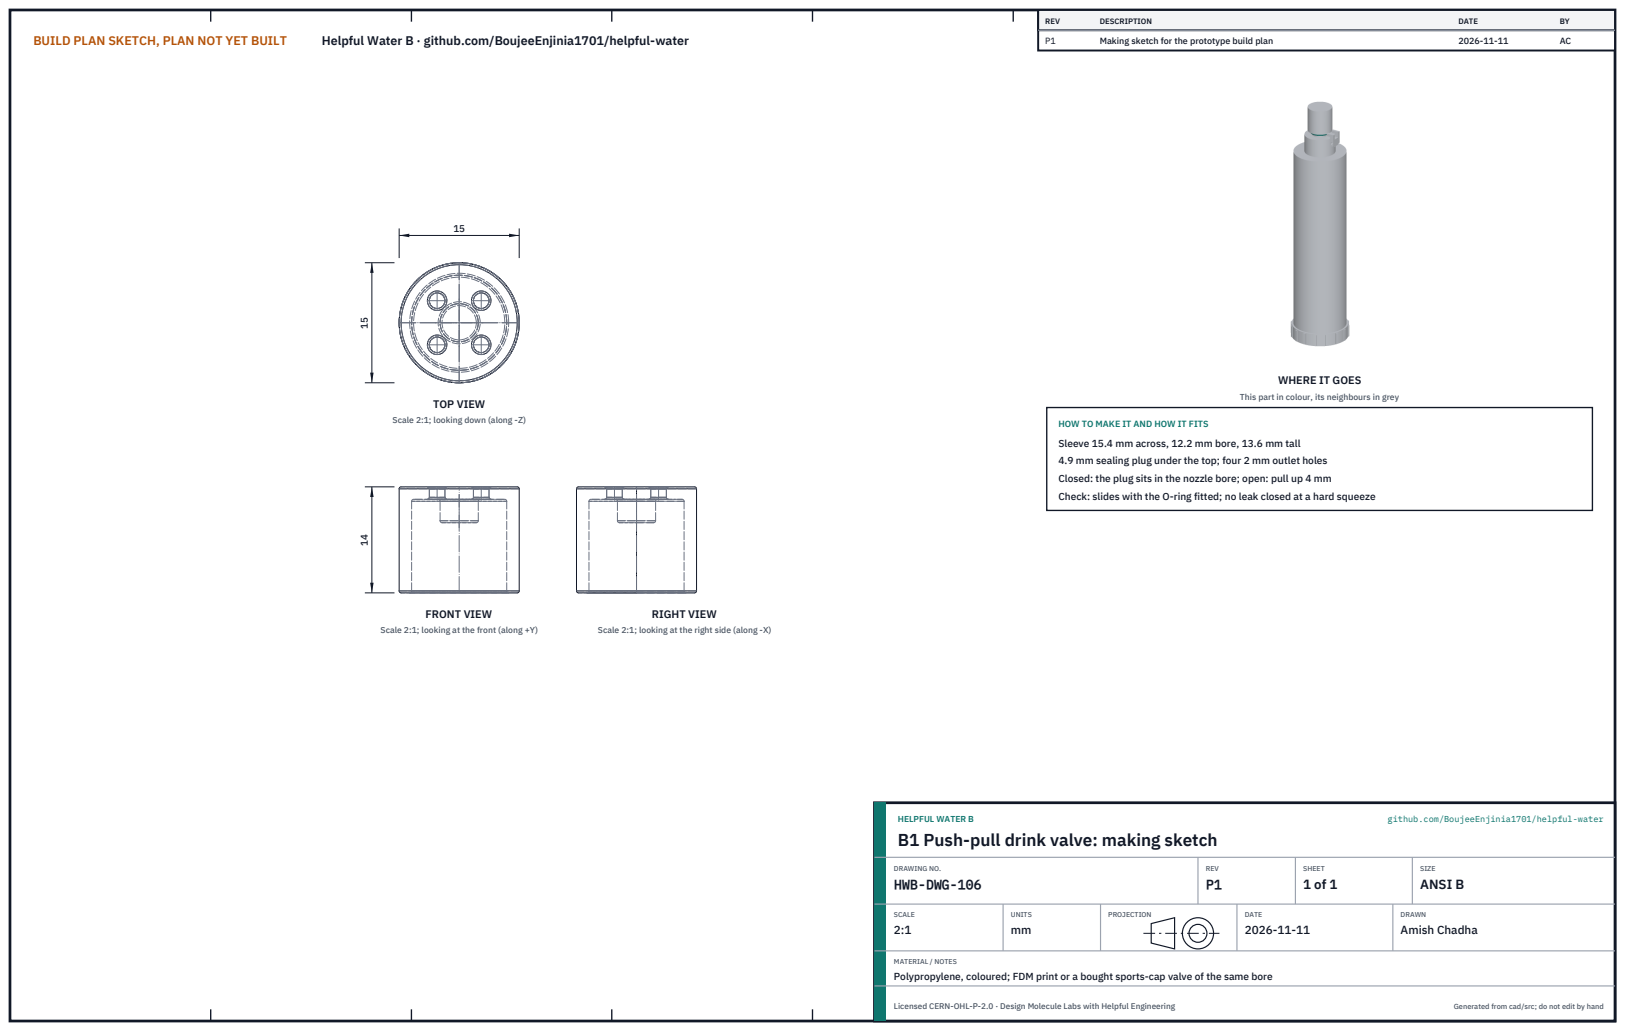
[picture p260: page 1]
BUILD PLAN SKETCH, PLAN NOT YET BUILT; Helpful Water B · github.com/BoujeeEnjinia1701/helpful-water; FRONT VIEW; TOP VIEW; RIGHT VIEW; REV; DESCRIPTION; DATE; Making sketch for the prototype build plan; HELPFUL WATER B; github.com/BoujeeEnjinia1701/helpful-water; DRAWING NO. HWB-DWG-106; REV P1; SHEET 1 of 1; SIZE ANSI B; SCALE 2:1; UNITS mm; PROJECTION; DRAWN Amish Chadha; Licensed CERN-OHL-P-2.0 · Design Molecule Labs with Helpful Engineering; Generated from cad/src; do not edit by hand

WHERE IT GOES

This part in colour, its neighbours in grey

Scale 2:1; looking down (along -Z)

HOW TO MAKE IT AND HOW IT FITS
Sleeve 15.4 mm across, 12.2 mm bore, 13.6 mm tall
4.9 mm sealing plug under the top; four 2 mm outlet holes
Closed: the plug sits in the nozzle bore; open: pull up 4 mm
Check: slides with the O-ring fitted; no leak closed at a hard squeeze

Scale 2:1; looking at the front (along +Y)

Scale 2:1; looking at the right side (along -X)

B1 Push-pull drink valve: making sketch

MATERIAL / NOTES
Polypropylene, coloured; FDM print or a bought sports-cap valve of the same bore
