BoujeeEnjinia1701/helpful-water/solutions/B-bottle-cartridge/cad/drawings/HWB-DWG-107.pdf

BUILD PLAN SKETCH, PLAN NOT YET BUILT Helpful Water B · github.com/BoujeeEnjinia1701/helpful-water

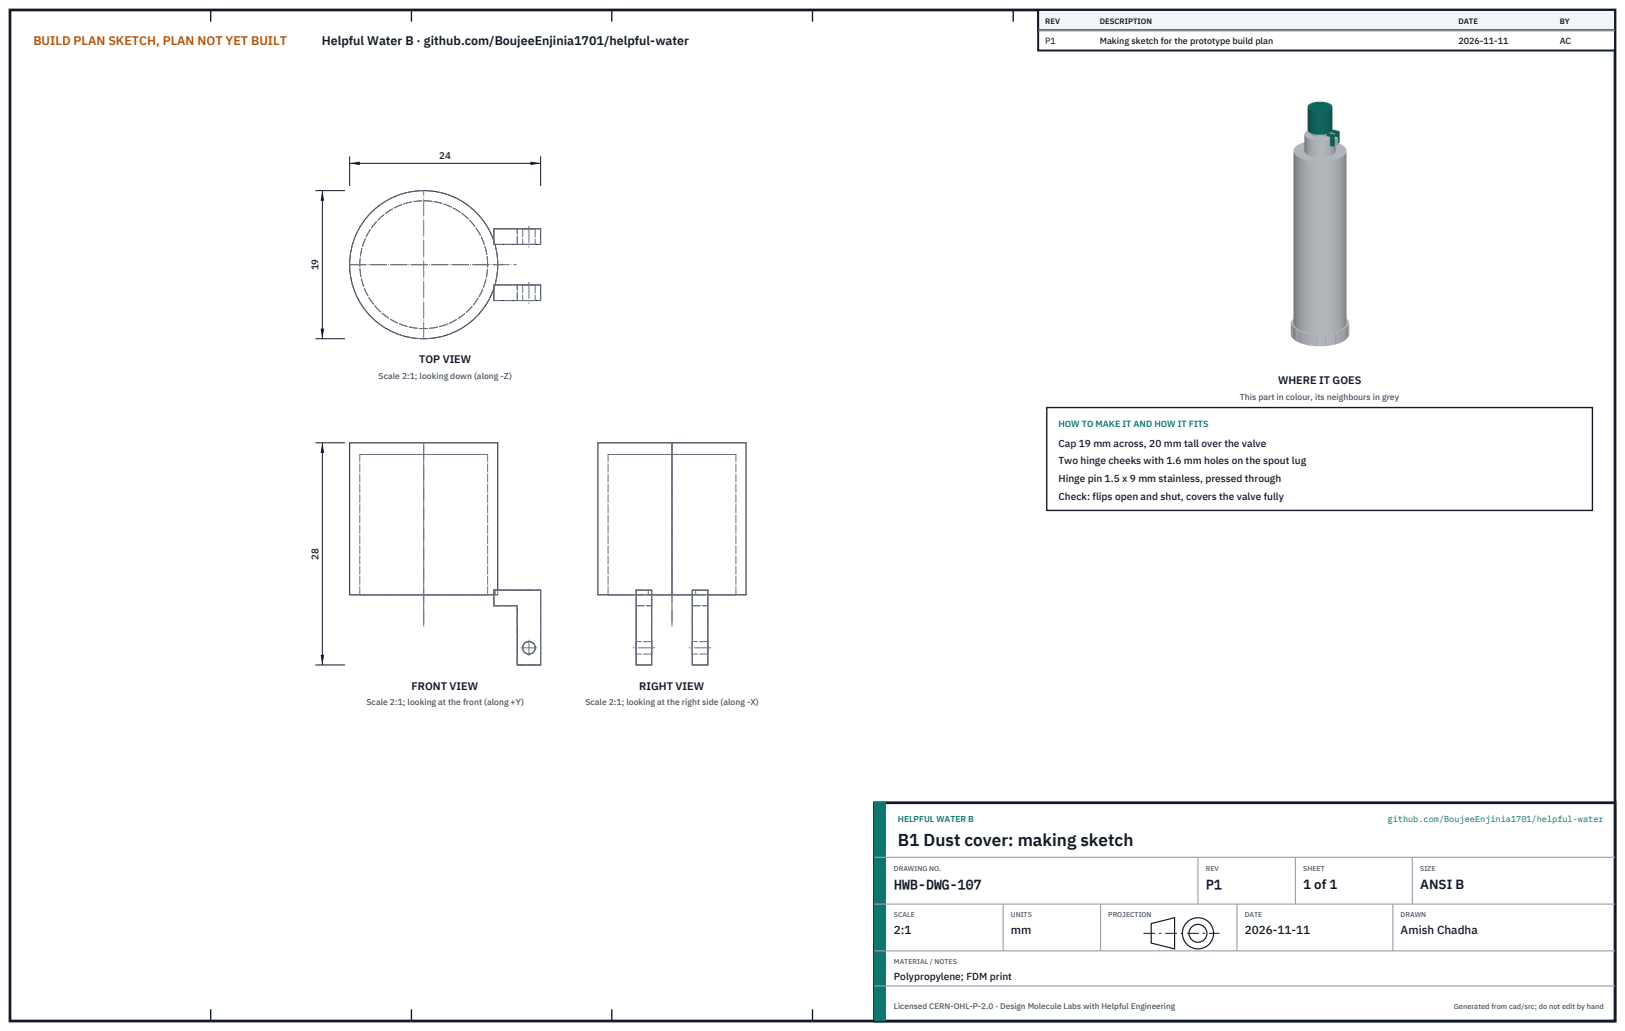
[picture p261: page 1]
FRONT VIEW; TOP VIEW; RIGHT VIEW; REV; DESCRIPTION; DATE; Making sketch for the prototype build plan; HELPFUL WATER B; github.com/BoujeeEnjinia1701/helpful-water; DRAWING NO. HWB-DWG-107; REV P1; SHEET 1 of 1; SIZE ANSI B; SCALE 2:1; UNITS mm; PROJECTION; DRAWN Amish Chadha; Licensed CERN-OHL-P-2.0 · Design Molecule Labs with Helpful Engineering; Generated from cad/src; do not edit by hand

Scale 2:1; looking down (along -Z)

WHERE IT GOES

This part in colour, its neighbours in grey

HOW TO MAKE IT AND HOW IT FITS
Cap 19 mm across, 20 mm tall over the valve
Two hinge cheeks with 1.6 mm holes on the spout lug
Hinge pin 1.5 x 9 mm stainless, pressed through
Check: flips open and shut, covers the valve fully

Scale 2:1; looking at the front (along +Y)

Scale 2:1; looking at the right side (along -X)

B1 Dust cover: making sketch

MATERIAL / NOTES
Polypropylene; FDM print
