BoujeeEnjinia1701/helpful-water/solutions/C-gravity/cad/drawings/HWC-DWG-102.pdf

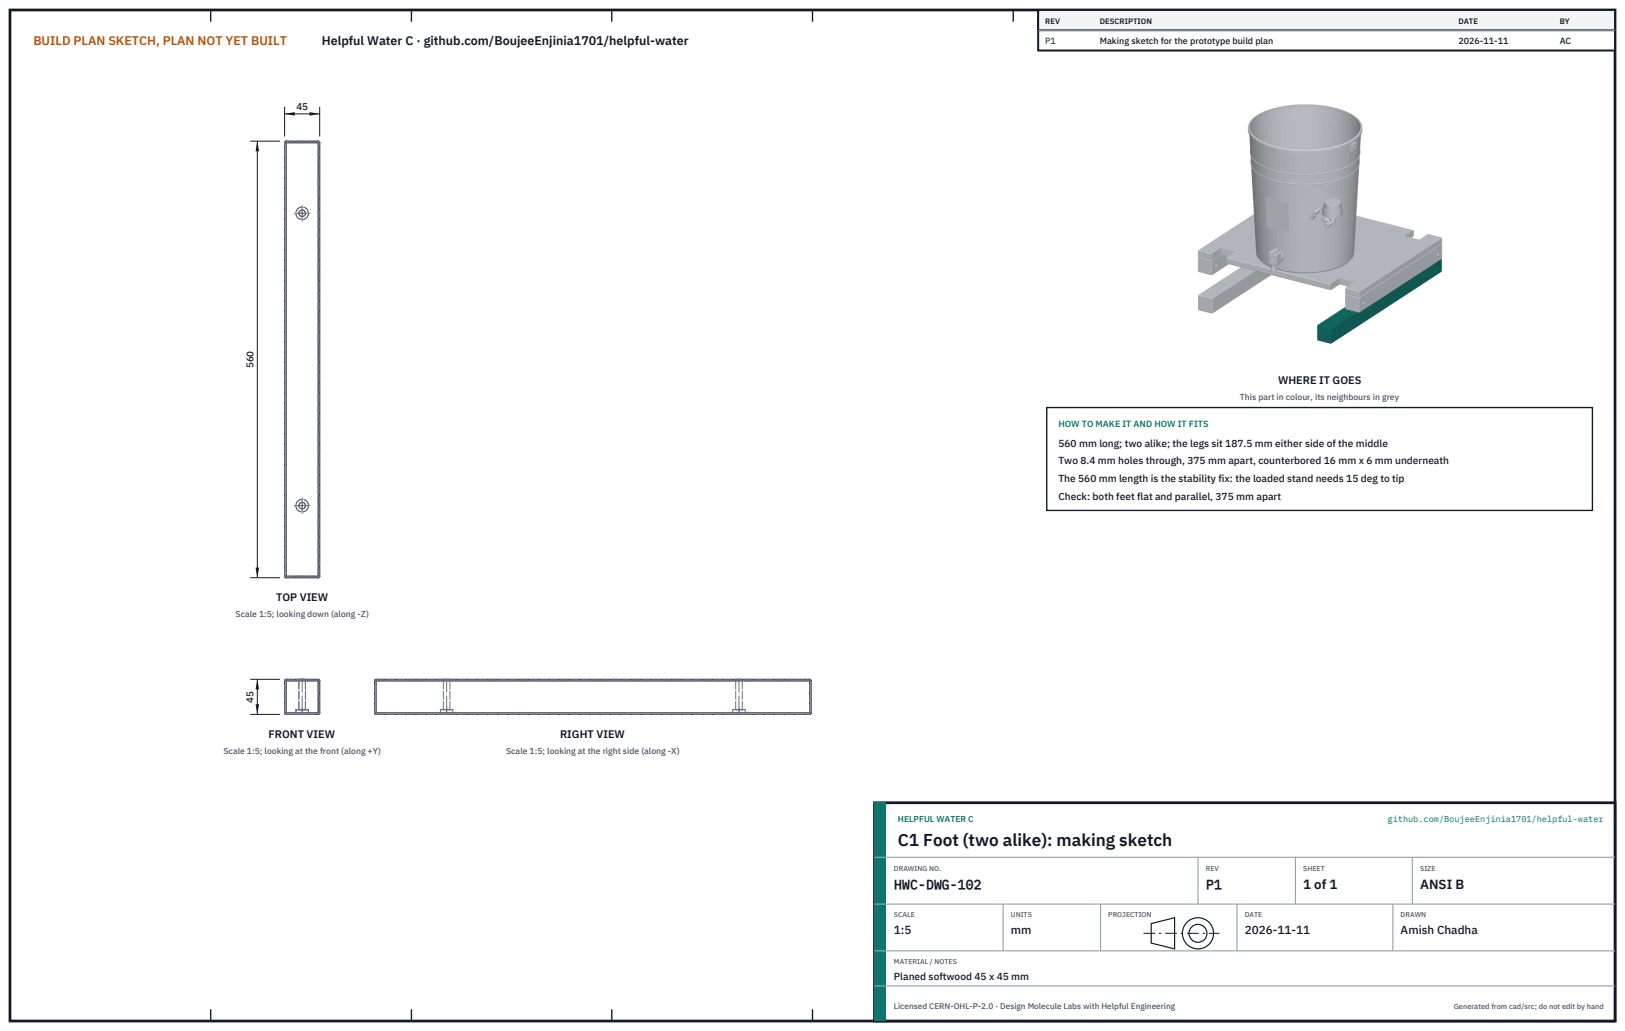
[picture p262: page 1]
BUILD PLAN SKETCH, PLAN NOT YET BUILT; Helpful Water C · github.com/BoujeeEnjinia1701/helpful-water; FRONT VIEW; TOP VIEW; RIGHT VIEW; REV; DESCRIPTION; DATE; Making sketch for the prototype build plan; HELPFUL WATER C; github.com/BoujeeEnjinia1701/helpful-water; DRAWING NO. HWC-DWG-102; REV P1; SHEET 1 of 1; SIZE ANSI B; SCALE 1:5; UNITS mm; PROJECTION; DRAWN Amish Chadha; Licensed CERN-OHL-P-2.0 · Design Molecule Labs with Helpful Engineering; Generated from cad/src; do not edit by hand

WHERE IT GOES

This part in colour, its neighbours in grey

HOW TO MAKE IT AND HOW IT FITS
560 mm long; two alike; the legs sit 187.5 mm either side of the middle
Two 8.4 mm holes through, 375 mm apart, counterbored 16 mm x 6 mm underneath
The 560 mm length is the stability fix: the loaded stand needs 15 deg to tip
Check: both feet flat and parallel, 375 mm apart

Scale 1:5; looking down (along -Z)

Scale 1:5; looking at the front (along +Y)

Scale 1:5; looking at the right side (along -X)

C1 Foot (two alike): making sketch

MATERIAL / NOTES
Planed softwood 45 x 45 mm
