BoujeeEnjinia1701/helpful-water/solutions/C-gravity/cad/drawings/HWC-DWG-103.pdf

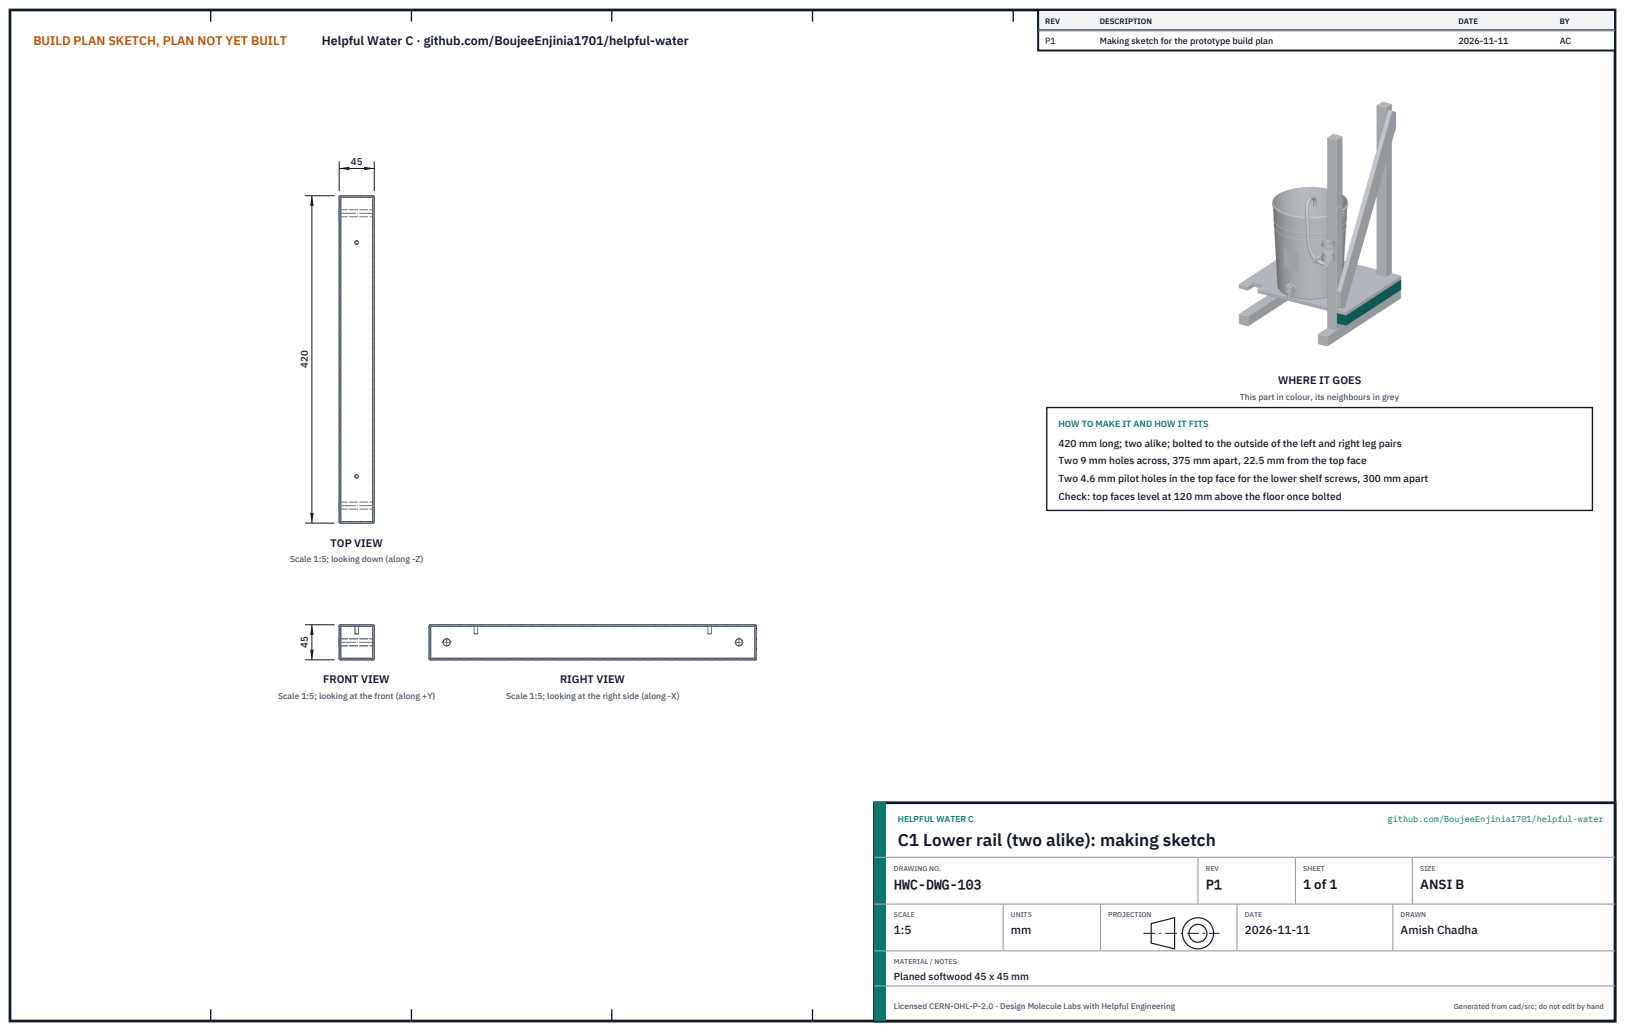
[picture p263: page 1]
BUILD PLAN SKETCH, PLAN NOT YET BUILT; Helpful Water C · github.com/BoujeeEnjinia1701/helpful-water; FRONT VIEW; TOP VIEW; RIGHT VIEW; REV; DESCRIPTION; DATE; Making sketch for the prototype build plan; HELPFUL WATER C; github.com/BoujeeEnjinia1701/helpful-water; DRAWING NO. HWC-DWG-103; REV P1; SHEET 1 of 1; SIZE ANSI B; SCALE 1:5; UNITS mm; PROJECTION; DRAWN Amish Chadha; Licensed CERN-OHL-P-2.0 · Design Molecule Labs with Helpful Engineering; Generated from cad/src; do not edit by hand

WHERE IT GOES

This part in colour, its neighbours in grey

HOW TO MAKE IT AND HOW IT FITS
420 mm long; two alike; bolted to the outside of the left and right leg pairs
Two 9 mm holes across, 375 mm apart, 22.5 mm from the top face
Two 4.6 mm pilot holes in the top face for the lower shelf screws, 300 mm apart
Check: top faces level at 120 mm above the floor once bolted

Scale 1:5; looking down (along -Z)

Scale 1:5; looking at the front (along +Y)

Scale 1:5; looking at the right side (along -X)

C1 Lower rail (two alike): making sketch

MATERIAL / NOTES
Planed softwood 45 x 45 mm
