BoujeeEnjinia1701/helpful-water/solutions/C-gravity/cad/drawings/HWC-DWG-104.pdf

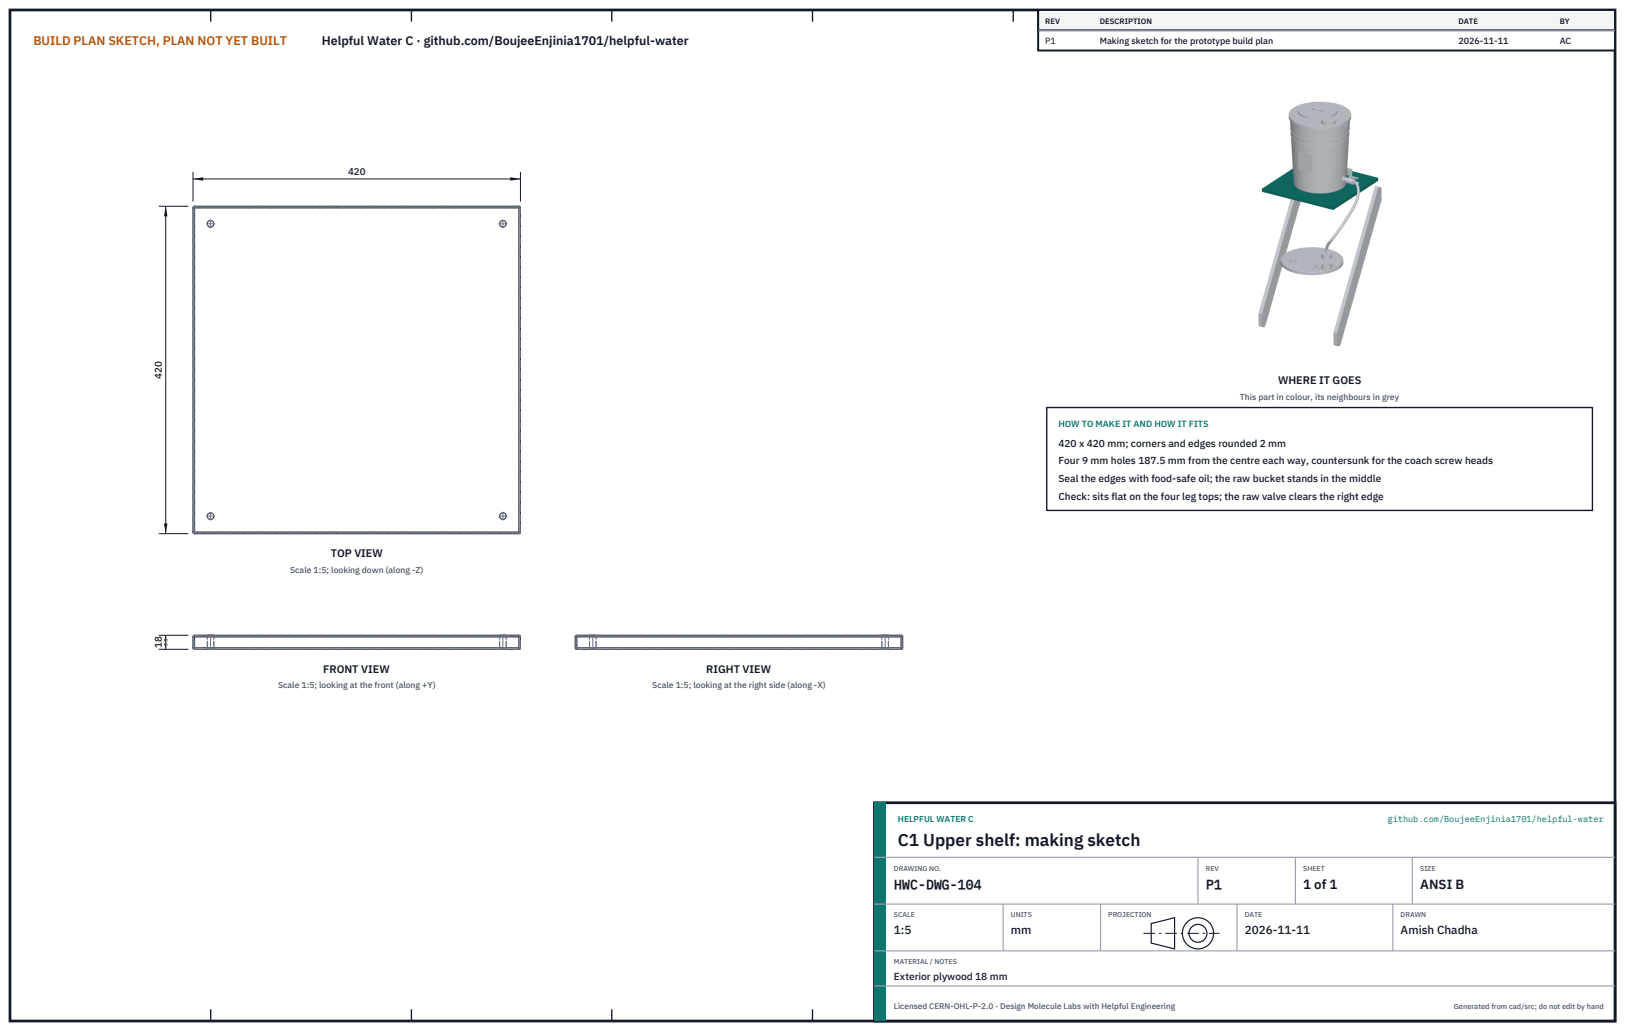
[picture p264: page 1]
BUILD PLAN SKETCH, PLAN NOT YET BUILT; Helpful Water C · github.com/BoujeeEnjinia1701/helpful-water; FRONT VIEW; TOP VIEW; RIGHT VIEW; REV; DESCRIPTION; DATE; Making sketch for the prototype build plan; HELPFUL WATER C; github.com/BoujeeEnjinia1701/helpful-water; DRAWING NO. HWC-DWG-104; REV P1; SHEET 1 of 1; SIZE ANSI B; SCALE 1:5; UNITS mm; PROJECTION; DRAWN Amish Chadha; Licensed CERN-OHL-P-2.0 · Design Molecule Labs with Helpful Engineering; Generated from cad/src; do not edit by hand

WHERE IT GOES

This part in colour, its neighbours in grey

HOW TO MAKE IT AND HOW IT FITS
420 x 420 mm; corners and edges rounded 2 mm
Four 9 mm holes 187.5 mm from the centre each way, countersunk for the coach screw heads
Seal the edges with food-safe oil; the raw bucket stands in the middle
Check: sits flat on the four leg tops; the raw valve clears the right edge

Scale 1:5; looking down (along -Z)

Scale 1:5; looking at the front (along +Y)

Scale 1:5; looking at the right side (along -X)

C1 Upper shelf: making sketch

MATERIAL / NOTES
Exterior plywood 18 mm
