BoujeeEnjinia1701/helpful-water/solutions/C-gravity/cad/drawings/HWC-DWG-105.pdf

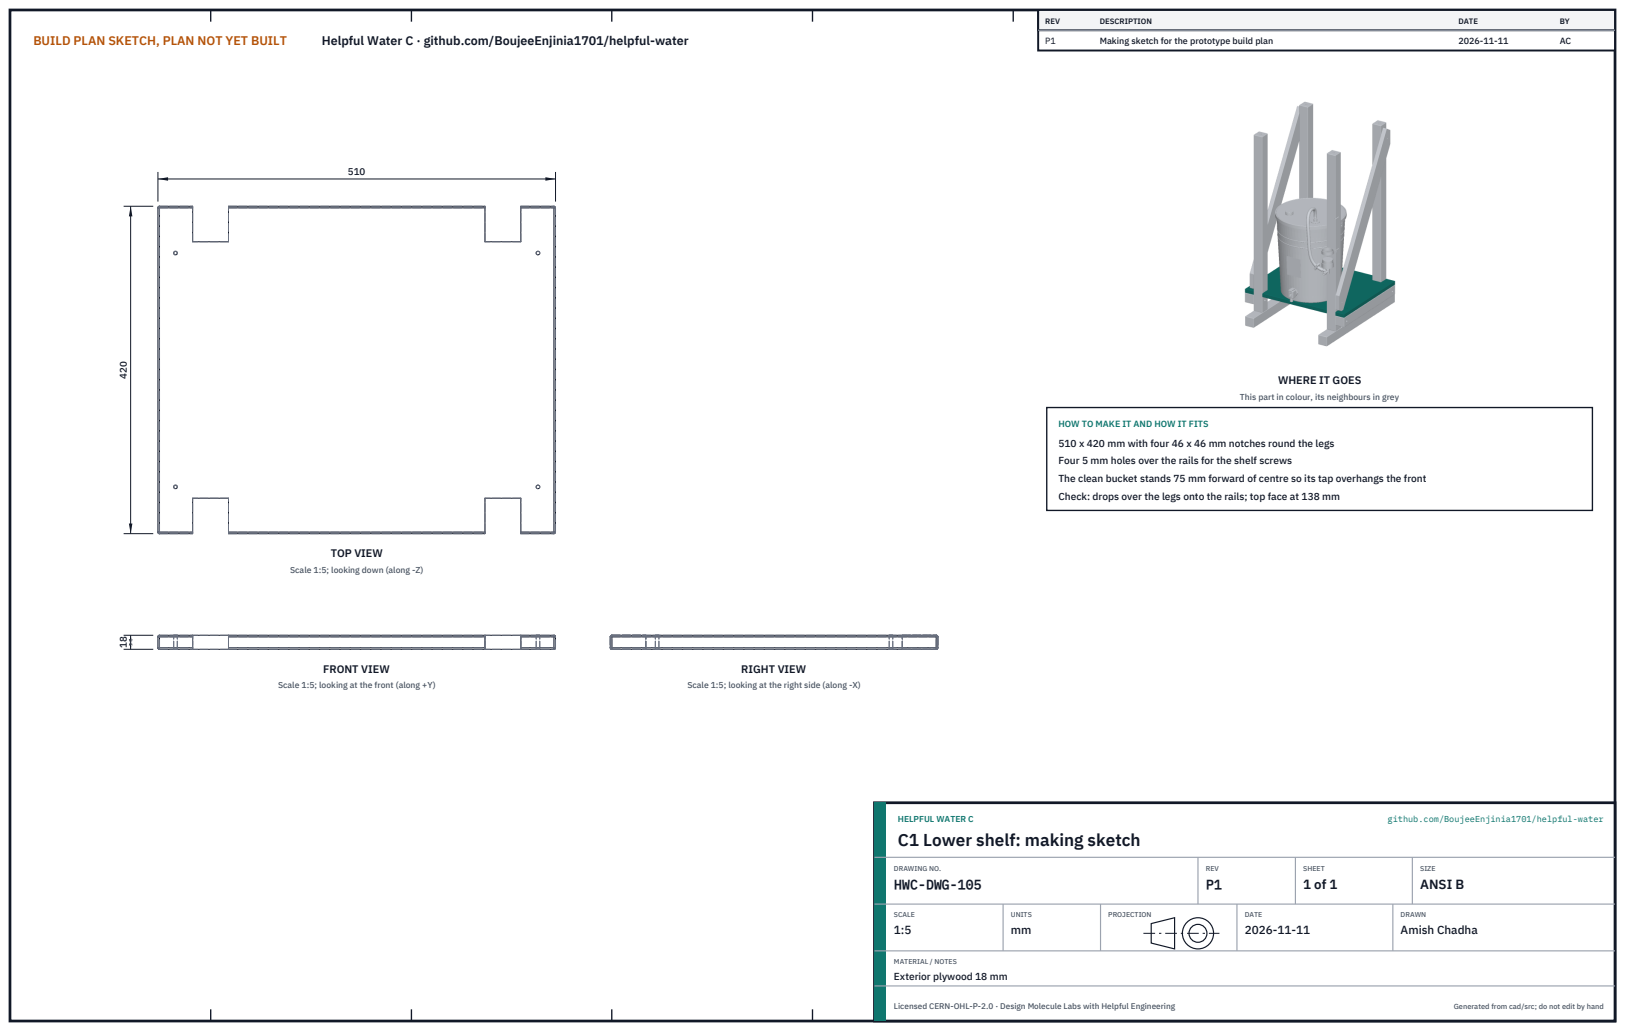
[picture p265: page 1]
BUILD PLAN SKETCH, PLAN NOT YET BUILT; Helpful Water C · github.com/BoujeeEnjinia1701/helpful-water; FRONT VIEW; TOP VIEW; RIGHT VIEW; REV; DESCRIPTION; DATE; Making sketch for the prototype build plan; HELPFUL WATER C; github.com/BoujeeEnjinia1701/helpful-water; DRAWING NO. HWC-DWG-105; REV P1; SHEET 1 of 1; SIZE ANSI B; SCALE 1:5; UNITS mm; PROJECTION; DRAWN Amish Chadha; Licensed CERN-OHL-P-2.0 · Design Molecule Labs with Helpful Engineering; Generated from cad/src; do not edit by hand

WHERE IT GOES

This part in colour, its neighbours in grey

HOW TO MAKE IT AND HOW IT FITS
510 x 420 mm with four 46 x 46 mm notches round the legs
Four 5 mm holes over the rails for the shelf screws
The clean bucket stands 75 mm forward of centre so its tap overhangs the front
Check: drops over the legs onto the rails; top face at 138 mm

Scale 1:5; looking down (along -Z)

Scale 1:5; looking at the front (along +Y)

Scale 1:5; looking at the right side (along -X)

C1 Lower shelf: making sketch

MATERIAL / NOTES
Exterior plywood 18 mm
