BoujeeEnjinia1701/helpful-water/solutions/C-gravity/cad/drawings/HWC-DWG-106.pdf

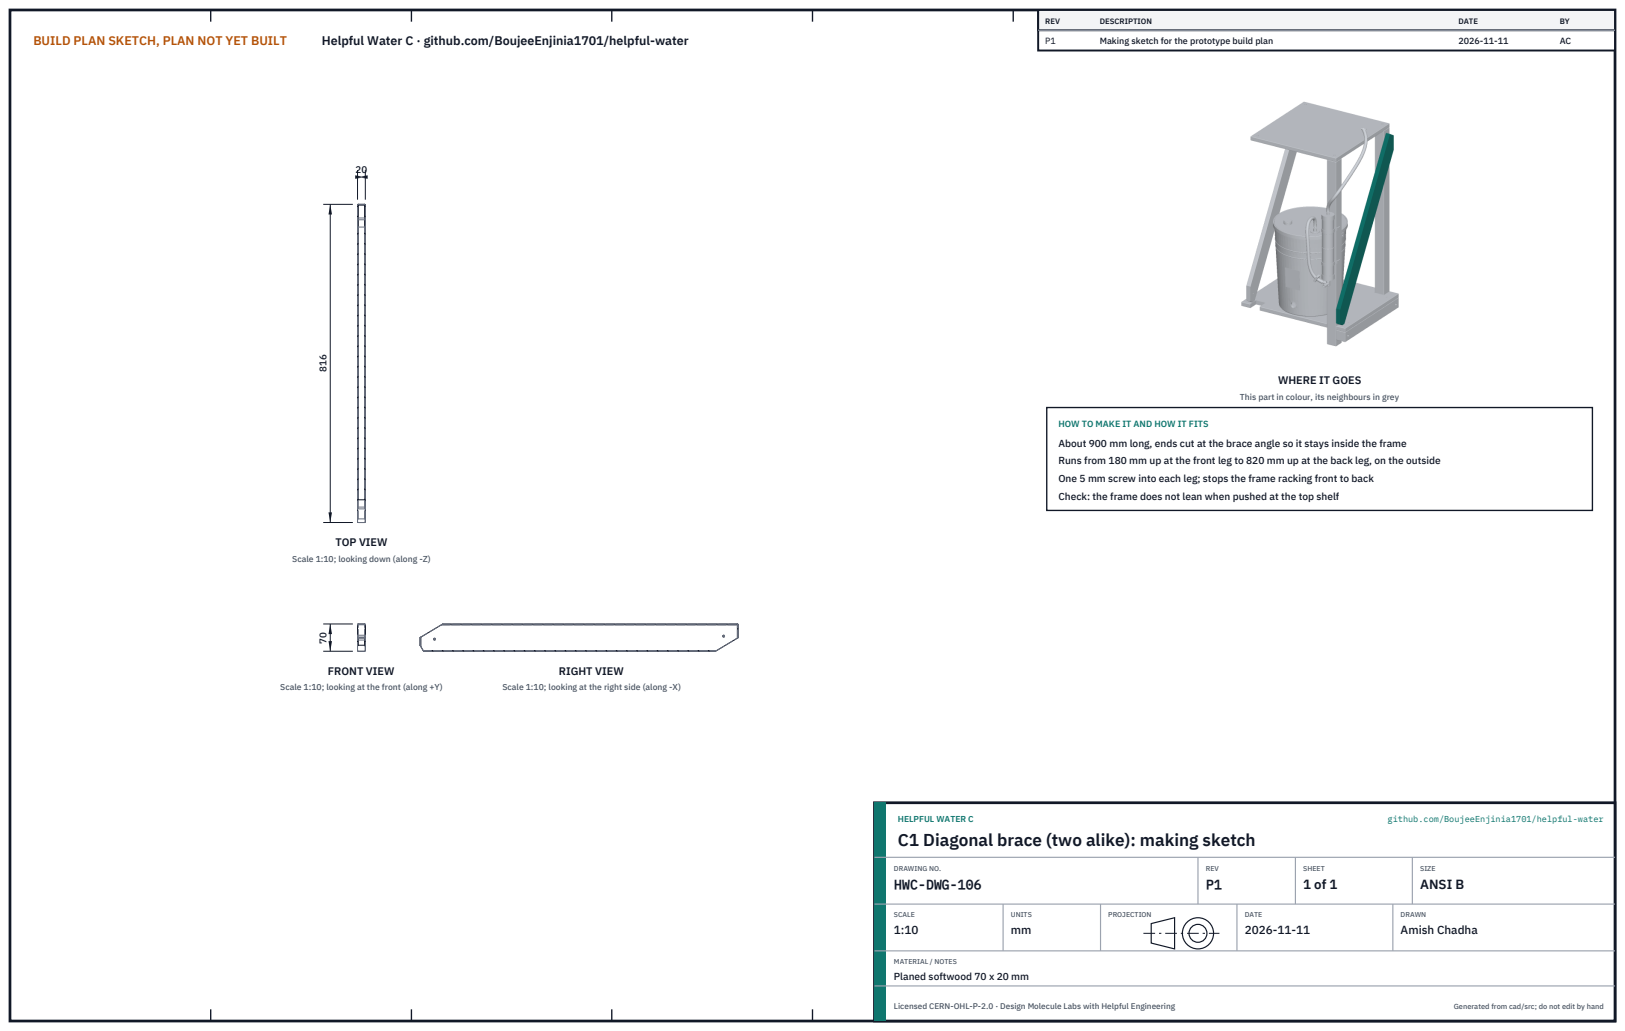
[picture p266: page 1]
BUILD PLAN SKETCH, PLAN NOT YET BUILT; Helpful Water C · github.com/BoujeeEnjinia1701/helpful-water; FRONT VIEW; TOP VIEW; RIGHT VIEW; REV; DESCRIPTION; DATE; Making sketch for the prototype build plan; HELPFUL WATER C; github.com/BoujeeEnjinia1701/helpful-water; DRAWING NO. HWC-DWG-106; REV P1; SHEET 1 of 1; SIZE ANSI B; SCALE 1:10; UNITS mm; PROJECTION; DRAWN Amish Chadha; Licensed CERN-OHL-P-2.0 · Design Molecule Labs with Helpful Engineering; Generated from cad/src; do not edit by hand

WHERE IT GOES

This part in colour, its neighbours in grey

HOW TO MAKE IT AND HOW IT FITS
About 900 mm long, ends cut at the brace angle so it stays inside the frame
Runs from 180 mm up at the front leg to 820 mm up at the back leg, on the outside
One 5 mm screw into each leg; stops the frame racking front to back
Check: the frame does not lean when pushed at the top shelf

Scale 1:10; looking down (along -Z)

Scale 1:10; looking at the front (along +Y)

Scale 1:10; looking at the right side (along -X)

C1 Diagonal brace (two alike): making sketch

MATERIAL / NOTES
Planed softwood 70 x 20 mm
