BoujeeEnjinia1701/helpful-water/solutions/C-gravity/cad/drawings/HWC-DWG-107.pdf

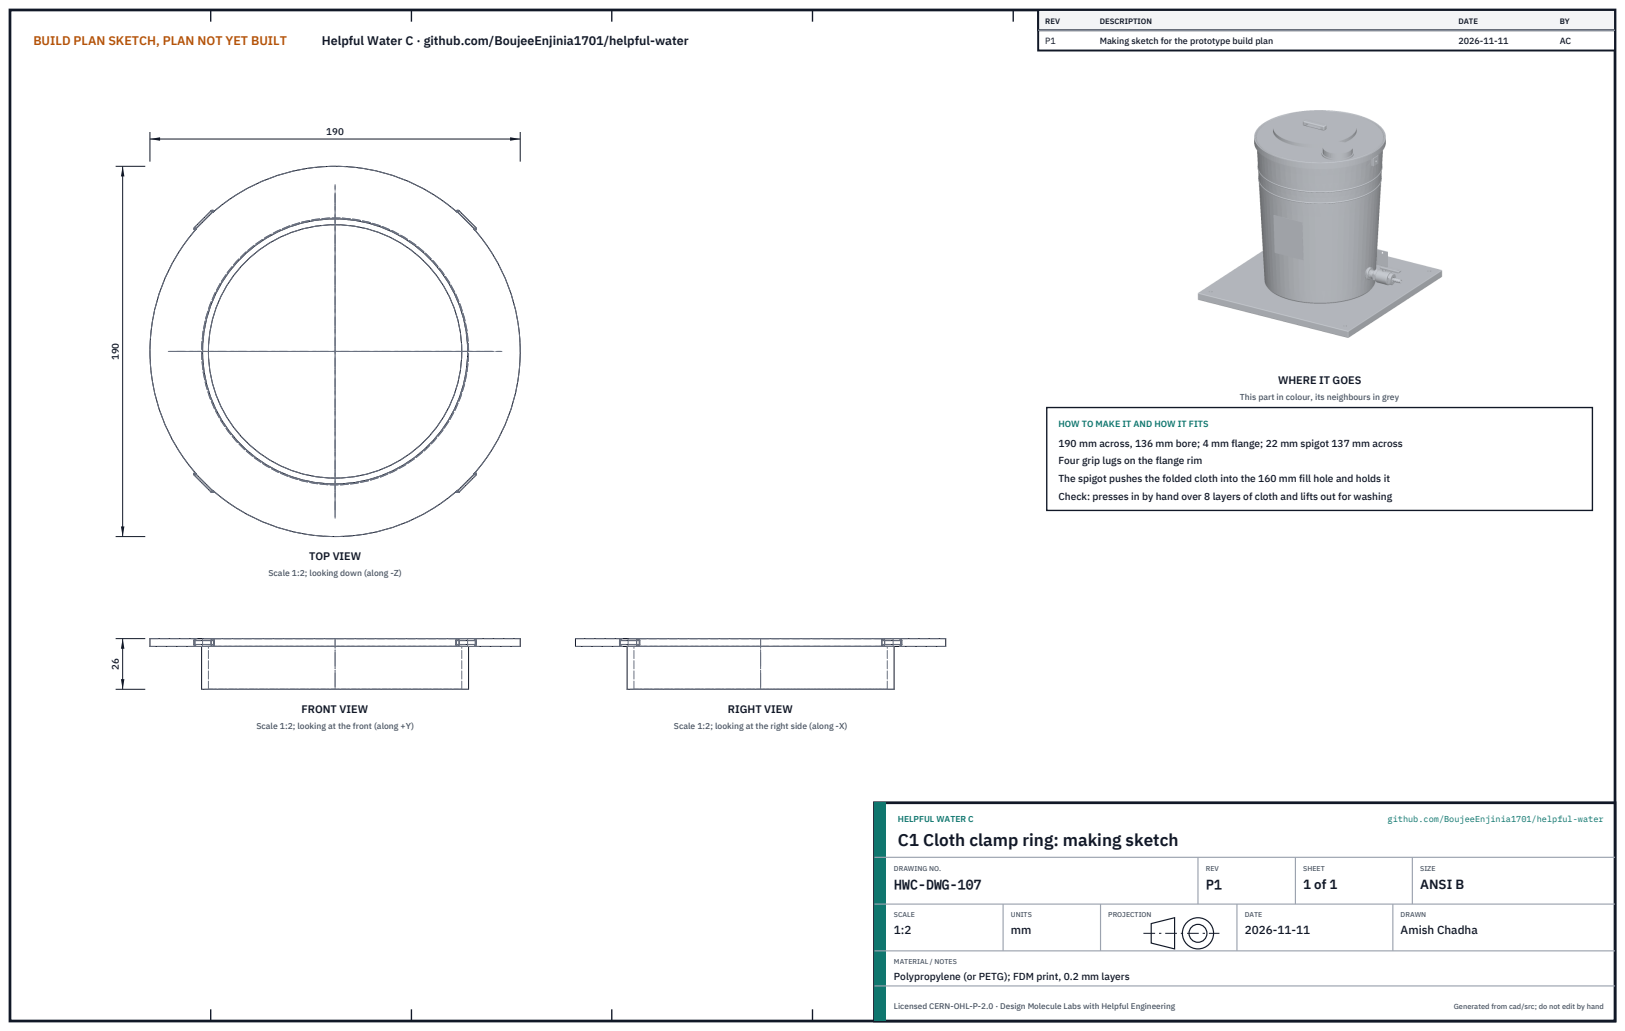
[picture p267: page 1]
BUILD PLAN SKETCH, PLAN NOT YET BUILT; Helpful Water C · github.com/BoujeeEnjinia1701/helpful-water; FRONT VIEW; TOP VIEW; RIGHT VIEW; REV; DESCRIPTION; DATE; Making sketch for the prototype build plan; HELPFUL WATER C; github.com/BoujeeEnjinia1701/helpful-water; DRAWING NO. HWC-DWG-107; REV P1; SHEET 1 of 1; SIZE ANSI B; SCALE 1:2; UNITS mm; PROJECTION; DRAWN Amish Chadha; Licensed CERN-OHL-P-2.0 · Design Molecule Labs with Helpful Engineering; Generated from cad/src; do not edit by hand

WHERE IT GOES

This part in colour, its neighbours in grey

HOW TO MAKE IT AND HOW IT FITS
190 mm across, 136 mm bore; 4 mm flange; 22 mm spigot 137 mm across
Four grip lugs on the flange rim
The spigot pushes the folded cloth into the 160 mm fill hole and holds it
Check: presses in by hand over 8 layers of cloth and lifts out for washing

Scale 1:2; looking down (along -Z)

Scale 1:2; looking at the front (along +Y)

Scale 1:2; looking at the right side (along -X)

C1 Cloth clamp ring: making sketch

MATERIAL / NOTES
Polypropylene (or PETG); FDM print, 0.2 mm layers
