BoujeeEnjinia1701/helpful-water/solutions/C-gravity/cad/drawings/HWC-DWG-108.pdf

BUILD PLAN SKETCH, PLAN NOT YET BUILT Helpful Water C · github.com/BoujeeEnjinia1701/helpful-water

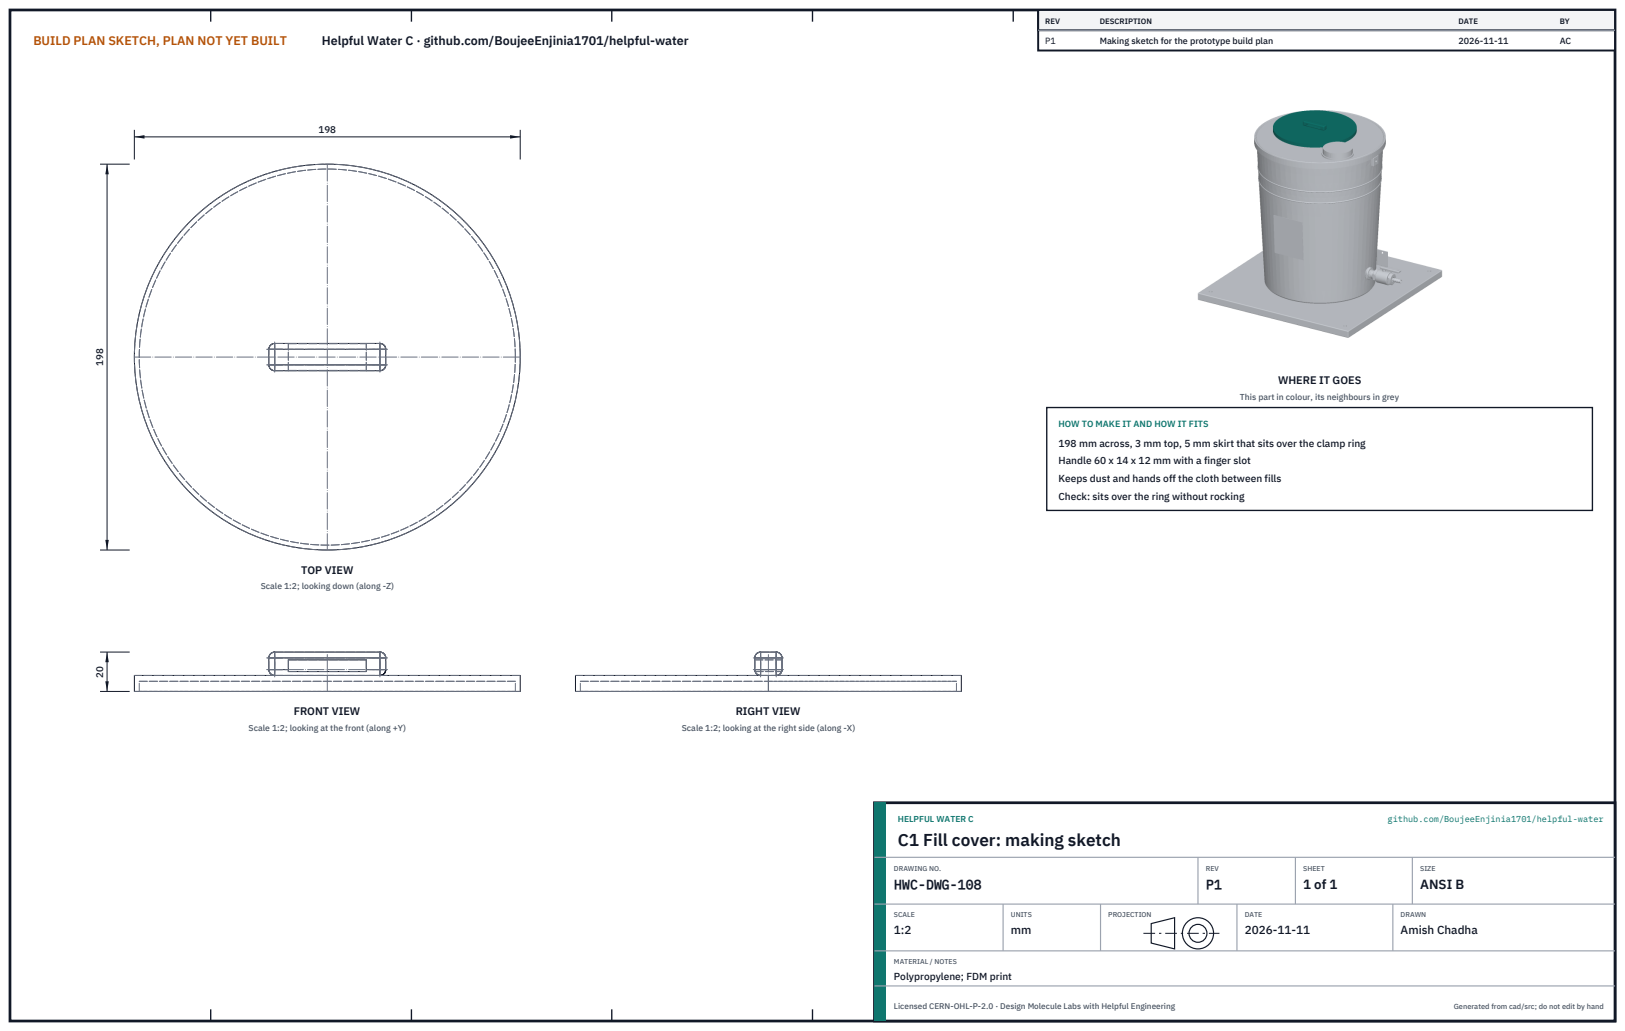
[picture p268: page 1]
FRONT VIEW; TOP VIEW; RIGHT VIEW; REV; DESCRIPTION; DATE; Making sketch for the prototype build plan; HELPFUL WATER C; github.com/BoujeeEnjinia1701/helpful-water; DRAWING NO. HWC-DWG-108; REV P1; SHEET 1 of 1; SIZE ANSI B; SCALE 1:2; UNITS mm; PROJECTION; DRAWN Amish Chadha; Licensed CERN-OHL-P-2.0 · Design Molecule Labs with Helpful Engineering; Generated from cad/src; do not edit by hand

WHERE IT GOES

This part in colour, its neighbours in grey

HOW TO MAKE IT AND HOW IT FITS
198 mm across, 3 mm top, 5 mm skirt that sits over the clamp ring
Handle 60 x 14 x 12 mm with a finger slot
Keeps dust and hands off the cloth between fills
Check: sits over the ring without rocking

Scale 1:2; looking down (along -Z)

Scale 1:2; looking at the front (along +Y)

Scale 1:2; looking at the right side (along -X)

C1 Fill cover: making sketch

MATERIAL / NOTES
Polypropylene; FDM print
