BoujeeEnjinia1701/helpful-water/solutions/C-gravity/cad/drawings/HWC-DWG-109.pdf

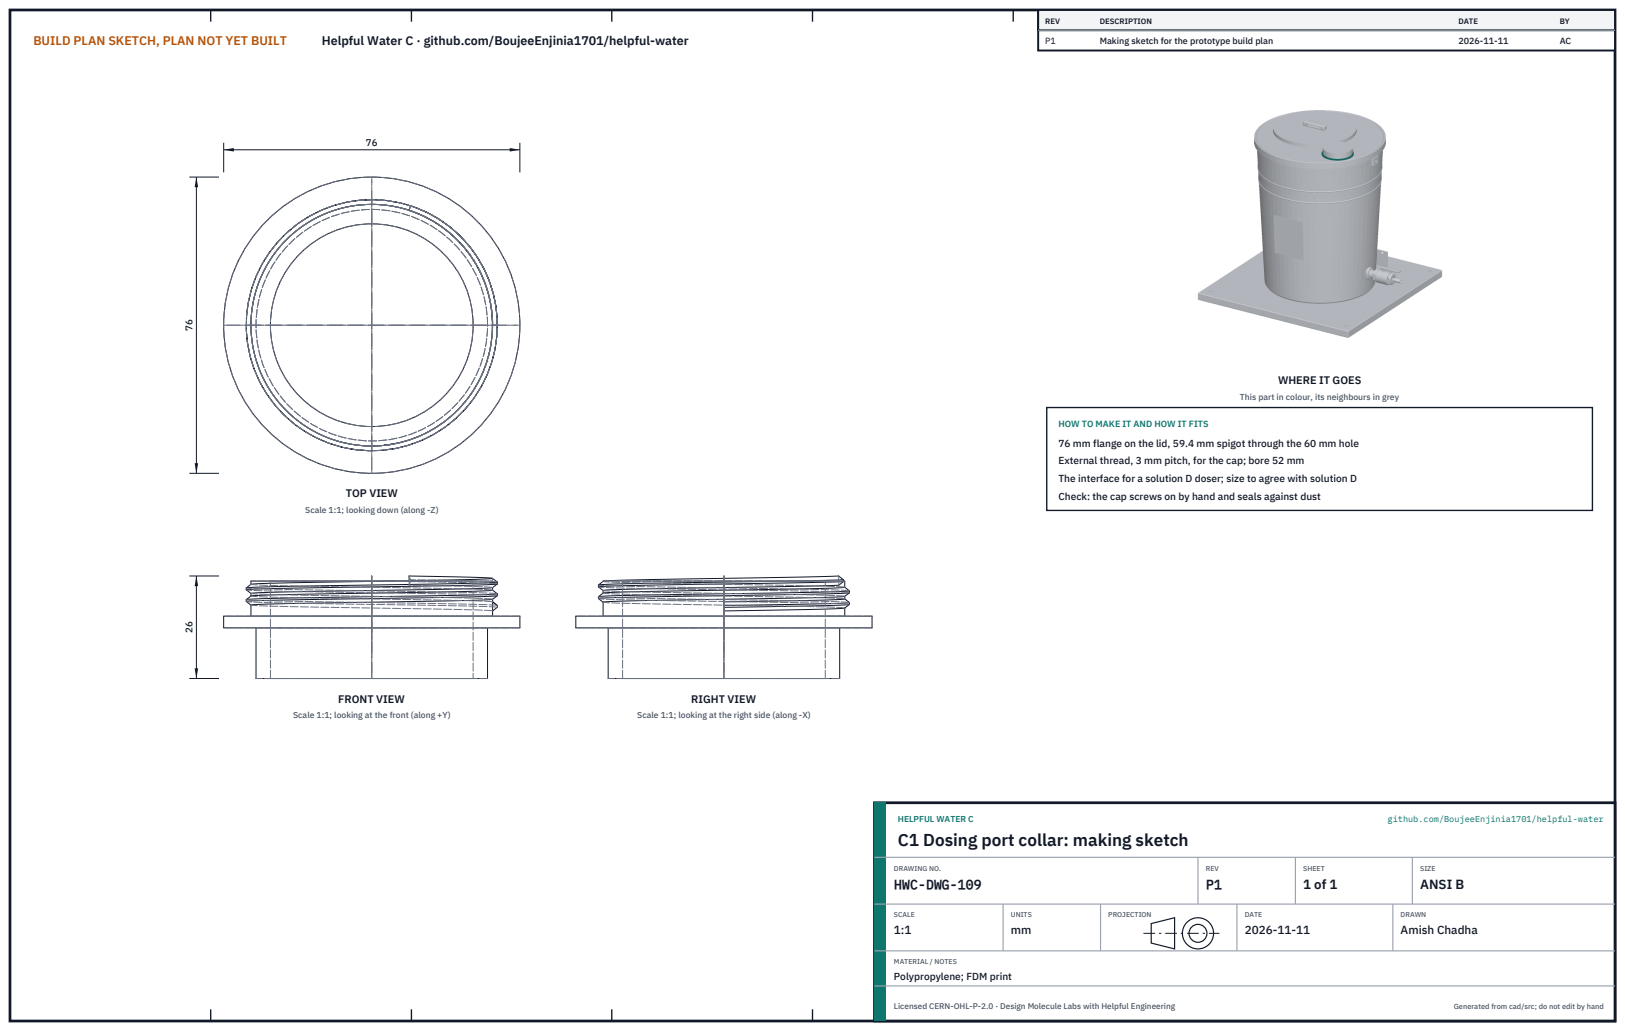
[picture p269: page 1]
BUILD PLAN SKETCH, PLAN NOT YET BUILT; Helpful Water C · github.com/BoujeeEnjinia1701/helpful-water; FRONT VIEW; TOP VIEW; RIGHT VIEW; REV; DESCRIPTION; DATE; Making sketch for the prototype build plan; HELPFUL WATER C; github.com/BoujeeEnjinia1701/helpful-water; DRAWING NO. HWC-DWG-109; REV P1; SHEET 1 of 1; SIZE ANSI B; SCALE 1:1; UNITS mm; PROJECTION; DRAWN Amish Chadha; Licensed CERN-OHL-P-2.0 · Design Molecule Labs with Helpful Engineering; Generated from cad/src; do not edit by hand

WHERE IT GOES

This part in colour, its neighbours in grey

HOW TO MAKE IT AND HOW IT FITS
76 mm flange on the lid, 59.4 mm spigot through the 60 mm hole
External thread, 3 mm pitch, for the cap; bore 52 mm
The interface for a solution D doser; size to agree with solution D
Check: the cap screws on by hand and seals against dust

Scale 1:1; looking down (along -Z)

Scale 1:1; looking at the front (along +Y)

Scale 1:1; looking at the right side (along -X)

C1 Dosing port collar: making sketch

MATERIAL / NOTES
Polypropylene; FDM print
