BoujeeEnjinia1701/helpful-water/solutions/C-gravity/cad/drawings/HWC-DWG-111.pdf

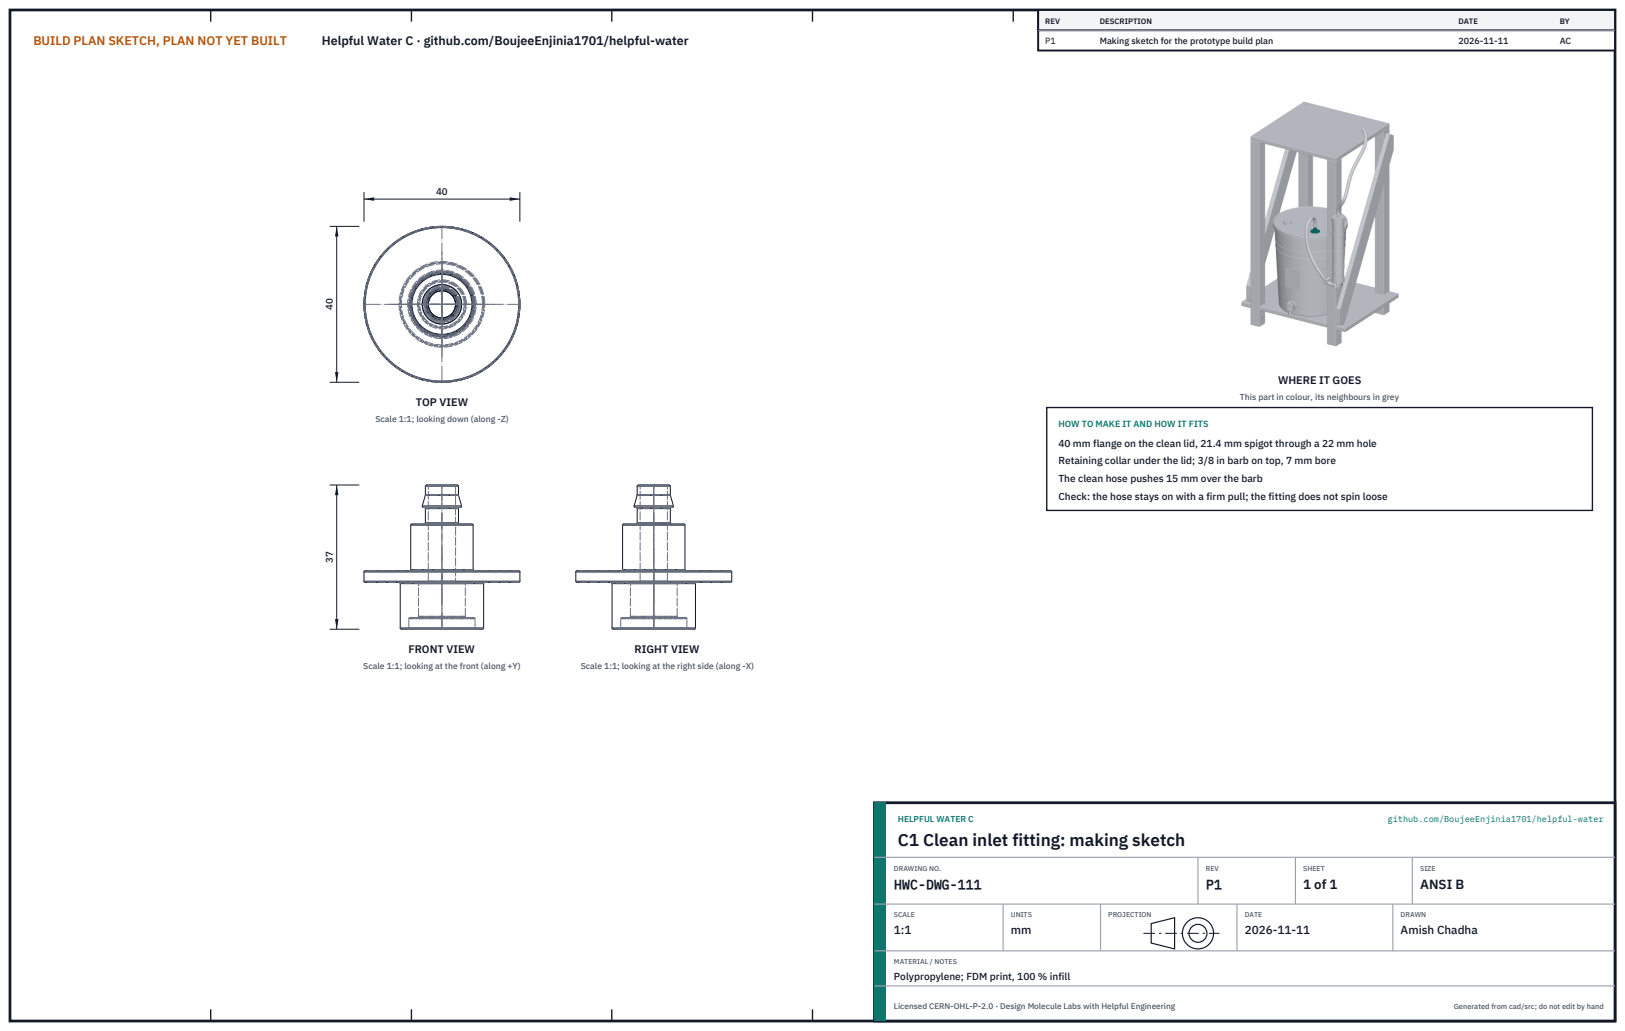
[picture p270: page 1]
BUILD PLAN SKETCH, PLAN NOT YET BUILT; Helpful Water C · github.com/BoujeeEnjinia1701/helpful-water; FRONT VIEW; TOP VIEW; RIGHT VIEW; REV; DESCRIPTION; DATE; Making sketch for the prototype build plan; HELPFUL WATER C; github.com/BoujeeEnjinia1701/helpful-water; DRAWING NO. HWC-DWG-111; REV P1; SHEET 1 of 1; SIZE ANSI B; SCALE 1:1; UNITS mm; PROJECTION; DRAWN Amish Chadha; Licensed CERN-OHL-P-2.0 · Design Molecule Labs with Helpful Engineering; Generated from cad/src; do not edit by hand

WHERE IT GOES

This part in colour, its neighbours in grey

Scale 1:1; looking down (along -Z)

HOW TO MAKE IT AND HOW IT FITS
40 mm flange on the clean lid, 21.4 mm spigot through a 22 mm hole
Retaining collar under the lid; 3/8 in barb on top, 7 mm bore
The clean hose pushes 15 mm over the barb
Check: the hose stays on with a firm pull; the fitting does not spin loose

Scale 1:1; looking at the front (along +Y)

Scale 1:1; looking at the right side (along -X)

C1 Clean inlet fitting: making sketch

MATERIAL / NOTES
Polypropylene; FDM print, 100 % infill
