BoujeeEnjinia1701/helpful-water/solutions/C-gravity/cad/drawings/HWC-DWG-112.pdf

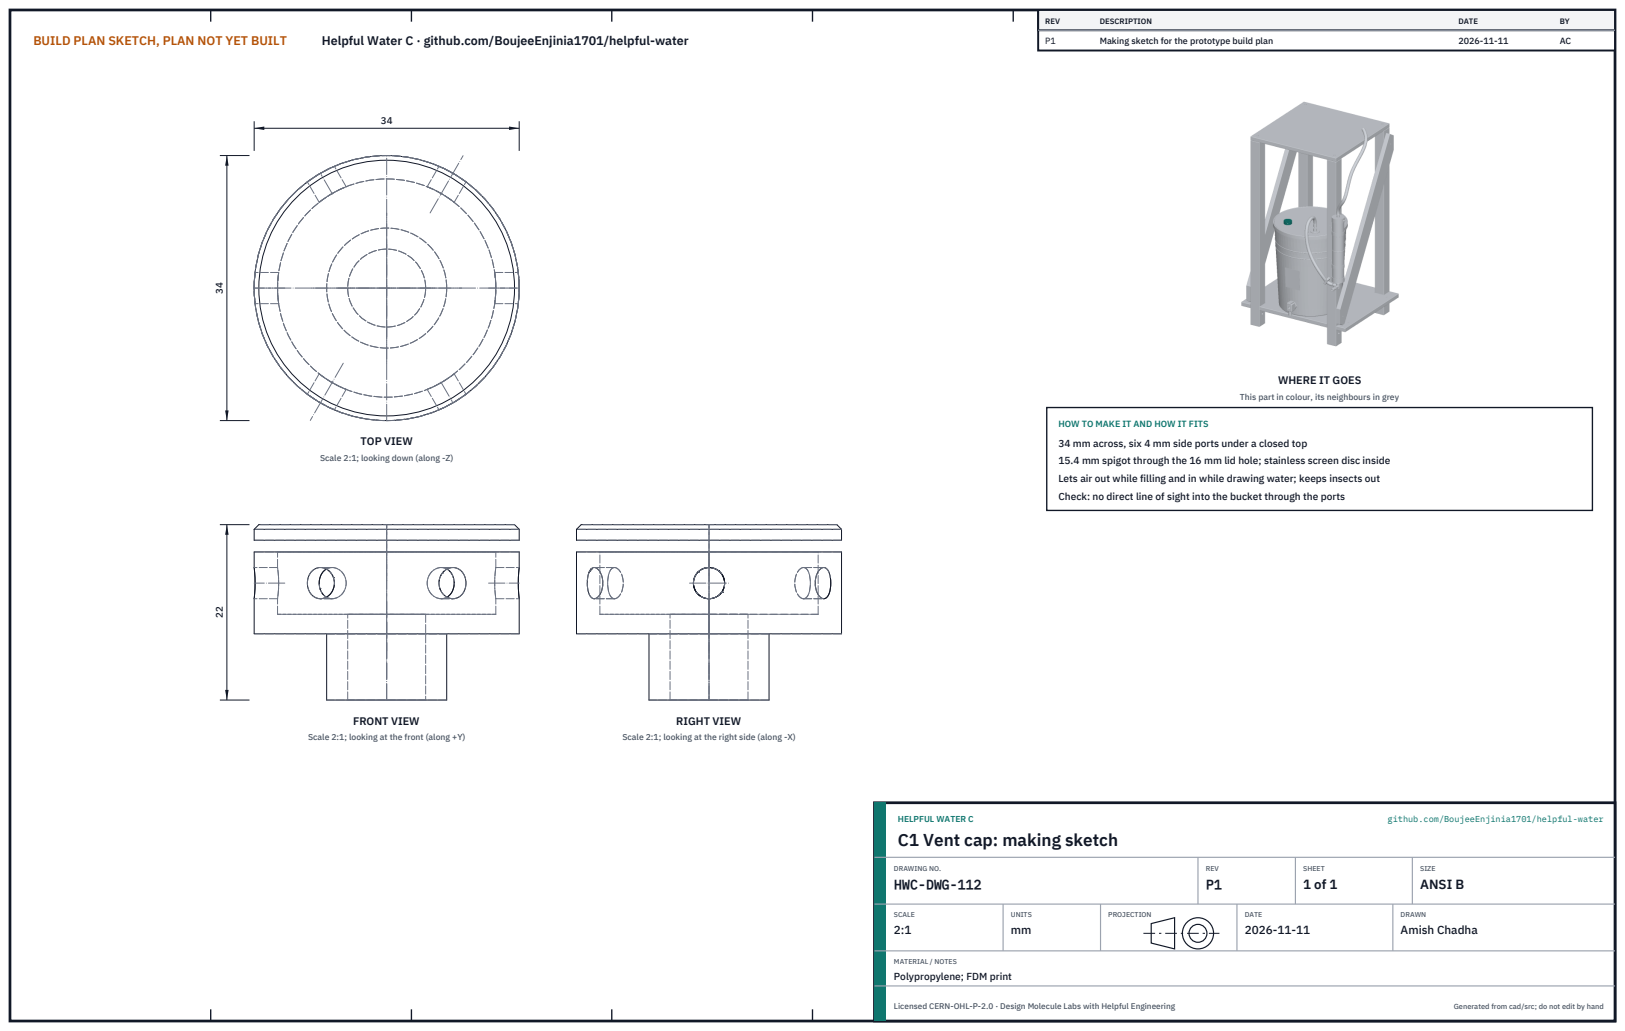
[picture p271: page 1]
BUILD PLAN SKETCH, PLAN NOT YET BUILT; Helpful Water C · github.com/BoujeeEnjinia1701/helpful-water; FRONT VIEW; TOP VIEW; RIGHT VIEW; REV; DESCRIPTION; DATE; Making sketch for the prototype build plan; HELPFUL WATER C; github.com/BoujeeEnjinia1701/helpful-water; DRAWING NO. HWC-DWG-112; REV P1; SHEET 1 of 1; SIZE ANSI B; SCALE 2:1; UNITS mm; PROJECTION; DRAWN Amish Chadha; Licensed CERN-OHL-P-2.0 · Design Molecule Labs with Helpful Engineering; Generated from cad/src; do not edit by hand

WHERE IT GOES

This part in colour, its neighbours in grey

HOW TO MAKE IT AND HOW IT FITS
34 mm across, six 4 mm side ports under a closed top
15.4 mm spigot through the 16 mm lid hole; stainless screen disc inside
Lets air out while filling and in while drawing water; keeps insects out
Check: no direct line of sight into the bucket through the ports

Scale 2:1; looking down (along -Z)

Scale 2:1; looking at the front (along +Y)

Scale 2:1; looking at the right side (along -X)

C1 Vent cap: making sketch

MATERIAL / NOTES
Polypropylene; FDM print
