BoujeeEnjinia1701/helpful-water/solutions/C-gravity/cad/drawings/HWC-DWG-113.pdf

BUILD PLAN SKETCH, PLAN NOT YET BUILT Helpful Water C · github.com/BoujeeEnjinia1701/helpful-water

### TOP VIEW

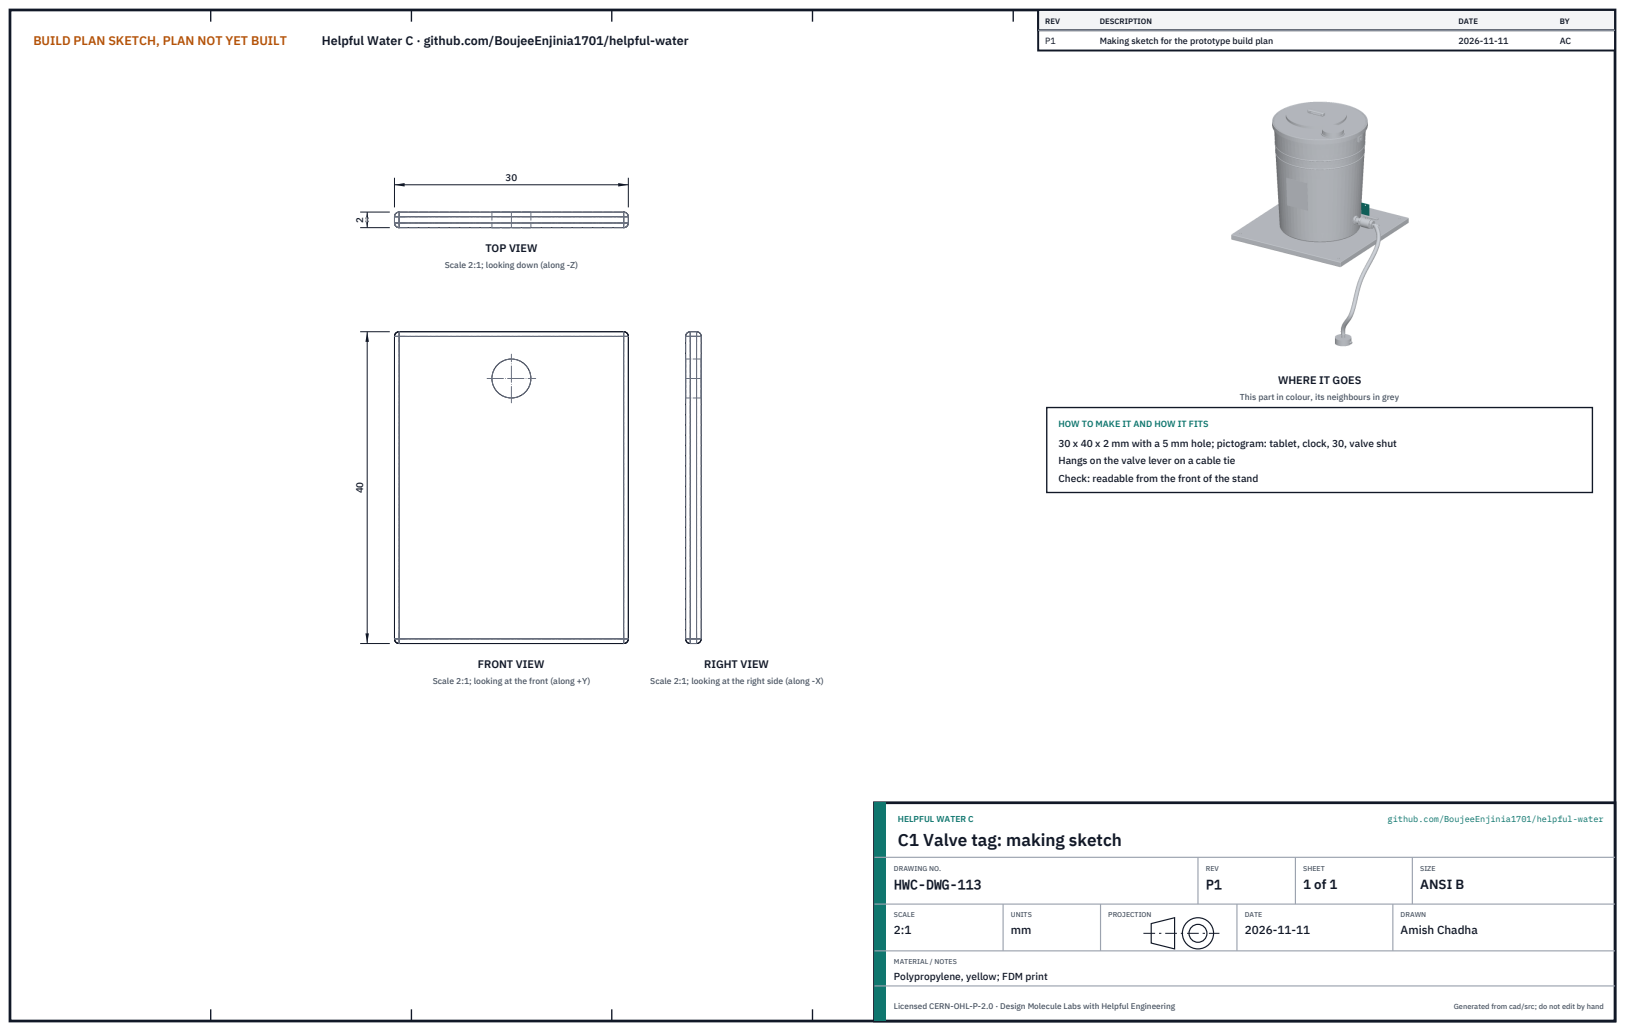
[picture p272: page 1]
FRONT VIEW; RIGHT VIEW; REV; DESCRIPTION; DATE; Making sketch for the prototype build plan; HELPFUL WATER C; github.com/BoujeeEnjinia1701/helpful-water; DRAWING NO. HWC-DWG-113; REV P1; SHEET 1 of 1; SIZE ANSI B; SCALE 2:1; UNITS mm; PROJECTION; DRAWN Amish Chadha; Licensed CERN-OHL-P-2.0 · Design Molecule Labs with Helpful Engineering; Generated from cad/src; do not edit by hand

Scale 2:1; looking down (along -Z)

WHERE IT GOES

This part in colour, its neighbours in grey

HOW TO MAKE IT AND HOW IT FITS
30 x 40 x 2 mm with a 5 mm hole; pictogram: tablet, clock, 30, valve shut
Hangs on the valve lever on a cable tie
Check: readable from the front of the stand

Scale 2:1; looking at the front (along +Y)

Scale 2:1; looking at the right side (along -X)

C1 Valve tag: making sketch

MATERIAL / NOTES
Polypropylene, yellow; FDM print
