BoujeeEnjinia1701/helpful-water/solutions/D-virus-add-on/cad/drawings/HWD-DWG-103.pdf

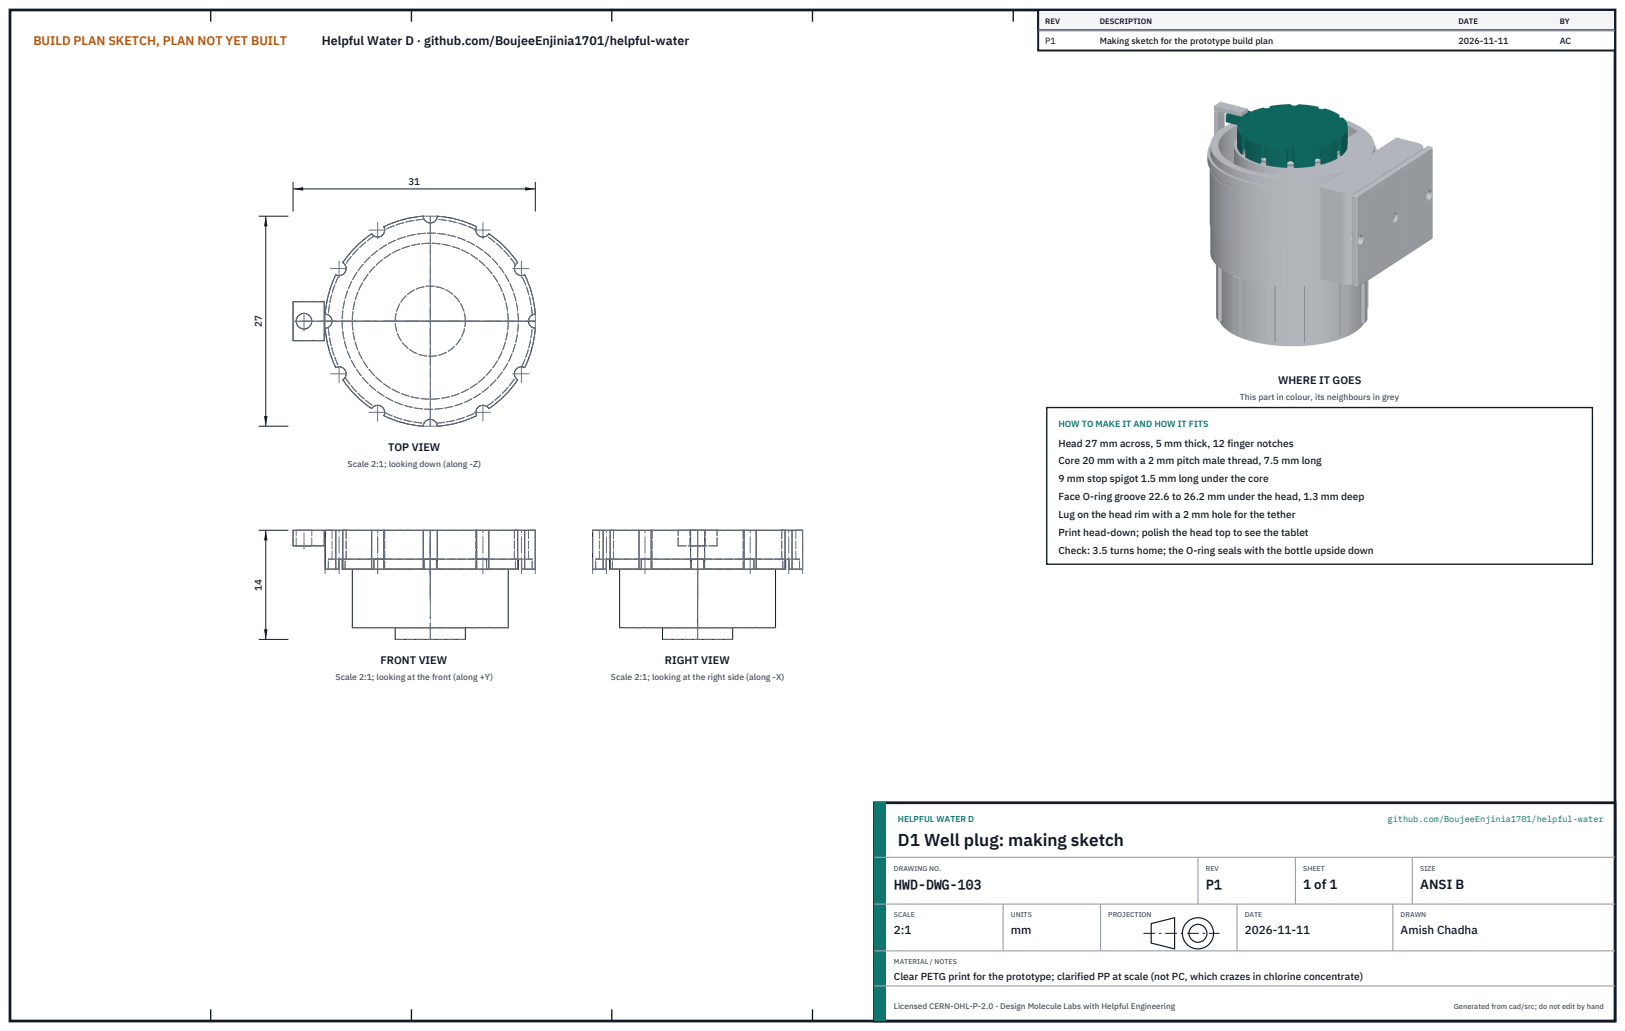
[picture p273: page 1]
BUILD PLAN SKETCH, PLAN NOT YET BUILT; Helpful Water D · github.com/BoujeeEnjinia1701/helpful-water; FRONT VIEW; TOP VIEW; RIGHT VIEW; REV; DESCRIPTION; DATE; Making sketch for the prototype build plan; HELPFUL WATER D; github.com/BoujeeEnjinia1701/helpful-water; DRAWING NO. HWD-DWG-103; REV P1; SHEET 1 of 1; SIZE ANSI B; SCALE 2:1; UNITS mm; PROJECTION; DRAWN Amish Chadha; Licensed CERN-OHL-P-2.0 · Design Molecule Labs with Helpful Engineering; Generated from cad/src; do not edit by hand

WHERE IT GOES

This part in colour, its neighbours in grey

HOW TO MAKE IT AND HOW IT FITS
Head 27 mm across, 5 mm thick, 12 finger notches
Core 20 mm with a 2 mm pitch male thread, 7.5 mm long
9 mm stop spigot 1.5 mm long under the core
Face O-ring groove 22.6 to 26.2 mm under the head, 1.3 mm deep
Lug on the head rim with a 2 mm hole for the tether
Print head-down; polish the head top to see the tablet
Check: 3.5 turns home; the O-ring seals with the bottle upside down

Scale 2:1; looking down (along -Z)

Scale 2:1; looking at the front (along +Y)

Scale 2:1; looking at the right side (along -X)

D1 Well plug: making sketch

MATERIAL / NOTES
Clear PETG print for the prototype; clarified PP at scale (not PC, which crazes in chlorine concentrate)
