BoujeeEnjinia1701/helpful-water/solutions/D-virus-add-on/cad/drawings/HWD-DWG-104.pdf

BUILD PLAN SKETCH, PLAN NOT YET BUILT Helpful Water D · github.com/BoujeeEnjinia1701/helpful-water

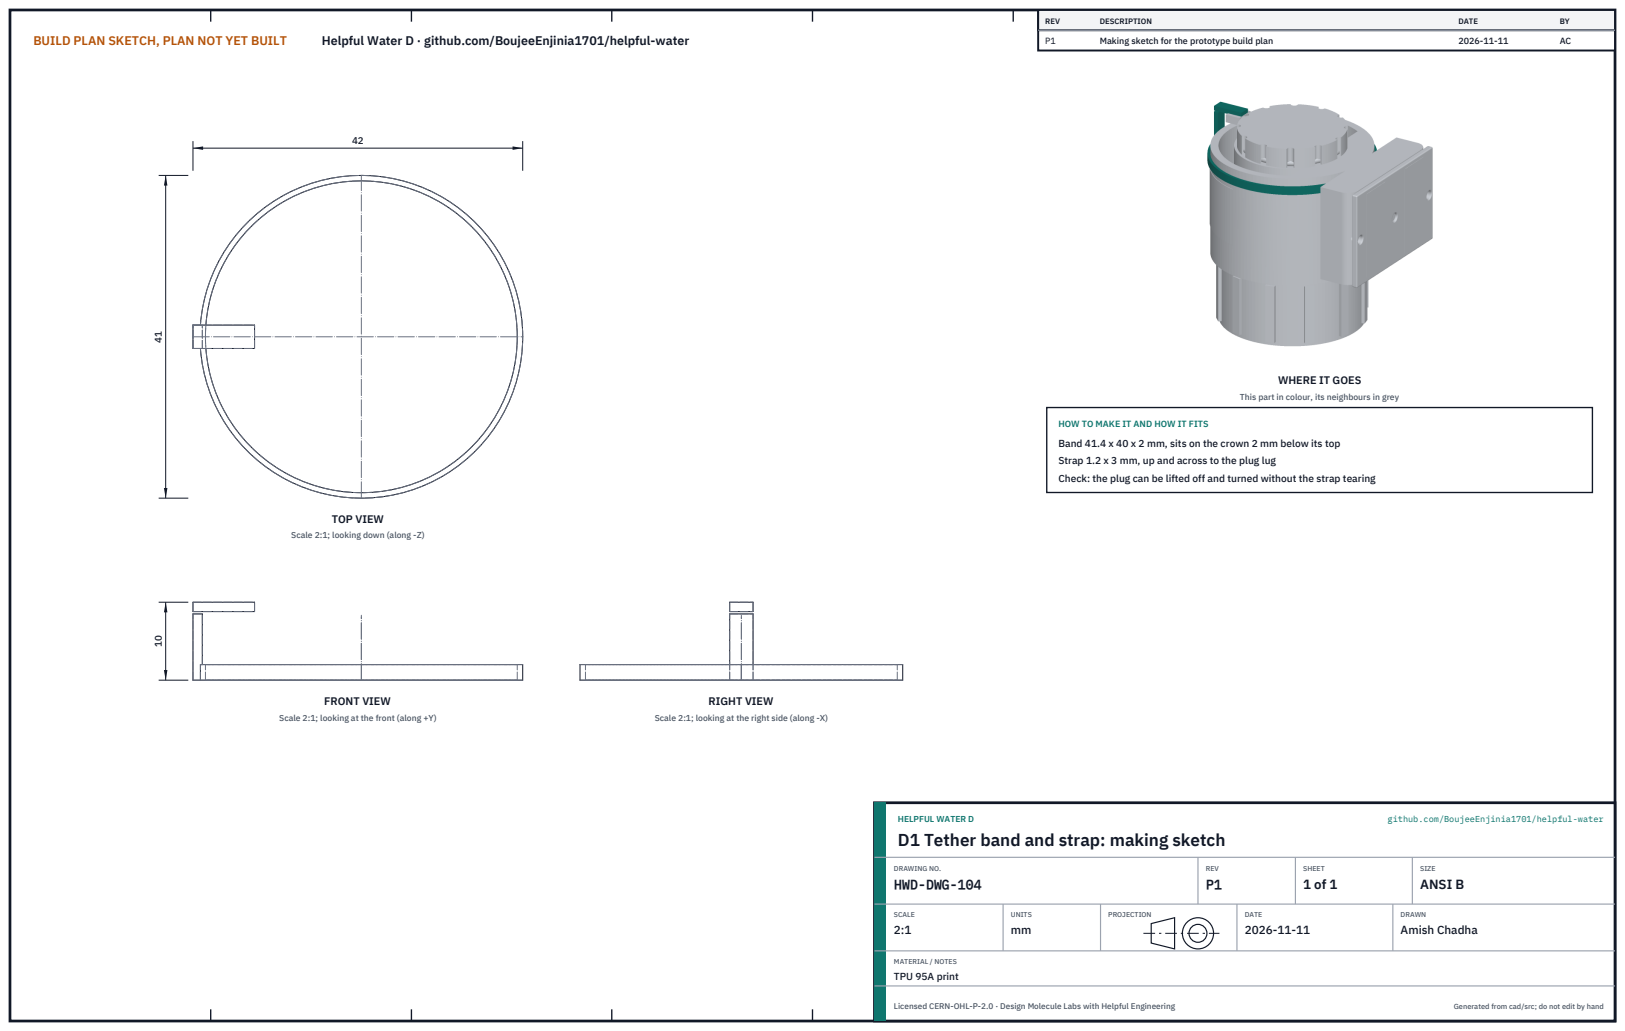
[picture p274: page 1]
FRONT VIEW; TOP VIEW; RIGHT VIEW; REV; DESCRIPTION; DATE; Making sketch for the prototype build plan; HELPFUL WATER D; github.com/BoujeeEnjinia1701/helpful-water; DRAWING NO. HWD-DWG-104; REV P1; SHEET 1 of 1; SIZE ANSI B; SCALE 2:1; UNITS mm; PROJECTION; DRAWN Amish Chadha; MATERIAL / NOTES TPU 95A print; Licensed CERN-OHL-P-2.0 · Design Molecule Labs with Helpful Engineering; Generated from cad/src; do not edit by hand

WHERE IT GOES

This part in colour, its neighbours in grey

HOW TO MAKE IT AND HOW IT FITS
Band 41.4 x 40 x 2 mm, sits on the crown 2 mm below its top
Strap 1.2 x 3 mm, up and across to the plug lug
Check: the plug can be lifted off and turned without the strap tearing

Scale 2:1; looking down (along -Z)

Scale 2:1; looking at the front (along +Y)

Scale 2:1; looking at the right side (along -X)

D1 Tether band and strap: making sketch
