BoujeeEnjinia1701/helpful-water/solutions/D-virus-add-on/cad/drawings/HWD-DWG-105.pdf

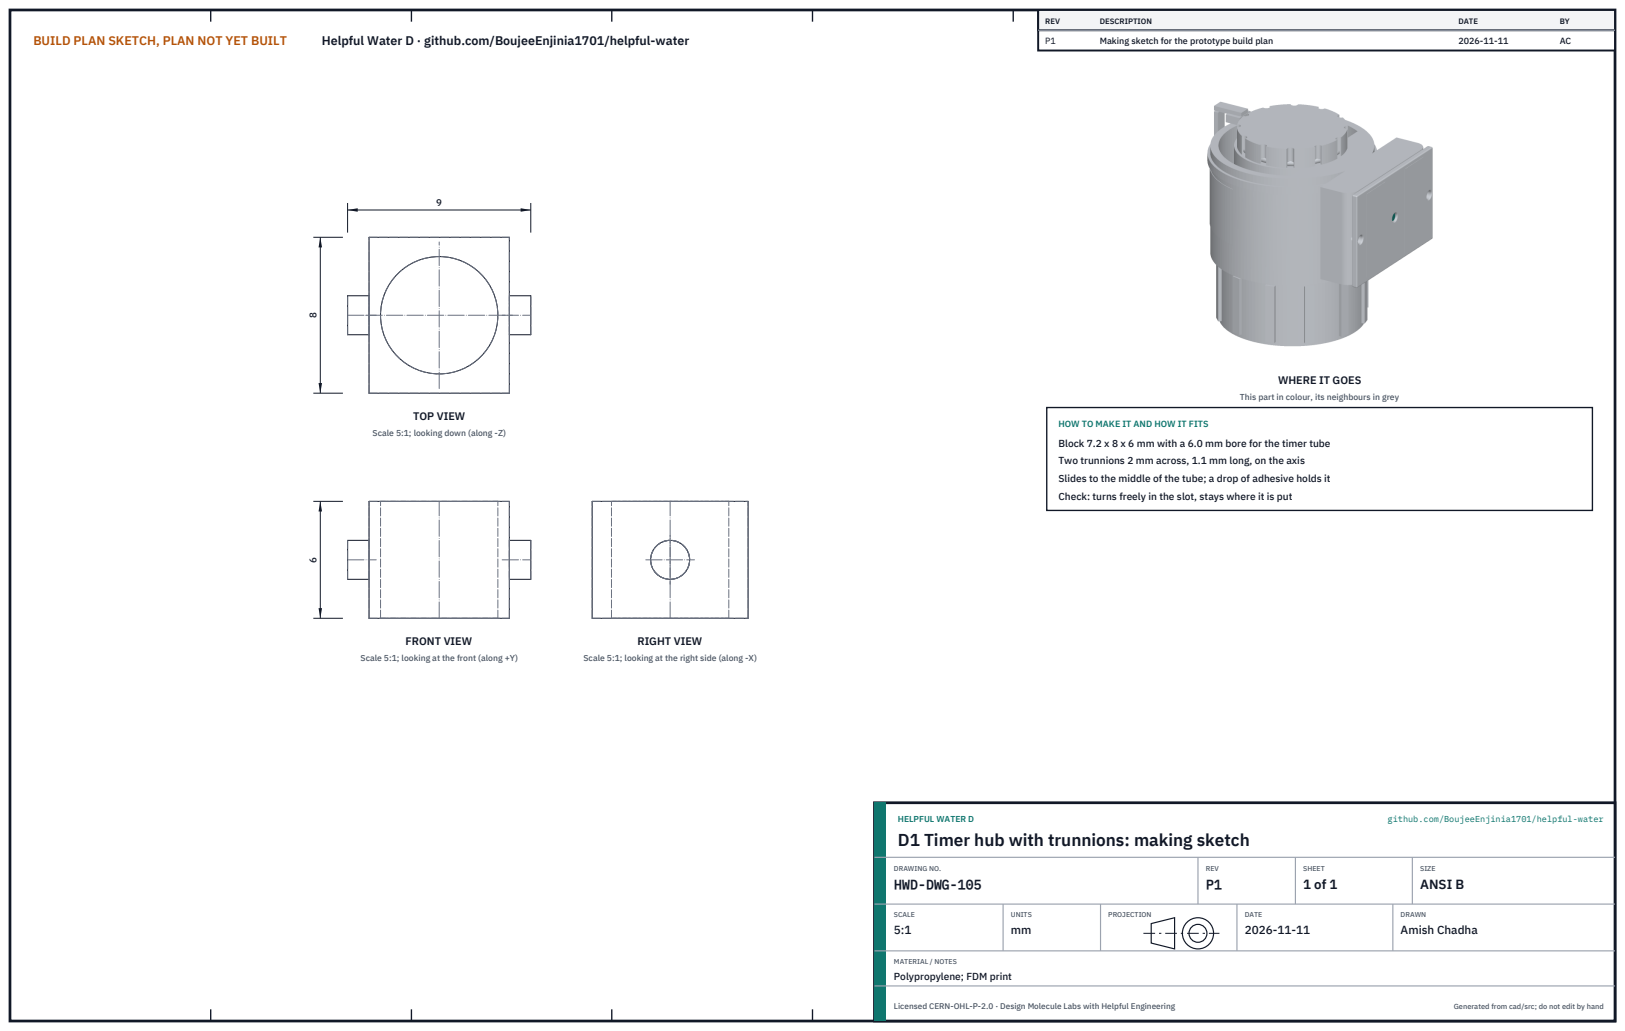
[picture p275: page 1]
BUILD PLAN SKETCH, PLAN NOT YET BUILT; Helpful Water D · github.com/BoujeeEnjinia1701/helpful-water; FRONT VIEW; TOP VIEW; RIGHT VIEW; REV; DESCRIPTION; DATE; Making sketch for the prototype build plan; HELPFUL WATER D; github.com/BoujeeEnjinia1701/helpful-water; DRAWING NO. HWD-DWG-105; REV P1; SHEET 1 of 1; SIZE ANSI B; SCALE 5:1; UNITS mm; PROJECTION; DRAWN Amish Chadha; Licensed CERN-OHL-P-2.0 · Design Molecule Labs with Helpful Engineering; Generated from cad/src; do not edit by hand

WHERE IT GOES

This part in colour, its neighbours in grey

Scale 5:1; looking down (along -Z)

HOW TO MAKE IT AND HOW IT FITS
Block 7.2 x 8 x 6 mm with a 6.0 mm bore for the timer tube
Two trunnions 2 mm across, 1.1 mm long, on the axis
Slides to the middle of the tube; a drop of adhesive holds it
Check: turns freely in the slot, stays where it is put

Scale 5:1; looking at the front (along +Y)

Scale 5:1; looking at the right side (along -X)

D1 Timer hub with trunnions: making sketch

MATERIAL / NOTES
Polypropylene; FDM print
