BoujeeEnjinia1701/helpful-water/solutions/D-virus-add-on/cad/drawings/HWD-DWG-106.pdf

BUILD PLAN SKETCH, PLAN NOT YET BUILT Helpful Water D · github.com/BoujeeEnjinia1701/helpful-water

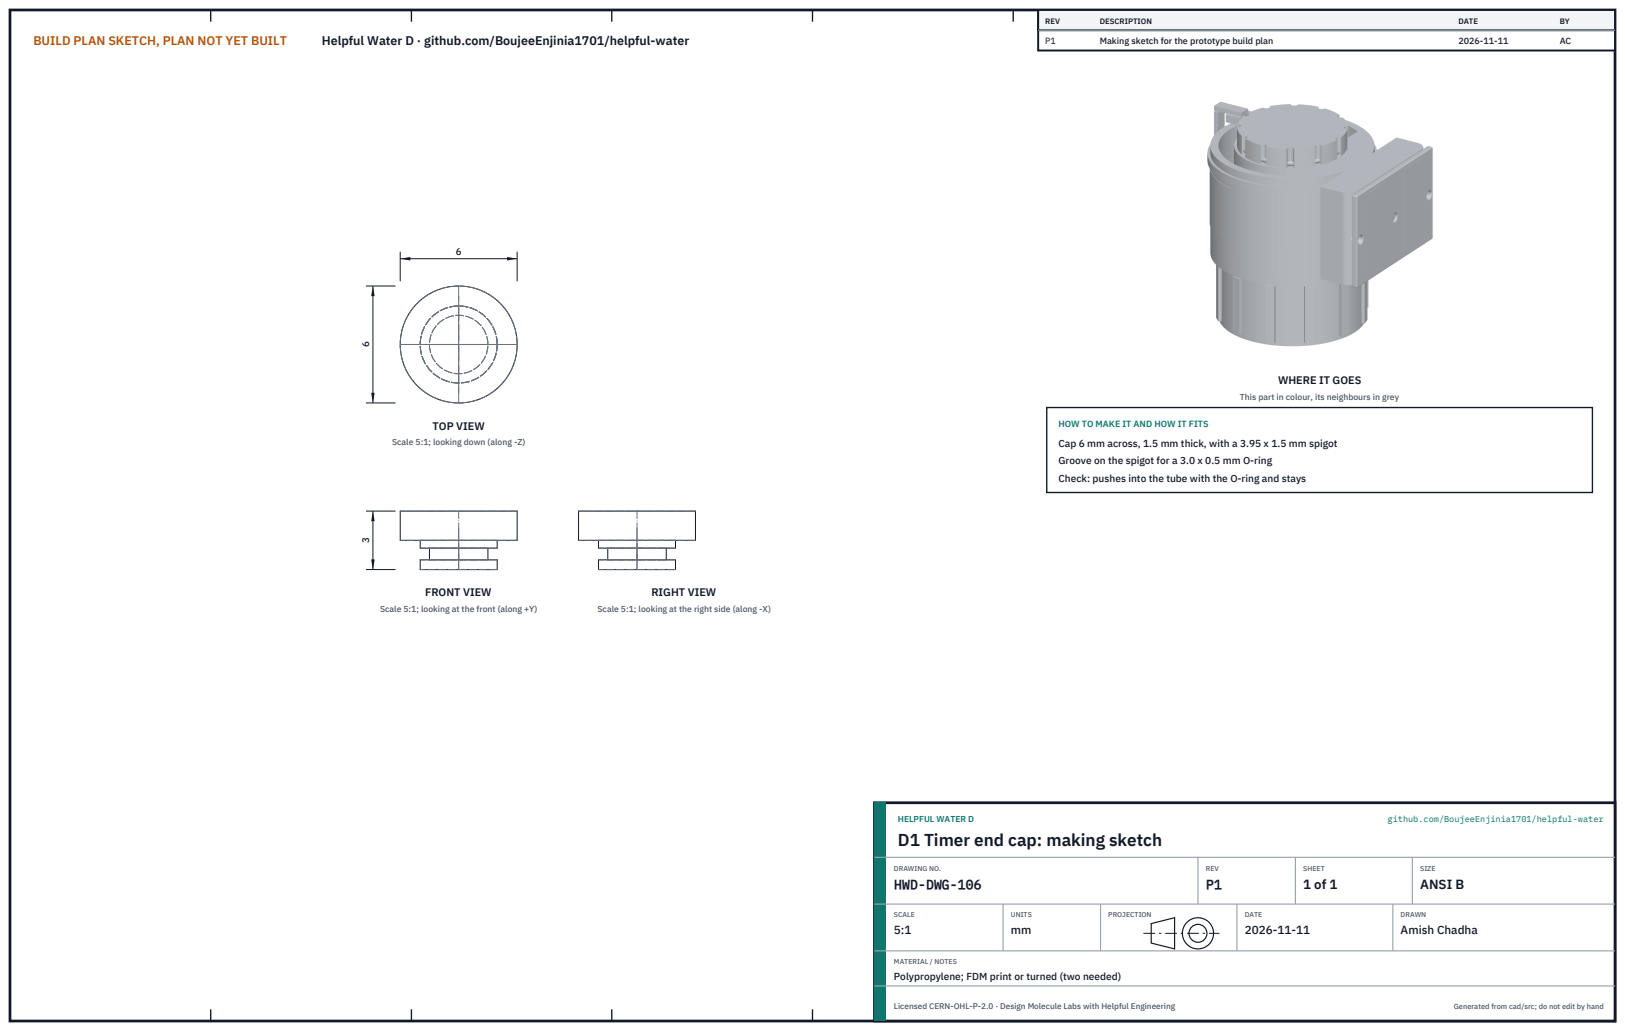
[picture p276: page 1]
FRONT VIEW; TOP VIEW; RIGHT VIEW; REV; DESCRIPTION; DATE; Making sketch for the prototype build plan; HELPFUL WATER D; github.com/BoujeeEnjinia1701/helpful-water; DRAWING NO. HWD-DWG-106; REV P1; SHEET 1 of 1; SIZE ANSI B; SCALE 5:1; UNITS mm; PROJECTION; DRAWN Amish Chadha; Licensed CERN-OHL-P-2.0 · Design Molecule Labs with Helpful Engineering; Generated from cad/src; do not edit by hand

WHERE IT GOES

This part in colour, its neighbours in grey

HOW TO MAKE IT AND HOW IT FITS
Cap 6 mm across, 1.5 mm thick, with a 3.95 x 1.5 mm spigot
Groove on the spigot for a 3.0 x 0.5 mm O-ring
Check: pushes into the tube with the O-ring and stays

Scale 5:1; looking down (along -Z)

Scale 5:1; looking at the front (along +Y)

Scale 5:1; looking at the right side (along -X)

D1 Timer end cap: making sketch

MATERIAL / NOTES
Polypropylene; FDM print or turned (two needed)
