BoujeeEnjinia1701/helpful-water/solutions/D-virus-add-on/cad/drawings/HWD-DWG-107.pdf

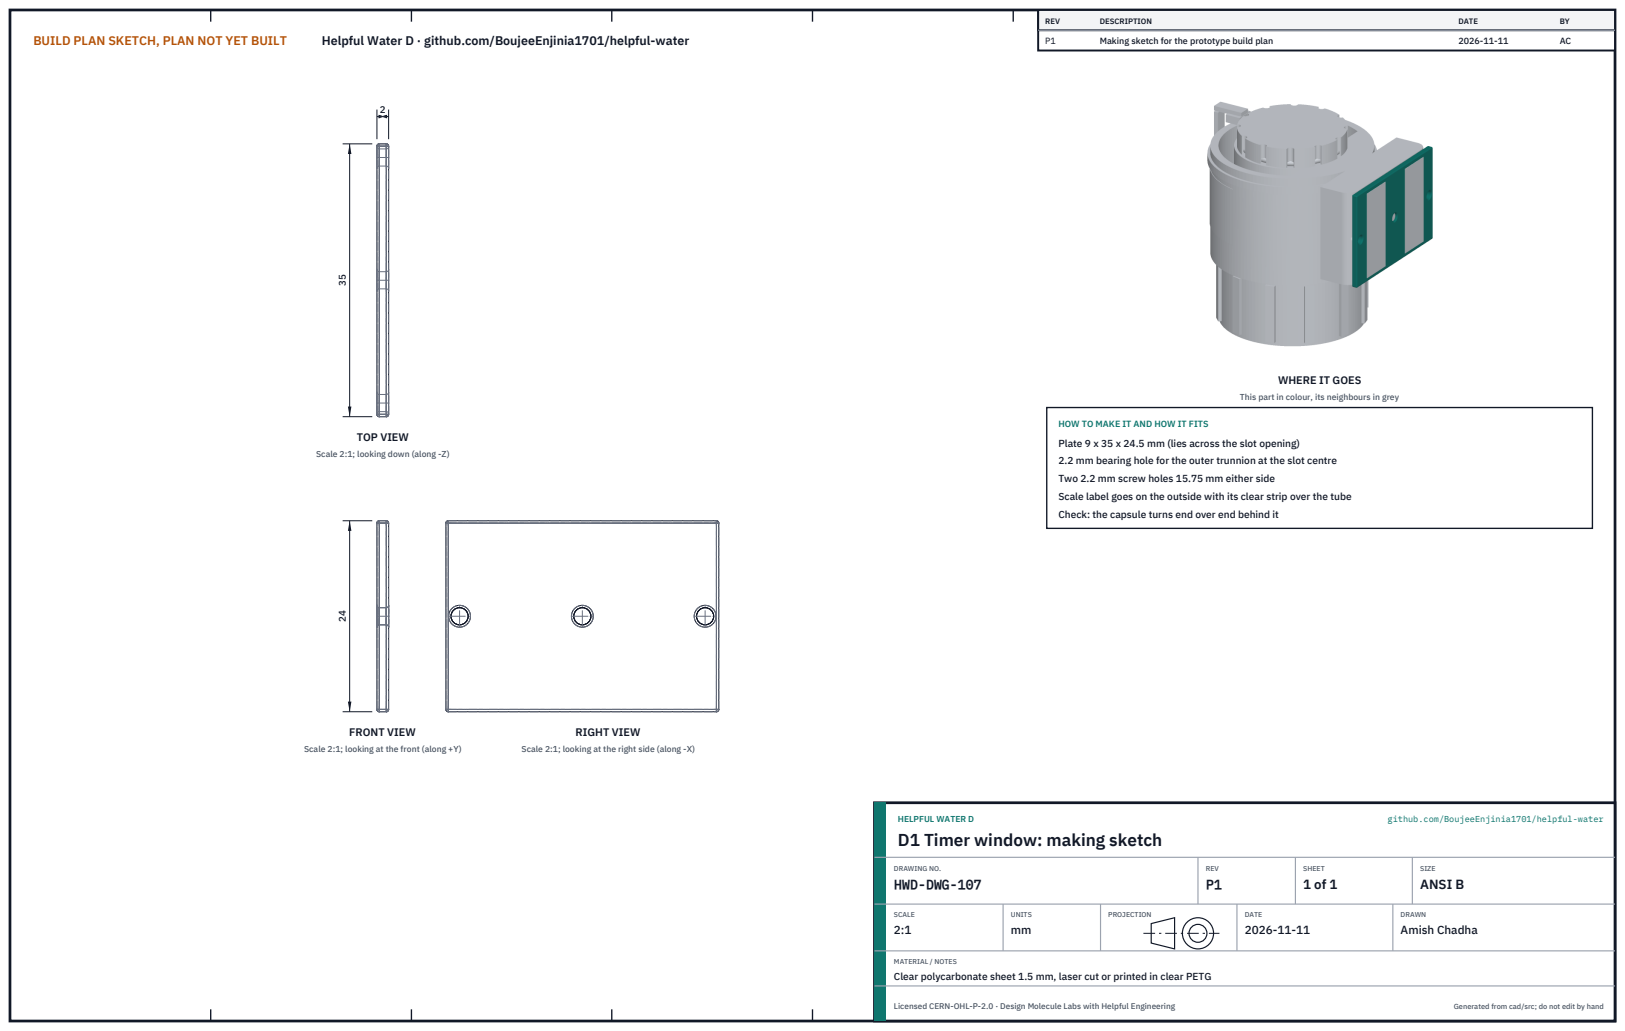
[picture p277: page 1]
BUILD PLAN SKETCH, PLAN NOT YET BUILT; Helpful Water D · github.com/BoujeeEnjinia1701/helpful-water; FRONT VIEW; TOP VIEW; RIGHT VIEW; REV; DESCRIPTION; DATE; Making sketch for the prototype build plan; HELPFUL WATER D; github.com/BoujeeEnjinia1701/helpful-water; DRAWING NO. HWD-DWG-107; REV P1; SHEET 1 of 1; SIZE ANSI B; SCALE 2:1; UNITS mm; PROJECTION; DRAWN Amish Chadha; Licensed CERN-OHL-P-2.0 · Design Molecule Labs with Helpful Engineering; Generated from cad/src; do not edit by hand

WHERE IT GOES

This part in colour, its neighbours in grey

HOW TO MAKE IT AND HOW IT FITS
Plate 9 x 35 x 24.5 mm (lies across the slot opening)
2.2 mm bearing hole for the outer trunnion at the slot centre
Two 2.2 mm screw holes 15.75 mm either side
Scale label goes on the outside with its clear strip over the tube
Check: the capsule turns end over end behind it

Scale 2:1; looking down (along -Z)

Scale 2:1; looking at the front (along +Y)

Scale 2:1; looking at the right side (along -X)

D1 Timer window: making sketch

MATERIAL / NOTES
Clear polycarbonate sheet 1.5 mm, laser cut or printed in clear PETG
