BoujeeEnjinia1701/helpful-water/(commit log)

2026-11-12 Helpful Water: joint program with Helpful Engineering at TRL 3 (kit 1.9.1-he)
    Program documents (PRB, SRC, URS, REG, MKT, PLN, CLM, VER, FTO) and four
    lettered solutions, each a full kit project at P3 with STEM check and
    independent review, concept options, requirements and traceability,
    D3 CAD, BOM, build plan and Blender renders:
    A filter straw, B bottle cartridge, C household gravity filter,
    D chlorine add-on (co-treatment; no virus claim).
    Licences per the Helpful Engineering guide (CERN-OHL-P-2.0, Apache-2.0,
    CC-BY-4.0); no Zenodo, DOI or Software Heritage. Concept decisions are
    proposed, awaiting Amish.
    Claude-Session: https://c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
    [001-dose-cap-body-with-pco-1881-thread-and-timer-bos.step, 001-foot-right-45-x-45-x-560.step, 001-intake-cover.step, 001-neck-collar-with-pco-1881-thread.step, 002-foot-left-45-x-45-x-560.step, 002-intake-cap.step, 002-neck-gasket-flat-epdm.step, 002-neck-liner-flat-silicone.step]
2026-11-12 Helpful Water: settle every pending decision on its recommendation
    Amish, 2026-11-11: "for any pending decisions go with a recommendation."
    All decision registers (HWA, HWB, HWC, HWD DEC-001) now record the
    decisions as his; no decision is open.
    - Concepts A1, B1, C1, D1; options pictures relabelled CHOSEN.
    - A: PR-002 set to 150 mL/min at 10 kPa (upper bound), grade chosen on
    laboratory results; STEM S2, S3, S5 closed.
    - B: B-specific 50 mm width, so PR-014 is met.
    - C carbon-free with D's 28 mm lid port; D test strips in the kit;
    STEM S16, S43 closed. D renamed "chlorine co-treatment add-on".
    - Solution READMEs lead with the photoreal render and show the options
    picture; traceabilit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
    [stem_results.csv]
