BoujeeEnjinia1701/helpful-water/(notices)

Notices in the files:
solutions/D-virus-add-on/README.md:
Hardware: CERN-OHL-P-2.0
Docs: CC-BY-4.0
solutions/B-bottle-cartridge/docs/10-market.md:
Housings, collars, capsules and spouts are open under CERN-OHL-P-2.0 for regional printers and moulders; the module and carbon are bought from qualified suppliers with data sheets and lot traceability.
